JacobSchantz/HelpingHands/Two Finger Gripper/README.md

# Generalist Gripper iterations

## Key reference image for the finger design

**`cad/reference/generalist_gripper_gen6_closed.png`** is THE key reference image for the Generalist gripper finger
design (Jake, 2026-10-19). It is the "Actual (Generalist)" → "Closed" photo in the design viewer (gallery copy:
`cad/mobile_gallery/reference/closed.png`). What it shows:

- Closed, **only the tips touch**; the gap opens up rapidly right behind the tip.
- Approaching the tip on the outside, the profile **rounds inward** into the final tip.
- The tip itself stays **relatively thick** — not a needle point.

Check every finger revision against this photo first.

The current review version is [Generation 8: Pollen's Grabette, exactly as published](versions/v008_pollen_grabette/README.md).
Generation 7 (the Generalist yellow fingers only) is preserved in versions/v007_generalist_fingers.
Generation 6 (dorsal drive, Generalist honeycomb fingers) is preserved in versions/v006_dorsal_drive.
Generation 5 (mirrored geared jaws) is preserved in versions/v005_mirrored_gears.
One shared parametric jaw source updates both sides, with an explicit tooth-phase
exception for the direct gear mesh. Motor fit, retention, backdrive and force
sensing remain unfinished; this is inspection CAD.

Preserved earlier versions include [Generation 4](versions/v004_symmetric_pincher/README.md)
and [Generation 3](versions/v003_single_pincher/README.md). No earlier CAD was overwritten.
