JacobSchantz/HelpingHands/ORCA CC-BY Prototype/README.txt

ORCA CC-BY Prototype — main design base

ORCA Hand by ORCA Dexterity, Inc. — CC BY 4.0.
Original finger STL and STEP files are preserved under upstream/.
Source: https://github.com/orcahand/orcahand_hardware
Pinned commit: 37b71dc03d3f11e48b920cbf54562b33c025bc8c

This folder is CC BY 4.0, not MIT. See upstream/LICENSE.
Commercial derivatives are permitted under the license; retain attribution, license notices, and identify modifications when sharing. Patent and trademark rights are not granted.

Initial import: all base finger STLs and available matching STEP files, original README, assembly addendum and license. No geometry changes. This is a finger-first source subset, not a complete hand manufacturing package.

Use OpenSCAD for local 3D work. inspect_index.scad displays one original index component, not an assembled finger. STEP sources remain available for precise CAD editing.

MIT Hand Prototype contains the separate BiDexHand reference. Aero Derived Prototype remains the separate noncommercial Aero experiment. Do not relabel either source as MIT.

Full assembled visual reference: full_hand/view_stl.scad imports full_hand/orca_v2_assembled_visual.stl. This is the official v2 description model at zero joint pose, not a verified v2.1 manufacturing assembly or a single printable solid. See full_hand/README.txt.
