JacobSchantz/HelpingHands/Three Finger Gripper/README.txt

THREE FINGER GRIPPER — STOPPED CONCEPT

The user replaced this task with a thumb/index two-finger gripper on 2026-10-17.
This folder preserves the first geometry study; do not treat it as an active design.

versions/v001_dorsal_linkage/gripper.scad is an original, self-contained OpenSCAD
study with three independently posed dorsal parallelograms and insertion sleeves.
The three parallel lanes are a neutral mechanism fixture, not an anatomical fit.
Sleeve internal width 24 mm, height 22 mm, and 36 mm outside depth are placeholders.
Each four-bar has its own input rocker, output sleeve and link. The only shared
part is a fixed rear bridge. Cross-pins are above, rather than through, the cavity.
The model shows pin shanks only; pin retention, straps and motion stops are unfinished.

The first render revealed that the proximal finger envelope hit a rear rocker.
Increasing ground length from 32 to 52 mm removed intersections in the displayed
[-6,-26,-42] degree pose. OpenSCAD's part="collision" returned an empty result
for that pose only. No continuous motion sweep, fit, load, or print validation was
completed before the user changed the task. No hardware was operated.

The assembly STL is a geometry preview containing multiple parts, not a print plate.
No fit, strength, comfort, functioning mechanism, or print readiness is claimed.
