JacobSchantz/HelpingHands/references/generalist/README.txt

Visual references downloaded 2026-10-17 from https://generalistai.com/
Original website video poster frames, Generalist AI. Reference imagery only; no CAD or open-source license claimed.
https://generalistai.com/assets/videos/index-hero/generalist_website_screwhand_1.jpg
https://generalistai.com/assets/videos/index-hero/generalist_website_ziptie_1.jpg
https://generalistai.com/assets/videos/index-hero/generalist_website_whiskhand_1.jpg

KEY REFERENCE for the gripper finger design: cad/reference/generalist_gripper_gen6_closed.png
(design viewer: Actual (Generalist) -> Closed). Closed, only the tips touch and the gap opens
rapidly behind the tip; the outside profile rounds inward into the tip; the tip stays relatively thick.
