JacobSchantz/HelpingHands/ORCA CC-BY Prototype/versions/v002_clean_index/README.txt

v002 — Clean intact index finger
Original scale, neutral assembly, uniform color, no subtraction or detached carve fragments. Original mesh geometry unchanged. Includes3 printed parts; excludes pins, bearings, tendons and skin. This is a reference view, not a validated wearable design.
Source: https://github.com/orcahand/orcahand_hardware/tree/37b71dc03d3f11e48b920cbf54562b33c025bc8c
ORCA Hand by ORCA Dexterity, Inc. — CC BY4.0. See LICENSE.
