JacobSchantz/HelpingHands/Two Finger Gripper/versions/v001_motor_force_layout/README.txt

SUPERSEDED BEFORE CAD IMPLEMENTATION

The earlier rotating thumb/index concept was superseded by the user's request
for TWO independent parallel-jaw grippers: two servos, four moving jaw elements.
See v002_two_parallel_modules. No hardware was operated.
