JacobSchantz/HelpingHands/Two Finger Gripper/versions/v004_symmetric_pincher/README.md

# Generalist Gripper · Generation 4

A simpler, centered thumb/index pincher: one opposing pair of mirrored jaws,
one centered servo envelope, one sliding yoke and one crank. Generation 3 is
preserved in `../v003_single_pincher`; no earlier version is replaced.

This is original inspection CAD, not a print-ready or hardware-tested wearable.
No motor or other hardware was operated. The motor, horn, bearings, fasteners,
materials and human fit remain unselected.

## Changes requested for this generation

- Six main displayed bodies instead of Generation 3's twelve: fixed hub, two
  jaws, yoke, crank and ONE servo envelope. Required small hardware is still
  unfinished; six is not a complete assembly bill of materials.
- Identical mirrored jaws and centered fixed hub, yoke and motor volume.
- Continuous curved inner object-contact faces, without a separate black pad,
  sensor block or lightening holes in the contact surface.
- Longitudinal concave channels on the OUTER, human-facing sides, running from
  near the tips toward the pivots. These differ from the inner object-gripping
  faces. They are open channels, not hard finger rings.
- Two radiused zip-tie anchor slots per jaw, through the Y sidewalls near the
  outer spine. The slots do not break the inner gripping face. No purple straps,
  ties, finger cuffs or force sensor are rendered.

The compact opposing-finger silhouette is informed by official Generalist
reference frames already saved in `references/generalist/` in the project root:
`human_jar_01.png`, `human_brush_01.png`, `screwhand_1.jpg` and `ziptie_1.jpg`.
The [official human jar demonstration](https://generalistai.com/assets/pages/blog/gen-1.5/assets/videos/top_down_human_jar.mp4)
shows human operation. The box-folding footage is robot-mounted and is not
human-attachment evidence. The transmission and dimensions here are our own
proposal; the footage does not establish Generalist's hidden mechanism or fit.

## Centered drive and real symmetric motion

The servo output axis is on X=0, Z=-30, pointing along Y. An eccentric crank pin
moves in the yoke's horizontal slot. The hub's open-front L guides constrain the
yoke to vertical translation. Two mirrored angled slots in the yoke engage rear
followers integral with the jaws. The jaws pivot on X=+/-16 and counter-rotate
by equal angles. There are no jaw gears, extra links or second motor.

For jaw opening angle `a` (degrees), 0–22:

```
right follower X = 16 - 10*cos(a) - 10*sin(a)
right follower Z = 10*sin(a) - 10*cos(a)
yoke translation t = 2 + 20*sin(a)
right slot: Z - t = X - 18
left slot:  Z - t = -X - 18
crank angle phi = asin((t - 5.746065934)/6)
```

The crank runs about -38.63 to +38.63 degrees, away from its +/-90 degree
vertical-motion dead centers. Both follower slot and crank slot ends retain
clearance throughout the sampled interval. One crank input sets the yoke and
both jaw angles; they are not independently actuated.
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
