JacobSchantz/HelpingHands/cad/blender/out/so101_gripper.png

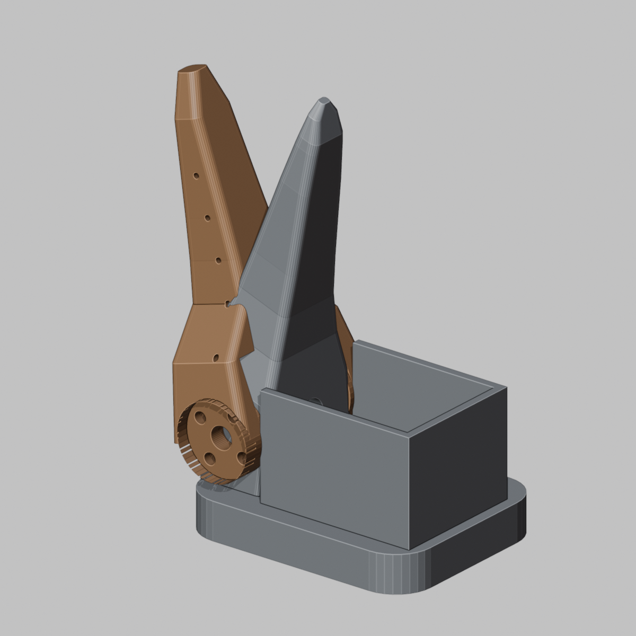
cad/blender/out/so101_gripper.png
