JacobSchantz/HelpingHands/cad/blender/out/so101_gripper_side.png

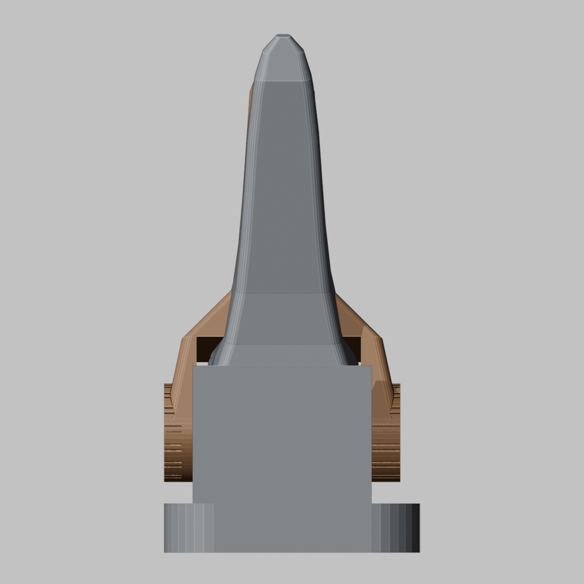
cad/blender/out/so101_gripper_side.png
