JacobSchantz/HelpingHands/cad/glove_hand/refs/jake_left_hand_spread_top.jpg

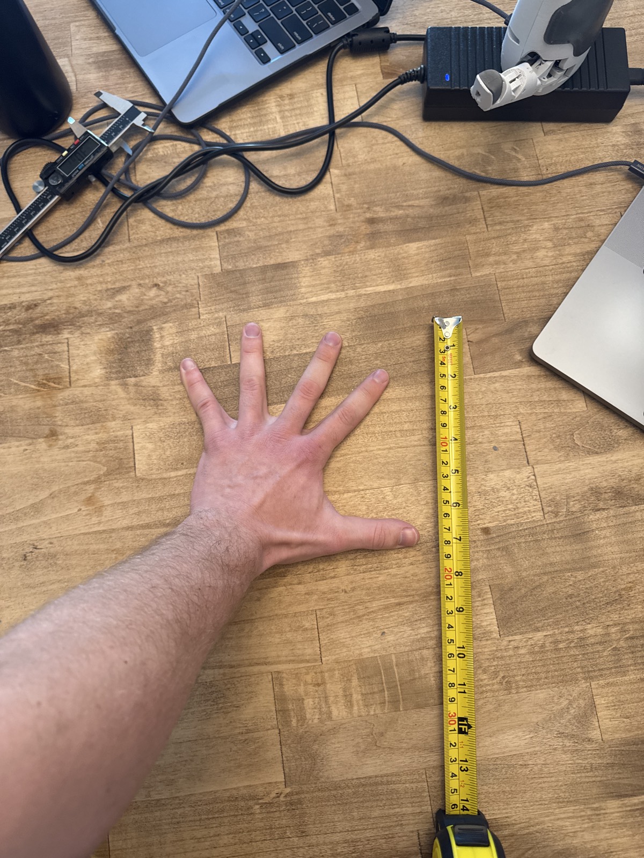
cad/glove_hand/refs/jake_left_hand_spread_top.jpg
