JacobSchantz/HelpingHands/cad/mobile_gallery/micro_grippers/hardware.png

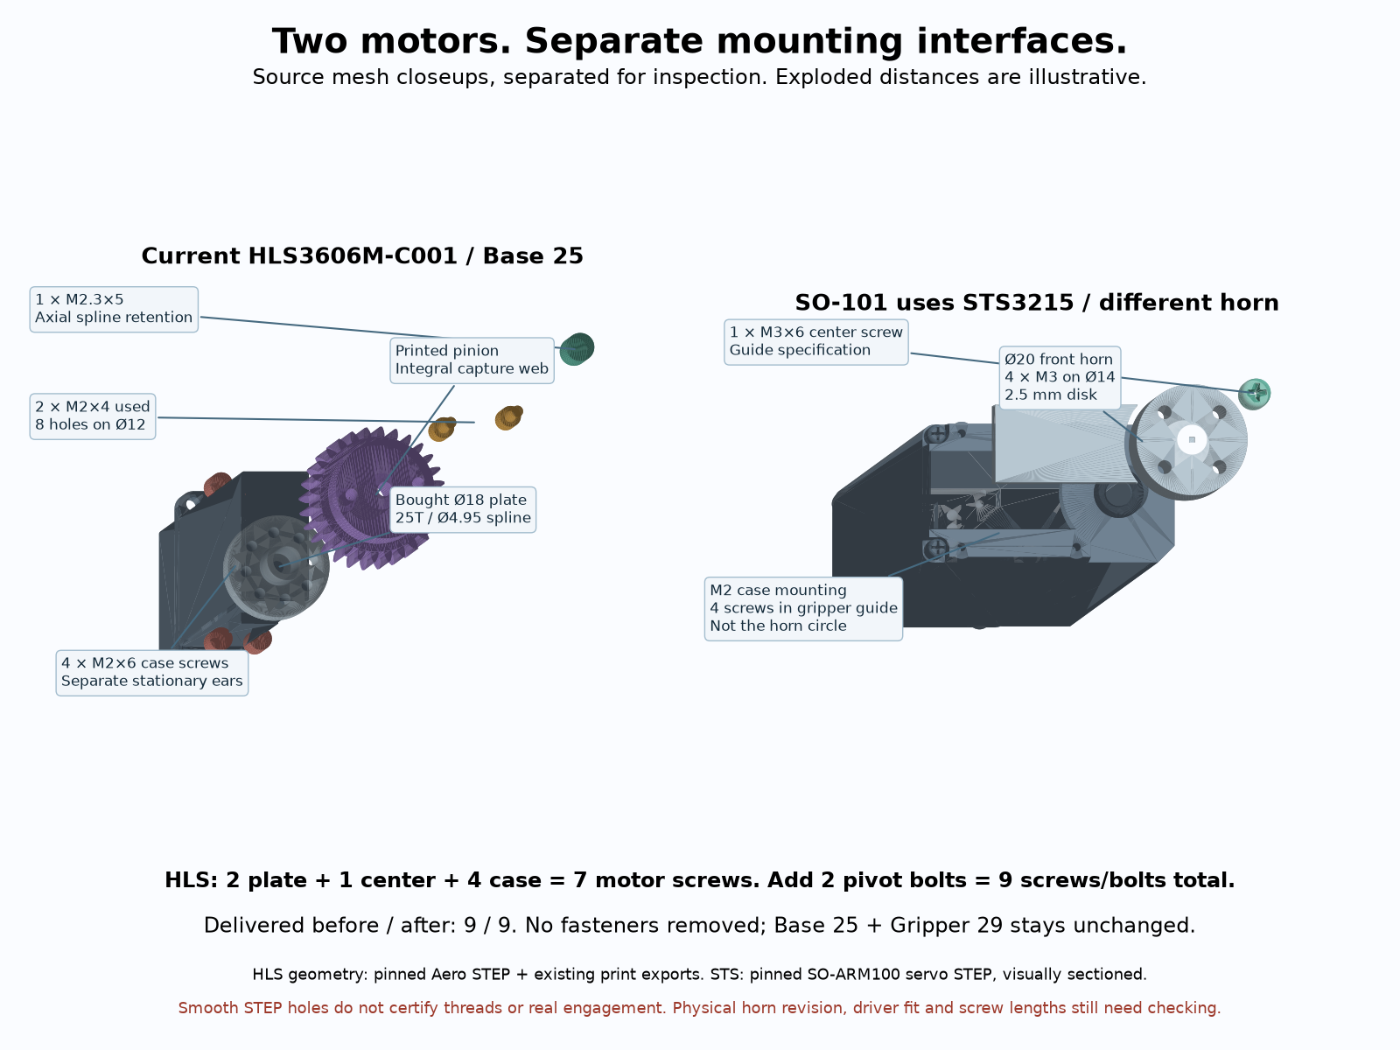
cad/mobile_gallery/micro_grippers/hardware.png
