JacobSchantz/HelpingHands/cad/mobile_gallery/reference/actual_top.png

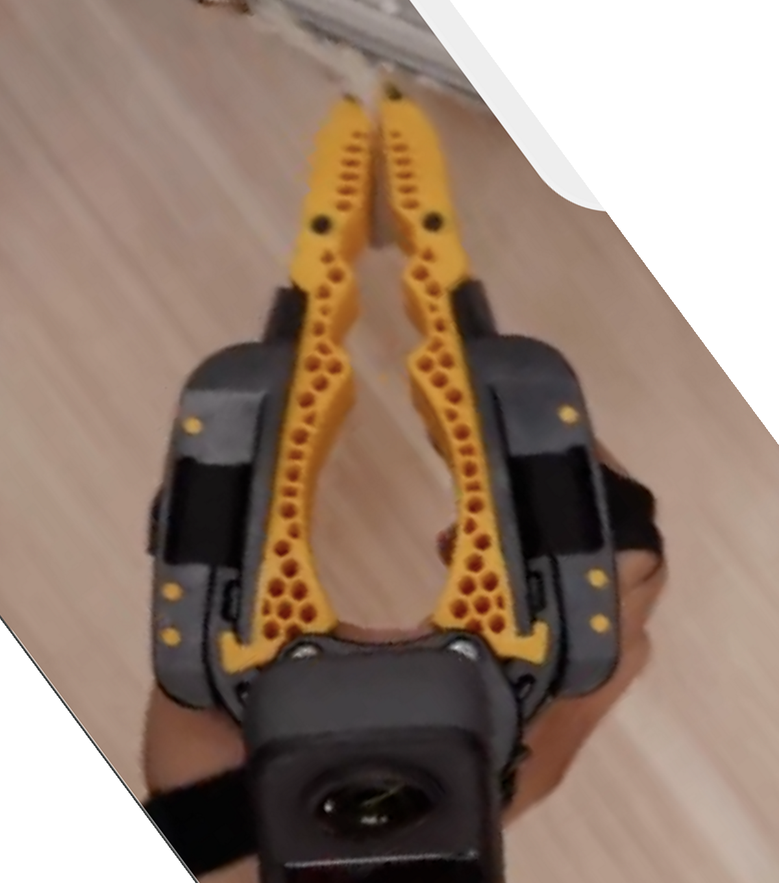
cad/mobile_gallery/reference/actual_top.png
