JacobSchantz/HelpingHands/cad/mobile_gallery/reference/cup.png

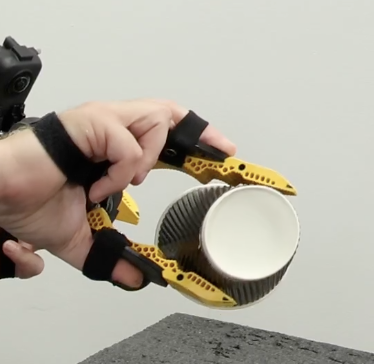
cad/mobile_gallery/reference/cup.png
