JacobSchantz/HelpingHands/cad/mobile_gallery/reference/robot.png

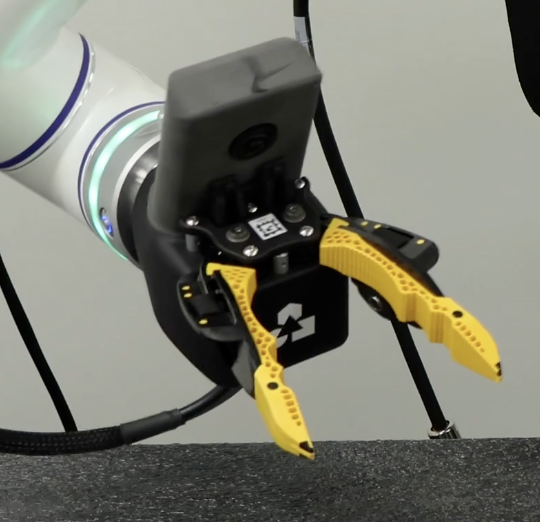
cad/mobile_gallery/reference/robot.png
