JacobSchantz/HelpingHands/cad/mobile_gallery/reference/top.png

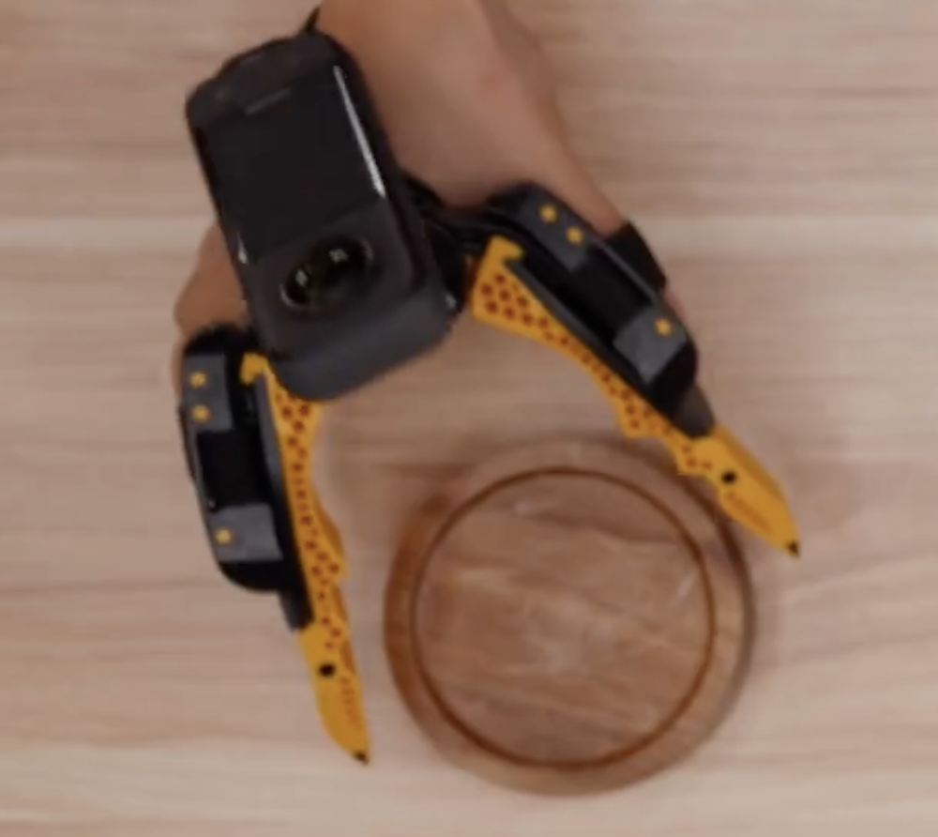
cad/mobile_gallery/reference/top.png
