JacobSchantz/HelpingHands/cad/openscad/crow/render/armed_iso.png

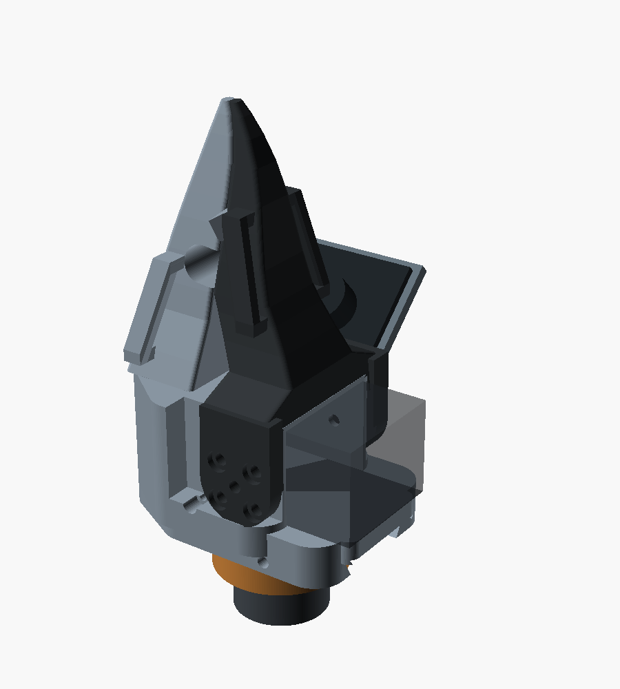
cad/openscad/crow/render/armed_iso.png
