JacobSchantz/HelpingHands/cad/openscad/crow/render/beak_closed_side.png

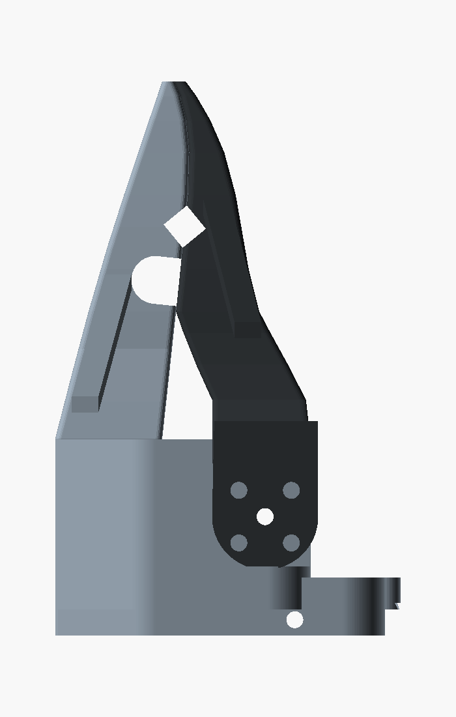
cad/openscad/crow/render/beak_closed_side.png
