JacobSchantz/HelpingHands/cad/openscad/crow/render/beak_iso.png

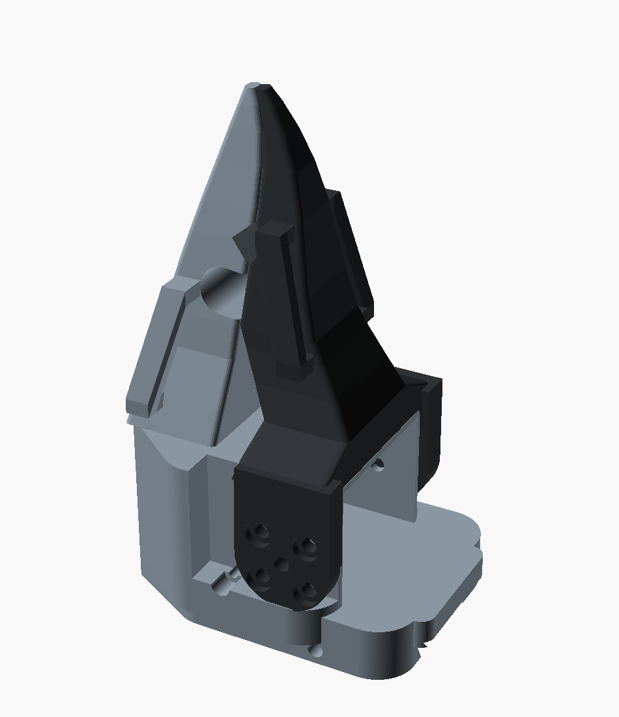
cad/openscad/crow/render/beak_iso.png
