JacobSchantz/HelpingHands/cad/openscad/crow/render/beak_open_side.png

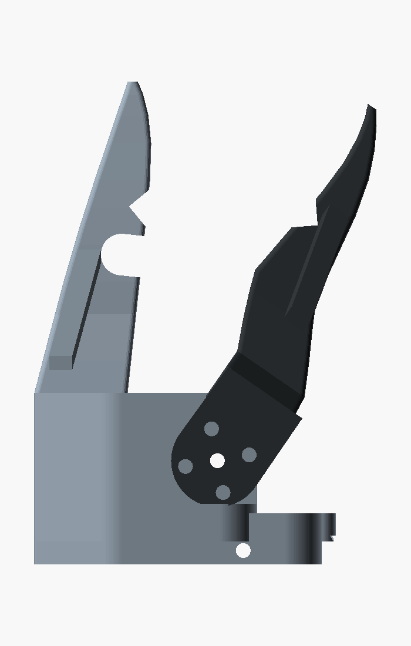
cad/openscad/crow/render/beak_open_side.png
