JacobSchantz/HelpingHands/cad/openscad/crow/render/handheld_iso.png

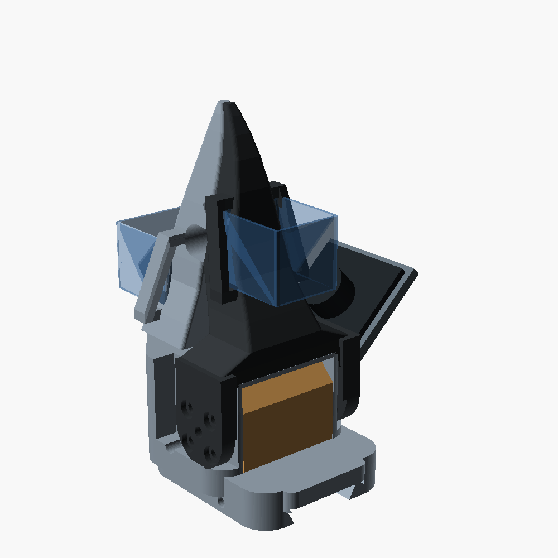
cad/openscad/crow/render/handheld_iso.png
