JacobSchantz/HelpingHands/cad/openscad/crow/render/handheld_side.png

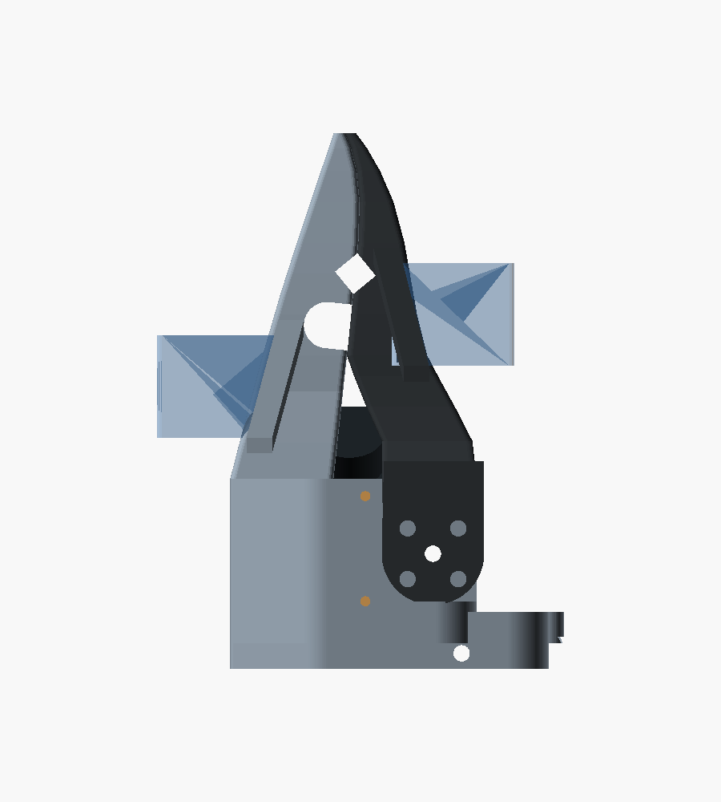
cad/openscad/crow/render/handheld_side.png
