JacobSchantz/HelpingHands/cad/openscad/crow/render/lower.png

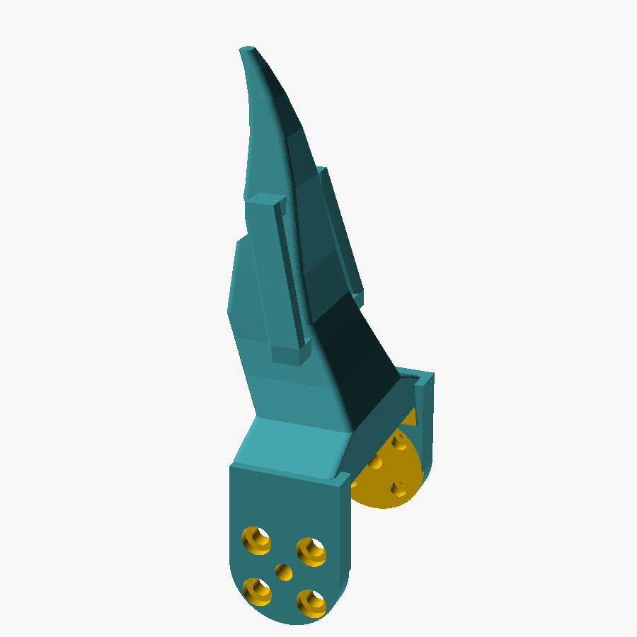
cad/openscad/crow/render/lower.png
