JacobSchantz/HelpingHands/cad/openscad/crow/render/throat_open.png

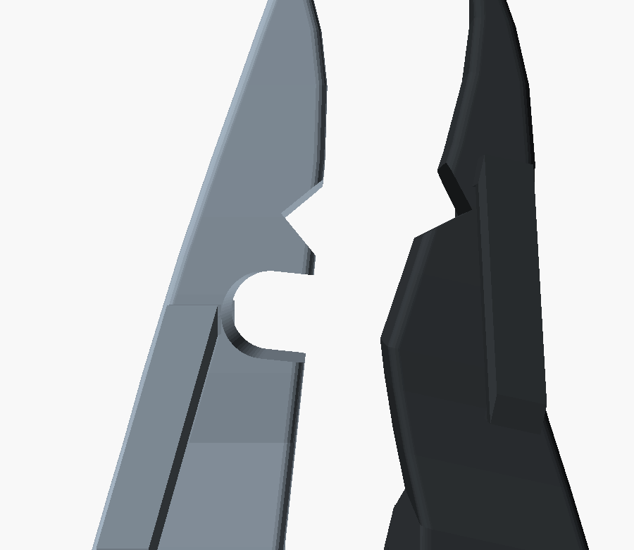
cad/openscad/crow/render/throat_open.png
