JacobSchantz/HelpingHands/cad/openscad/crow/render/thumb_side.png

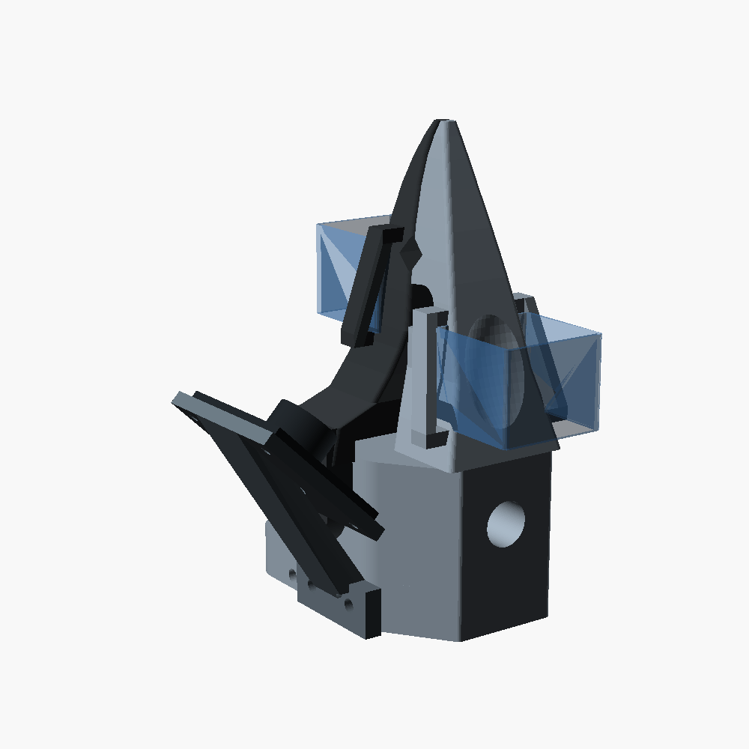
cad/openscad/crow/render/thumb_side.png
