JacobSchantz/HelpingHands/cad/openscad/crow/render/tip_and_notch.png

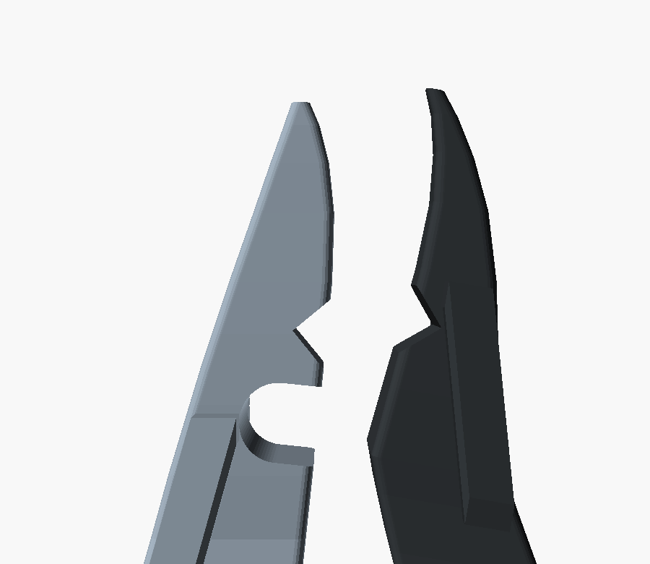
cad/openscad/crow/render/tip_and_notch.png
