JacobSchantz/HelpingHands/cad/openscad/crow/render/tool_in_notch.png

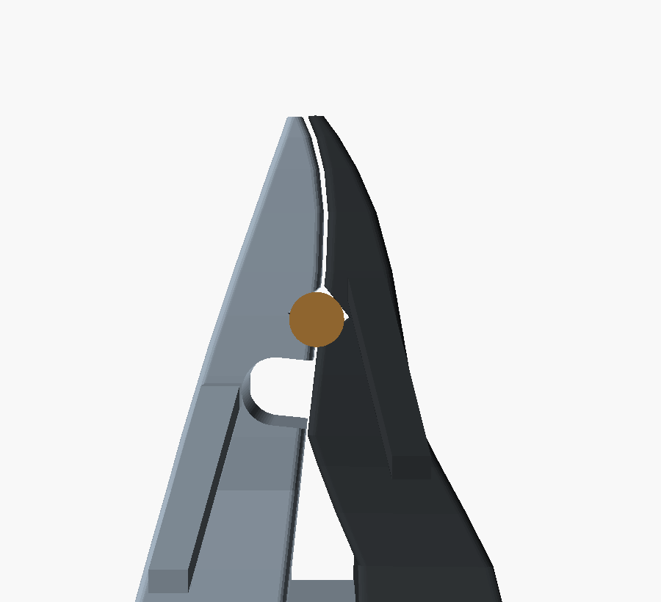
cad/openscad/crow/render/tool_in_notch.png
