JacobSchantz/HelpingHands/cad/openscad/crow/render/upper.png

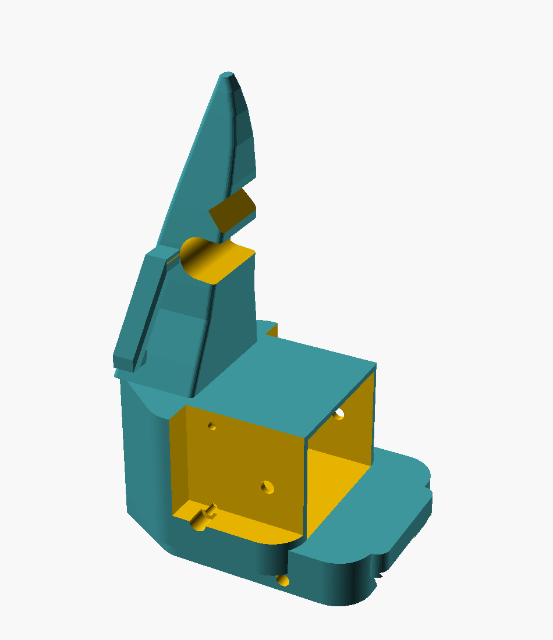
cad/openscad/crow/render/upper.png
