JacobSchantz/HelpingHands/cad/openscad/demo_gripper/render/compare_gen_00.png

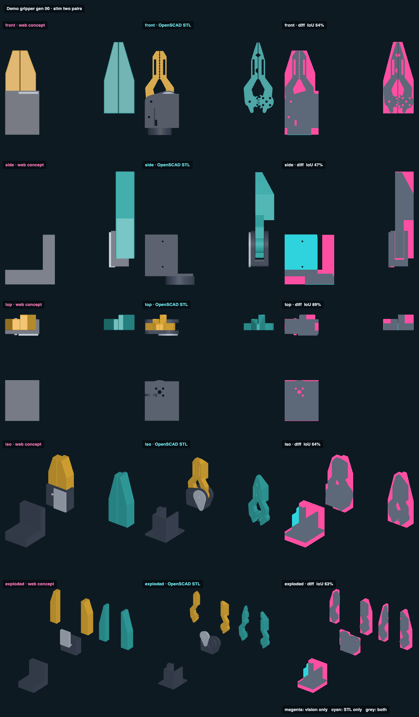
cad/openscad/demo_gripper/render/compare_gen_00.png
