JacobSchantz/HelpingHands/cad/openscad/demo_gripper/render/compare_gen_01.png

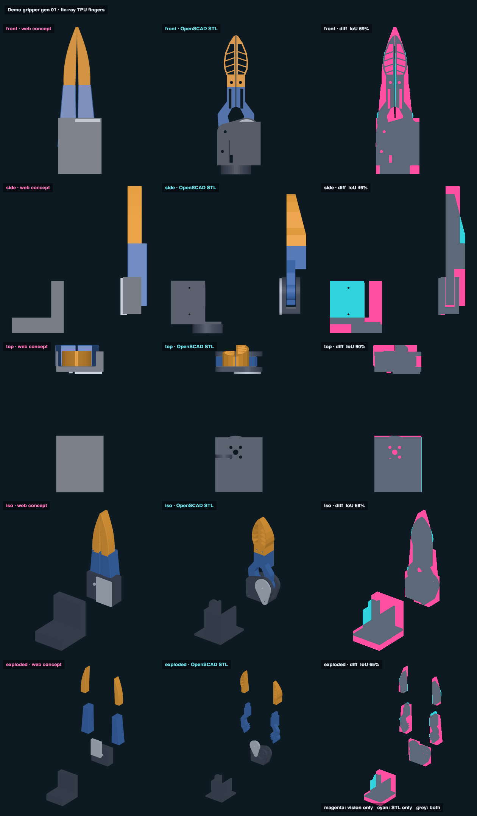
cad/openscad/demo_gripper/render/compare_gen_01.png
