JacobSchantz/HelpingHands/cad/openscad/demo_gripper/render/crow_in_hand.png

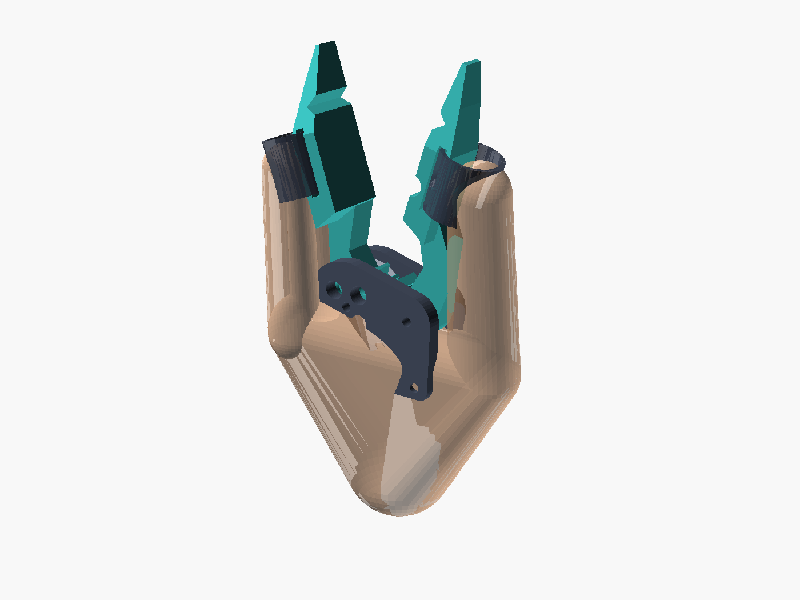
cad/openscad/demo_gripper/render/crow_in_hand.png
