JacobSchantz/HelpingHands/cad/openscad/demo_gripper/render/crow_on_arm.png

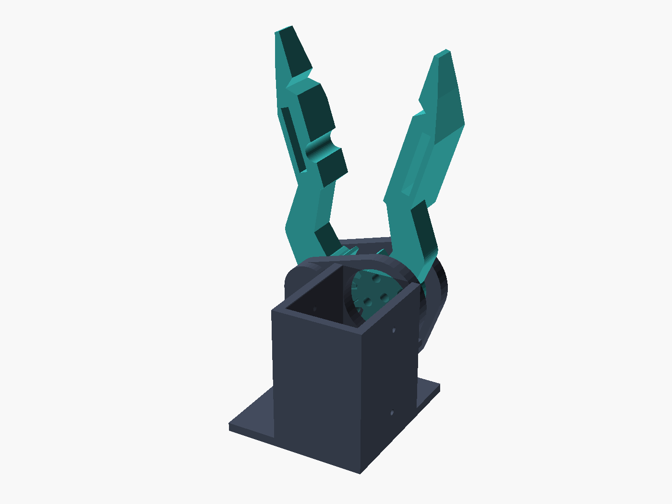
cad/openscad/demo_gripper/render/crow_on_arm.png
