JacobSchantz/HelpingHands/cad/openscad/demo_gripper/render/exploded.png

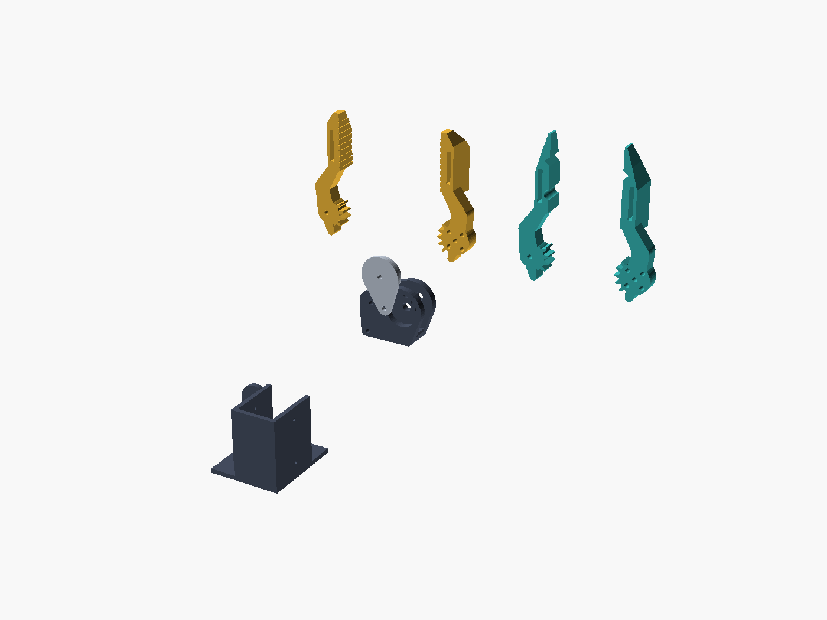
cad/openscad/demo_gripper/render/exploded.png
