JacobSchantz/HelpingHands/cad/openscad/demo_gripper/render/gen_01_exploded.png

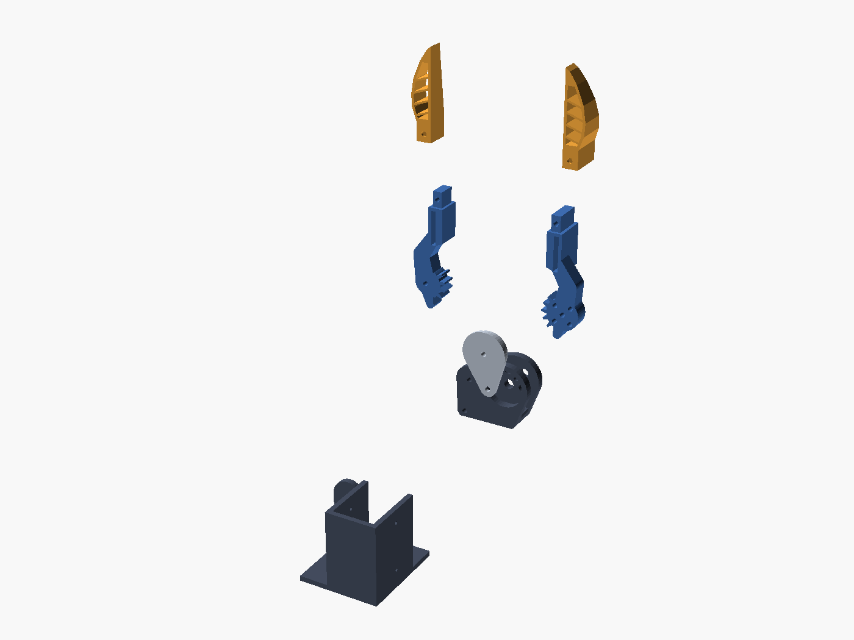
cad/openscad/demo_gripper/render/gen_01_exploded.png
