JacobSchantz/HelpingHands/cad/openscad/demo_gripper/render/gen_01_on_arm.png

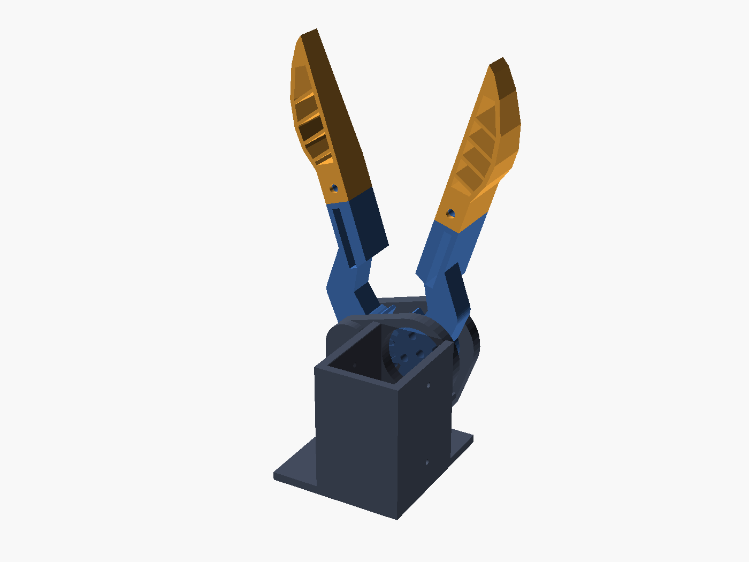
cad/openscad/demo_gripper/render/gen_01_on_arm.png
