JacobSchantz/HelpingHands/cad/openscad/demo_gripper/render/generations.png

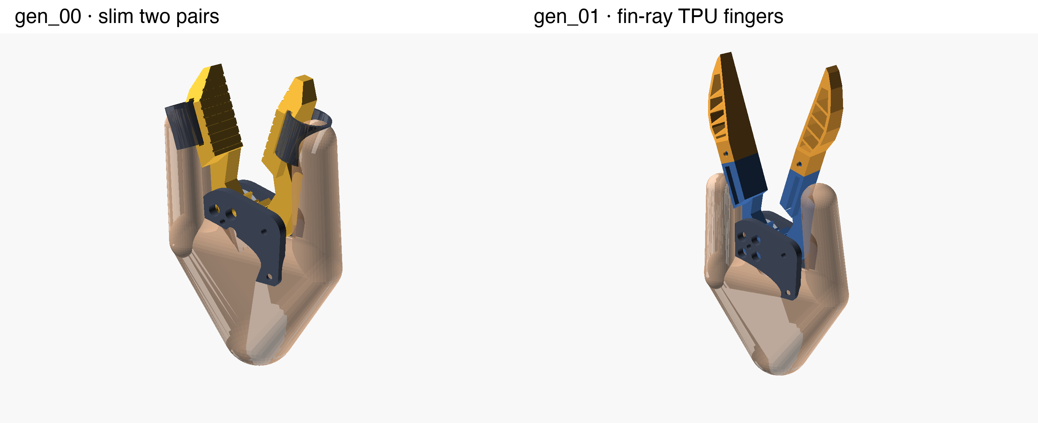
cad/openscad/demo_gripper/render/generations.png
