JacobSchantz/HelpingHands/cad/openscad/glove_hand/fit_check.png

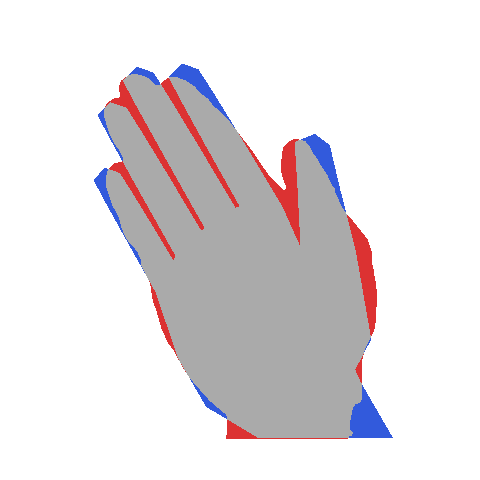
cad/openscad/glove_hand/fit_check.png
