JacobSchantz/HelpingHands/cad/openscad/glove_hand/render/compare_gen_00.png

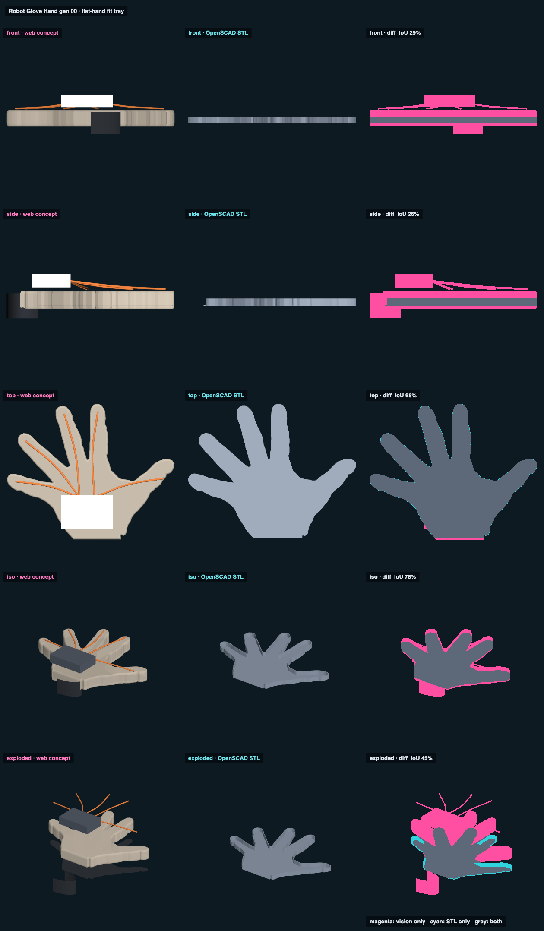
cad/openscad/glove_hand/render/compare_gen_00.png
