JacobSchantz/HelpingHands/cad/openscad/glove_hand/render/compare_gen_01.png

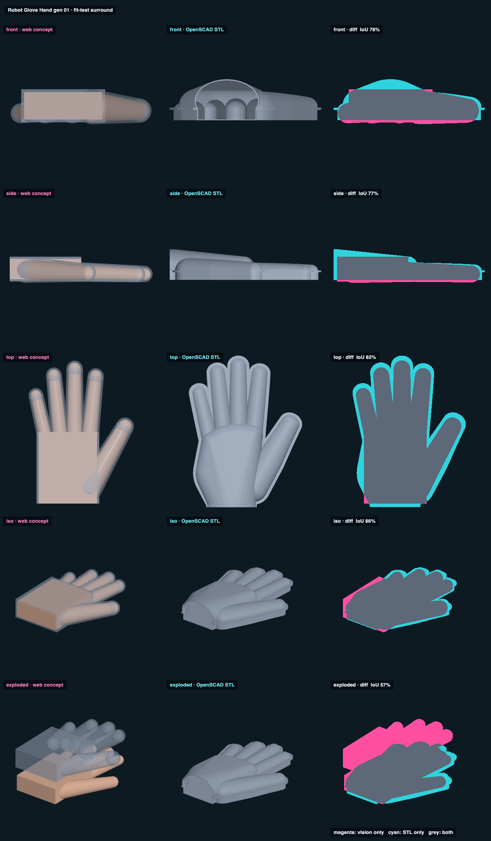
cad/openscad/glove_hand/render/compare_gen_01.png
