JacobSchantz/HelpingHands/cad/openscad/glove_hand/render/compare_gen_02.png

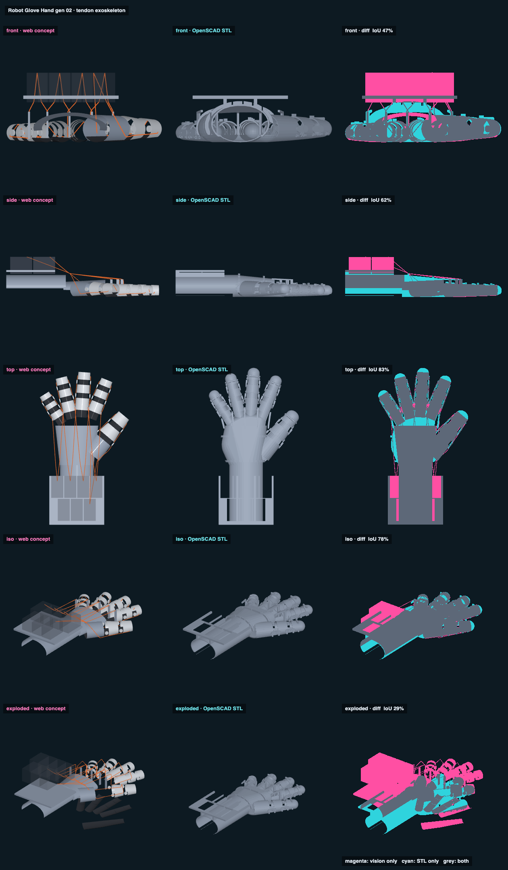
cad/openscad/glove_hand/render/compare_gen_02.png
