JacobSchantz/HelpingHands/cad/openscad/glove_hand/render/compare_gen_03.png

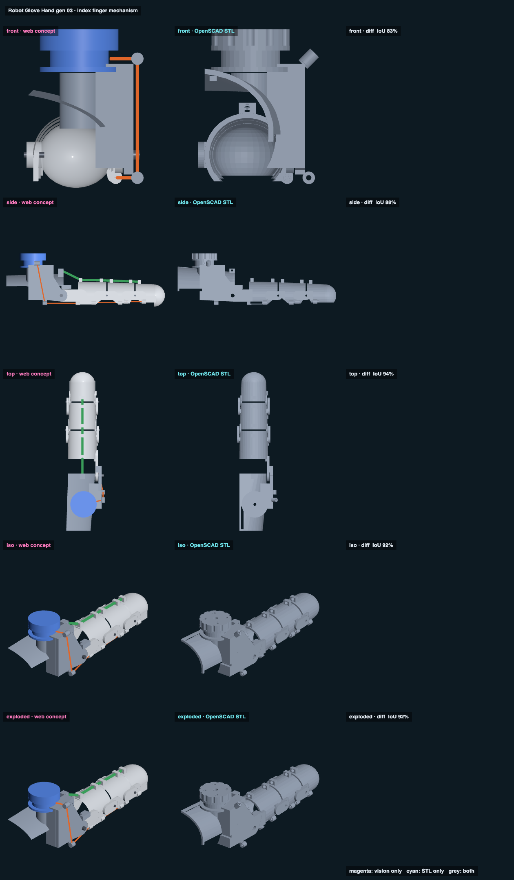
cad/openscad/glove_hand/render/compare_gen_03.png
