JacobSchantz/HelpingHands/cad/openscad/glove_hand/render/compare_gen_04.png

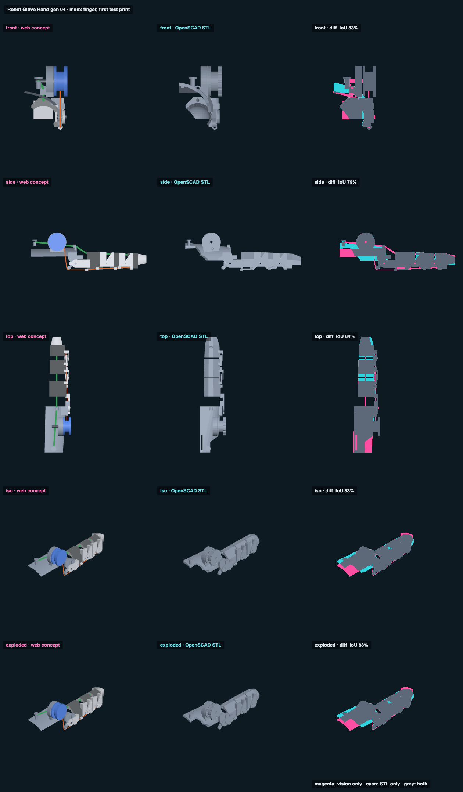
cad/openscad/glove_hand/render/compare_gen_04.png
