JacobSchantz/HelpingHands/cad/openscad/glove_hand/render/gen_00_fit_tray.png

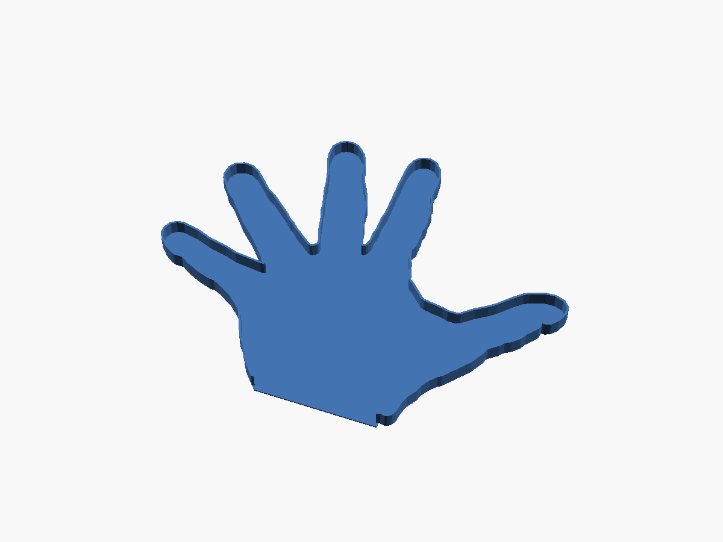
cad/openscad/glove_hand/render/gen_00_fit_tray.png
