JacobSchantz/HelpingHands/cad/openscad/glove_hand/render/gen_01_fit_surround.png

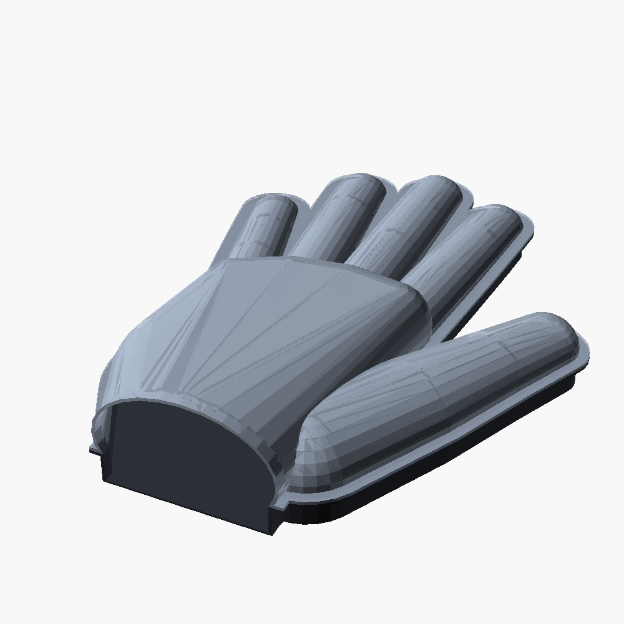
cad/openscad/glove_hand/render/gen_01_fit_surround.png
