JacobSchantz/HelpingHands/cad/openscad/glove_hand/render/gen_02_curl.png

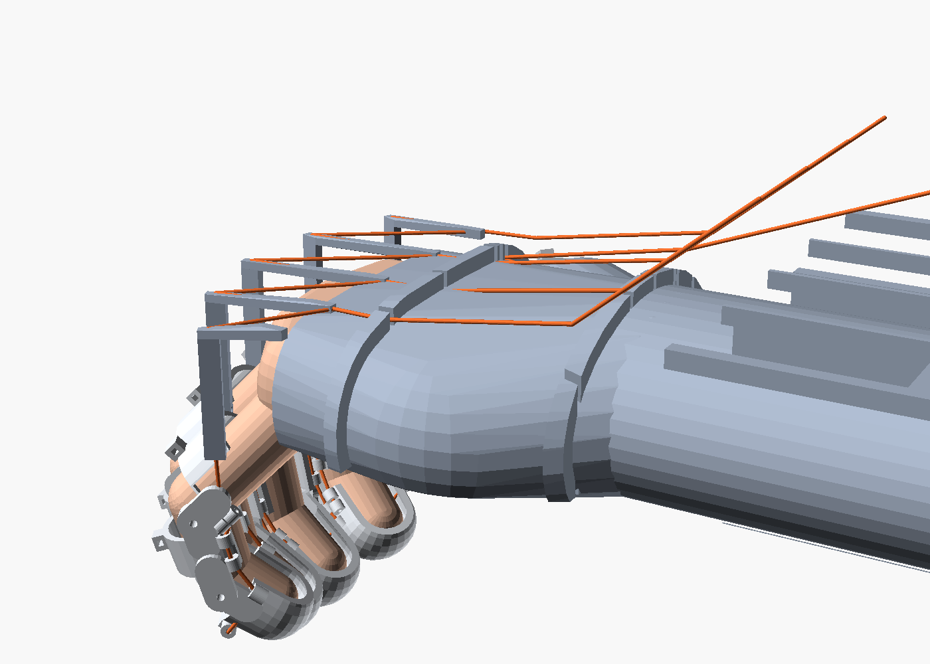
cad/openscad/glove_hand/render/gen_02_curl.png
