JacobSchantz/HelpingHands/cad/openscad/glove_hand/render/gen_02_tendon_exo.png

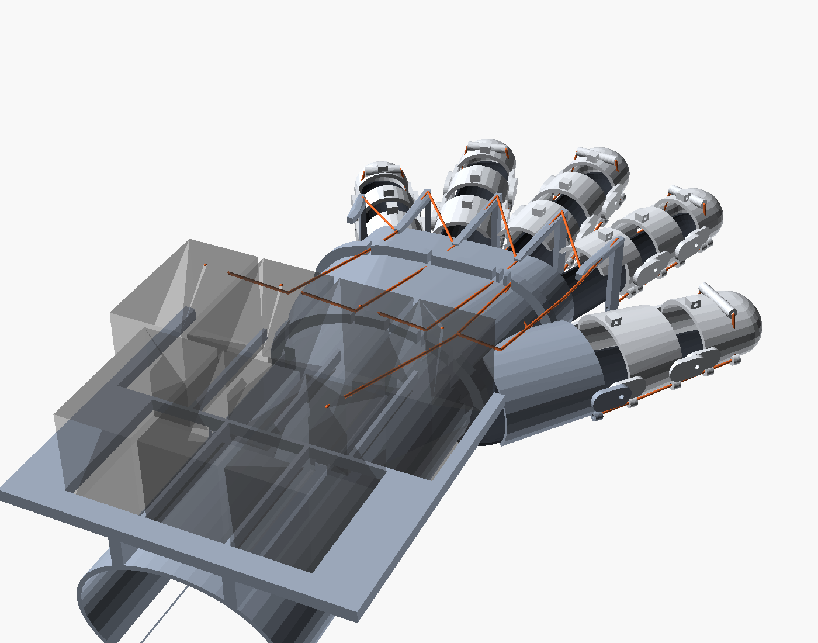
cad/openscad/glove_hand/render/gen_02_tendon_exo.png
