JacobSchantz/HelpingHands/cad/openscad/glove_hand/render/gen_03_index_finger.png

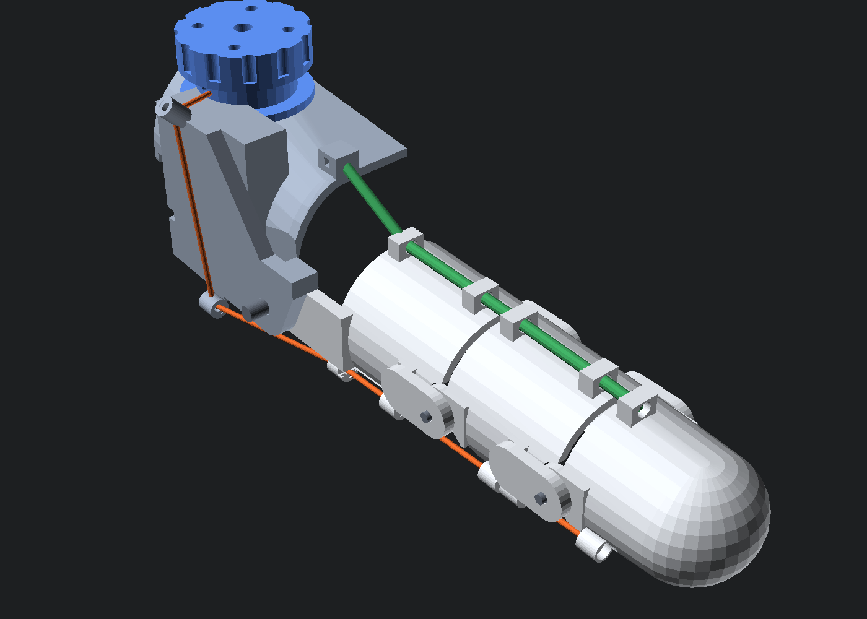
cad/openscad/glove_hand/render/gen_03_index_finger.png
