JacobSchantz/HelpingHands/cad/openscad/glove_hand/render/gen_03_live_robot.png

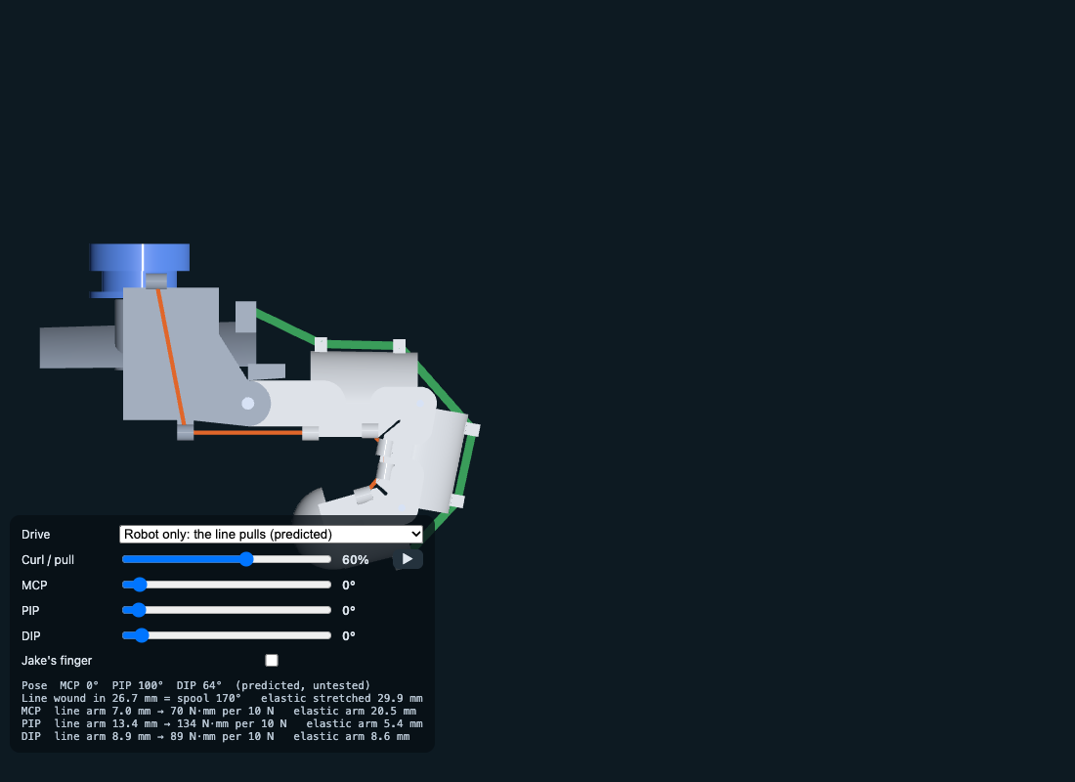
cad/openscad/glove_hand/render/gen_03_live_robot.png
