JacobSchantz/HelpingHands/cad/openscad/glove_hand/render/gen_03_poses.png

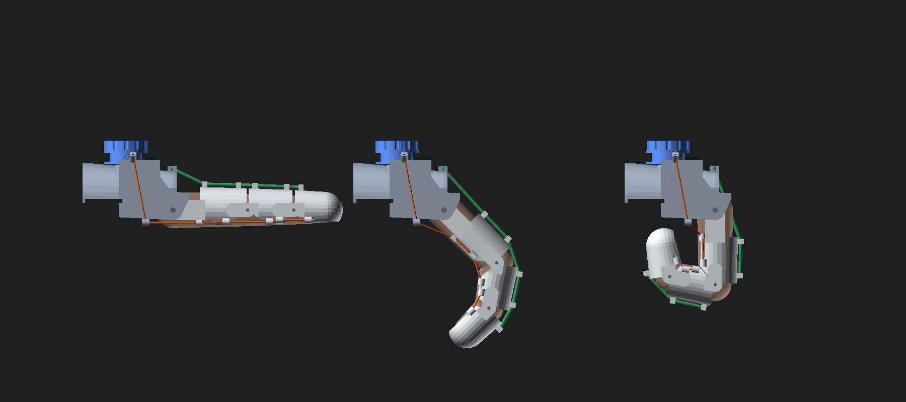
cad/openscad/glove_hand/render/gen_03_poses.png
