JacobSchantz/HelpingHands/cad/openscad/glove_hand/render/gen_04_poses.png

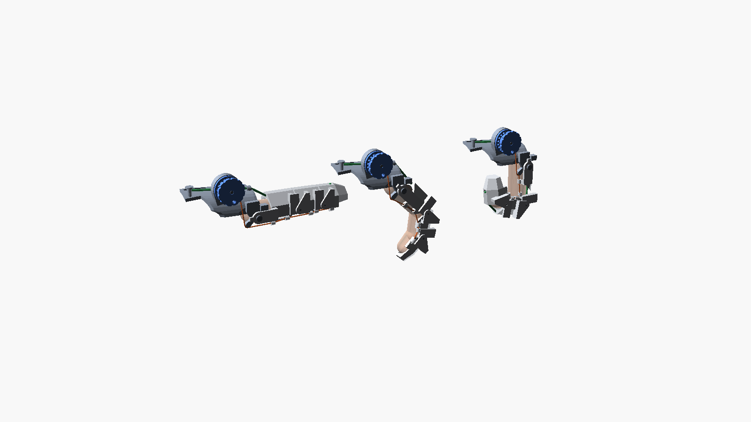
cad/openscad/glove_hand/render/gen_04_poses.png
