JacobSchantz/HelpingHands/cad/openscad/hand_gripper/render/camera_side_closed.png

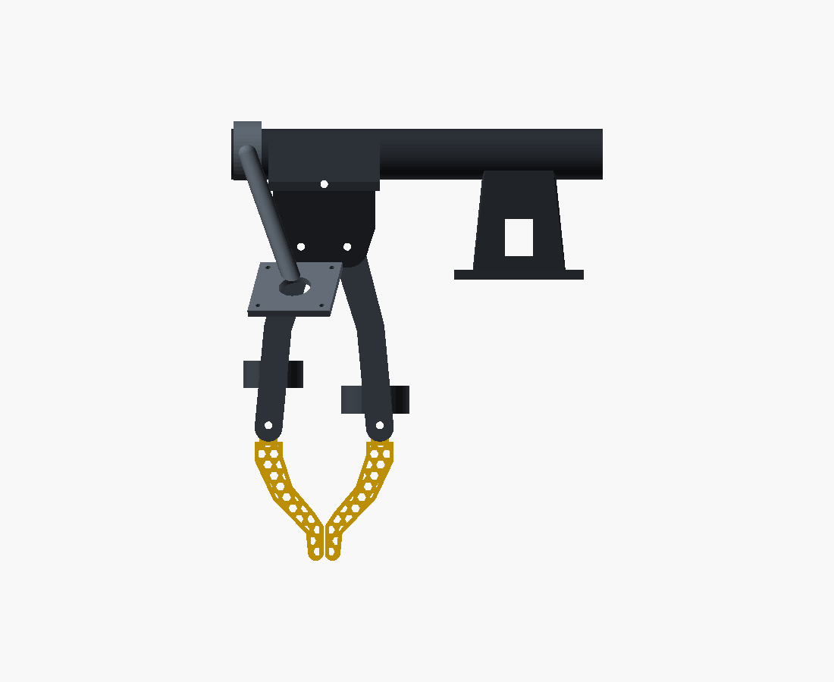
cad/openscad/hand_gripper/render/camera_side_closed.png
