JacobSchantz/HelpingHands/cad/openscad/hand_gripper/render/closed_side.png

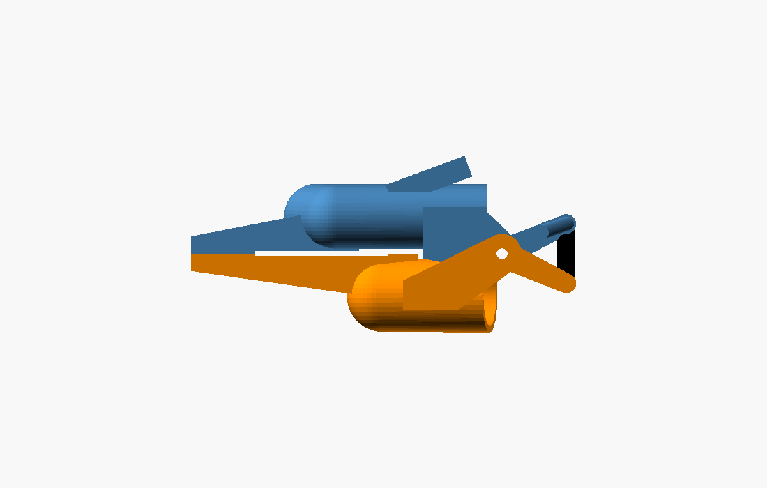
cad/openscad/hand_gripper/render/closed_side.png
