JacobSchantz/HelpingHands/cad/openscad/hand_gripper/render/exploded.png

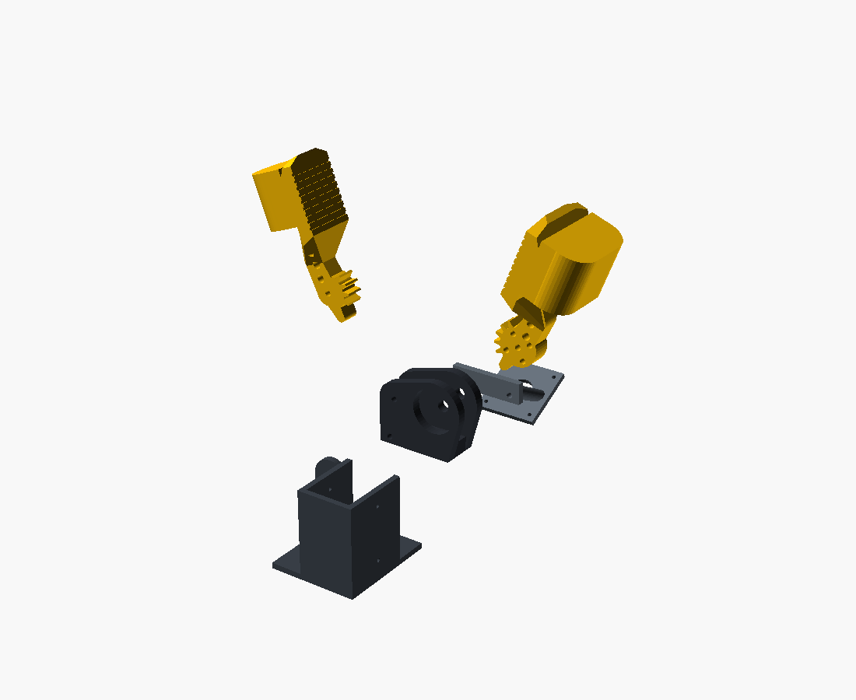
cad/openscad/hand_gripper/render/exploded.png
