JacobSchantz/HelpingHands/cad/openscad/hand_gripper/render/finger_slot_rear.png

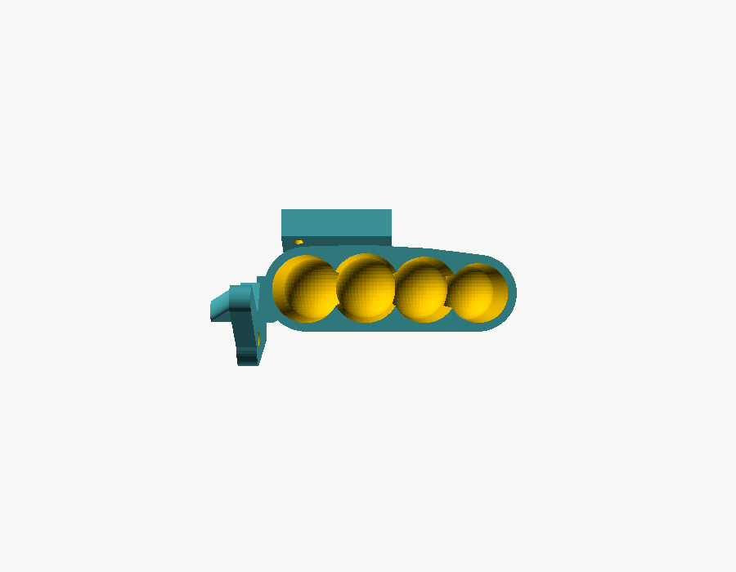
cad/openscad/hand_gripper/render/finger_slot_rear.png
