JacobSchantz/HelpingHands/cad/openscad/hand_gripper/render/from_below.png

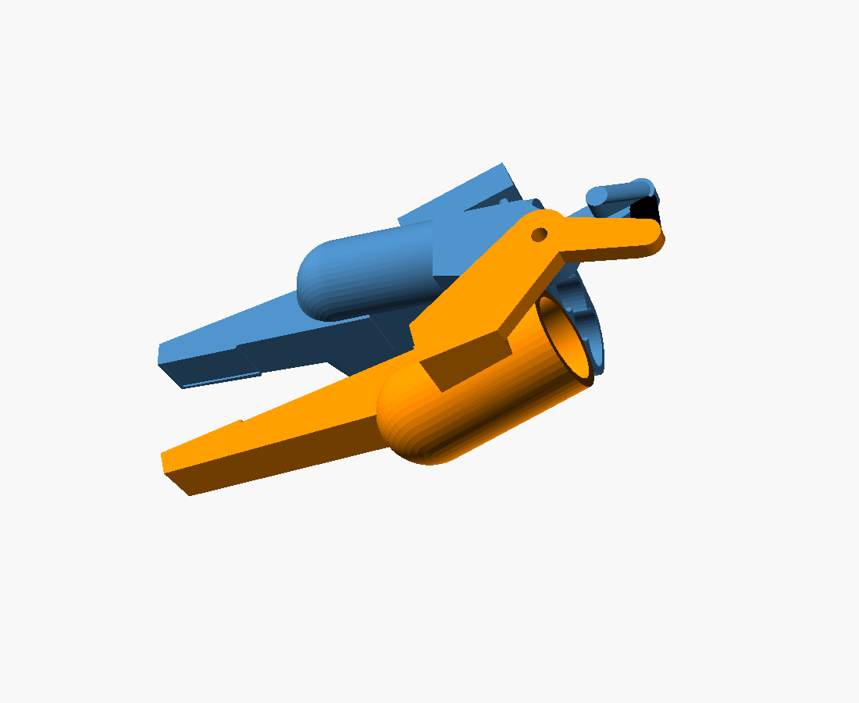
cad/openscad/hand_gripper/render/from_below.png
