JacobSchantz/HelpingHands/cad/openscad/hand_gripper/render/in_hand.png

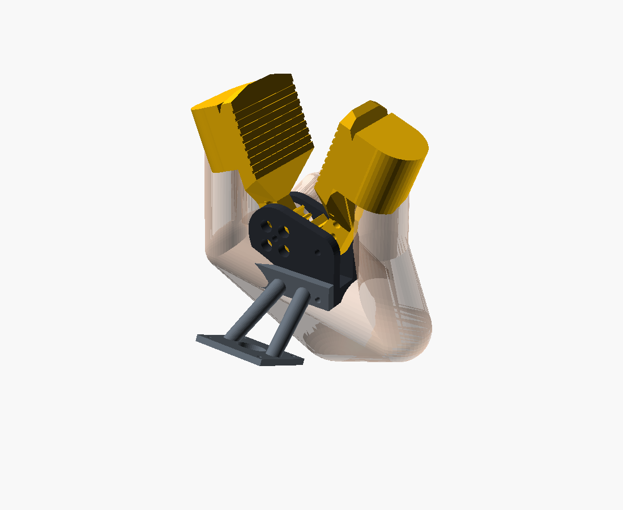
cad/openscad/hand_gripper/render/in_hand.png
