JacobSchantz/HelpingHands/cad/openscad/hand_gripper/render/in_hand_pinky_side.png

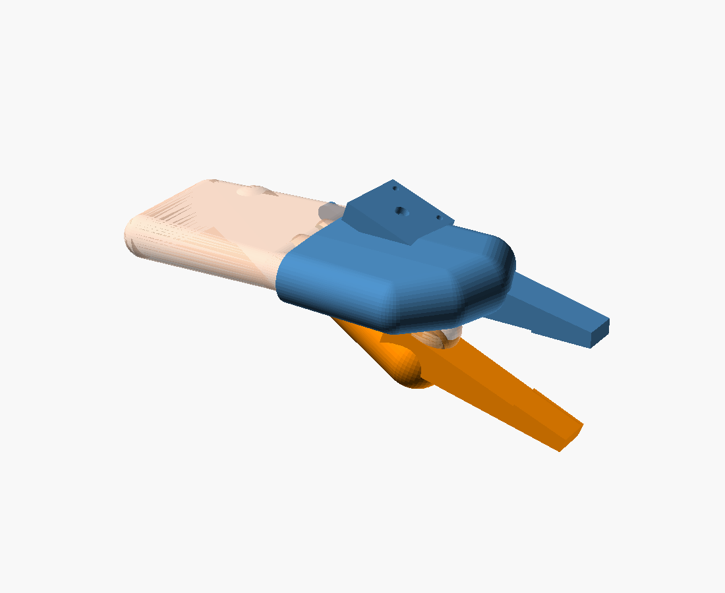
cad/openscad/hand_gripper/render/in_hand_pinky_side.png
