JacobSchantz/HelpingHands/cad/openscad/hand_gripper/render/in_hand_thumb_side.png

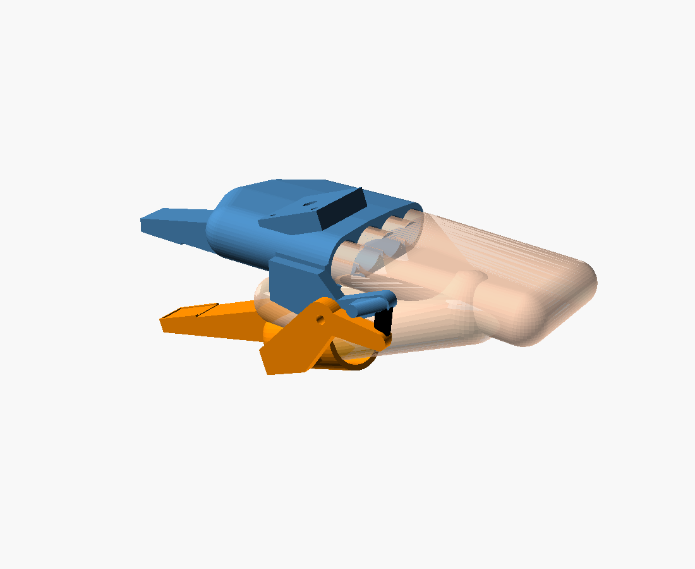
cad/openscad/hand_gripper/render/in_hand_thumb_side.png
