JacobSchantz/HelpingHands/cad/openscad/hand_gripper/render/on_arm.png

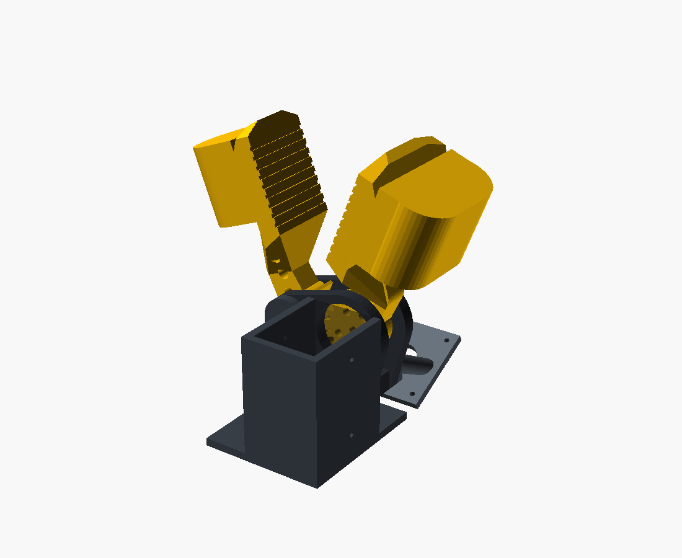
cad/openscad/hand_gripper/render/on_arm.png
