JacobSchantz/HelpingHands/cad/openscad/hand_gripper/render/pinch_closed.png

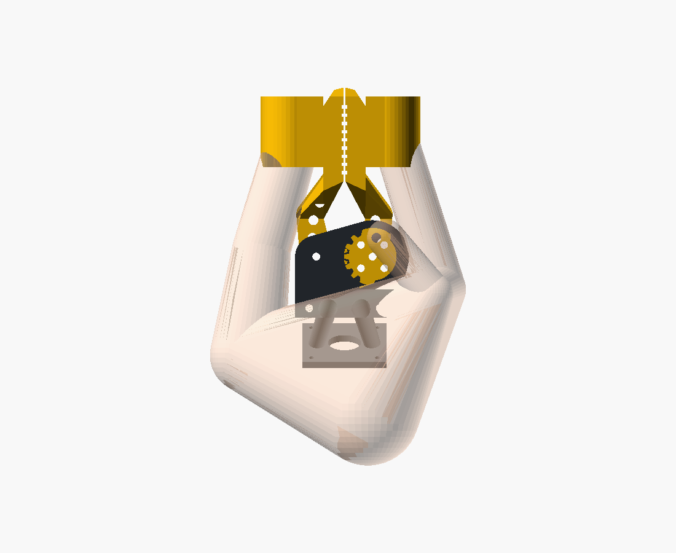
cad/openscad/hand_gripper/render/pinch_closed.png
