JacobSchantz/HelpingHands/cad/openscad/render/fidelity_check.png

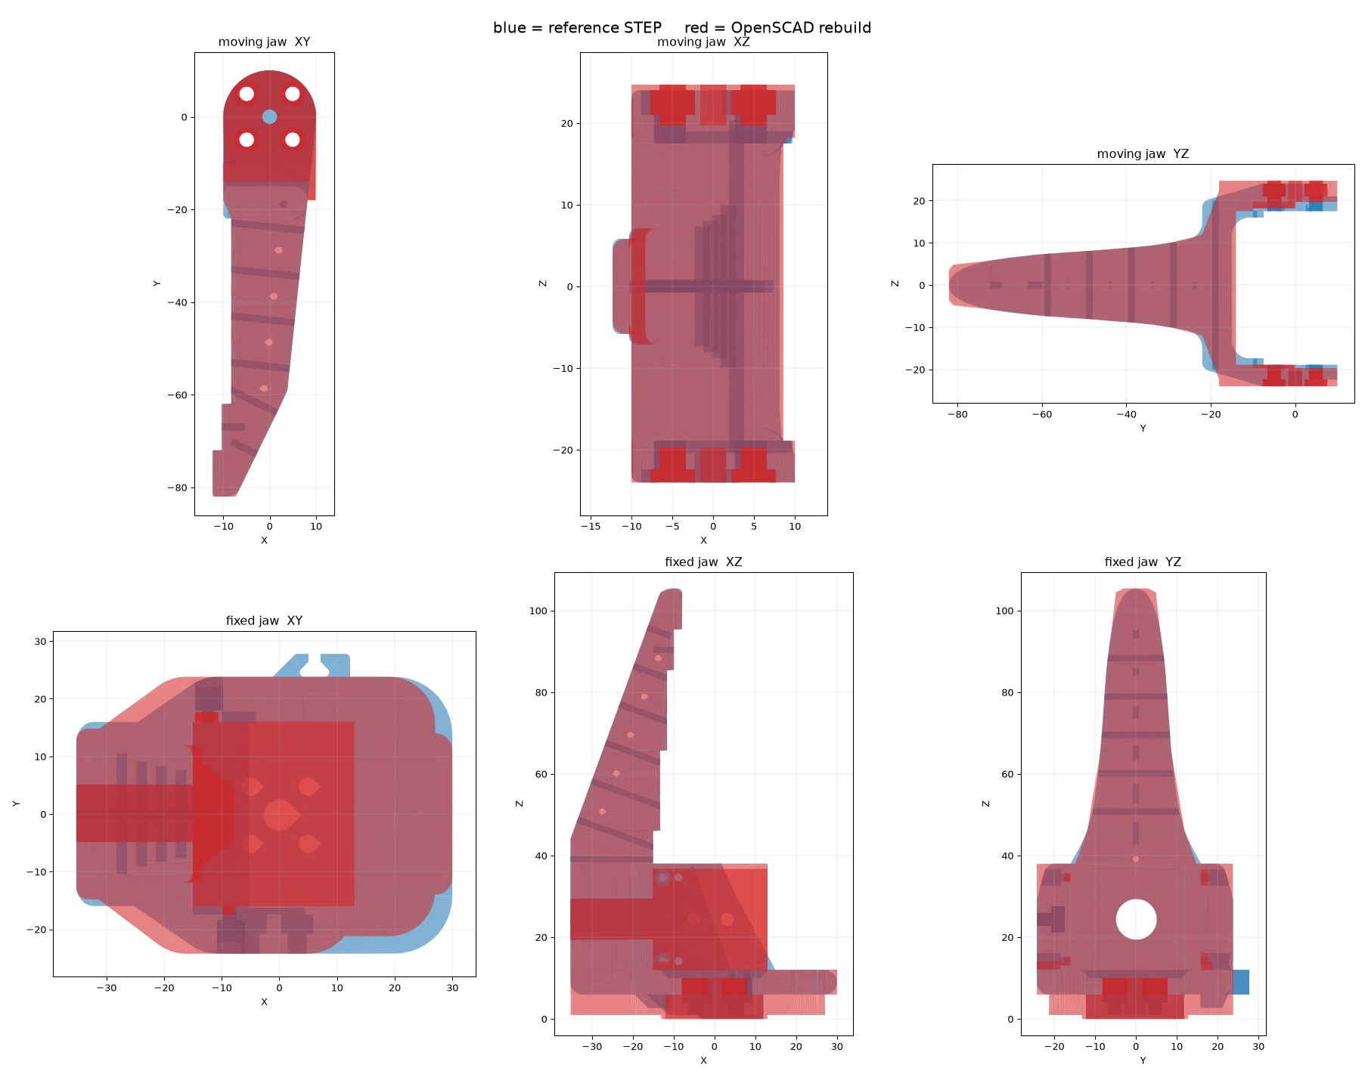
cad/openscad/render/fidelity_check.png
