JacobSchantz/HelpingHands/cad/openscad/render/fixed_jaw.png

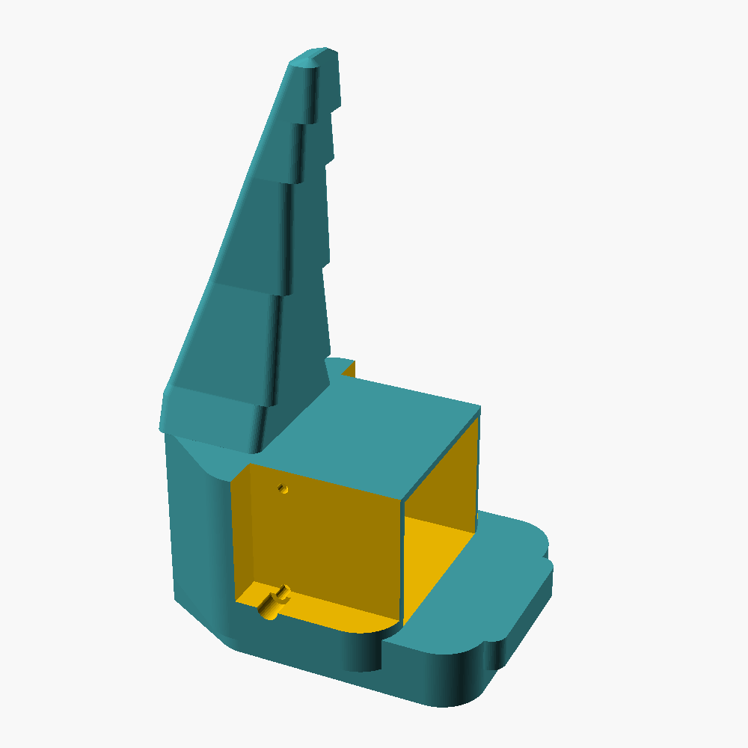
cad/openscad/render/fixed_jaw.png
