JacobSchantz/HelpingHands/cad/openscad/render/gripper_closed.png

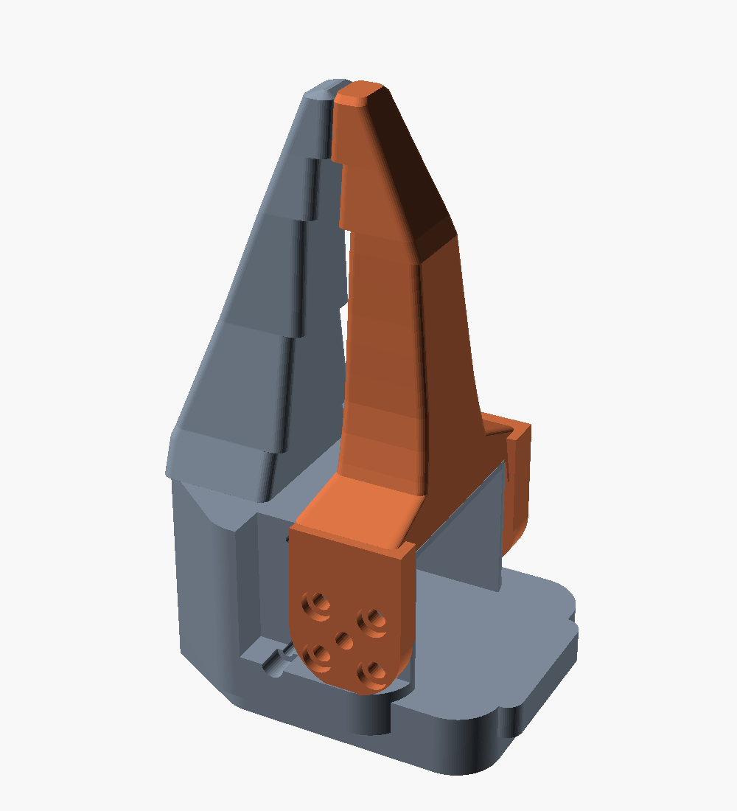
cad/openscad/render/gripper_closed.png
