JacobSchantz/HelpingHands/cad/openscad/render/gripper_open.png

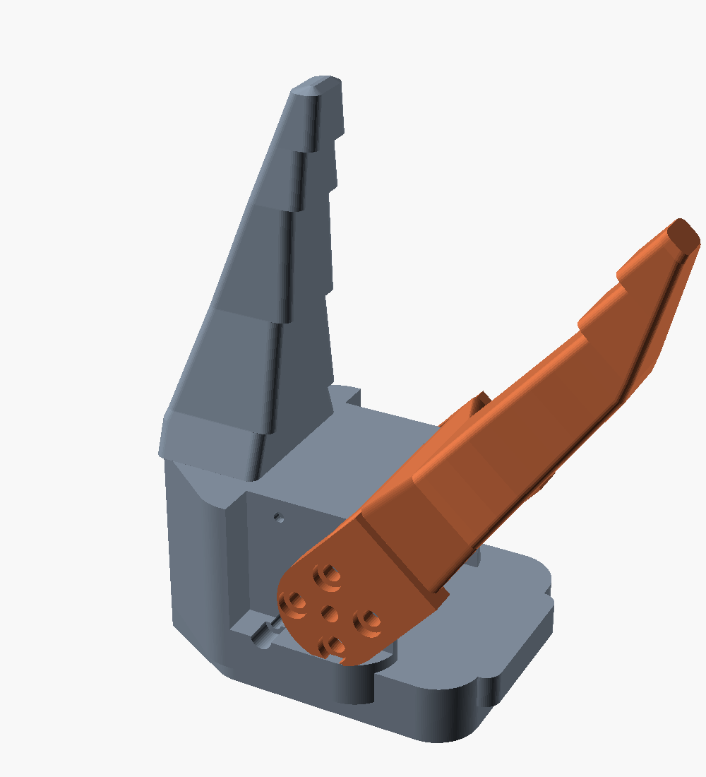
cad/openscad/render/gripper_open.png
