JacobSchantz/HelpingHands/cad/openscad/render/gripper_side.png

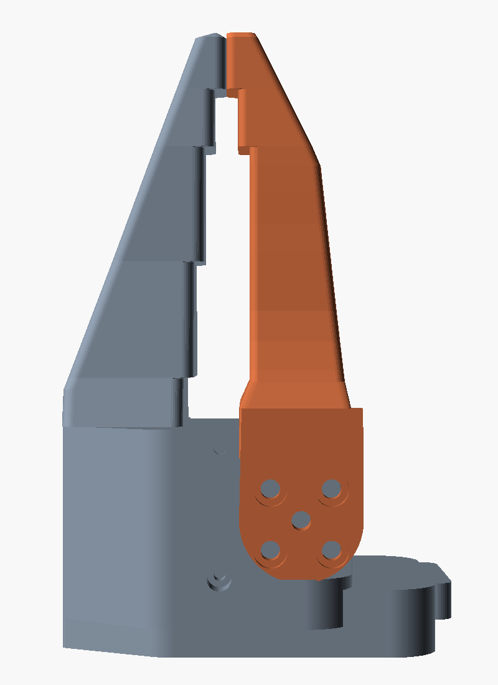
cad/openscad/render/gripper_side.png
