JacobSchantz/HelpingHands/cad/openscad/render/moving_jaw.png

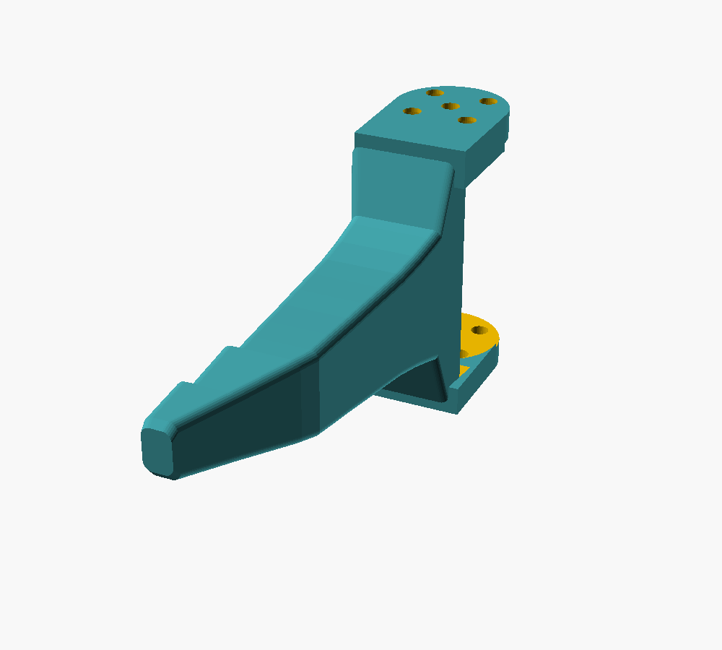
cad/openscad/render/moving_jaw.png
