JacobSchantz/HelpingHands/cad/reference/generalist_gripper_gen6_side.png

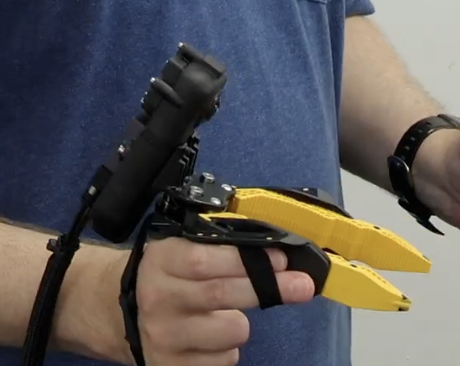
cad/reference/generalist_gripper_gen6_side.png
