JacobSchantz/HelpingHands/ORCA CC-BY Prototype/versions/v003_piece_shell_study/render/original_sections.png

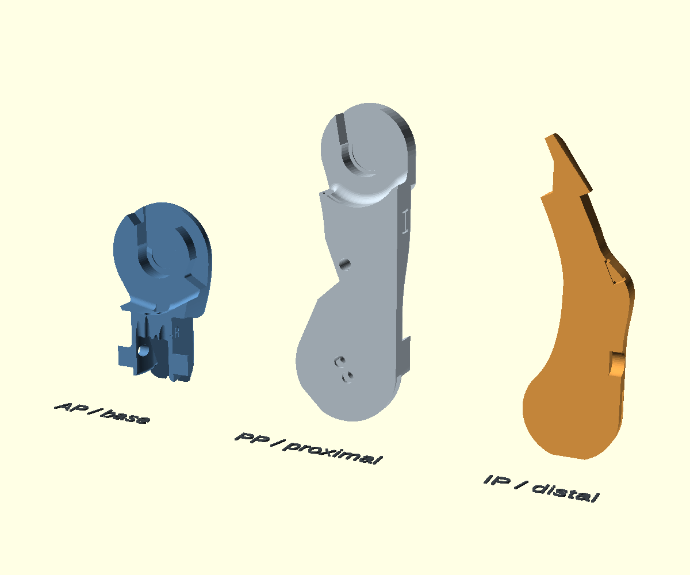
ORCA CC-BY Prototype/versions/v003_piece_shell_study/render/original_sections.png
