JacobSchantz/HelpingHands/pebbles/agent/voice-1a2680b8/landing.png

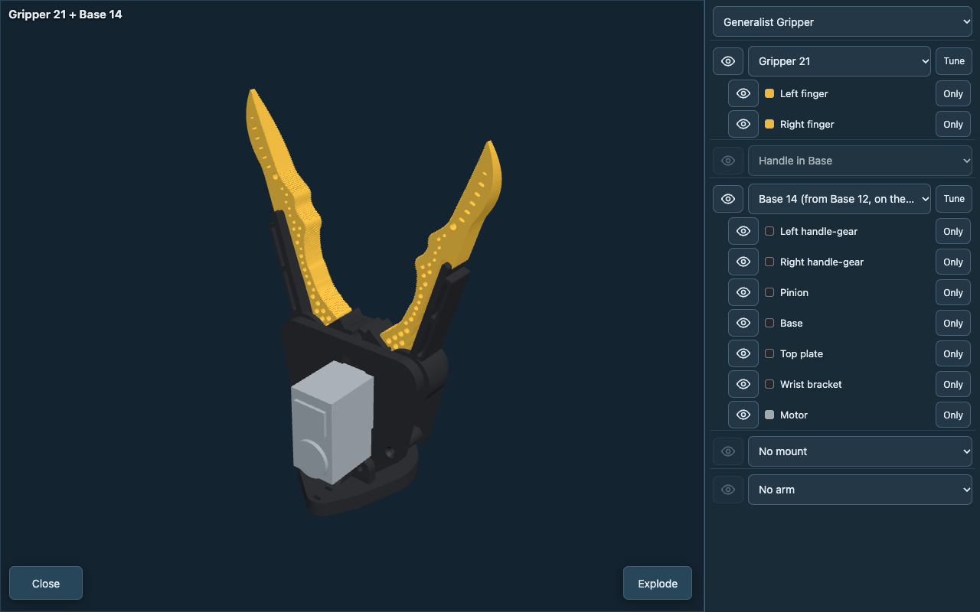
pebbles/agent/voice-1a2680b8/landing.png
