JacobSchantz/HelpingHands/pebbles/agent/voice-3b311f32/v303_drive_iso.png

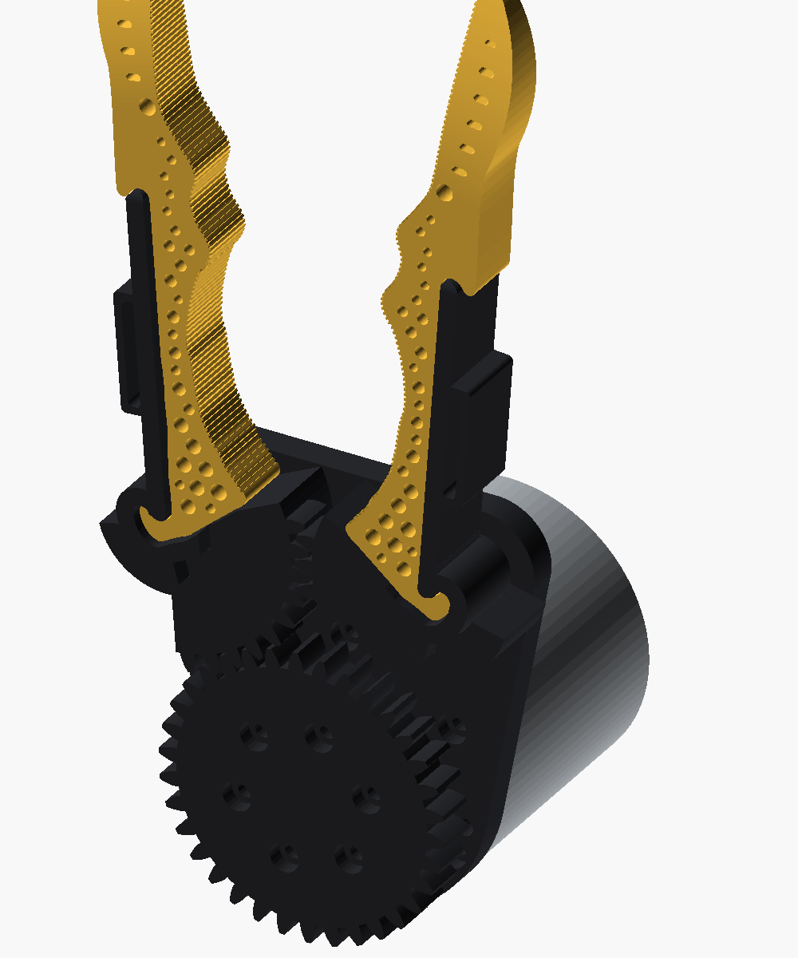
pebbles/agent/voice-3b311f32/v303_drive_iso.png
