JacobSchantz/HelpingHands/pebbles/agent/voice-3f6ae8e1/visual.png

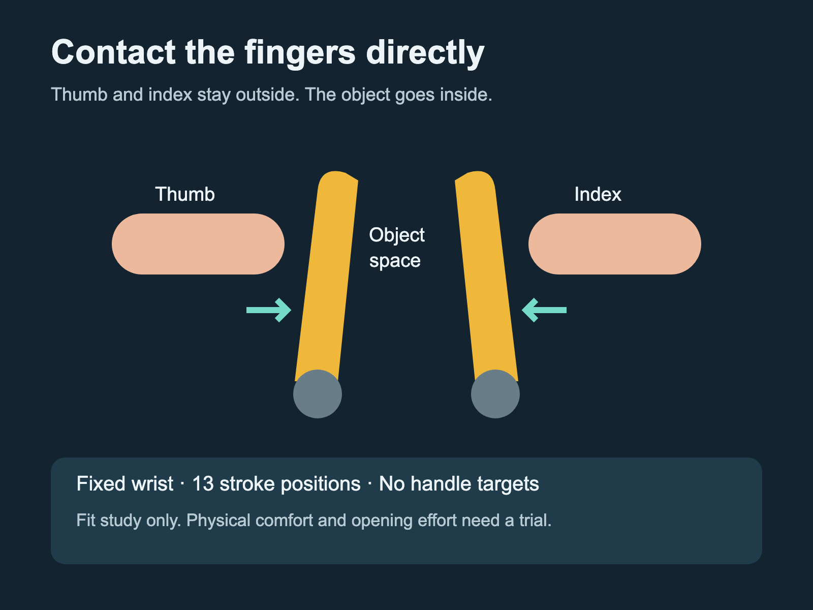
pebbles/agent/voice-3f6ae8e1/visual.png
