JacobSchantz/HelpingHands/pebbles/agent/voice-6d8b9fd8/in_hand.png

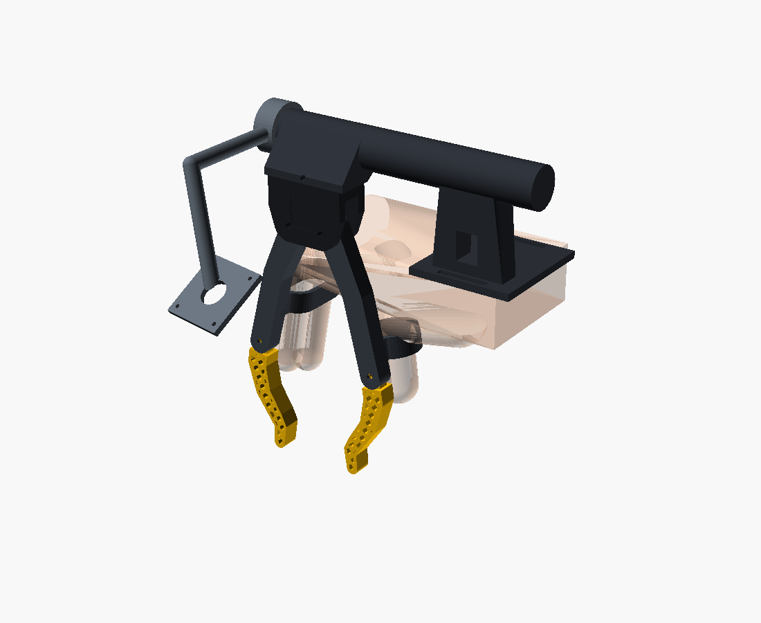
pebbles/agent/voice-6d8b9fd8/in_hand.png
