JacobSchantz/HelpingHands/pebbles/agent/voice-7b719c5b/visual.png

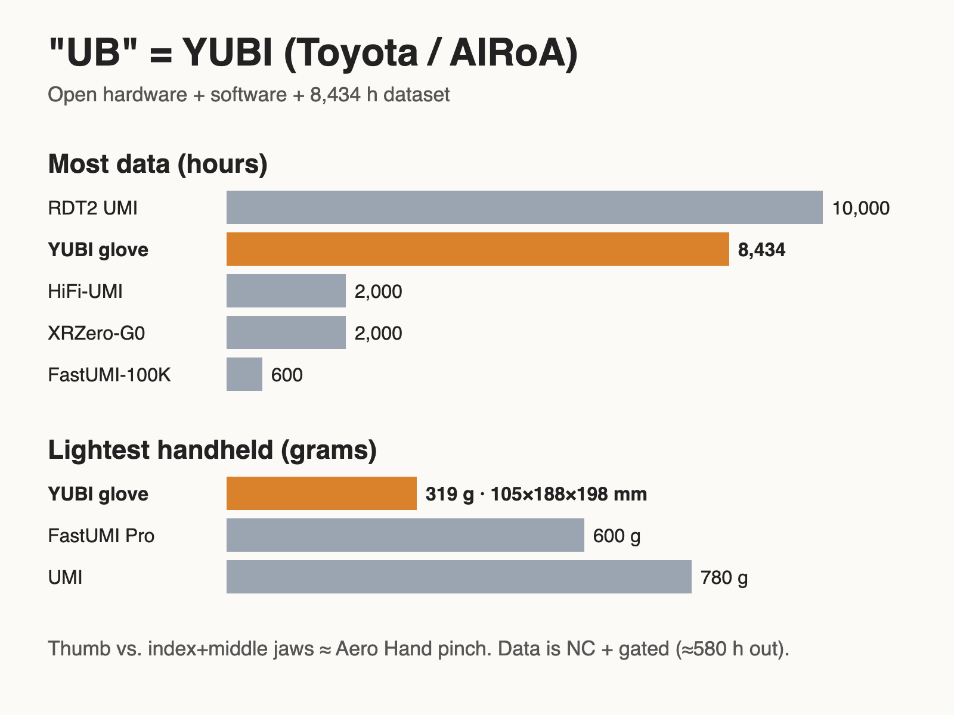
pebbles/agent/voice-7b719c5b/visual.png
