JacobSchantz/HelpingHands/pebbles/agent/voice-7fc650e9/aero_panel.png

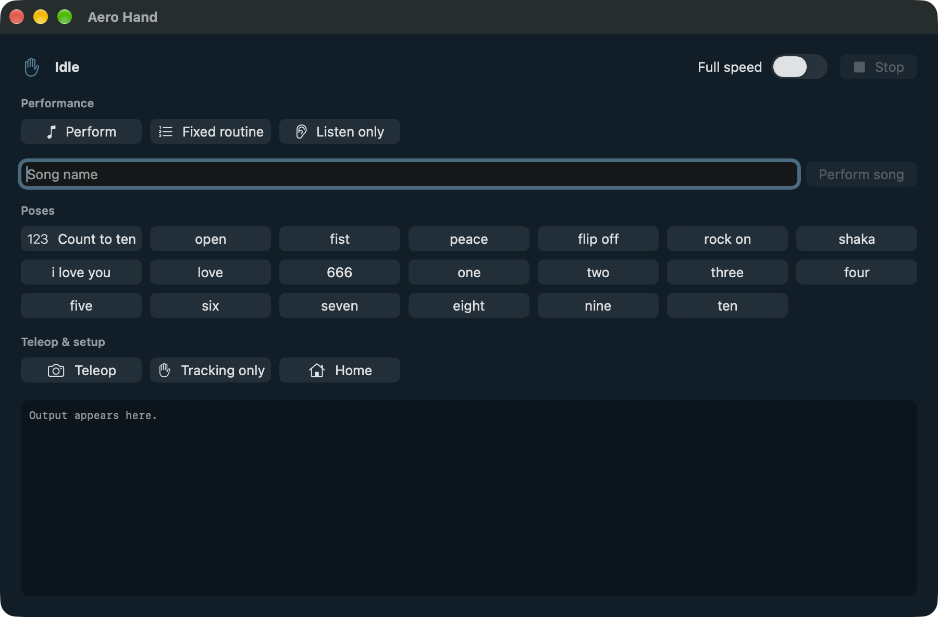
pebbles/agent/voice-7fc650e9/aero_panel.png
