JacobSchantz/HelpingHands/pebbles/agent/voice-7fc650e9/aero_panel_perf.png

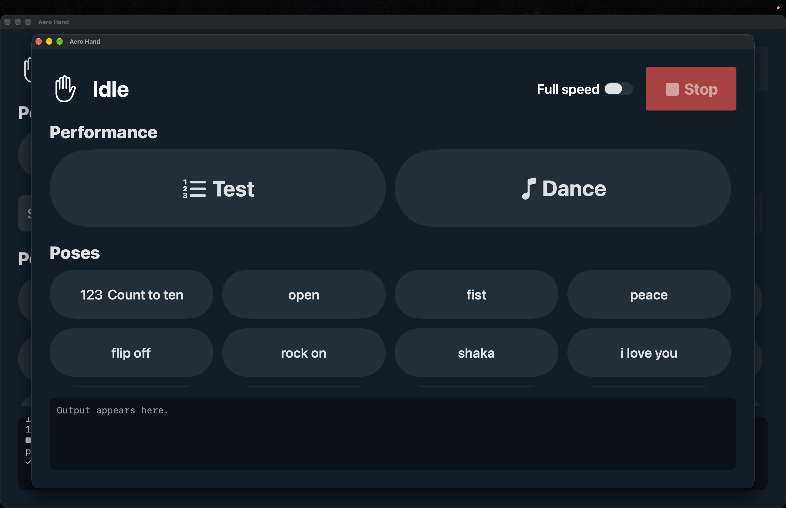
pebbles/agent/voice-7fc650e9/aero_panel_perf.png
