JacobSchantz/HelpingHands/pebbles/agent/voice-7fc650e9/aero_panel_rescue.png

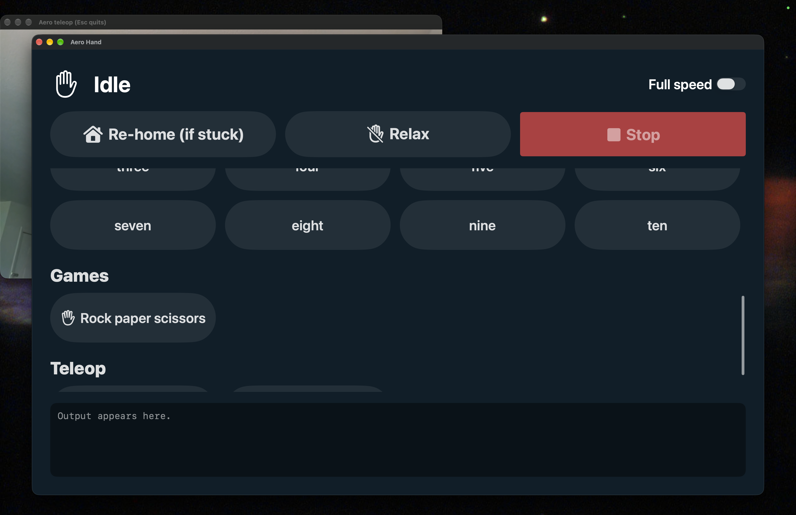
pebbles/agent/voice-7fc650e9/aero_panel_rescue.png
