JacobSchantz/HelpingHands/pebbles/agent/voice-44e6c4d2/visual.png

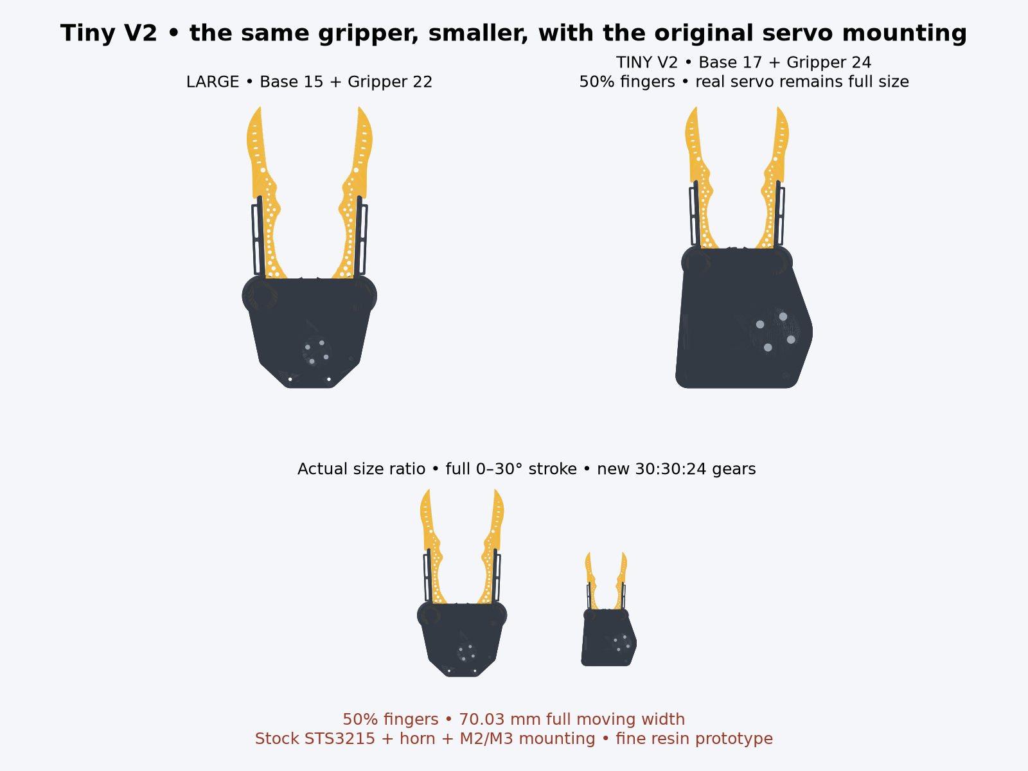
pebbles/agent/voice-44e6c4d2/visual.png
