JacobSchantz/HelpingHands/pebbles/agent/voice-790aa455/preview_arm2_mount2.png

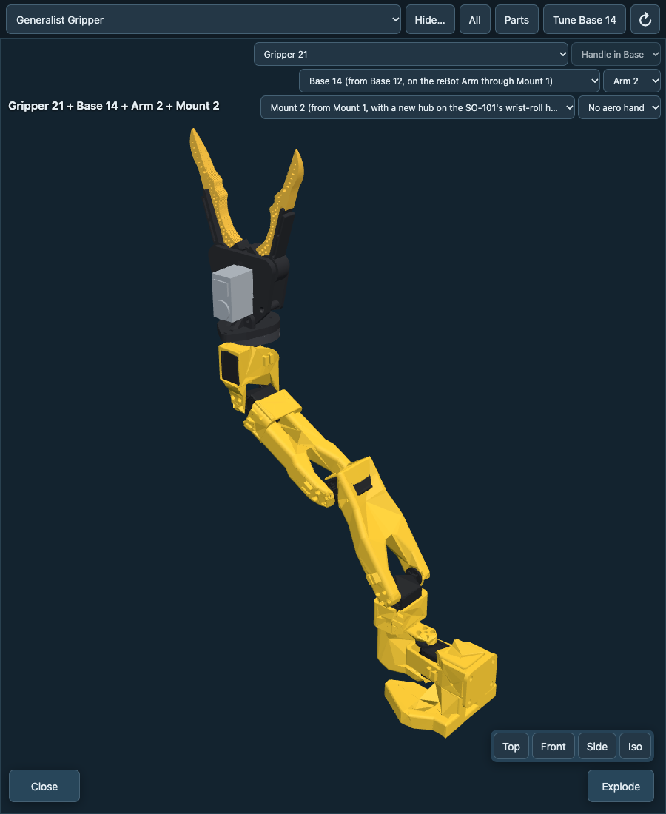
pebbles/agent/voice-790aa455/preview_arm2_mount2.png
