JacobSchantz/HelpingHands/pebbles/agent/voice-805d4970/crow_hand_exploded.png

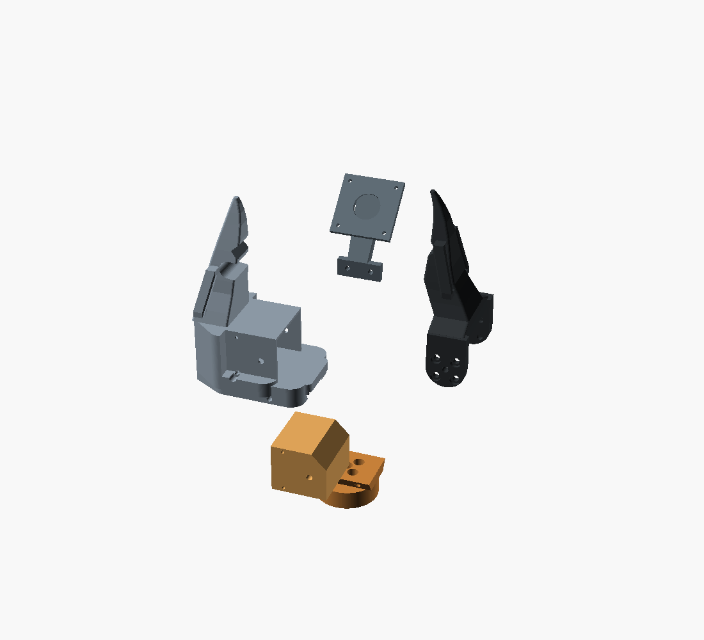
pebbles/agent/voice-805d4970/crow_hand_exploded.png
