JacobSchantz/HelpingHands/pebbles/agent/voice-550038ca/centered-hand-15.png

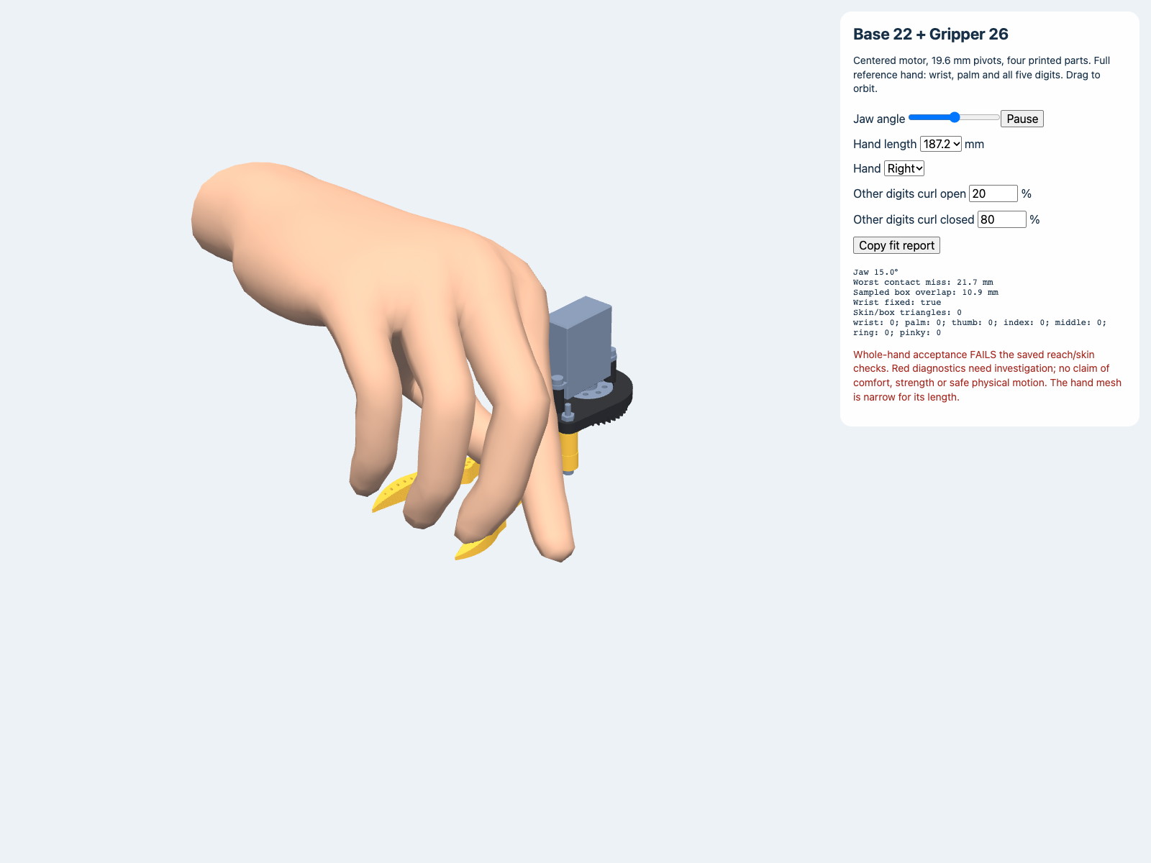
pebbles/agent/voice-550038ca/centered-hand-15.png
