JacobSchantz/HelpingHands/pebbles/agent/voice-550038ca/small-drive-comparison.png

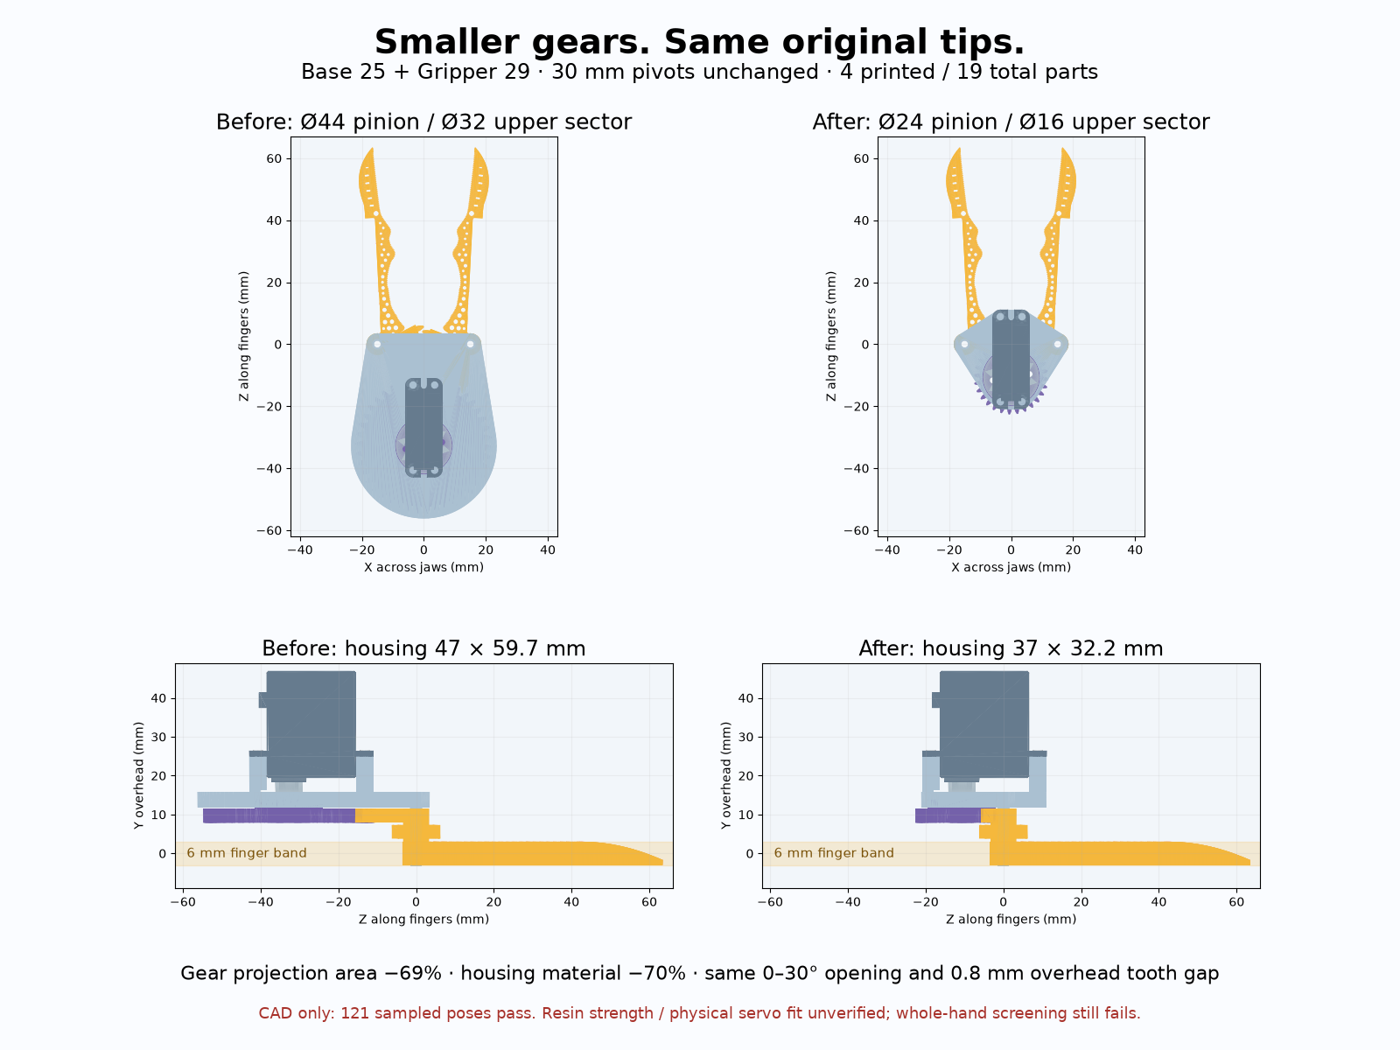
pebbles/agent/voice-550038ca/small-drive-comparison.png
