JacobSchantz/HelpingHands/pebbles/agent/voice-550038ca/small-drive-hand.png

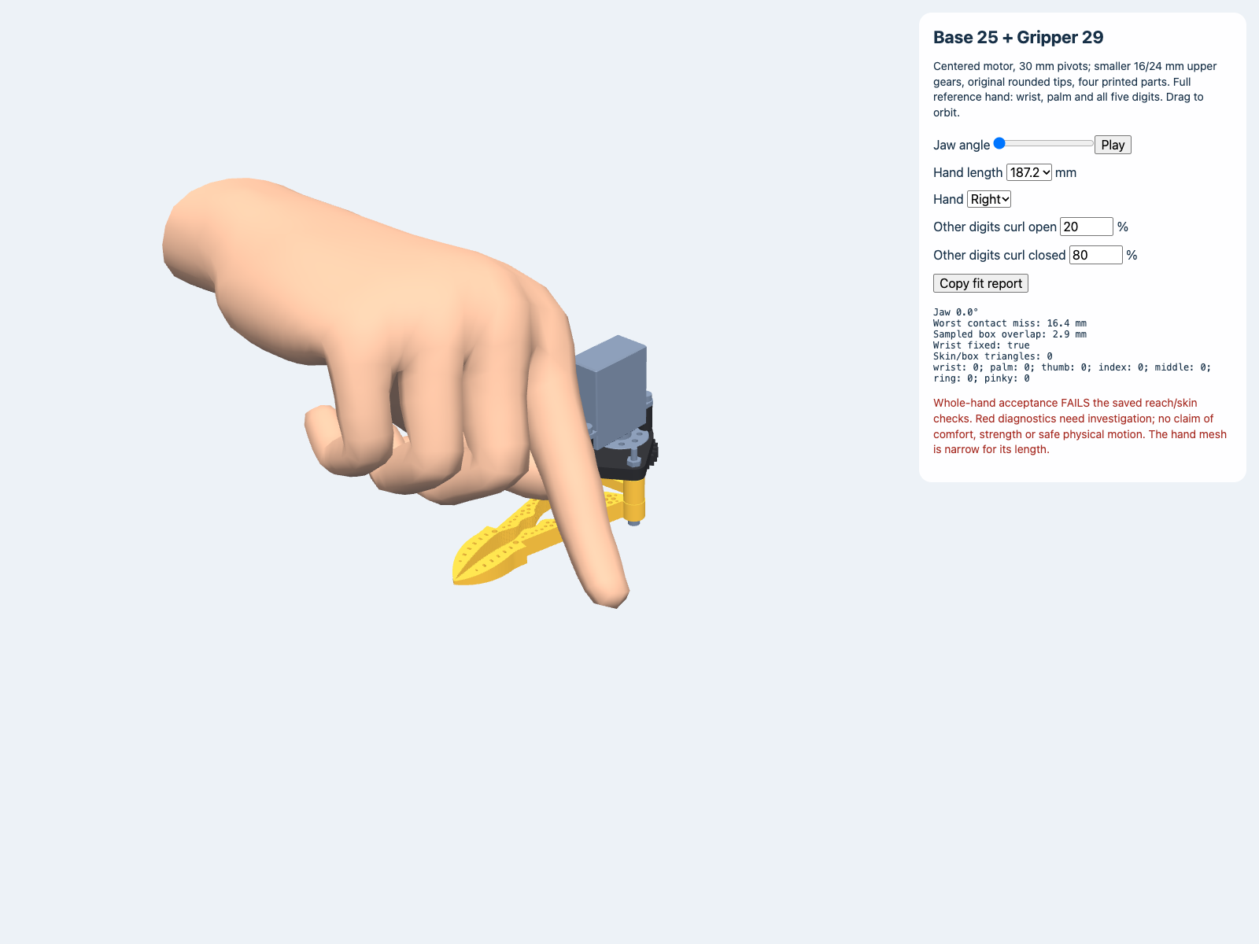
pebbles/agent/voice-550038ca/small-drive-hand.png
