JacobSchantz/HelpingHands/pebbles/agent/voice-550038ca/support-free-first-layers.png

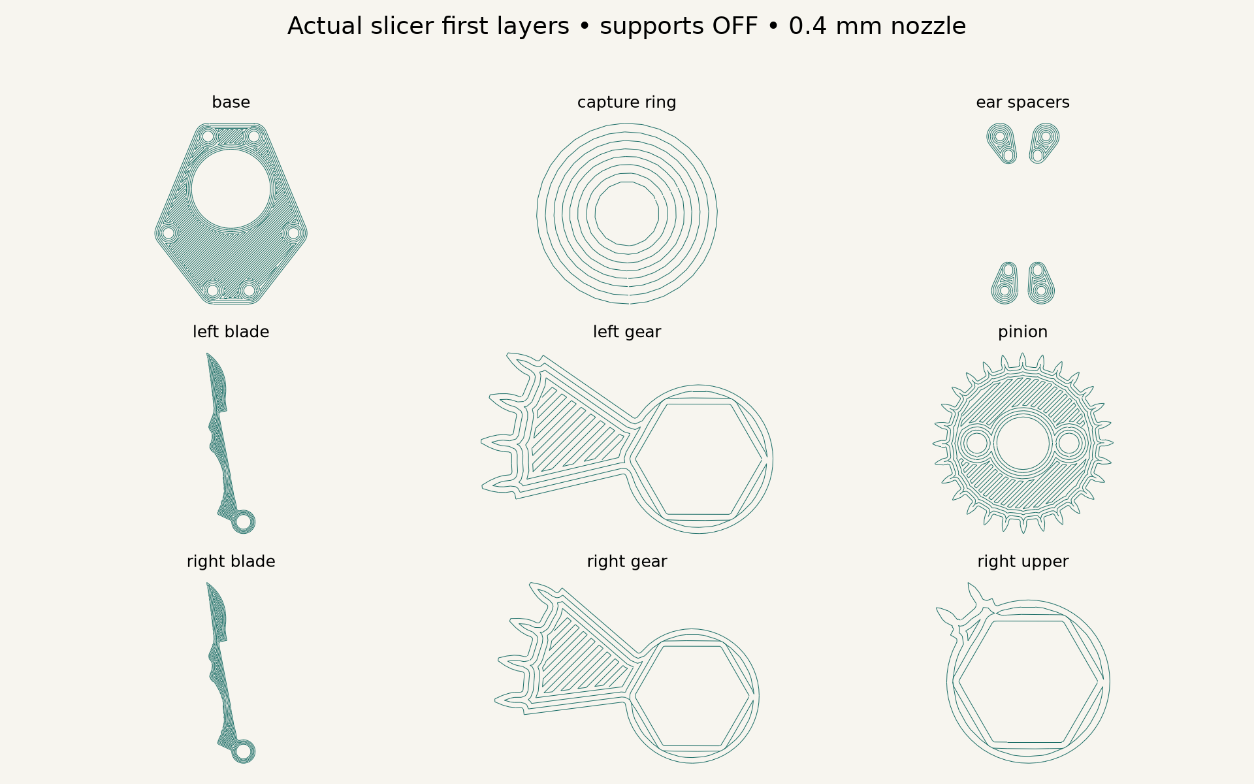
pebbles/agent/voice-550038ca/support-free-first-layers.png
