JacobSchantz/HelpingHands/pebbles/agent/voice-550038ca/visual.png

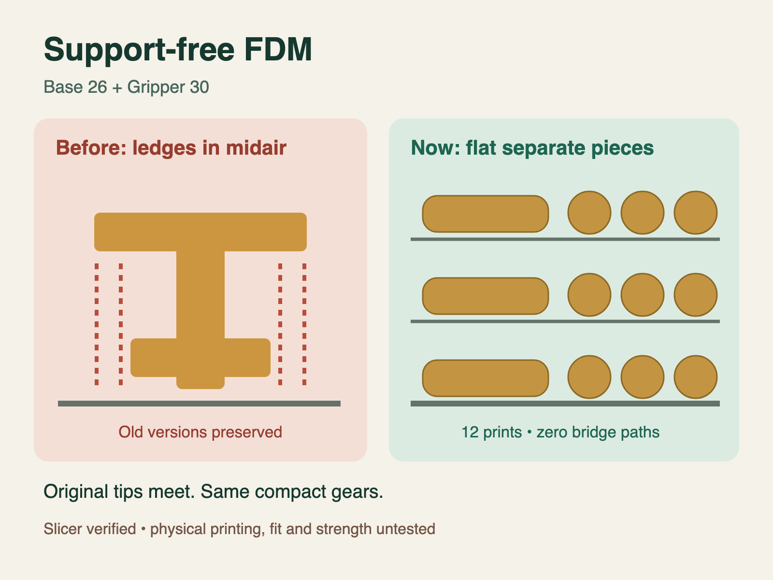
pebbles/agent/voice-550038ca/visual.png
