JacobSchantz/HelpingHands/pebbles/agent/voice-b1dacbad/visual.png

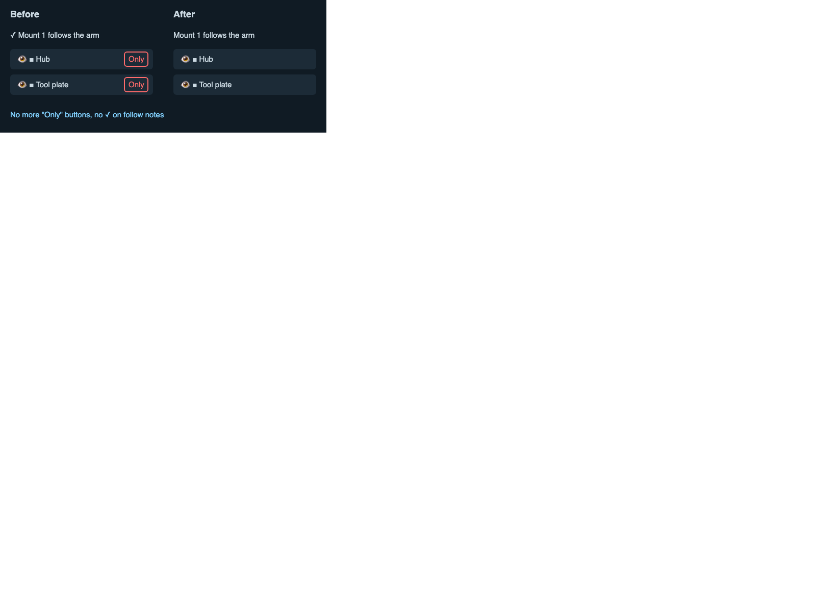
pebbles/agent/voice-b1dacbad/visual.png
