JacobSchantz/HelpingHands/pebbles/agent/voice-b7ae5fc0/gallery_closed.png

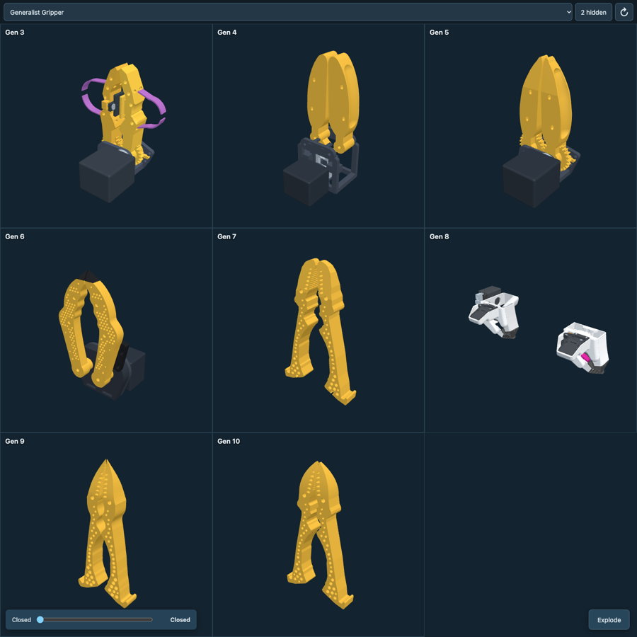
pebbles/agent/voice-b7ae5fc0/gallery_closed.png
