JacobSchantz/HelpingHands/pebbles/agent/voice-bf770cd7/visual.png

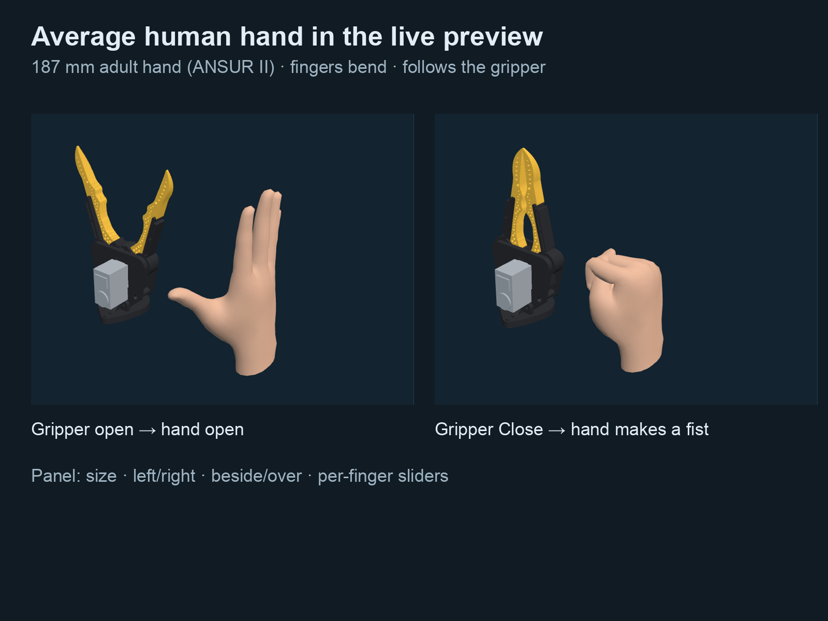
pebbles/agent/voice-bf770cd7/visual.png
