JacobSchantz/HelpingHands/pebbles/agent/voice-c68a1812/visual.png

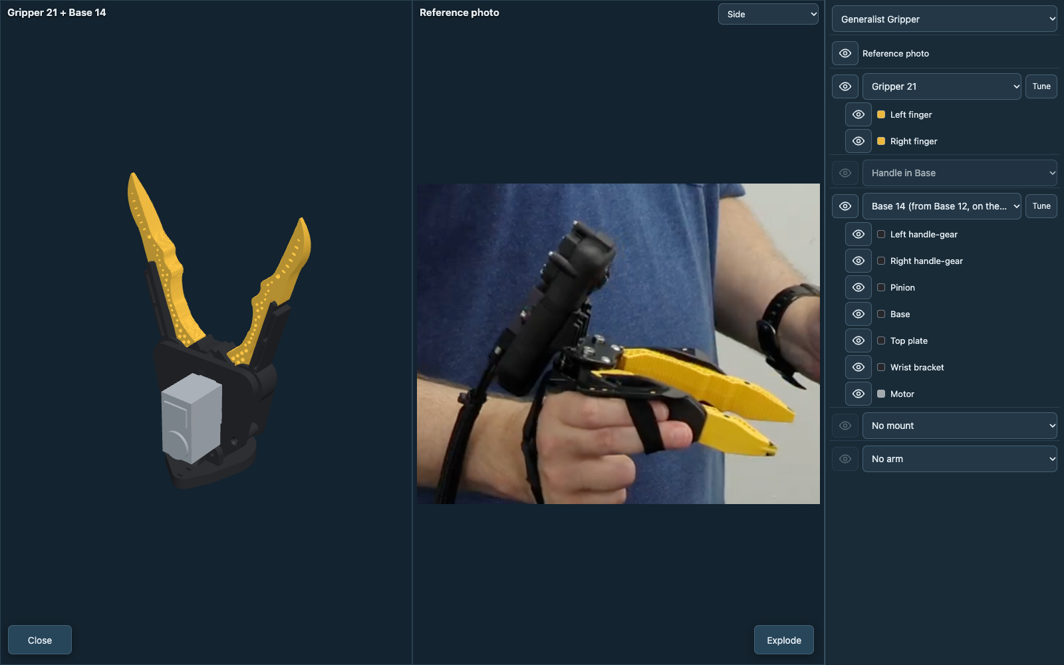
pebbles/agent/voice-c68a1812/visual.png
