JacobSchantz/HelpingHands/pebbles/agent/voice-ef49247b/gallery-mobile.png

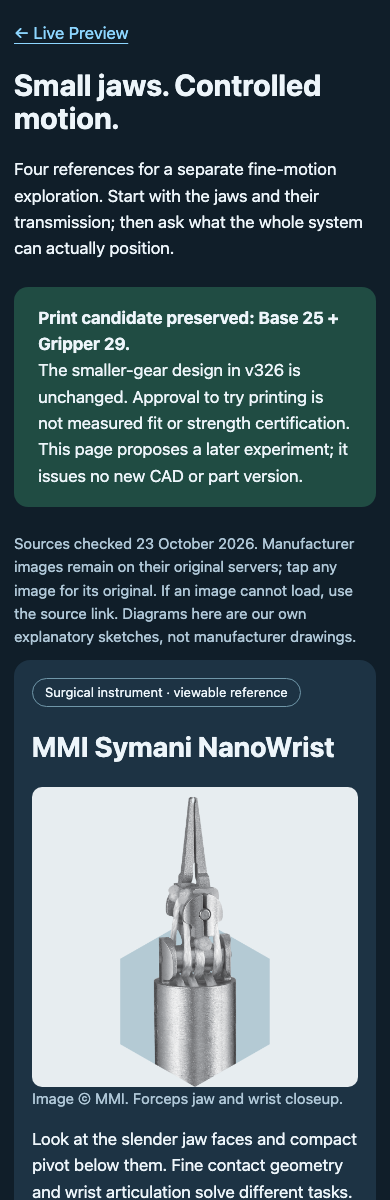
pebbles/agent/voice-ef49247b/gallery-mobile.png
