JacobSchantz/HelpingHands/pebbles/human/voice-3f6ae8e1/fit-preview.png

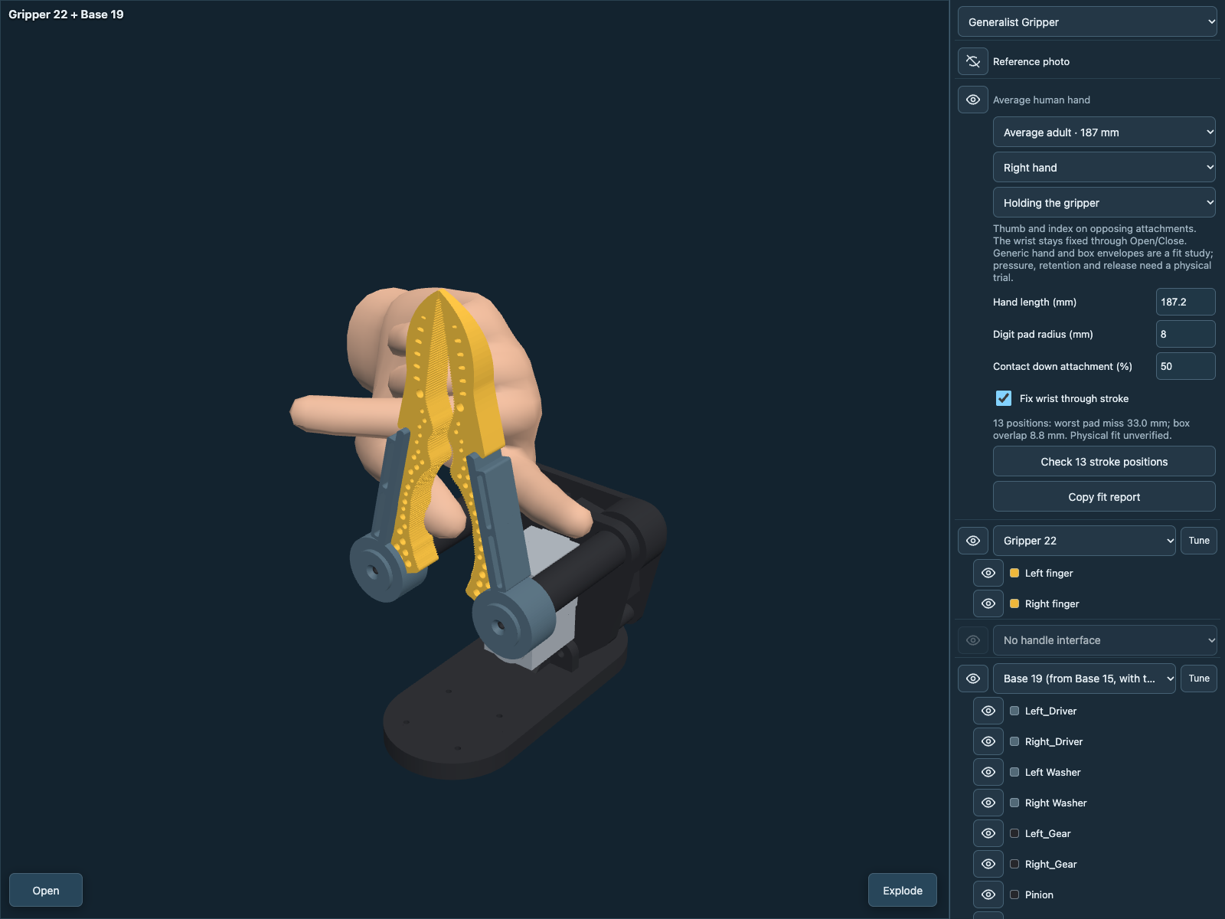
pebbles/human/voice-3f6ae8e1/fit-preview.png
