JacobSchantz/HelpingHands/pebbles/human/voice-6d8b9fd8/app_exploded.png

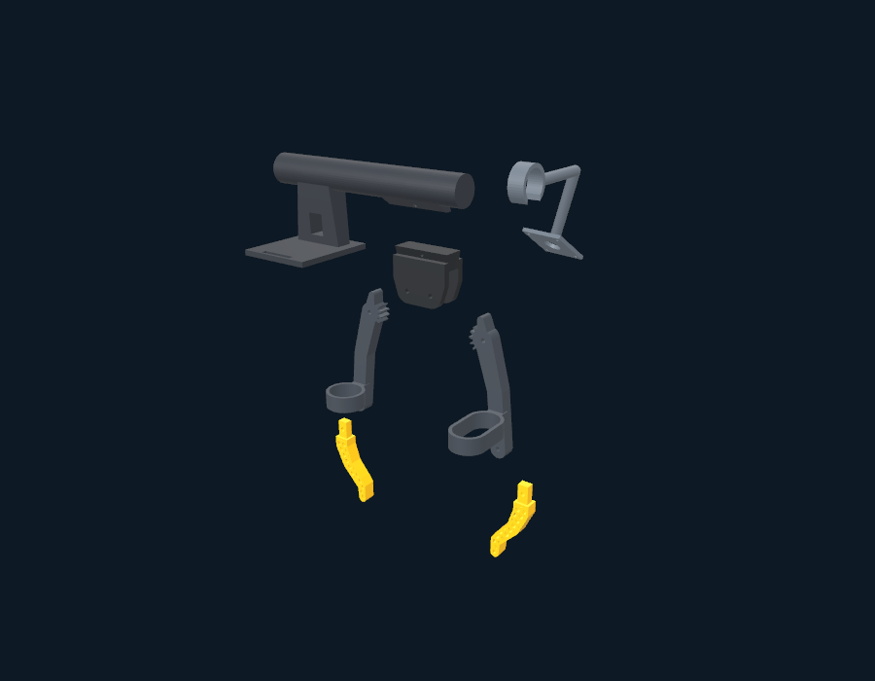
pebbles/human/voice-6d8b9fd8/app_exploded.png
