JacobSchantz/HelpingHands/pebbles/human/voice-7b719c5b/visual.png

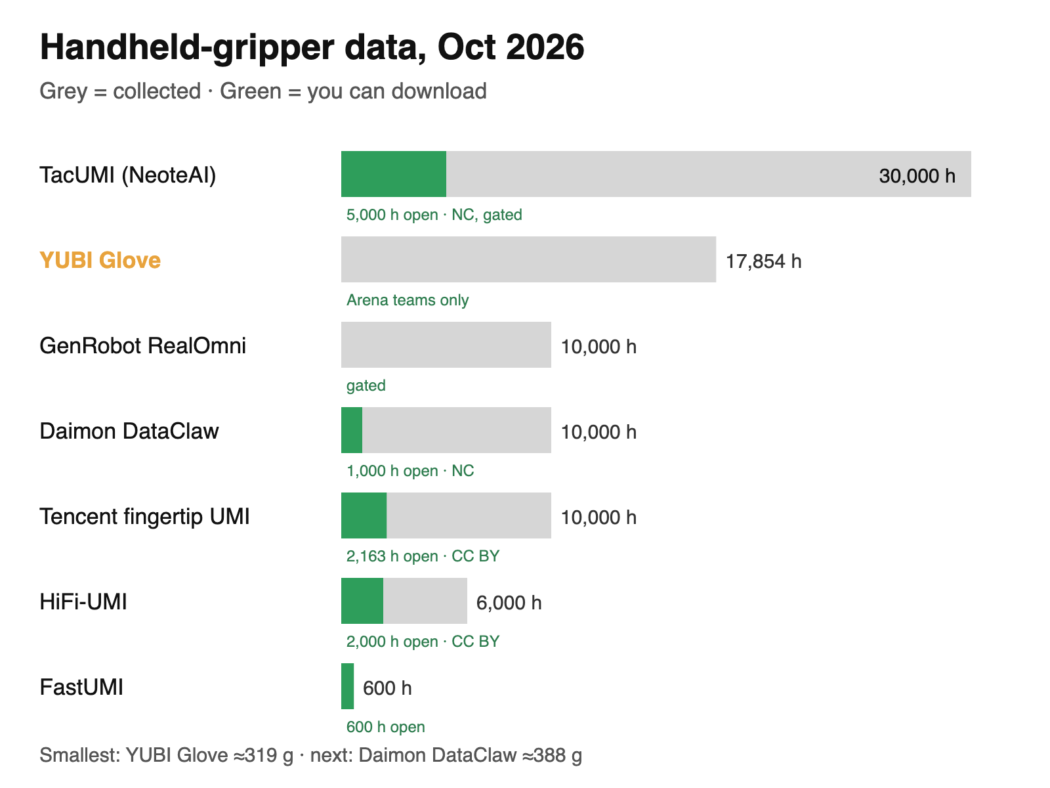
pebbles/human/voice-7b719c5b/visual.png
