JacobSchantz/HelpingHands/pebbles/human/voice-80e52a21/gallery_top.png

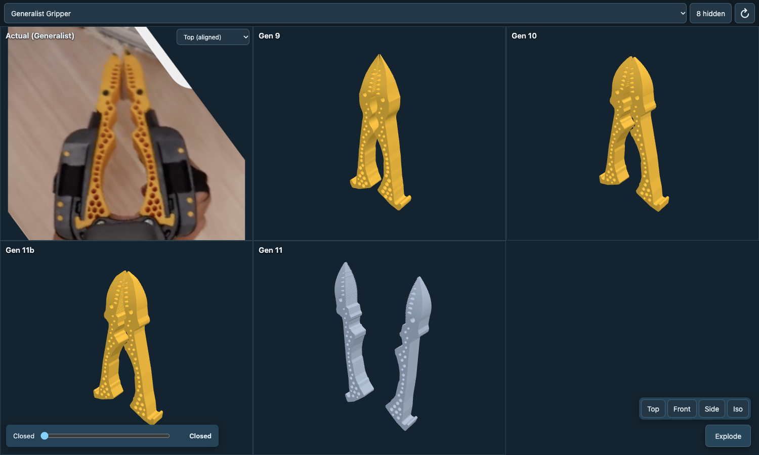
pebbles/human/voice-80e52a21/gallery_top.png
