JacobSchantz/HelpingHands/pebbles/human/voice-550038ca/contact-hardware-pattern.png

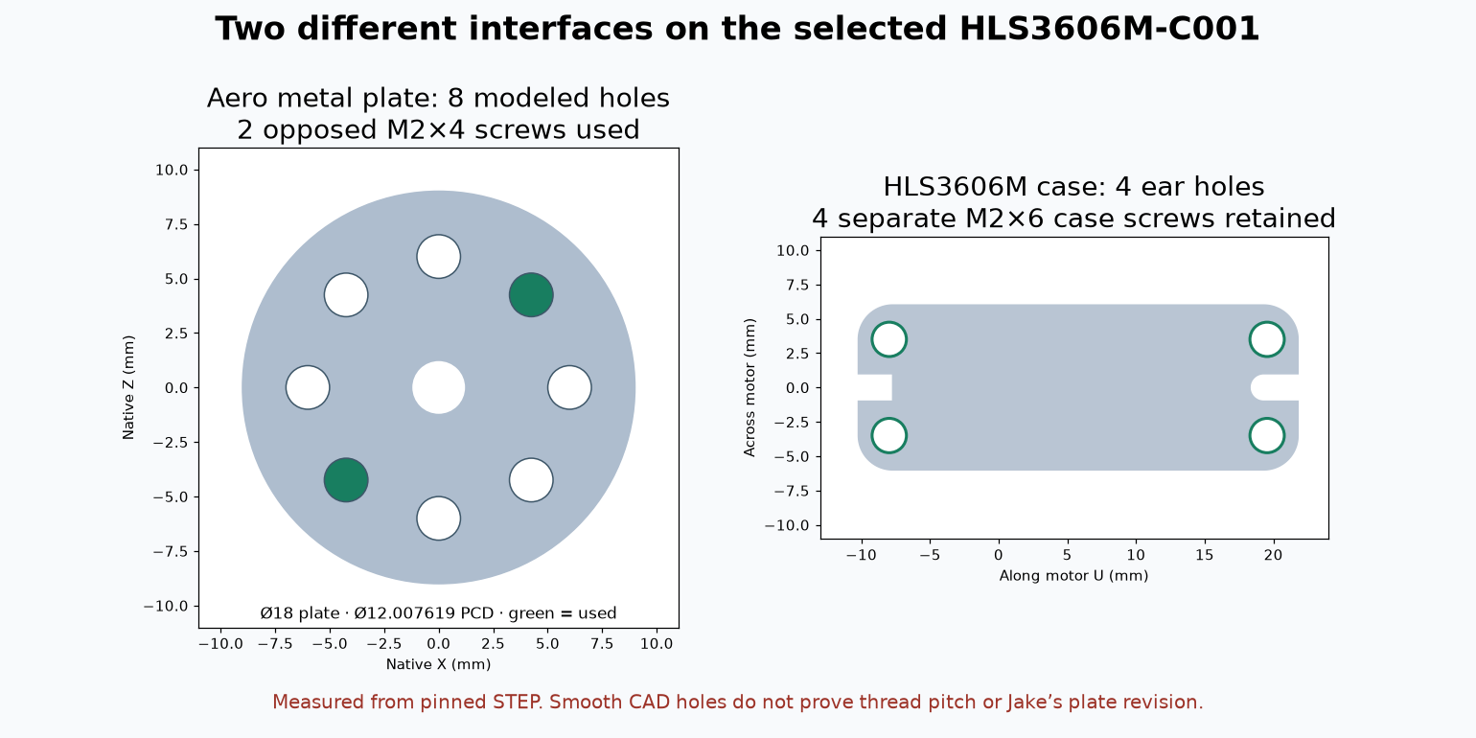
pebbles/human/voice-550038ca/contact-hardware-pattern.png
