JacobSchantz/HelpingHands/pebbles/human/voice-550038ca/visual.png

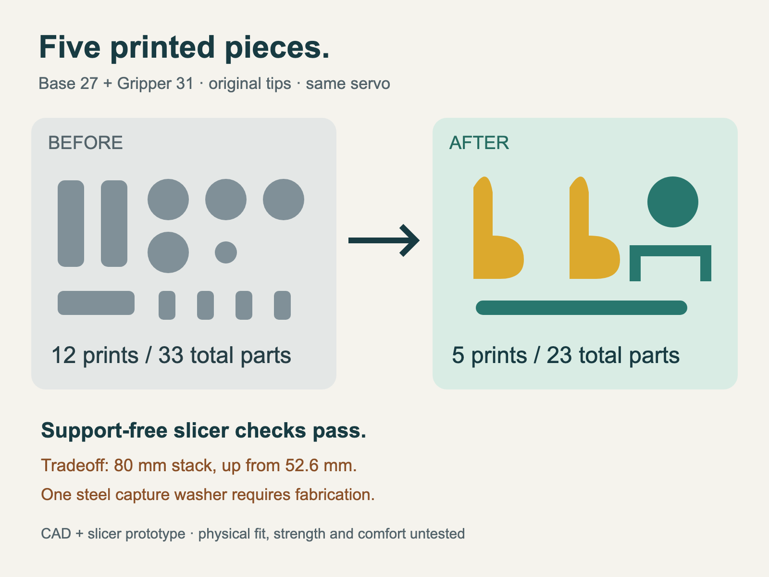
pebbles/human/voice-550038ca/visual.png
