JacobSchantz/HelpingHands/pebbles/human/voice-550038ca/whole-hand-15.png

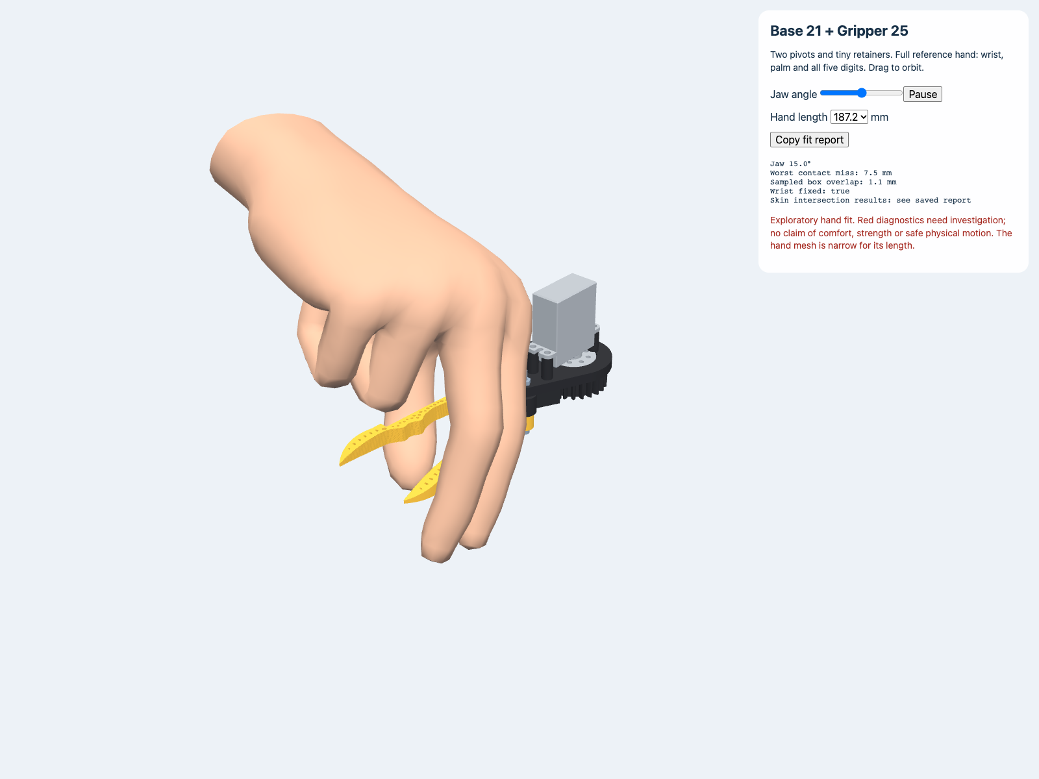
pebbles/human/voice-550038ca/whole-hand-15.png
