JacobSchantz/HelpingHands/pebbles/human/voice-b7ae5fc0/gallery_open.png

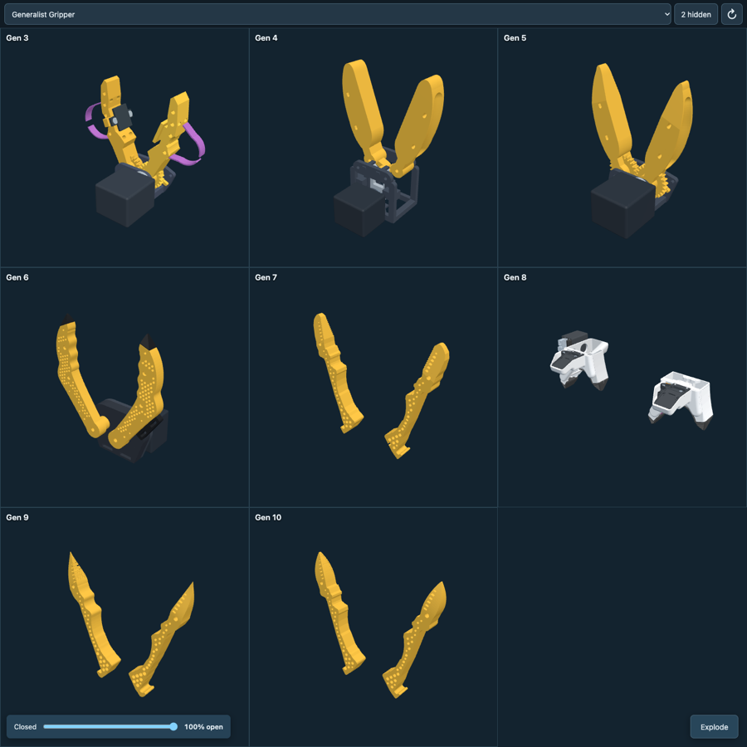
pebbles/human/voice-b7ae5fc0/gallery_open.png
