JacobSchantz/HelpingHands/pebbles/human/voice-bbe0e945/mix_1_17_2_1_no_base.png

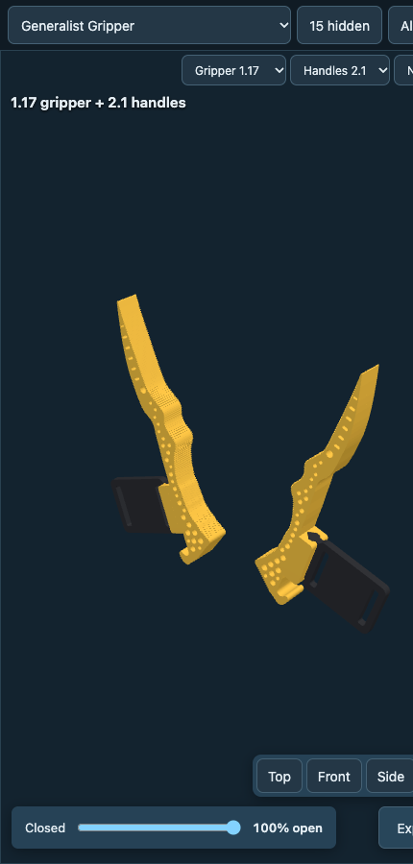
pebbles/human/voice-bbe0e945/mix_1_17_2_1_no_base.png
