JacobSchantz/HelpingHands/pebbles/human/voice-bbe0e945/mix_default_3_1.png

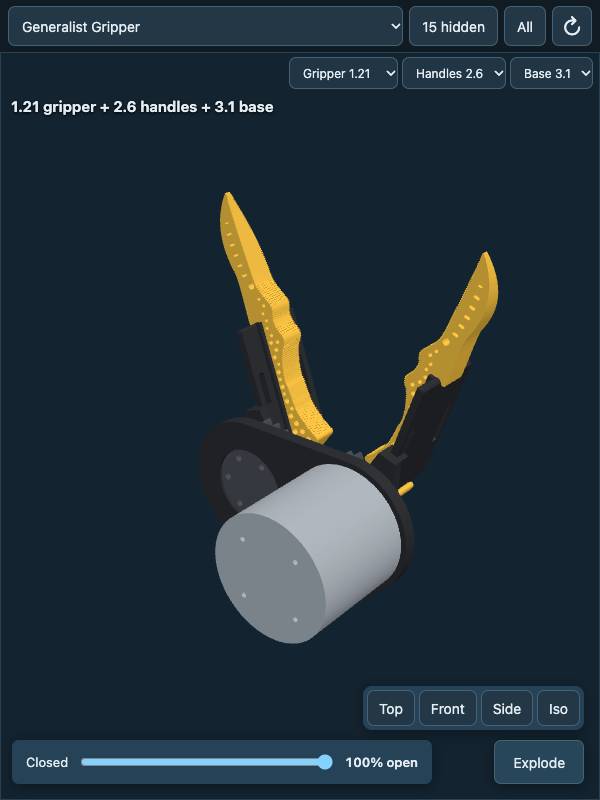
pebbles/human/voice-bbe0e945/mix_default_3_1.png
