JacobSchantz/HelpingHands/pebbles/human/voice-bed52066/mix_gripper21_handle6_base3.png

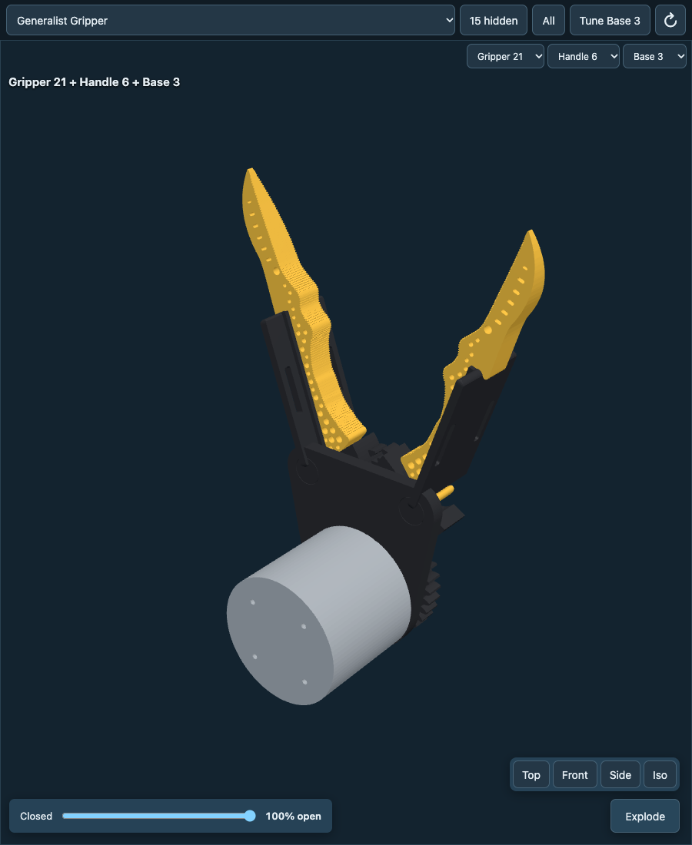
pebbles/human/voice-bed52066/mix_gripper21_handle6_base3.png
