JacobSchantz/HelpingHands/pebbles/human/voice-bf770cd7/visual.png

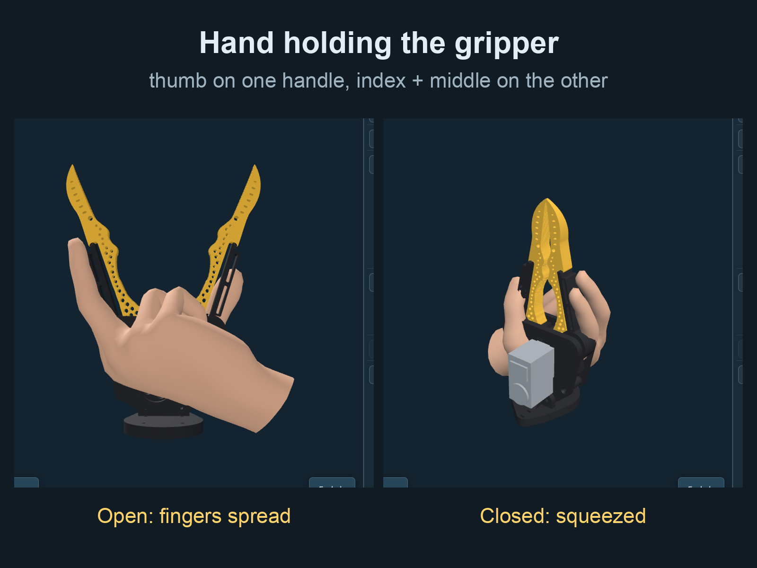
pebbles/human/voice-bf770cd7/visual.png
