JacobSchantz/HelpingHands/pebbles/human/voice-d01680be/visual.png

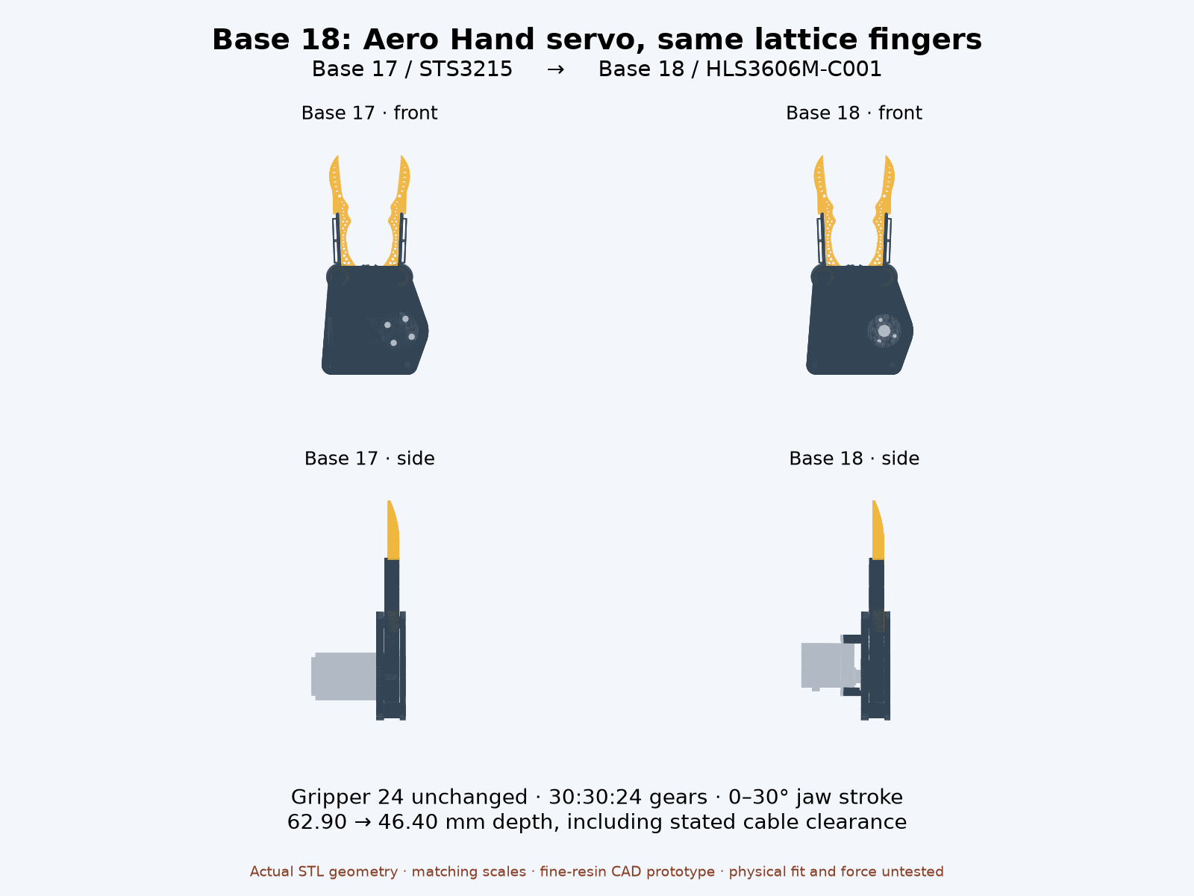
pebbles/human/voice-d01680be/visual.png
