JacobSchantz/HelpingHands/pebbles/human/voice-dd73161d/visual.png

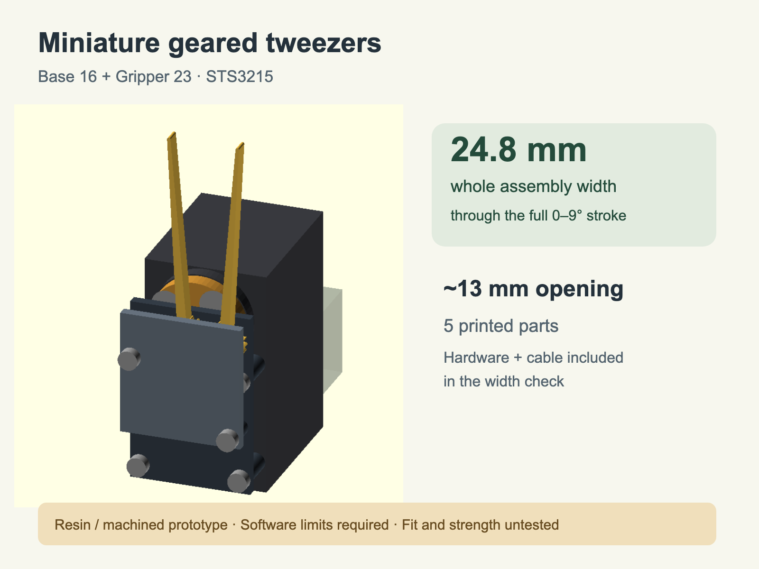
pebbles/human/voice-dd73161d/visual.png
