JacobSchantz/HelpingHands/pebbles/human/voice-ef49247b/visual.png

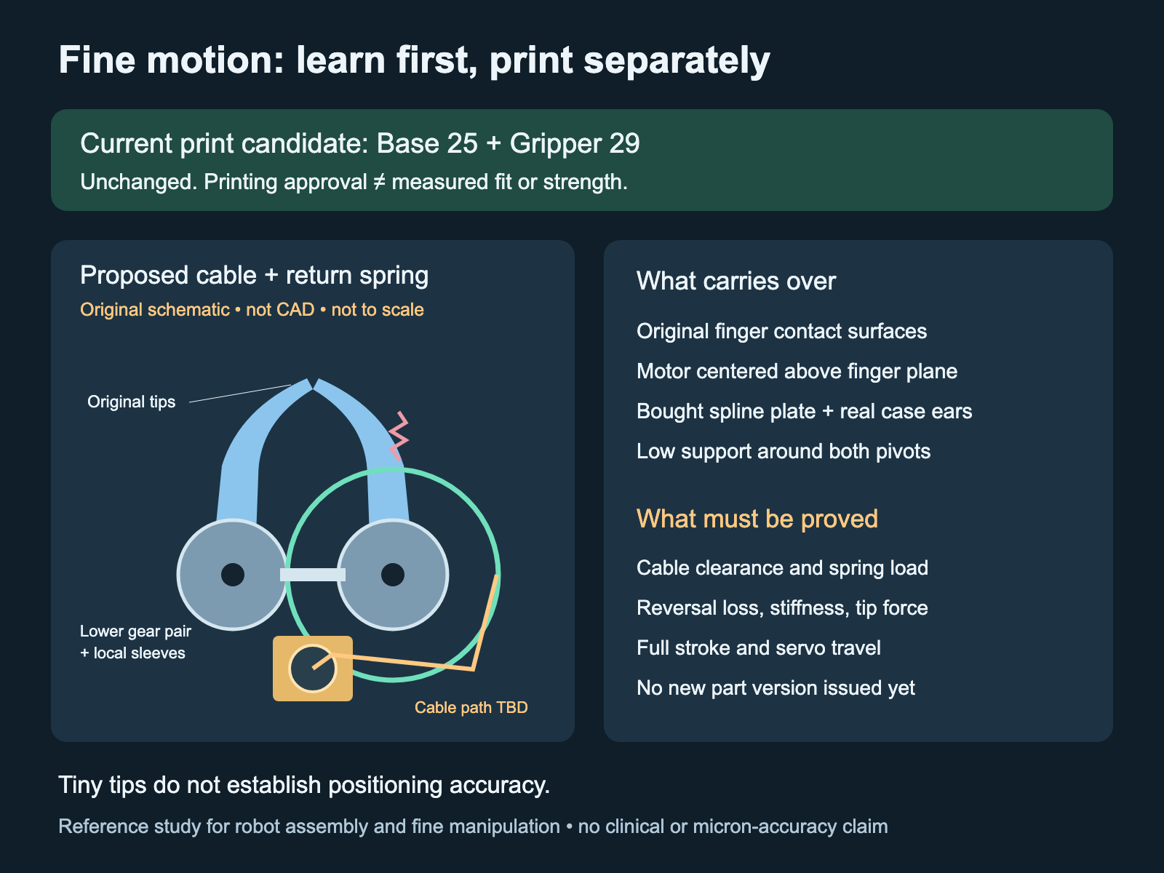
pebbles/human/voice-ef49247b/visual.png
