JacobSchantz/HelpingHands/references/generalist/handheld_box_08.png

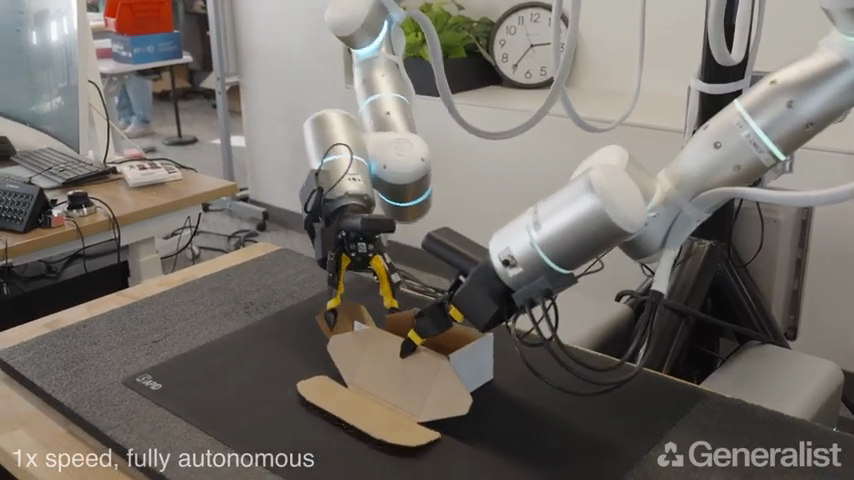
references/generalist/handheld_box_08.png
