JacobSchantz/HelpingHands/references/generalist/human_jar_01.png

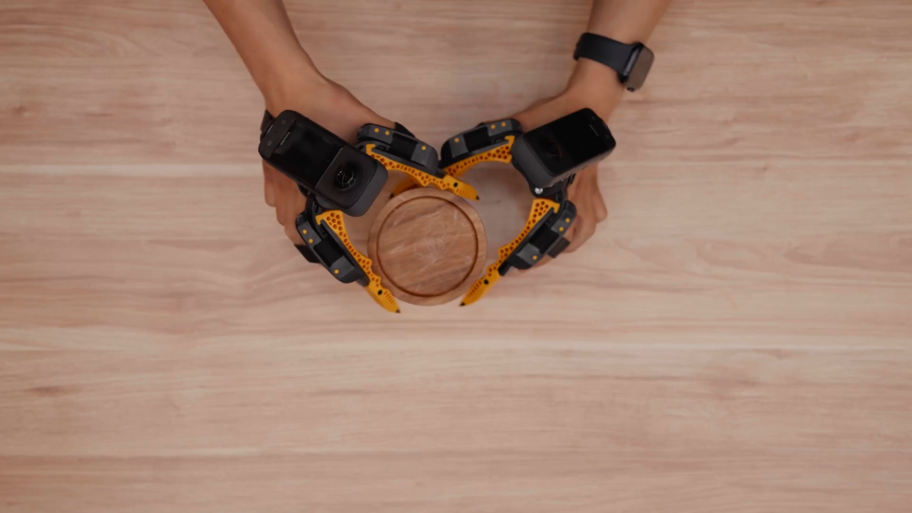
references/generalist/human_jar_01.png
