JacobSchantz/HelpingHands/references/generalist/screwhand_1.jpg

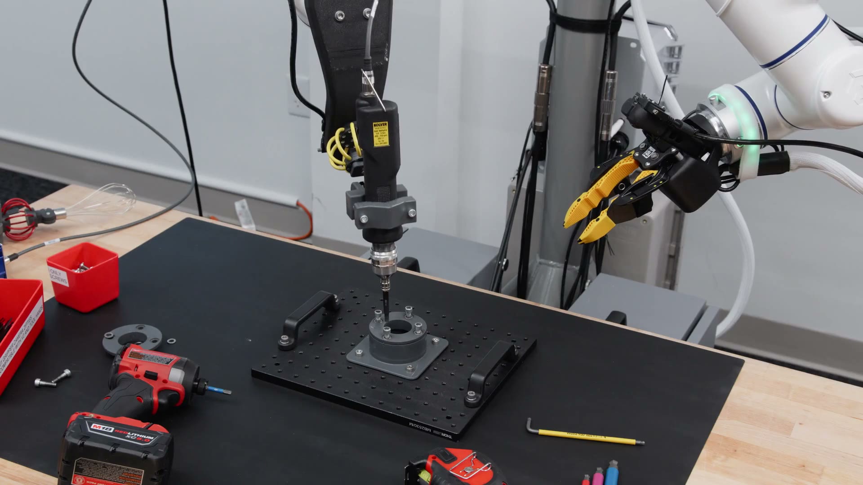
references/generalist/screwhand_1.jpg
