JacobSchantz/HelpingHands/references/generalist/whiskhand_1.jpg

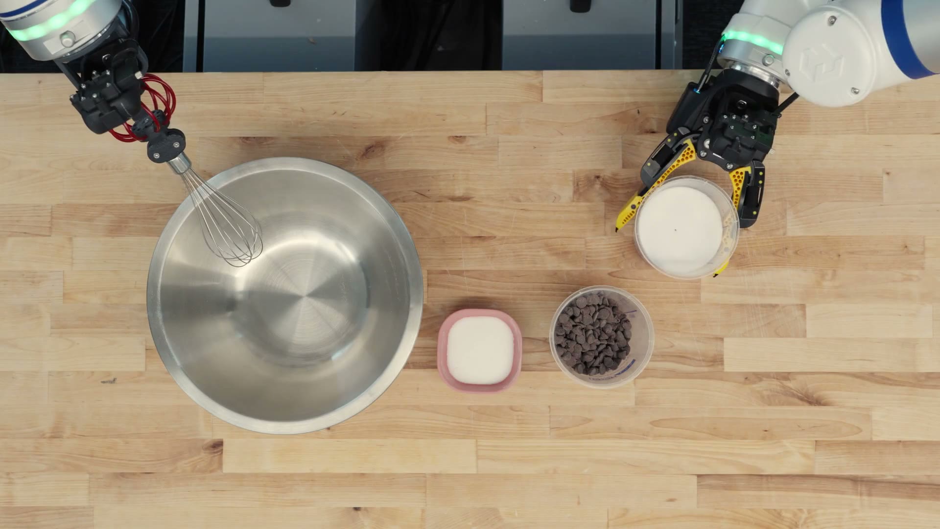
references/generalist/whiskhand_1.jpg
