JacobSchantz/HelpingHands/Two Finger Gripper/versions/v002_two_parallel_modules/previews/rack_pinion_detail.png

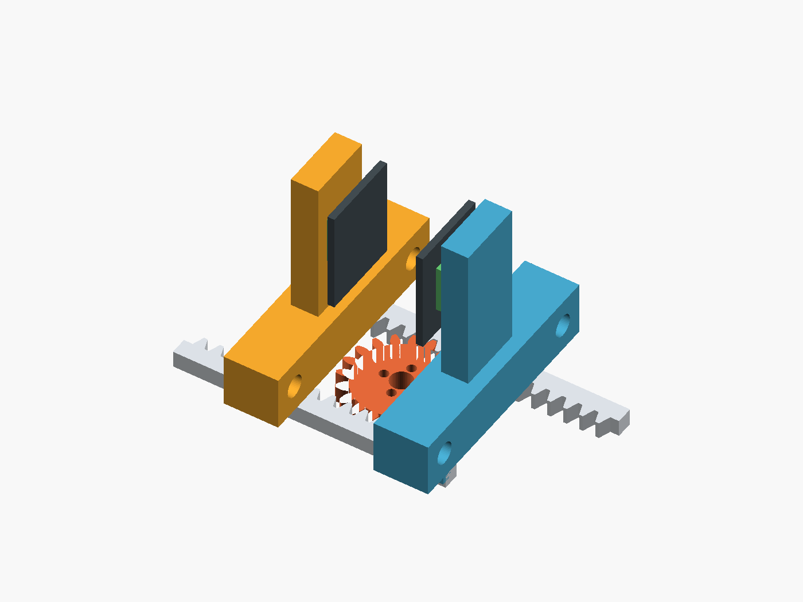
Two Finger Gripper/versions/v002_two_parallel_modules/previews/rack_pinion_detail.png
