JacobSchantz/HelpingHands/Two Finger Gripper/versions/v003_single_pincher/previews/sensor_detail.png

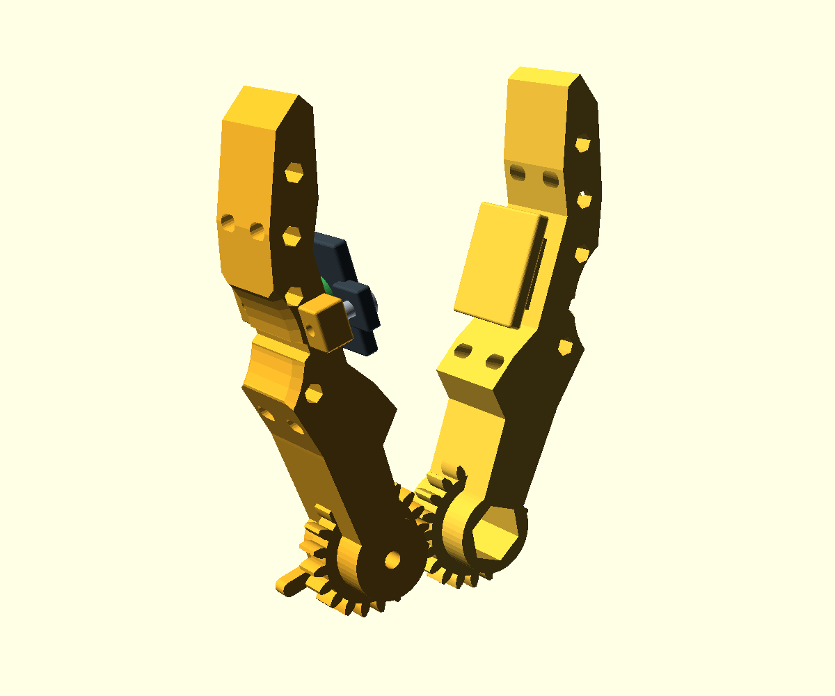
Two Finger Gripper/versions/v003_single_pincher/previews/sensor_detail.png
