JacobSchantz/HelpingHands/Two Finger Gripper/versions/v003_single_pincher/previews/single_pincher.png

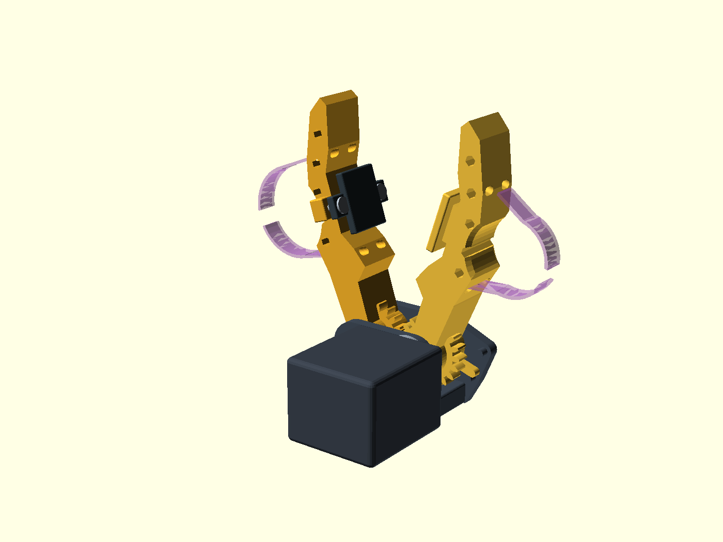
Two Finger Gripper/versions/v003_single_pincher/previews/single_pincher.png
