JacobSchantz/HelpingHands/Two Finger Gripper/versions/v004_symmetric_pincher/previews/finger_channel.png

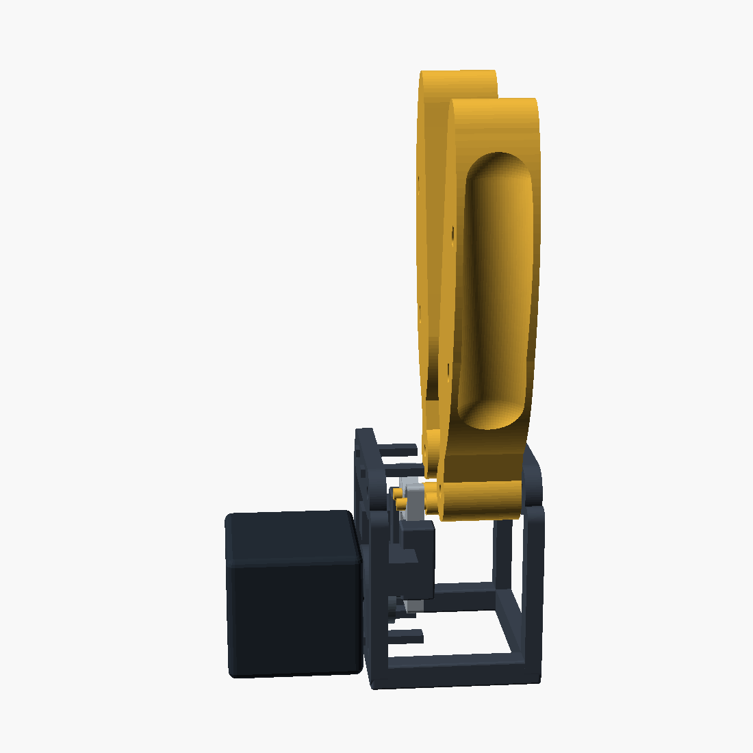
Two Finger Gripper/versions/v004_symmetric_pincher/previews/finger_channel.png
