JacobSchantz/HelpingHands/Two Finger Gripper/versions/v005_mirrored_gears/previews/closed.png

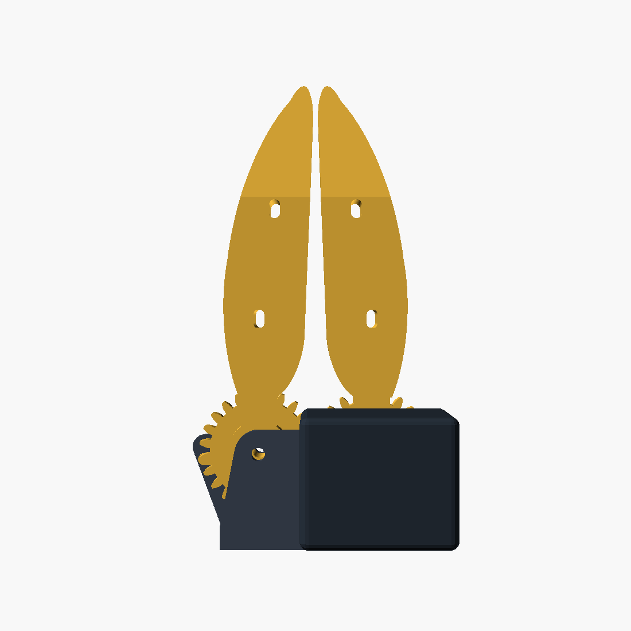
Two Finger Gripper/versions/v005_mirrored_gears/previews/closed.png
