JacobSchantz/HelpingHands/Two Finger Gripper/versions/v005_mirrored_gears/previews/mirrored_gears.png

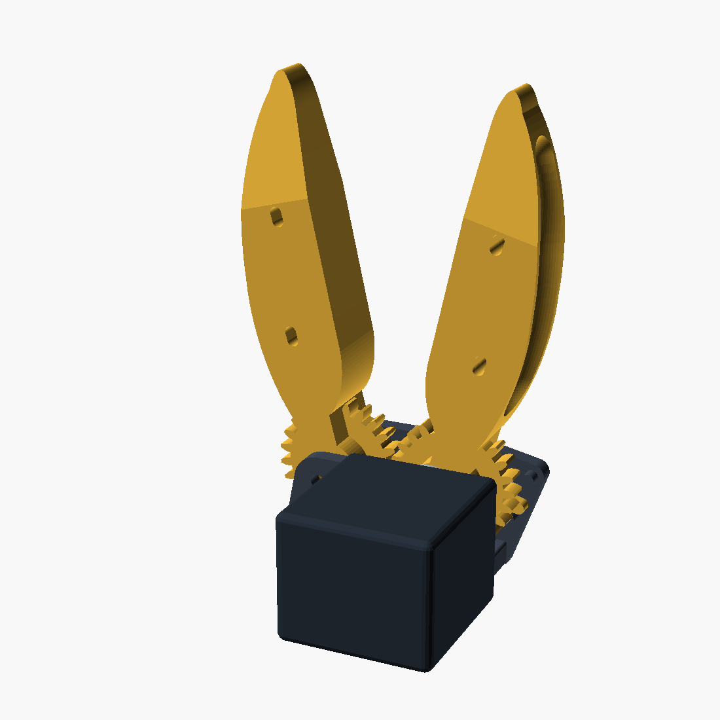
Two Finger Gripper/versions/v005_mirrored_gears/previews/mirrored_gears.png
