JacobSchantz/HelpingHands/Two Finger Gripper/versions/v007_generalist_fingers/previews/iso.png

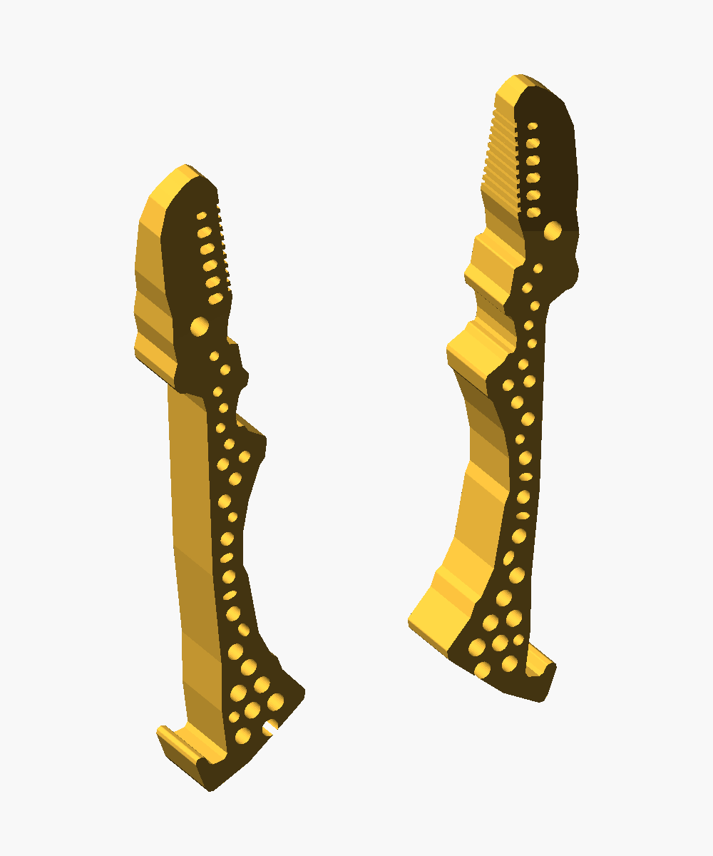
Two Finger Gripper/versions/v007_generalist_fingers/previews/iso.png
