JacobSchantz/HelpingHands/Two Finger Gripper/versions/v007_generalist_fingers/rounds/r1_hand_trace/compare_target.png

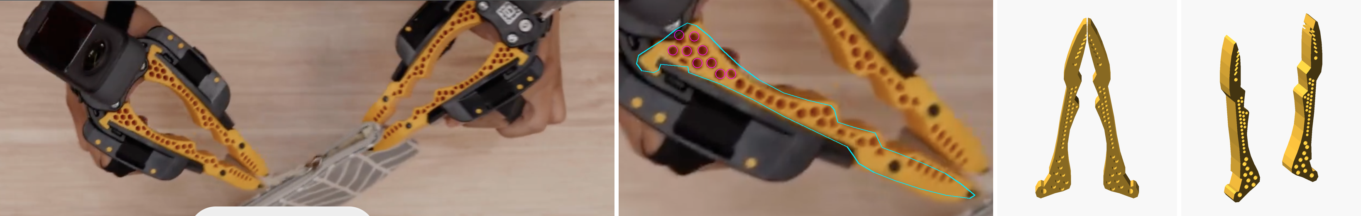
Two Finger Gripper/versions/v007_generalist_fingers/rounds/r1_hand_trace/compare_target.png
