JacobSchantz/HelpingHands/Two Finger Gripper/versions/v007_generalist_fingers/rounds/r4_wedge_tip/zoom_model_blade.png

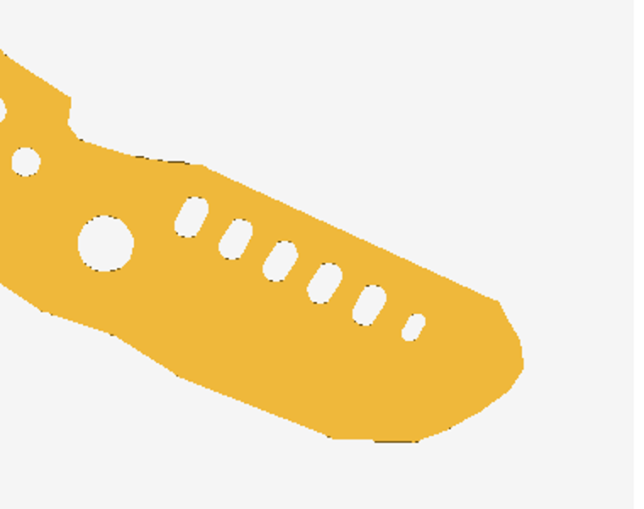
Two Finger Gripper/versions/v007_generalist_fingers/rounds/r4_wedge_tip/zoom_model_blade.png
