JacobSchantz/HelpingHands/Two Finger Gripper/versions/v008_pollen_grabette/previews/drive.png

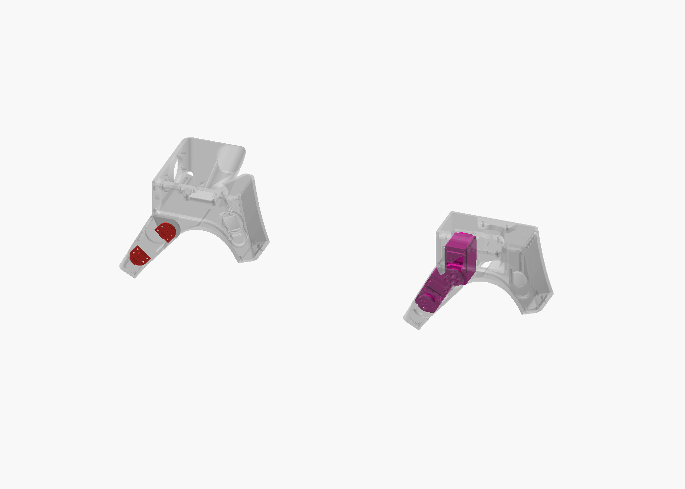
Two Finger Gripper/versions/v008_pollen_grabette/previews/drive.png
