JacobSchantz/HelpingHands/Two Finger Gripper/versions/v008_pollen_grabette/previews/iso.png

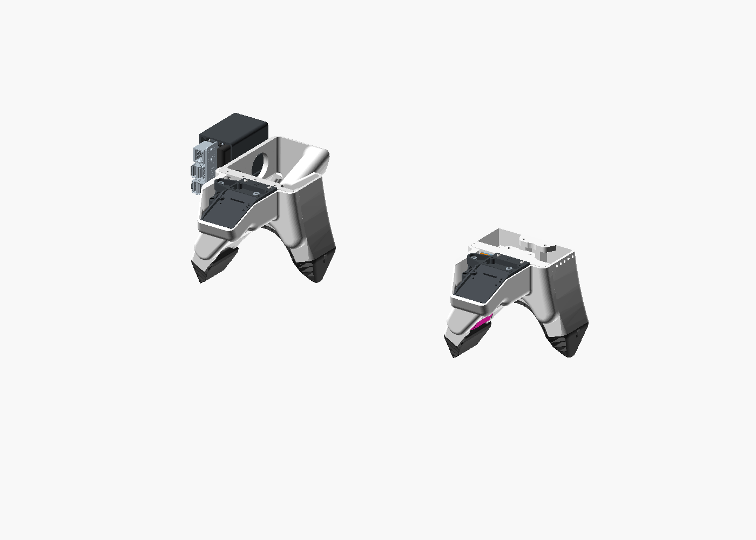
Two Finger Gripper/versions/v008_pollen_grabette/previews/iso.png
