JacobSchantz/HelpingHands/Two Finger Gripper/versions/v009_generalist_fingers_sonnet/rounds/r2_needle_tip/open.png

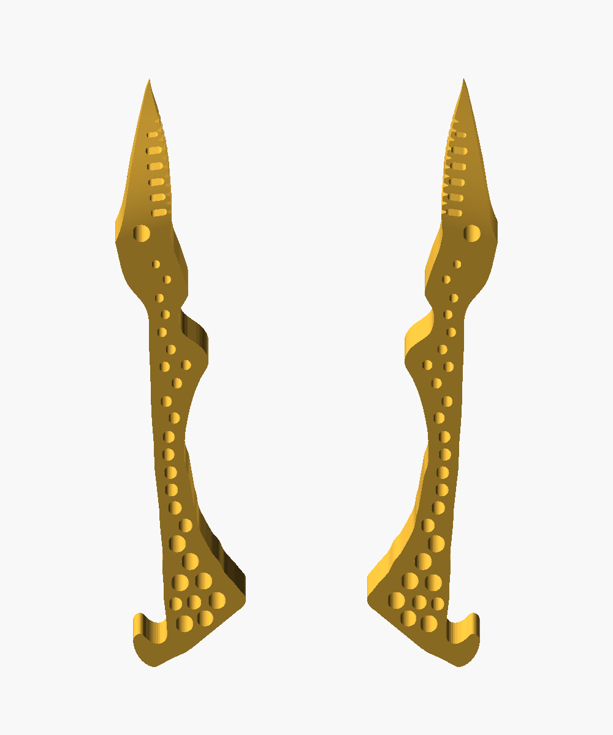
Two Finger Gripper/versions/v009_generalist_fingers_sonnet/rounds/r2_needle_tip/open.png
