JacobSchantz/HelpingHands/Two Finger Gripper/versions/v011b_generalist_fingers_astra/rounds/a1_chisel_beak/finger.png

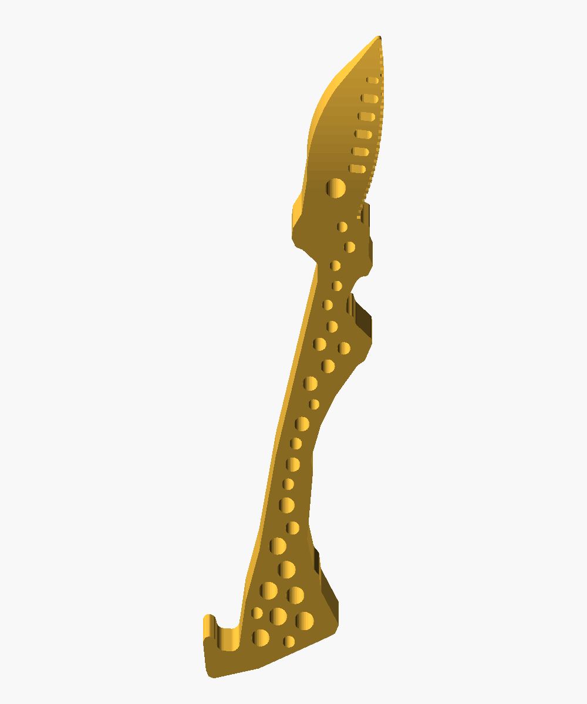
Two Finger Gripper/versions/v011b_generalist_fingers_astra/rounds/a1_chisel_beak/finger.png
