JacobSchantz/HelpingHands/Two Finger Gripper/versions/v013_generalist_closed_beak/closed_sketch.png

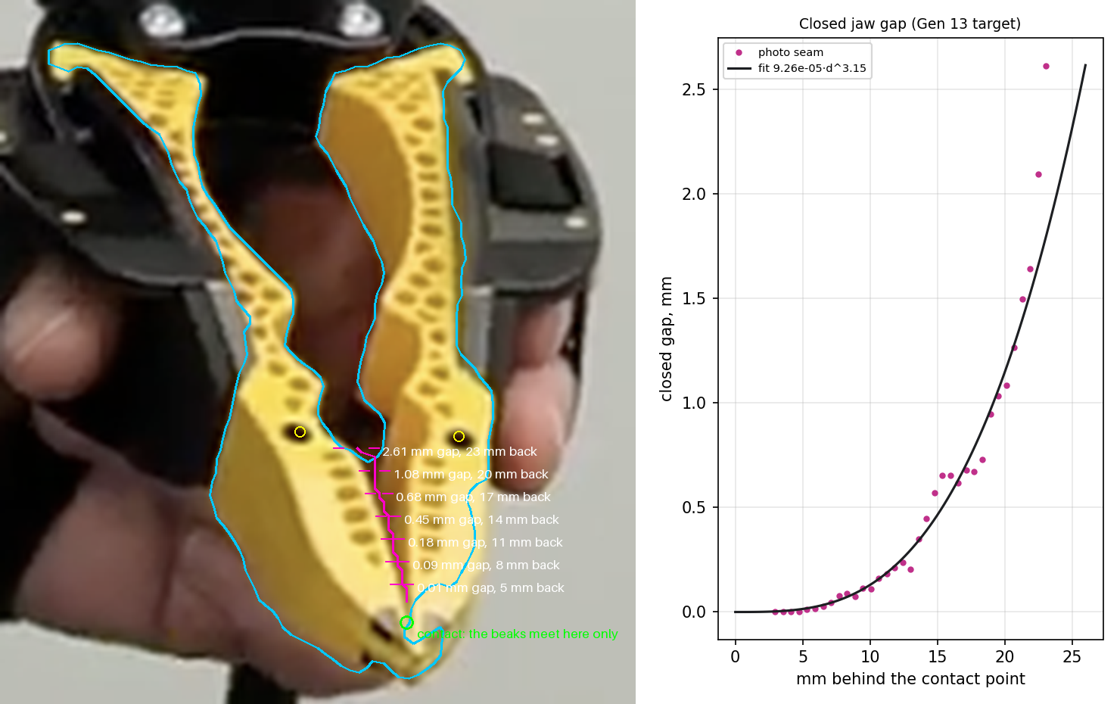
Two Finger Gripper/versions/v013_generalist_closed_beak/closed_sketch.png
