JacobSchantz/HelpingHands/Two Finger Gripper/versions/v015_generalist_long_jaw/previews/compare_gen14.png

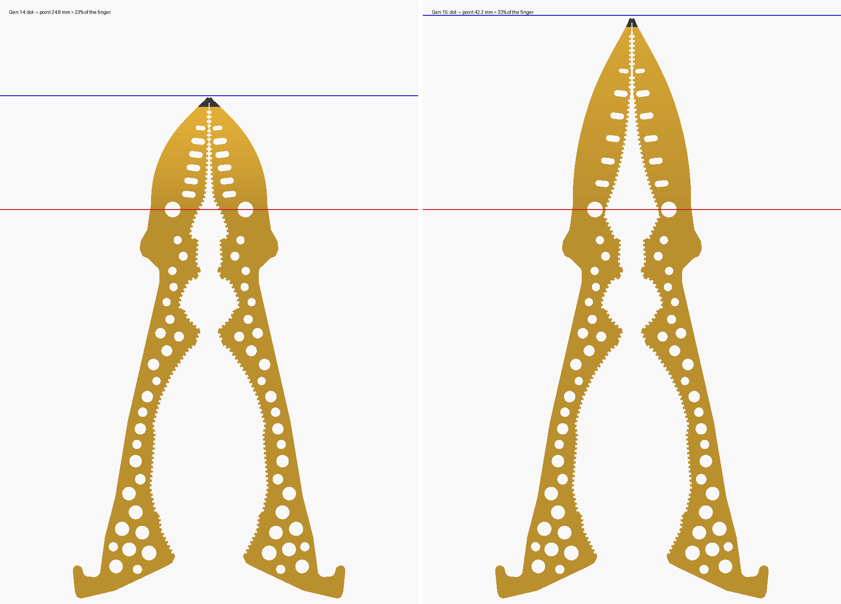
Two Finger Gripper/versions/v015_generalist_long_jaw/previews/compare_gen14.png
