JacobSchantz/HelpingHands/Two Finger Gripper/versions/v015_generalist_long_jaw/previews/open.png

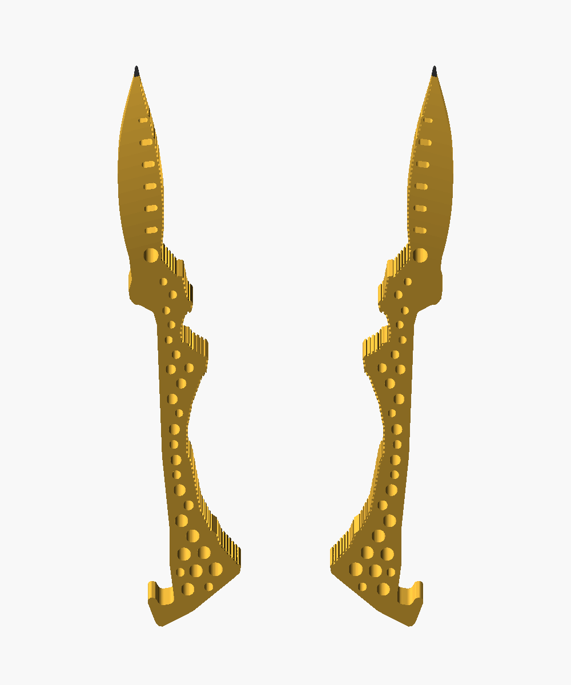
Two Finger Gripper/versions/v015_generalist_long_jaw/previews/open.png
