JacobSchantz/HelpingHands/Two Finger Gripper/versions/v016_generalist_rounded_point/previews/closed.png

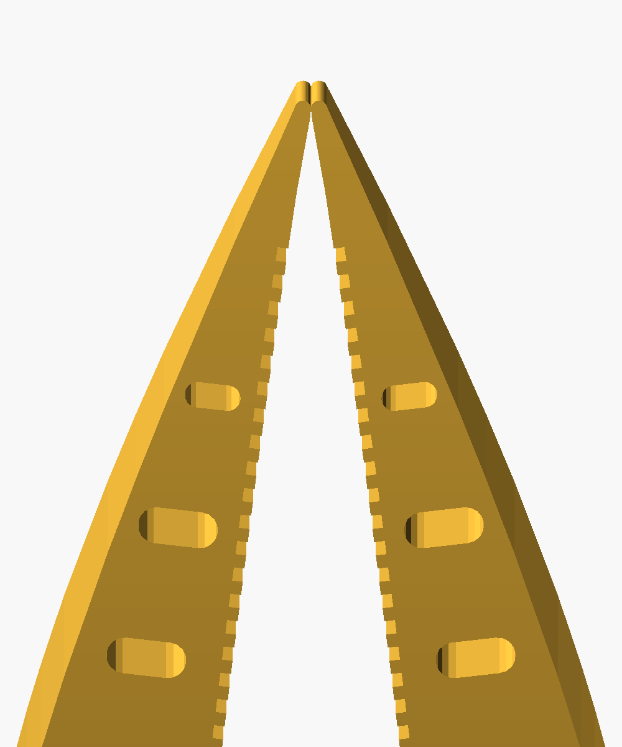
Two Finger Gripper/versions/v016_generalist_rounded_point/previews/closed.png
