JacobSchantz/HelpingHands/Two Finger Gripper/versions/v016_generalist_rounded_point/previews/compare_closed_photo.png

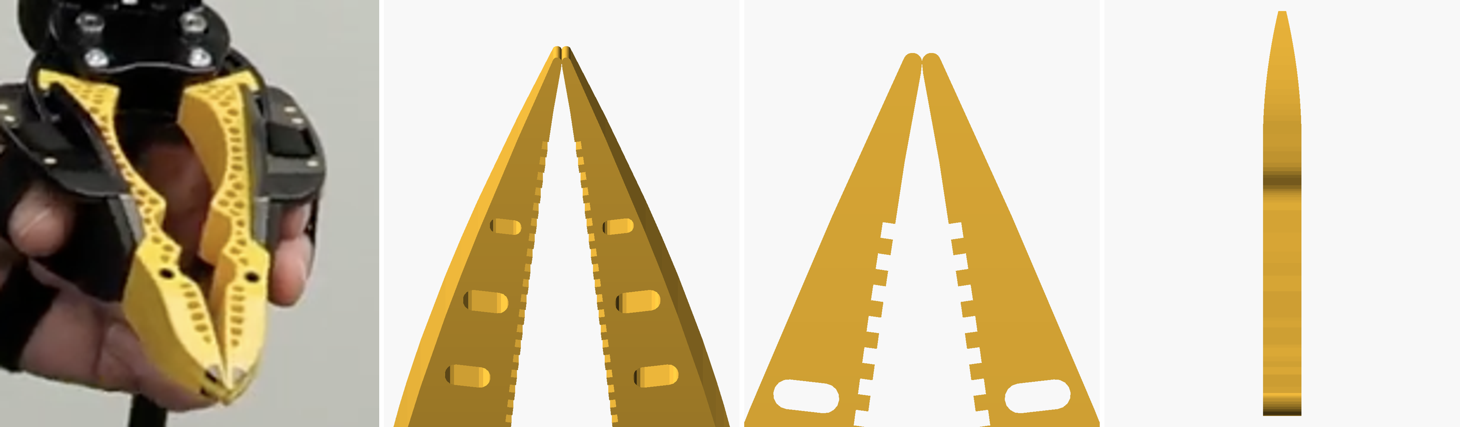
Two Finger Gripper/versions/v016_generalist_rounded_point/previews/compare_closed_photo.png
