JacobSchantz/HelpingHands/Two Finger Gripper/versions/v016_generalist_rounded_point/previews/compare_web_stl.png

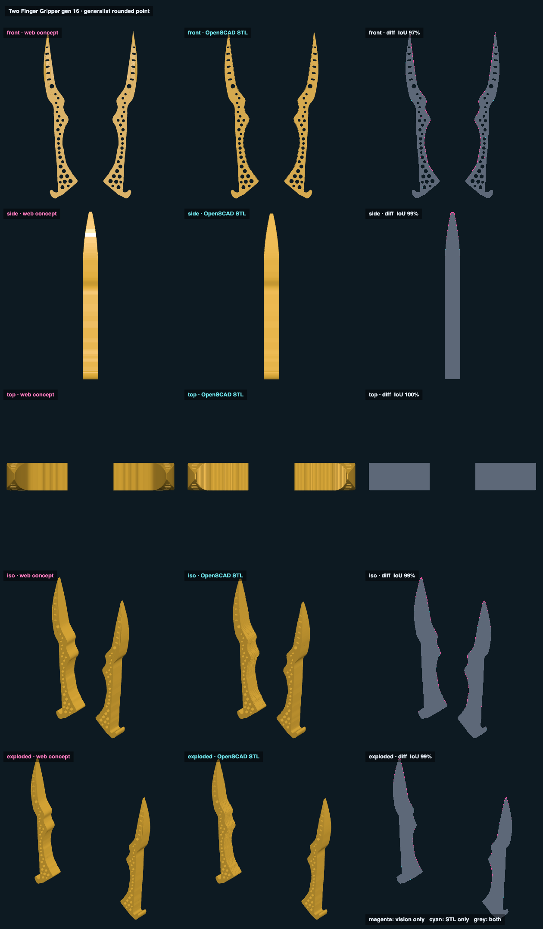
Two Finger Gripper/versions/v016_generalist_rounded_point/previews/compare_web_stl.png
