JacobSchantz/HelpingHands/Two Finger Gripper/versions/v016_generalist_rounded_point/previews/edge.png

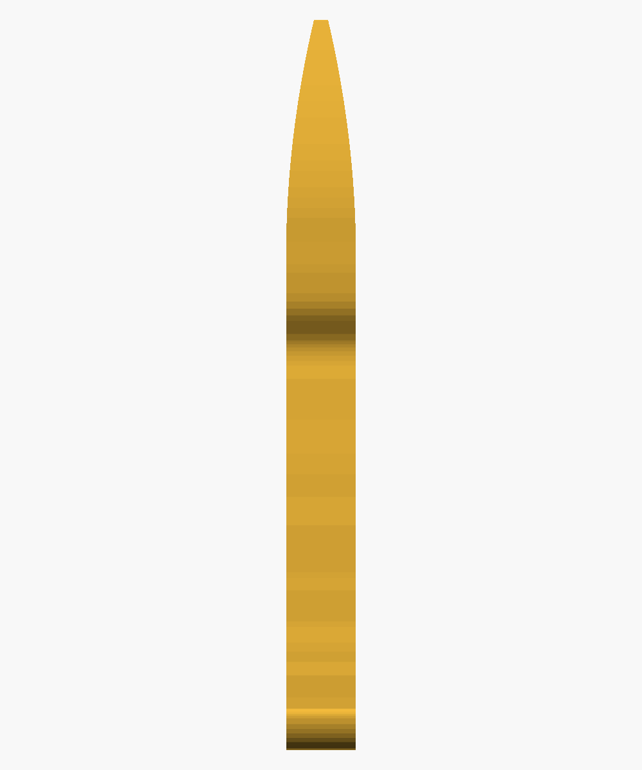
Two Finger Gripper/versions/v016_generalist_rounded_point/previews/edge.png
