JacobSchantz/HelpingHands/Two Finger Gripper/versions/v017_generalist_strap_slide/previews/slide.png

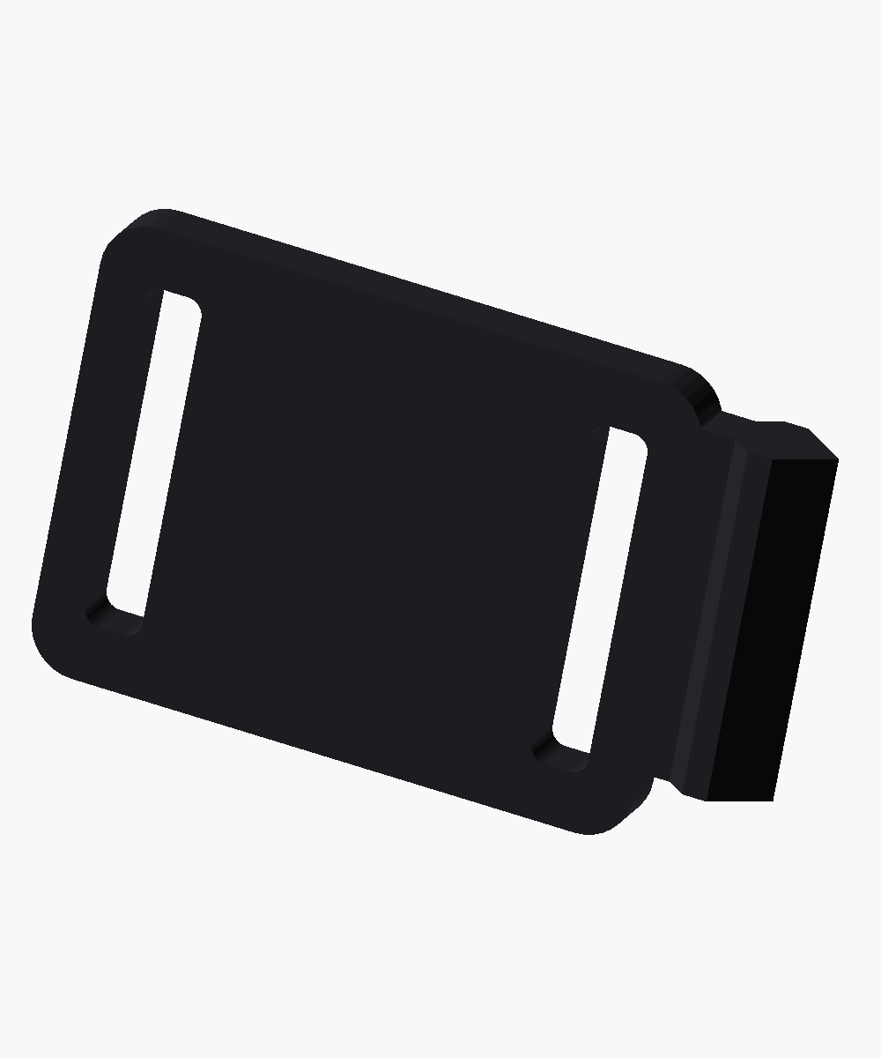
Two Finger Gripper/versions/v017_generalist_strap_slide/previews/slide.png
