JacobSchantz/HelpingHands/Two Finger Gripper/versions/v020_generalist_double_hook/previews/handle_sliding.png

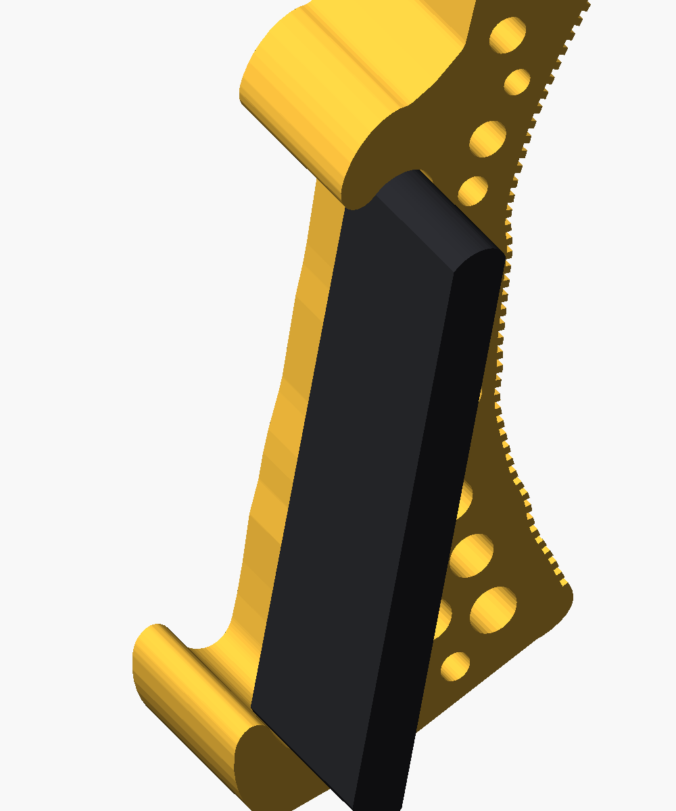
Two Finger Gripper/versions/v020_generalist_double_hook/previews/handle_sliding.png
