JacobSchantz/HelpingHands/Two Finger Gripper/versions/v020_generalist_double_hook/previews/hooks.png

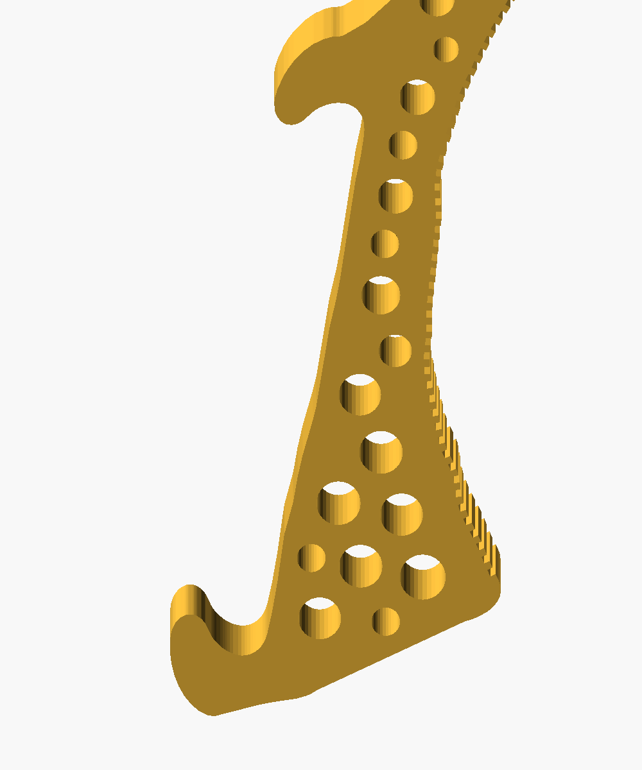
Two Finger Gripper/versions/v020_generalist_double_hook/previews/hooks.png
