JacobSchantz/HelpingHands/Two Finger Gripper/versions/v020_generalist_double_hook/previews/top.png

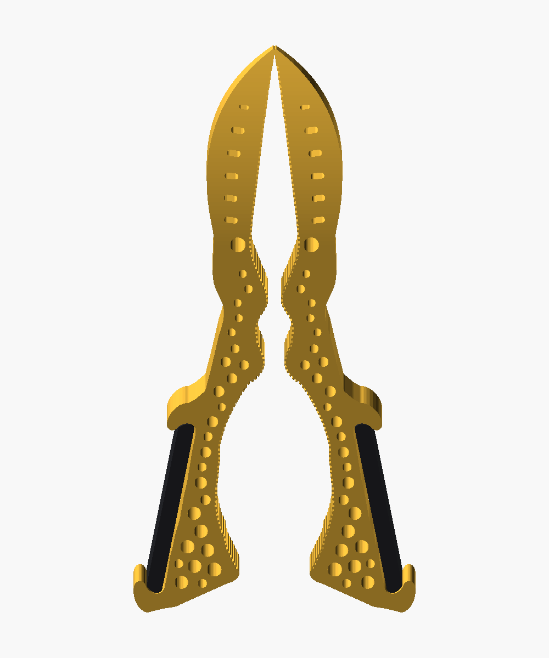
Two Finger Gripper/versions/v020_generalist_double_hook/previews/top.png
