JacobSchantz/HelpingHands/Two Finger Gripper/versions/v202_generalist_flush_loops/previews/slide.png

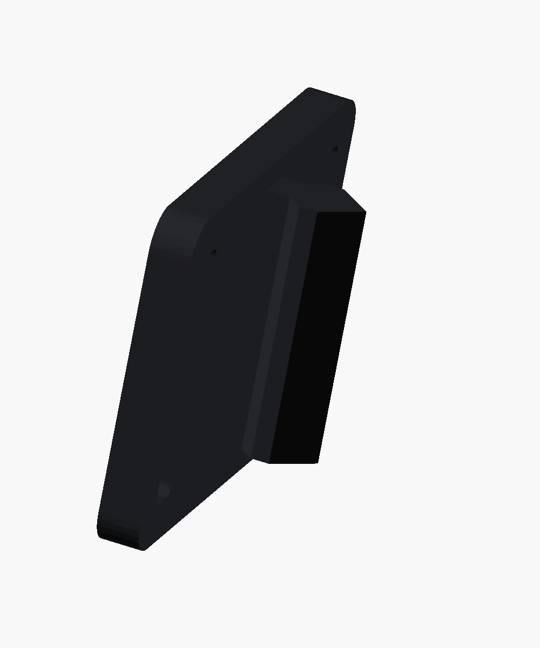
Two Finger Gripper/versions/v202_generalist_flush_loops/previews/slide.png
