JacobSchantz/HelpingHands/Two Finger Gripper/versions/v202_generalist_flush_loops/previews/slides.png

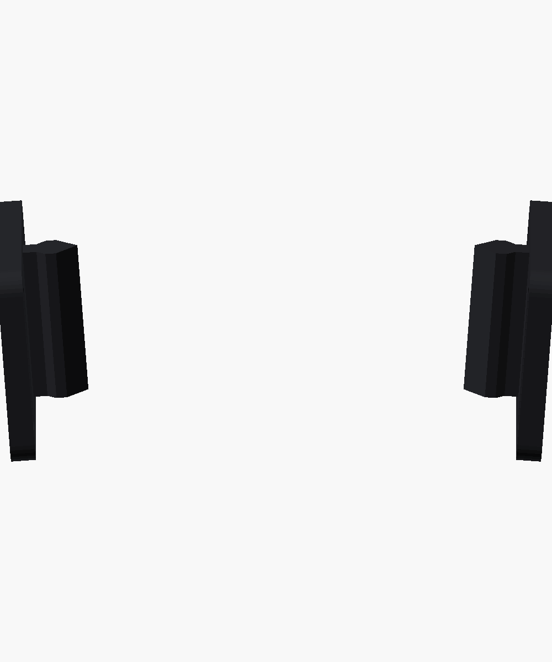
Two Finger Gripper/versions/v202_generalist_flush_loops/previews/slides.png
