JacobSchantz/HelpingHands/Two Finger Gripper/versions/v203_generalist_tongue_pocket/previews/slide_fit.png

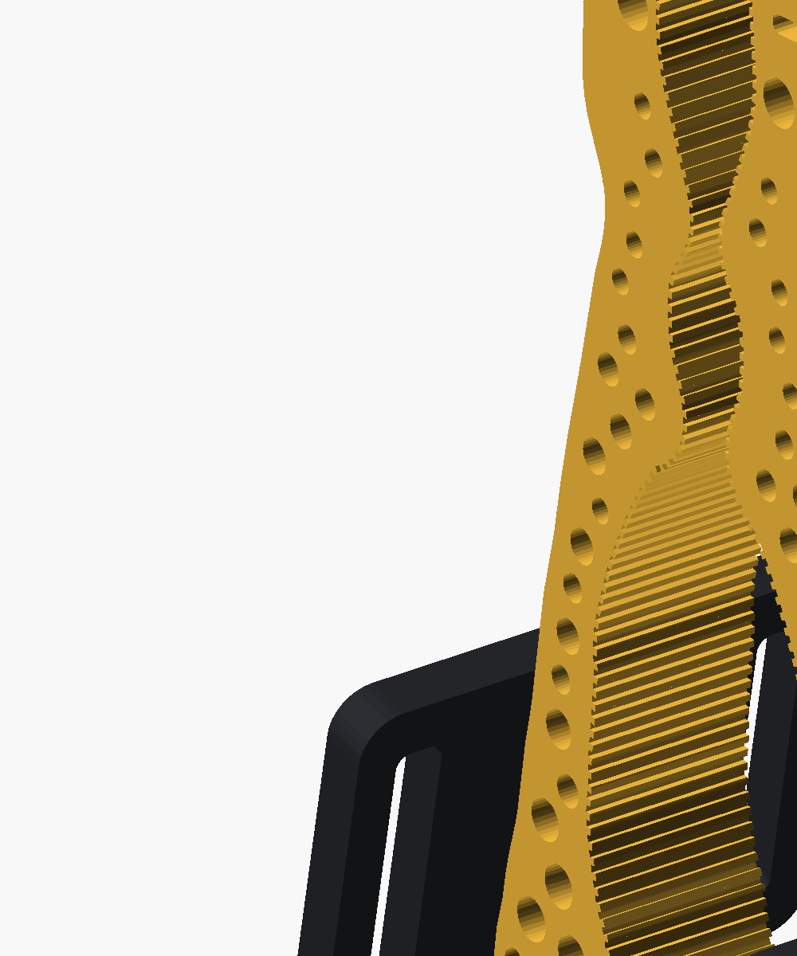
Two Finger Gripper/versions/v203_generalist_tongue_pocket/previews/slide_fit.png
