JacobSchantz/HelpingHands/Two Finger Gripper/versions/v204_generalist_parametric/previews/pocket.png

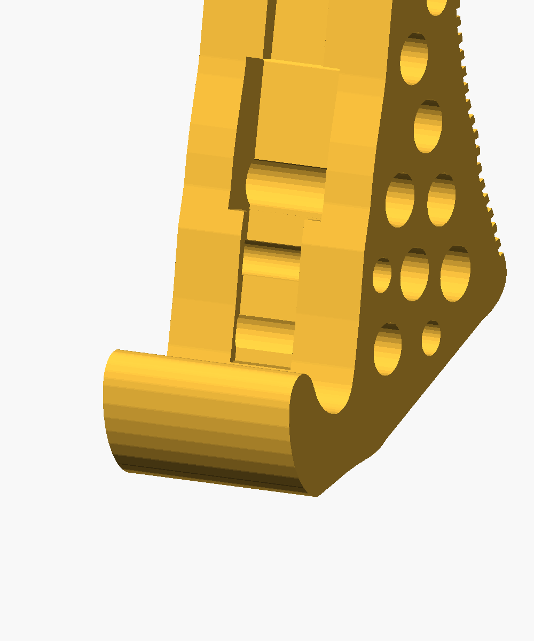
Two Finger Gripper/versions/v204_generalist_parametric/previews/pocket.png
