JacobSchantz/HelpingHands/Two Finger Gripper/versions/v205_generalist_spanning_handle/previews/compare_web_stl.png

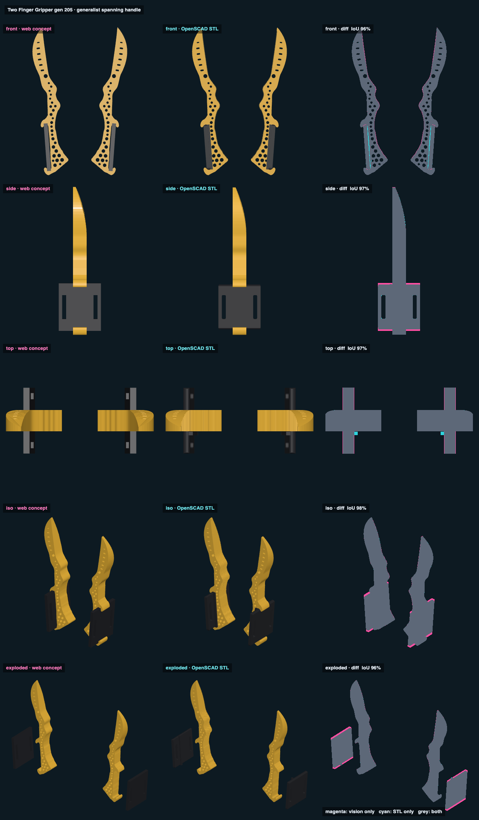
Two Finger Gripper/versions/v205_generalist_spanning_handle/previews/compare_web_stl.png
