JacobSchantz/HelpingHands/Two Finger Gripper/versions/v205_generalist_spanning_handle/previews/handle_sliding.png

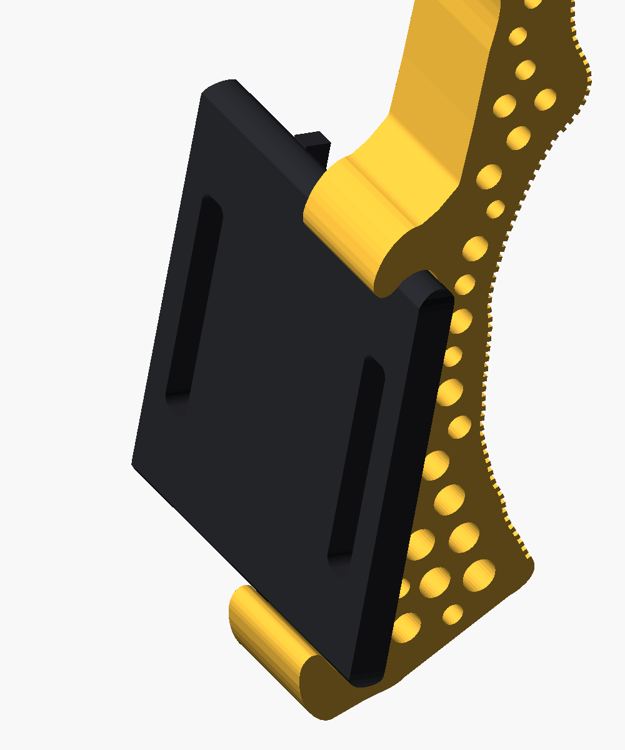
Two Finger Gripper/versions/v205_generalist_spanning_handle/previews/handle_sliding.png
