JacobSchantz/HelpingHands/Two Finger Gripper/versions/v205_generalist_spanning_handle/previews/slides.png

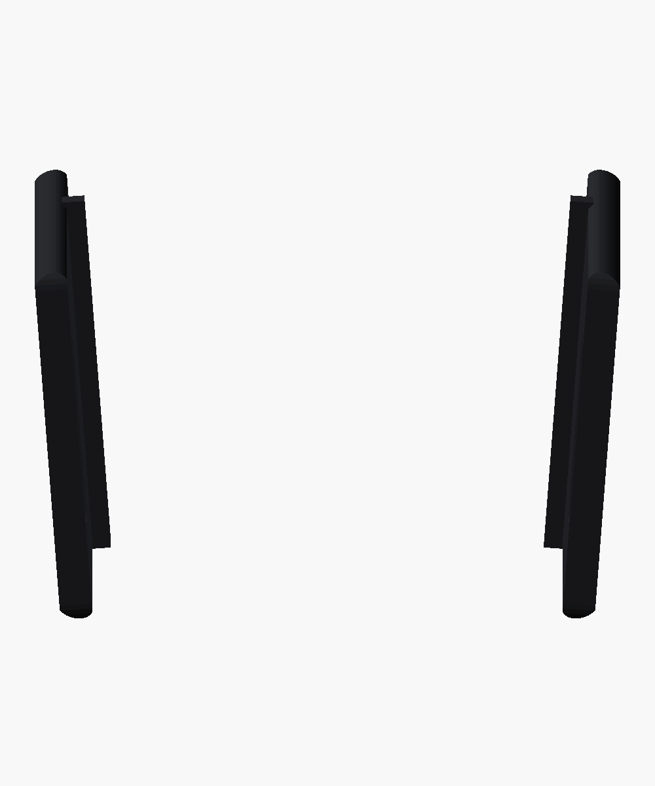
Two Finger Gripper/versions/v205_generalist_spanning_handle/previews/slides.png
