JacobSchantz/HelpingHands/Two Finger Gripper/versions/v207_generalist_flush_handle/previews/handle_sliding.png

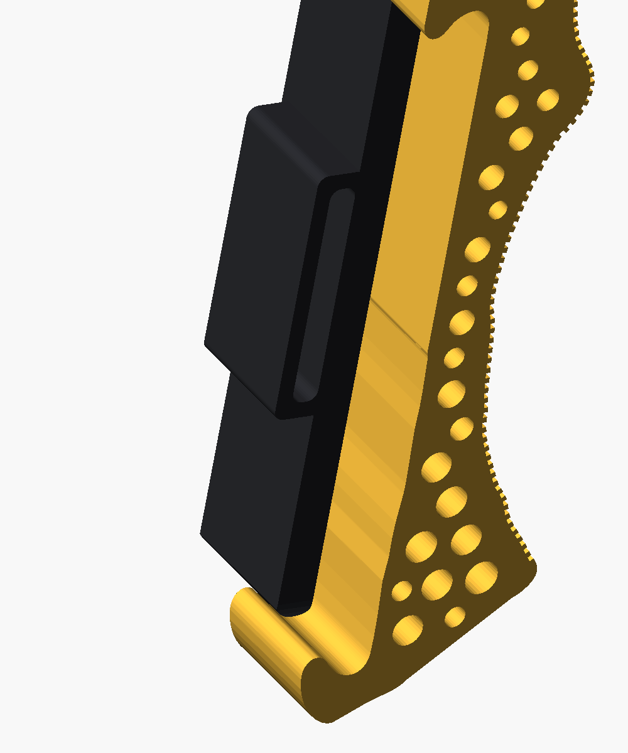
Two Finger Gripper/versions/v207_generalist_flush_handle/previews/handle_sliding.png
