JacobSchantz/HelpingHands/Two Finger Gripper/versions/v207_generalist_flush_handle/previews/slide.png

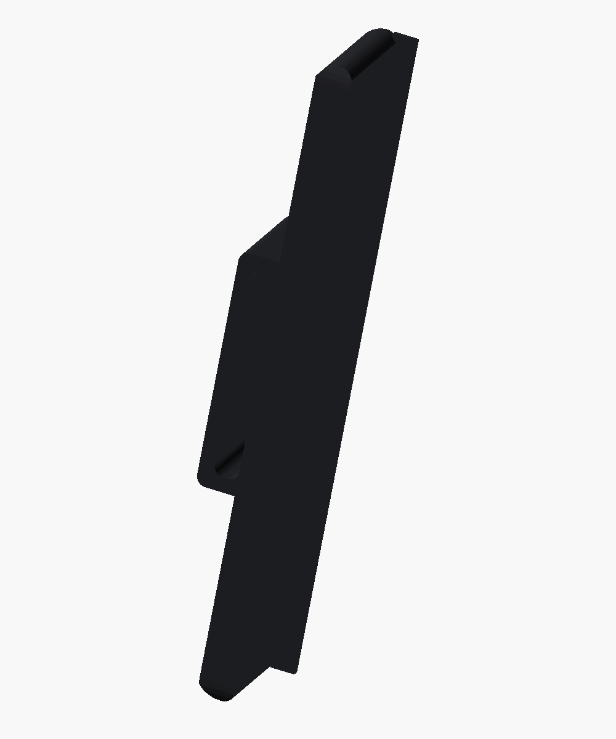
Two Finger Gripper/versions/v207_generalist_flush_handle/previews/slide.png
