JacobSchantz/HelpingHands/Two Finger Gripper/versions/v301_generalist_base/previews/arm.png

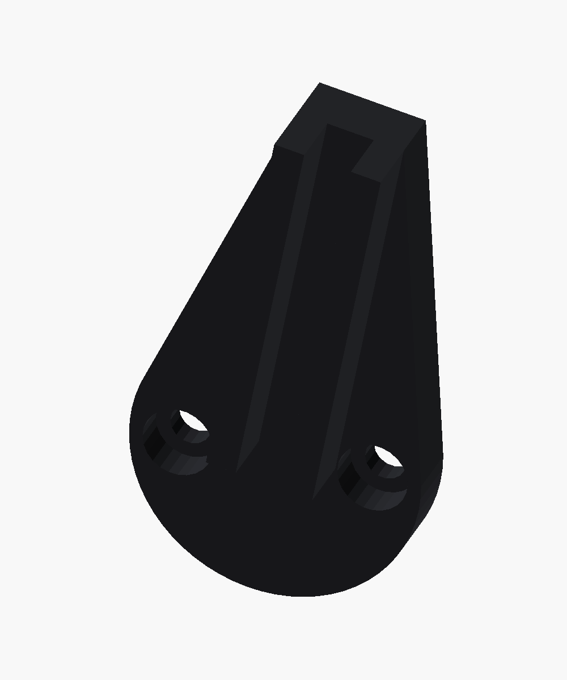
Two Finger Gripper/versions/v301_generalist_base/previews/arm.png
