JacobSchantz/HelpingHands/Two Finger Gripper/versions/v301_generalist_base/previews/open.png

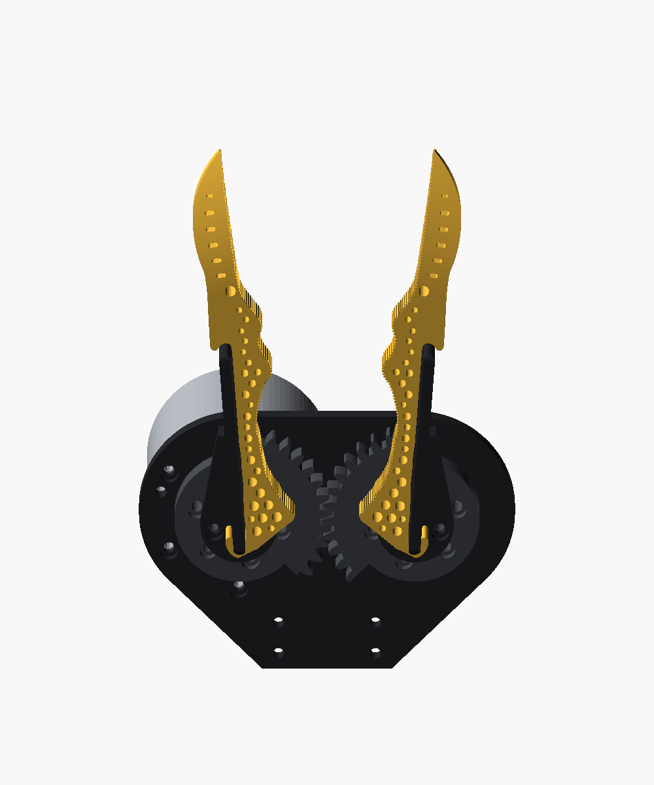
Two Finger Gripper/versions/v301_generalist_base/previews/open.png
