JacobSchantz/HelpingHands/Two Finger Gripper/versions/v302_generalist_simple/previews/base_plate.png

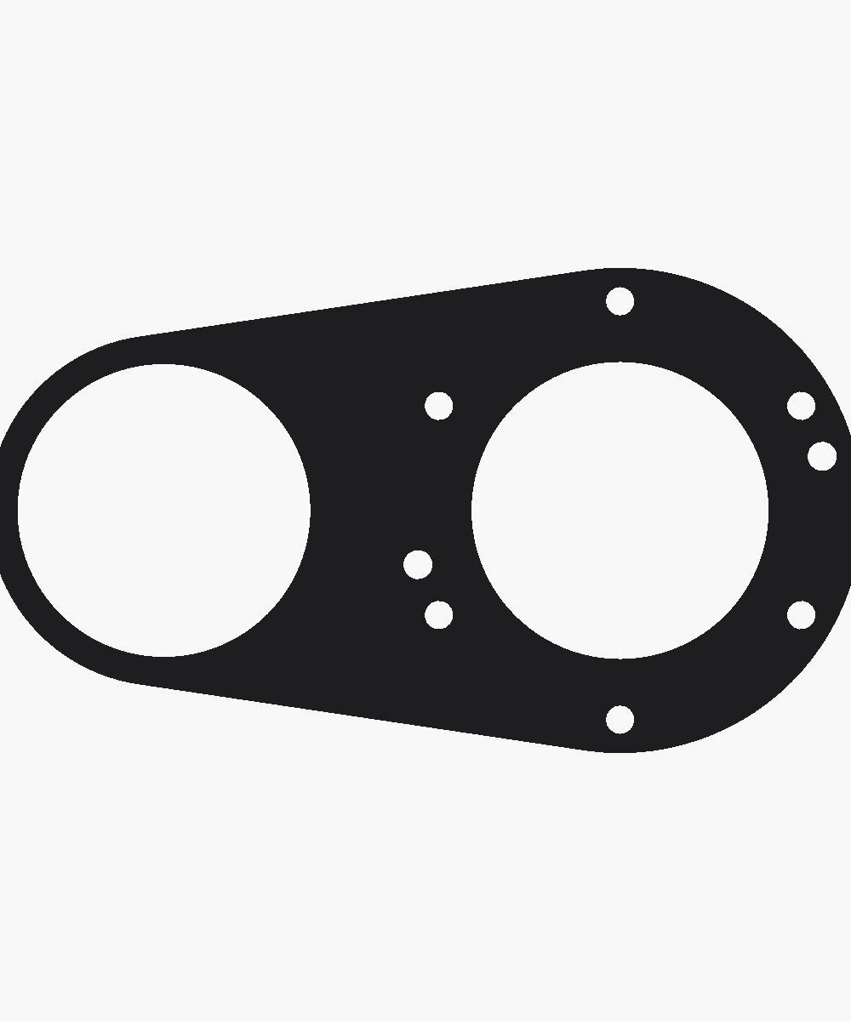
Two Finger Gripper/versions/v302_generalist_simple/previews/base_plate.png
