JacobSchantz/HelpingHands/Two Finger Gripper/versions/v302_generalist_simple/previews/handle_in.png

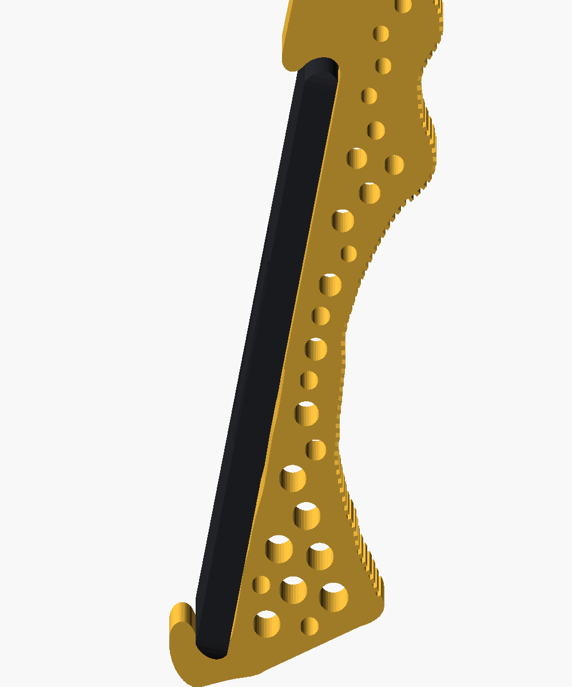
Two Finger Gripper/versions/v302_generalist_simple/previews/handle_in.png
