JacobSchantz/HelpingHands/Two Finger Gripper/versions/v302_generalist_simple/previews/open.png

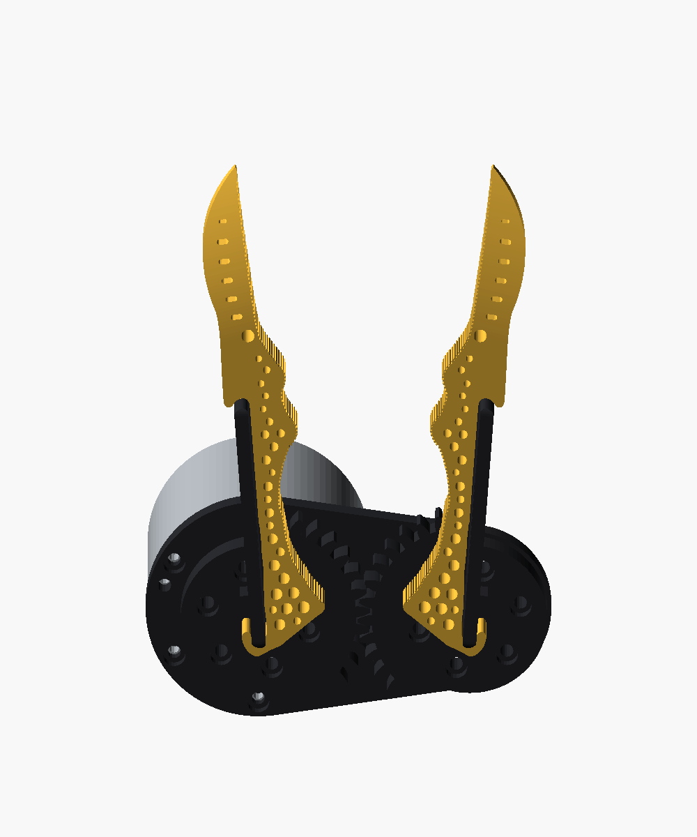
Two Finger Gripper/versions/v302_generalist_simple/previews/open.png
