JacobSchantz/HelpingHands/Two Finger Gripper/versions/v302_generalist_simple/previews/top.png

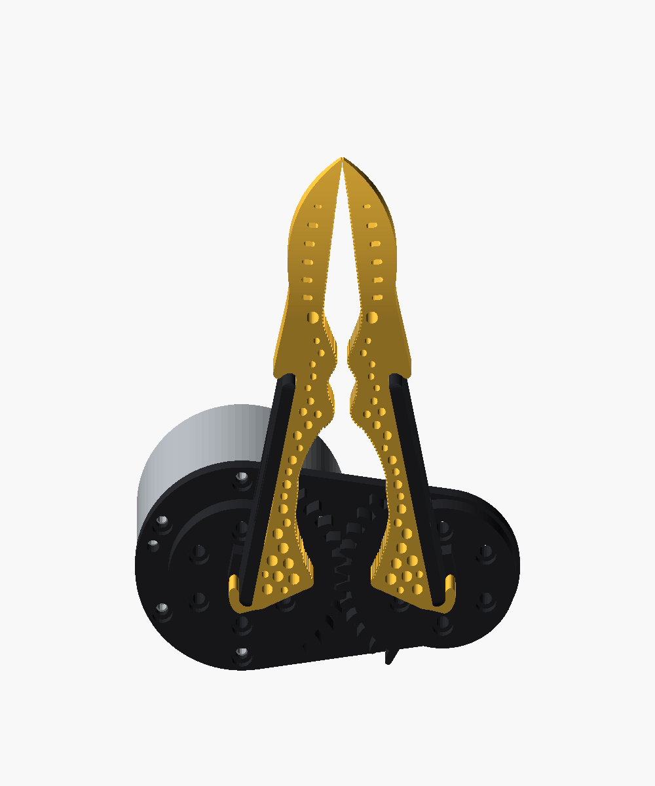
Two Finger Gripper/versions/v302_generalist_simple/previews/top.png
