JacobSchantz/HelpingHands/Two Finger Gripper/versions/v303_generalist_inplane/previews/compare_target.png

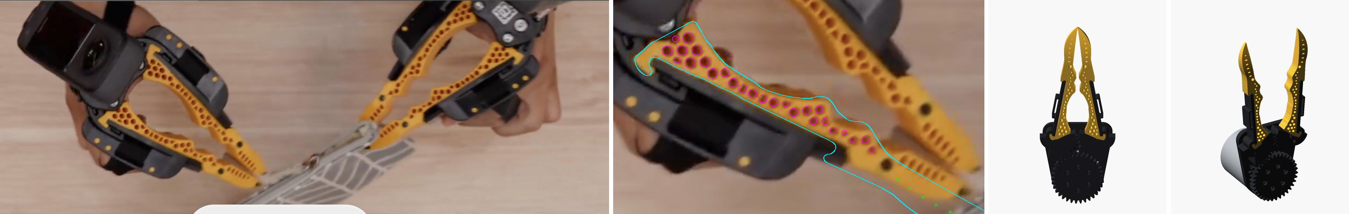
Two Finger Gripper/versions/v303_generalist_inplane/previews/compare_target.png
