JacobSchantz/HelpingHands/Two Finger Gripper/versions/v303_generalist_inplane/previews/gears.png

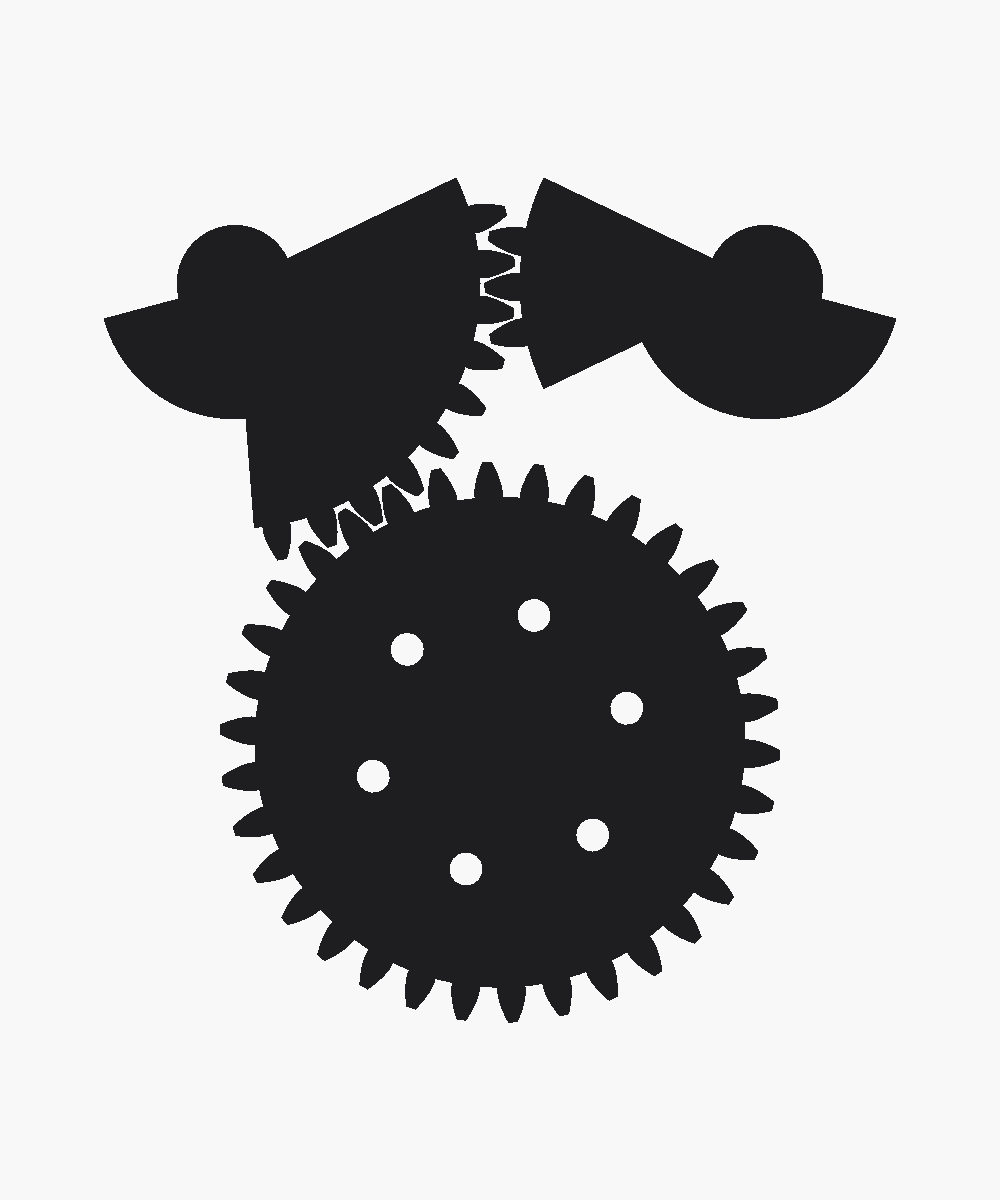
Two Finger Gripper/versions/v303_generalist_inplane/previews/gears.png
