JacobSchantz/HelpingHands/Two Finger Gripper/versions/v303_generalist_inplane/previews/top.png

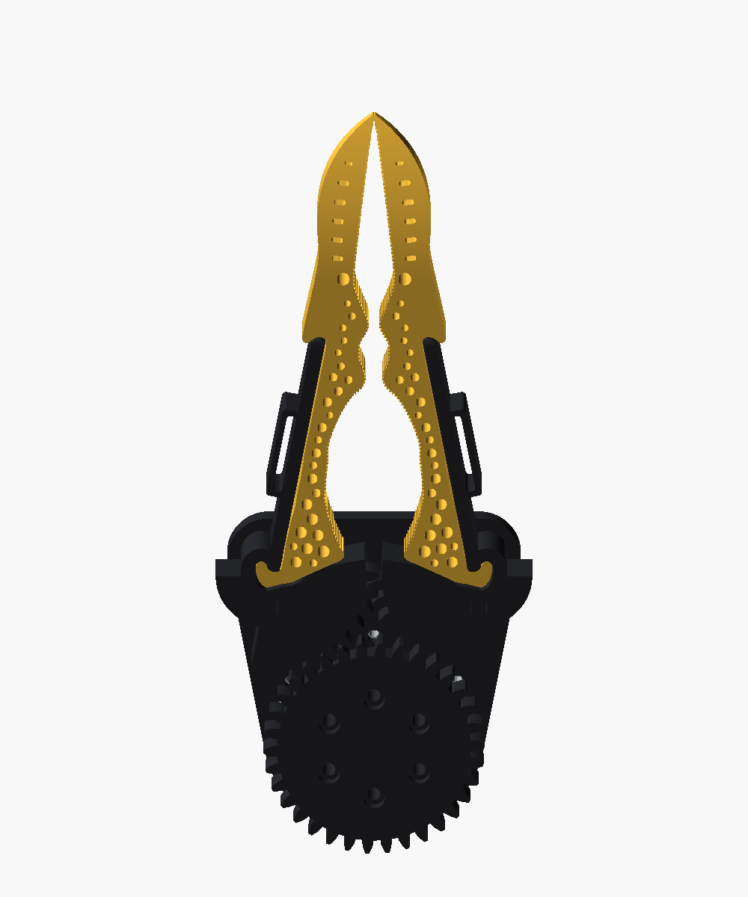
Two Finger Gripper/versions/v303_generalist_inplane/previews/top.png
