JacobSchantz/HelpingHands/Two Finger Gripper/versions/v304_generalist_one_piece_drive/previews/iso.png

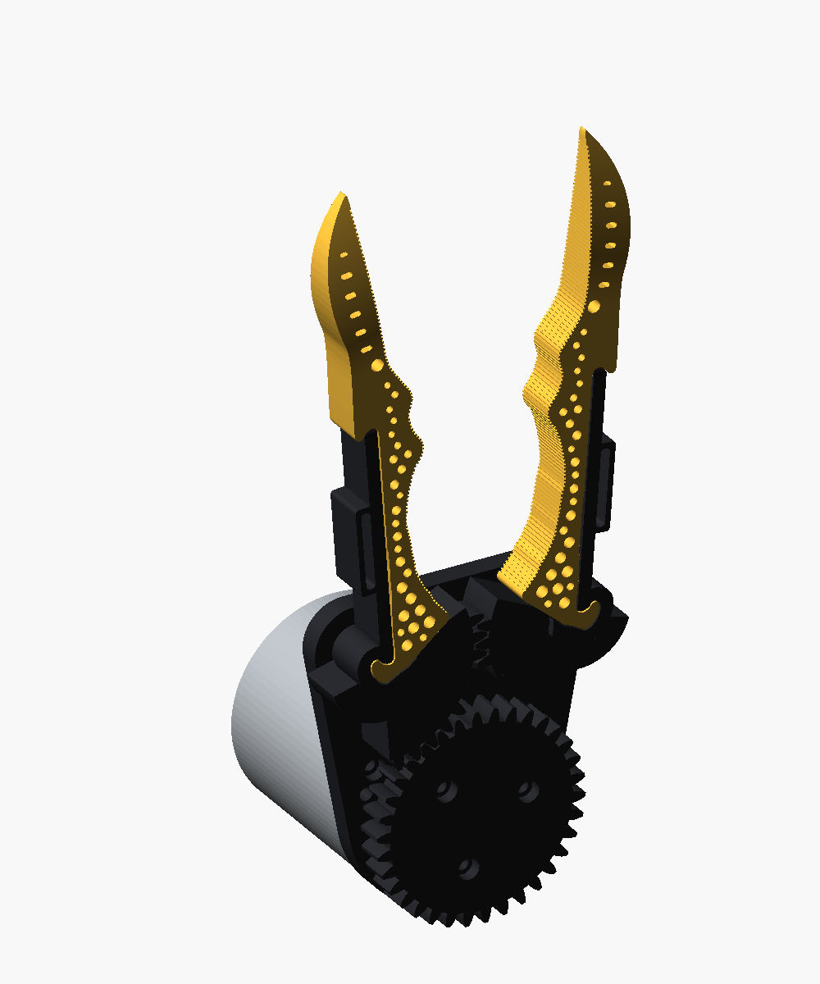
Two Finger Gripper/versions/v304_generalist_one_piece_drive/previews/iso.png
