JacobSchantz/HelpingHands/Two Finger Gripper/versions/v305_generalist_single_gear/previews/base_top.png

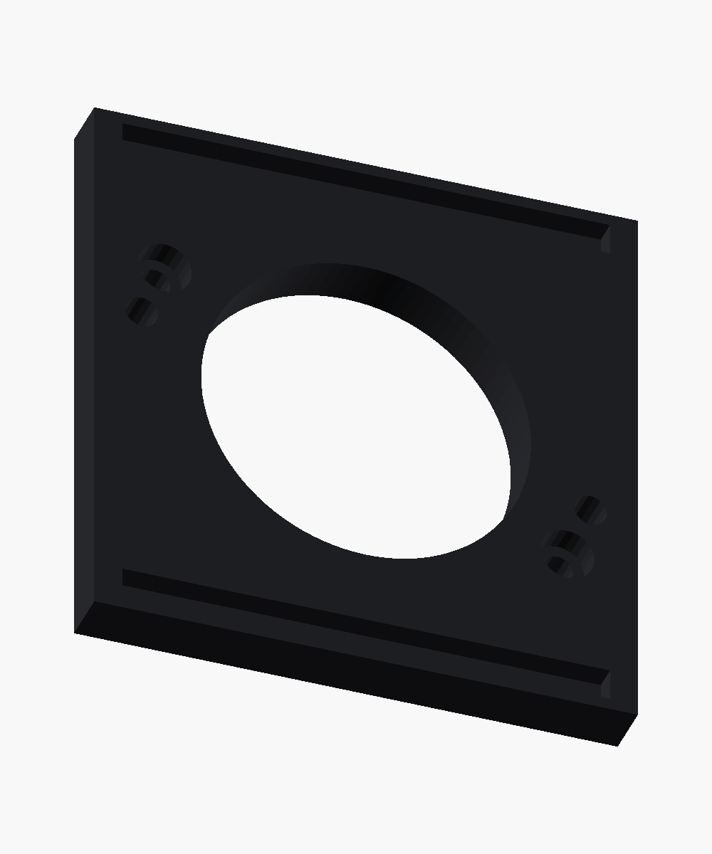
Two Finger Gripper/versions/v305_generalist_single_gear/previews/base_top.png
