JacobSchantz/HelpingHands/Two Finger Gripper/versions/v305_generalist_single_gear/previews/gears.png

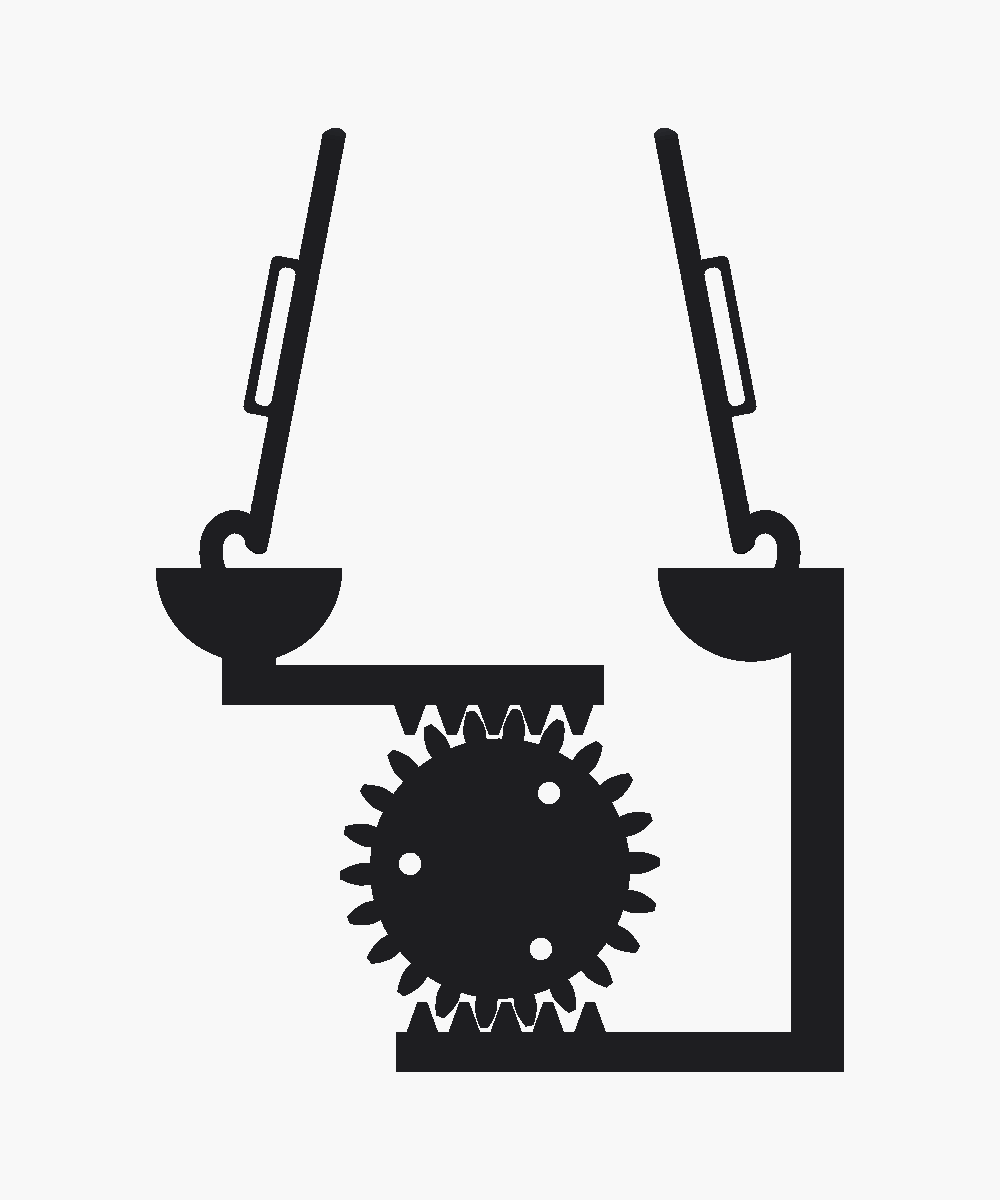
Two Finger Gripper/versions/v305_generalist_single_gear/previews/gears.png
