JacobSchantz/HelpingHands/Two Finger Gripper/versions/v309_generalist_top_plate/previews/open.png

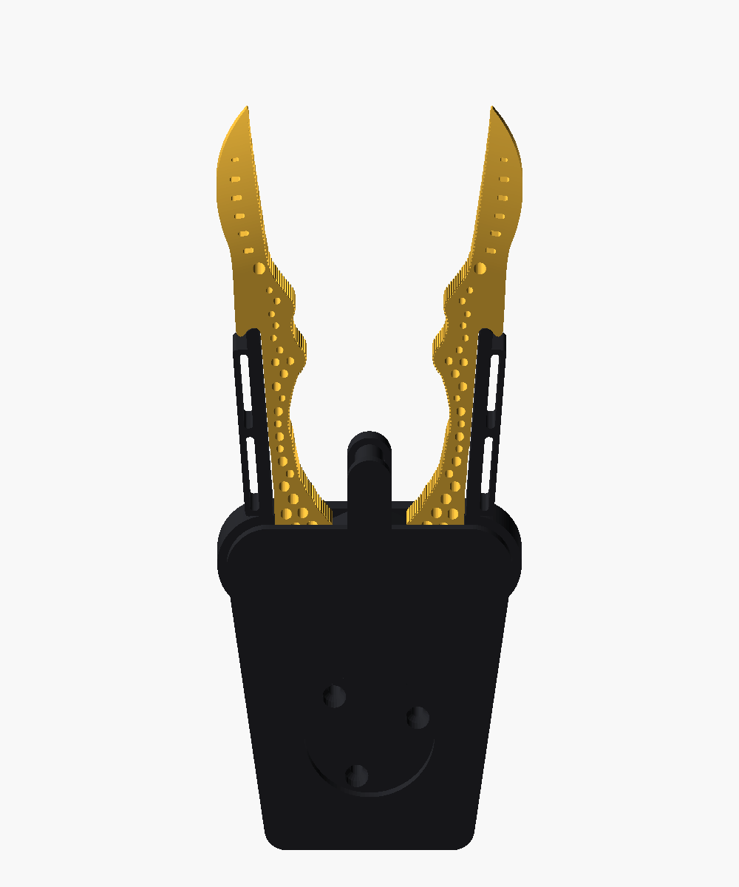
Two Finger Gripper/versions/v309_generalist_top_plate/previews/open.png
