JacobSchantz/HelpingHands/Two Finger Gripper/versions/v310_generalist_arm_mount/previews/open.png

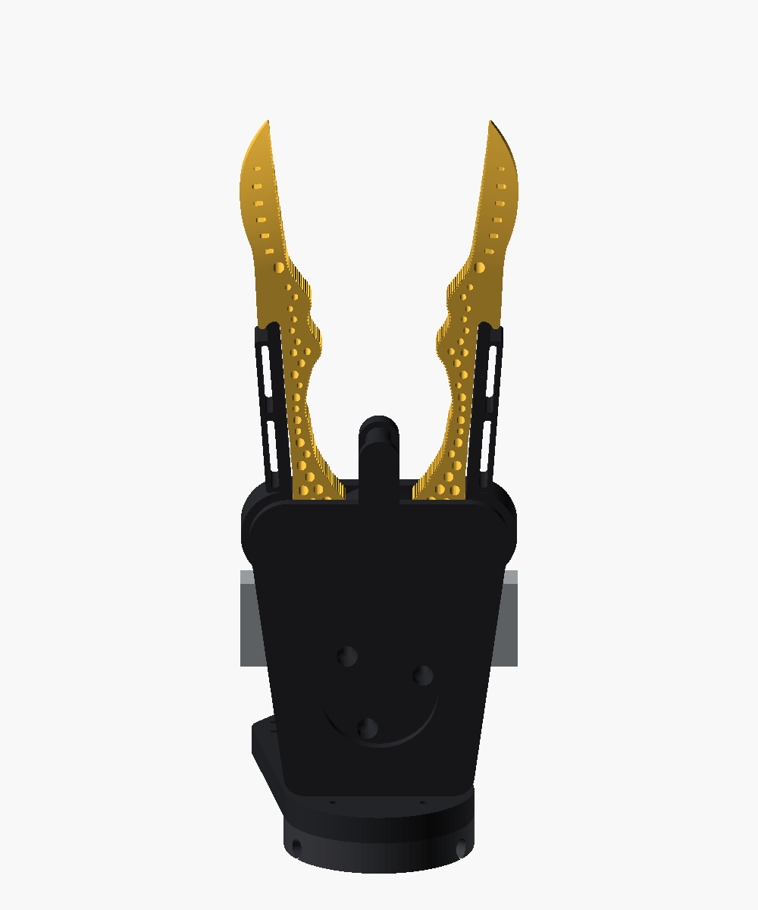
Two Finger Gripper/versions/v310_generalist_arm_mount/previews/open.png
