JacobSchantz/HelpingHands/Two Finger Gripper/versions/v311_generalist_motor_choice/previews/iso.png

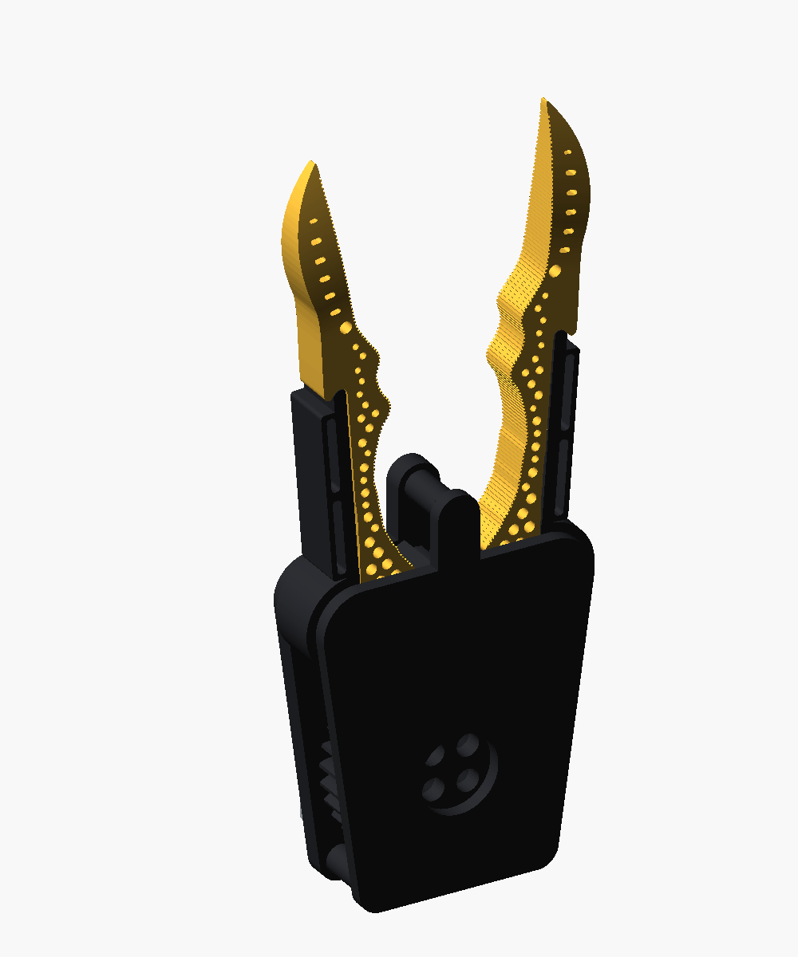
Two Finger Gripper/versions/v311_generalist_motor_choice/previews/iso.png
