JacobSchantz/HelpingHands/Two Finger Gripper/versions/v311_generalist_motor_choice/previews/strap_zones.png

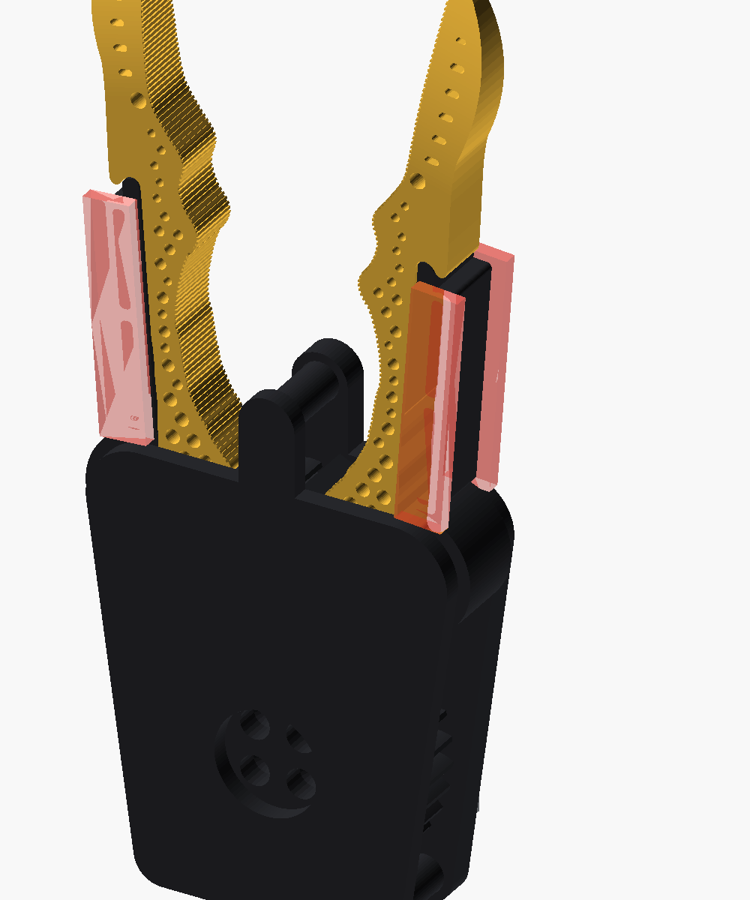
Two Finger Gripper/versions/v311_generalist_motor_choice/previews/strap_zones.png
