JacobSchantz/HelpingHands/Two Finger Gripper/versions/v312_generalist_compact_drive/previews/gears.png

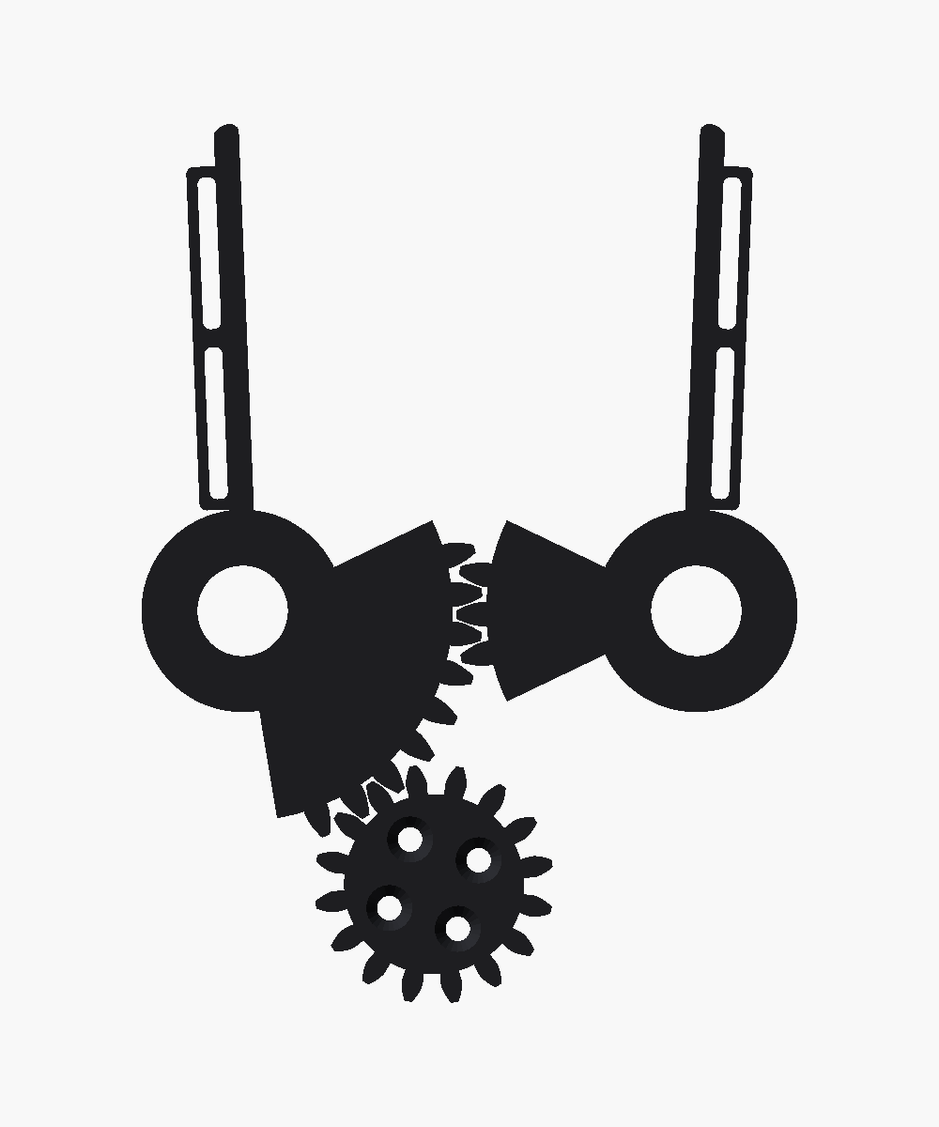
Two Finger Gripper/versions/v312_generalist_compact_drive/previews/gears.png
