JacobSchantz/HelpingHands/Two Finger Gripper/versions/v313_generalist_aero_full_hand/previews/tip.png

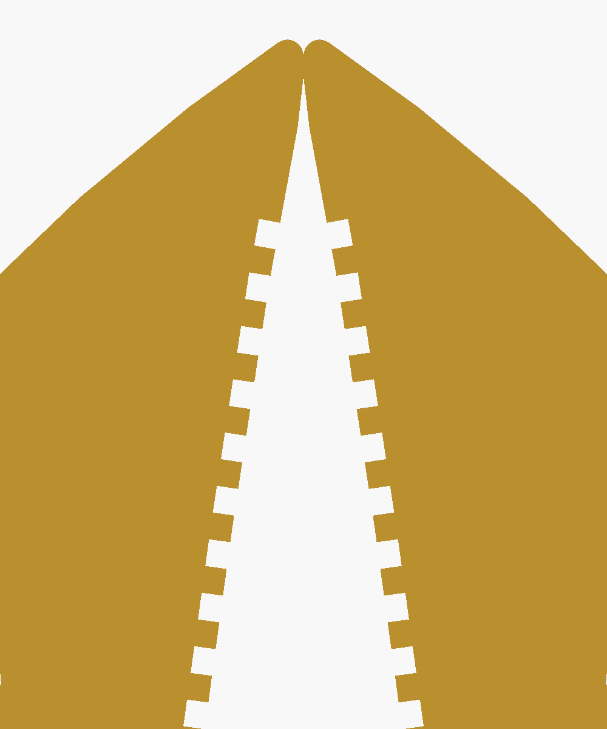
Two Finger Gripper/versions/v313_generalist_aero_full_hand/previews/tip.png
