JacobSchantz/HelpingHands/Two Finger Gripper/versions/v314_generalist_sts_arm_mount/previews/iso.png

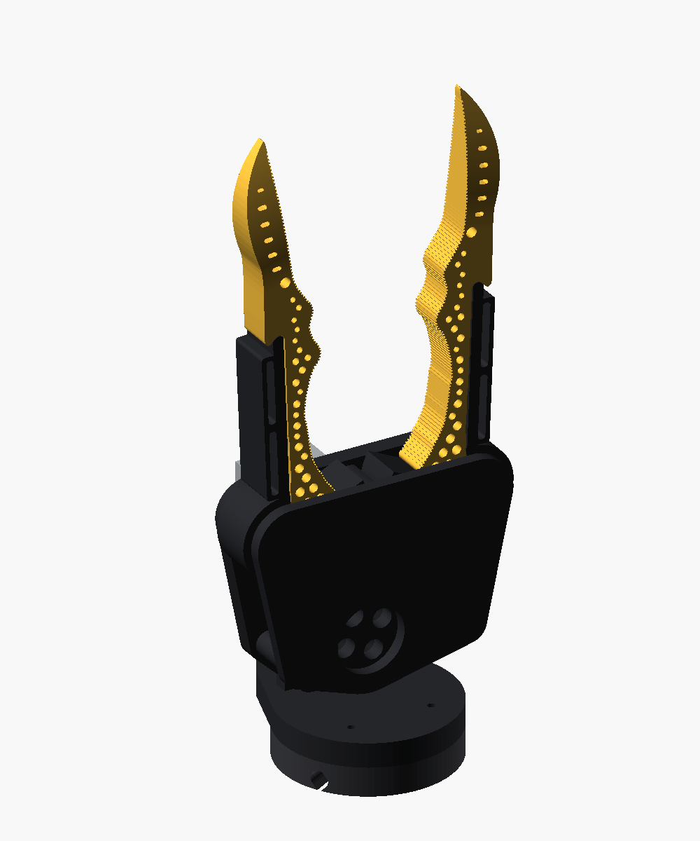
Two Finger Gripper/versions/v314_generalist_sts_arm_mount/previews/iso.png
