JacobSchantz/HelpingHands/Two Finger Gripper/versions/v315_generalist_so101_mount/previews/base_plate.png

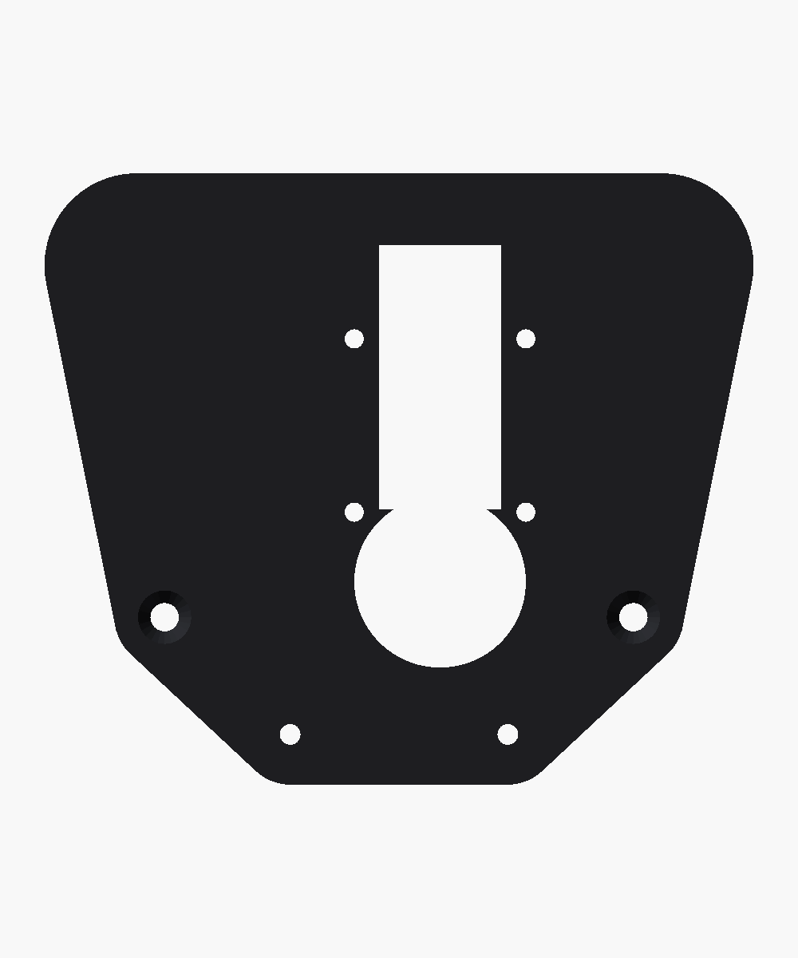
Two Finger Gripper/versions/v315_generalist_so101_mount/previews/base_plate.png
