JacobSchantz/HelpingHands/Two Finger Gripper/versions/v316_generalist_post_cap/previews/open.png

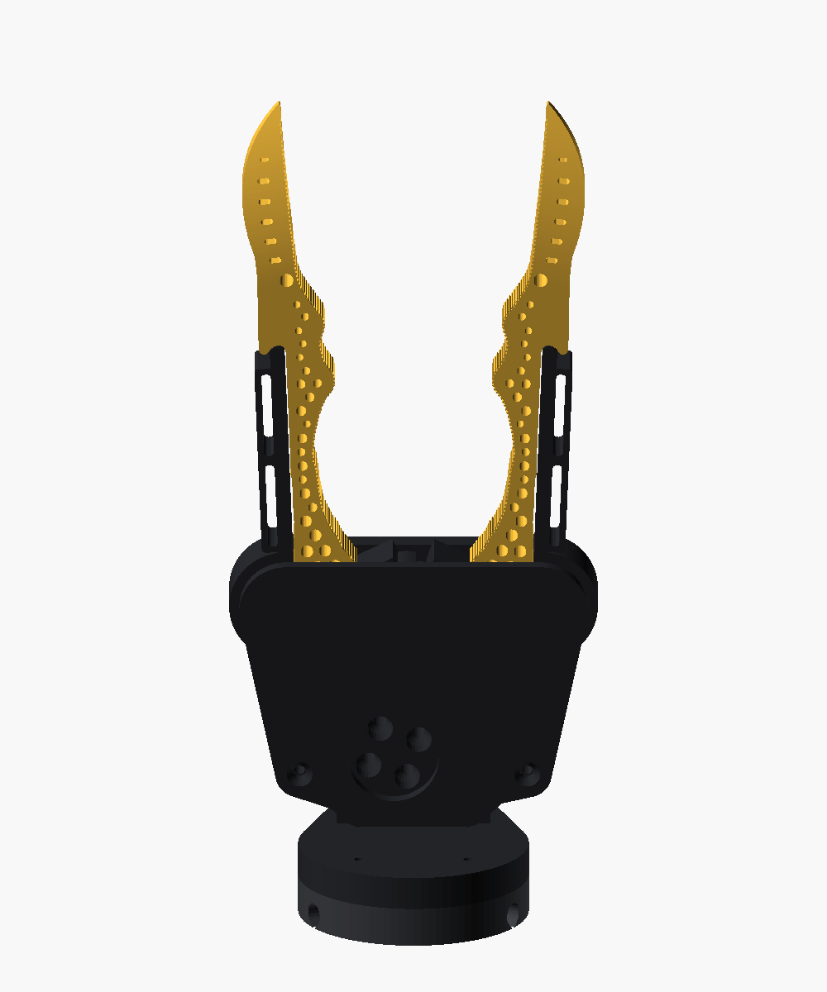
Two Finger Gripper/versions/v316_generalist_post_cap/previews/open.png
