JacobSchantz/HelpingHands/Two Finger Gripper/versions/v317_generalist_micro_tweezers/previews/open.png

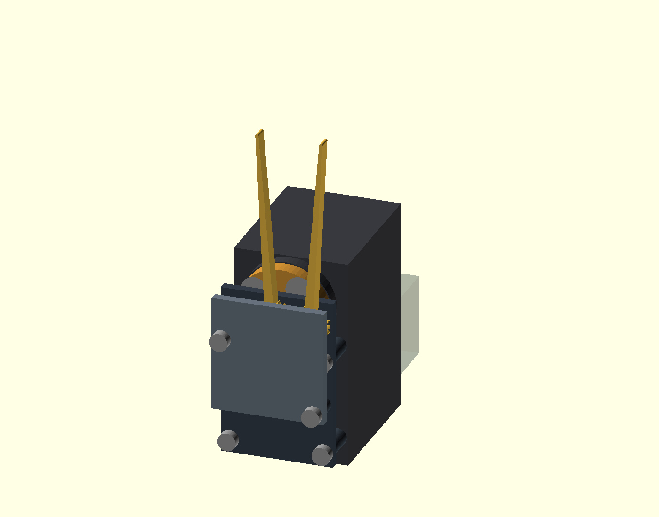
Two Finger Gripper/versions/v317_generalist_micro_tweezers/previews/open.png
