JacobSchantz/HelpingHands/Two Finger Gripper/versions/v328_generalist_five_piece/previews/live-exploded.png

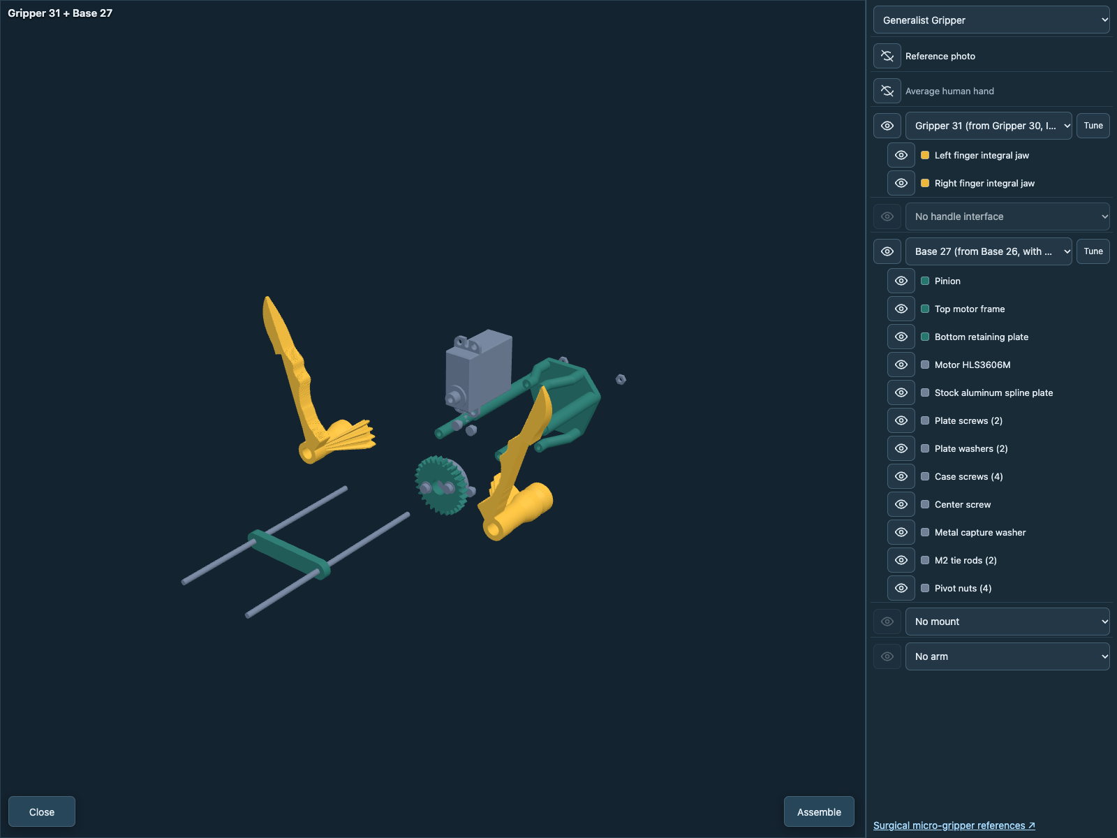
Two Finger Gripper/versions/v328_generalist_five_piece/previews/live-exploded.png
