JacobSchantz/HelpingHands/pebbles/agent/voice-2308ade1/parts_panel.png

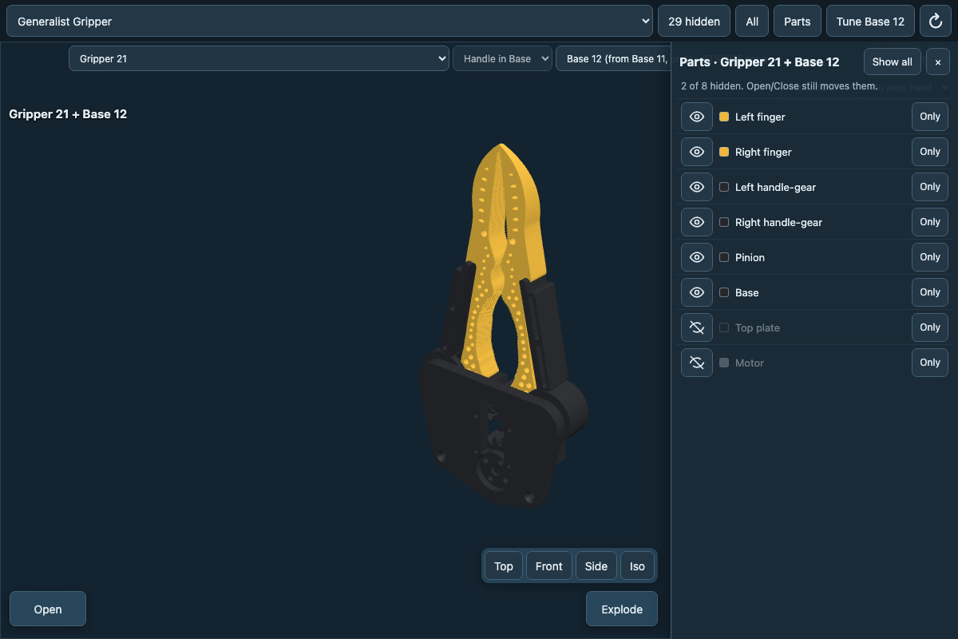
pebbles/agent/voice-2308ade1/parts_panel.png
