JacobSchantz/HelpingHands/pebbles/human/voice-550038ca/hardware_inventory.png

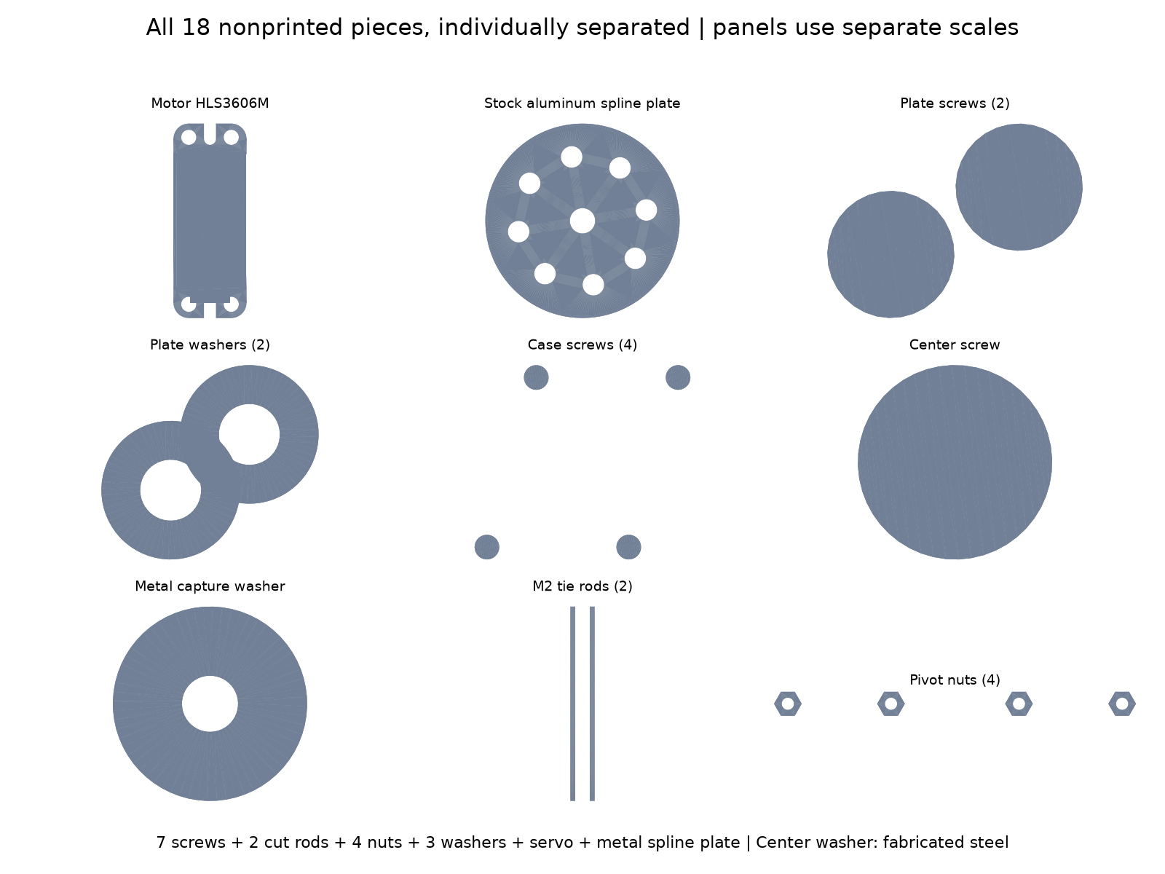
pebbles/human/voice-550038ca/hardware_inventory.png
