JacobSchantz/HelpingHands/cad/blender/out/so101_gripper_assembly.stl

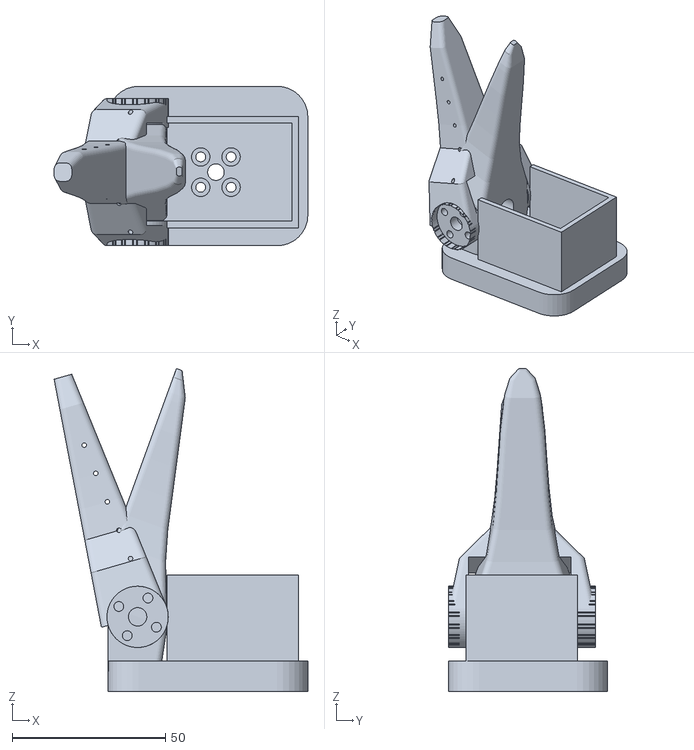
[picture p217: CAD file, 2026-09-14]
cad/blender/out/so101_gripper_assembly.stl
82.8 x 52.0 x 105.3
