JacobSchantz/HelpingHands/Two Finger Gripper/studies/voice-550038ca-four-post-cap/exports/assembly.stl

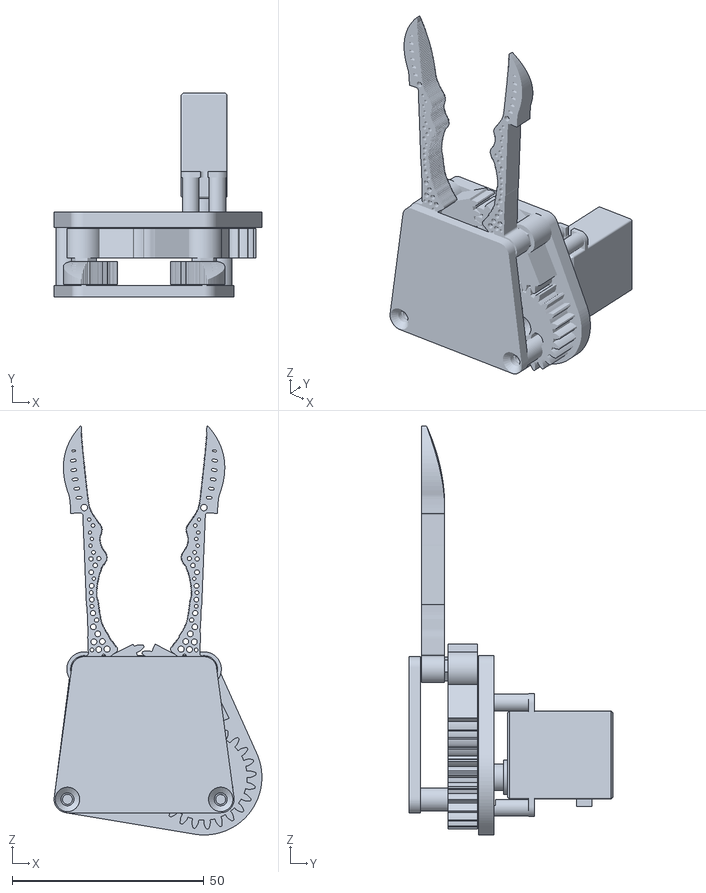
[picture p218: CAD file, 2026-10-23]
Two Finger Gripper/studies/voice-550038ca-four-post-cap/exports/assembly.stl
54.3 x 53.2 x 106.8
