JacobSchantz/HelpingHands/Two Finger Gripper/versions/v317_generalist_micro_tweezers/exports/assembly.stl

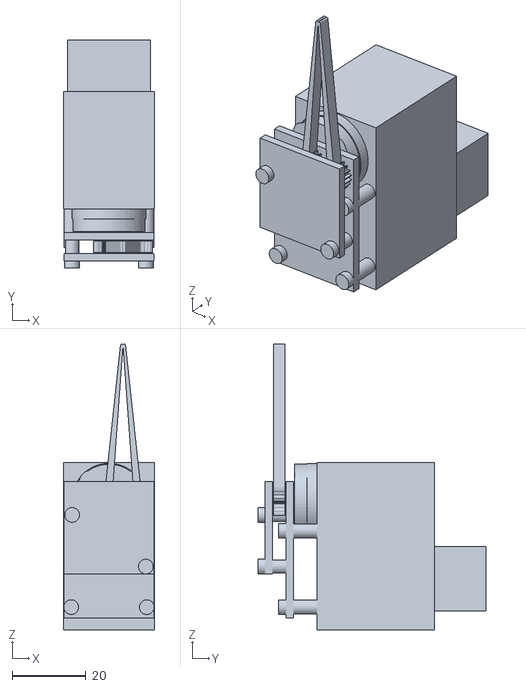
[picture p219: CAD file, 2026-10-23]
Two Finger Gripper/versions/v317_generalist_micro_tweezers/exports/assembly.stl
24.8 x 61.9 x 77.5
