JacobSchantz/HelpingHands/Two Finger Gripper/versions/v318_generalist_tiny_v2/exports/assembly.stl

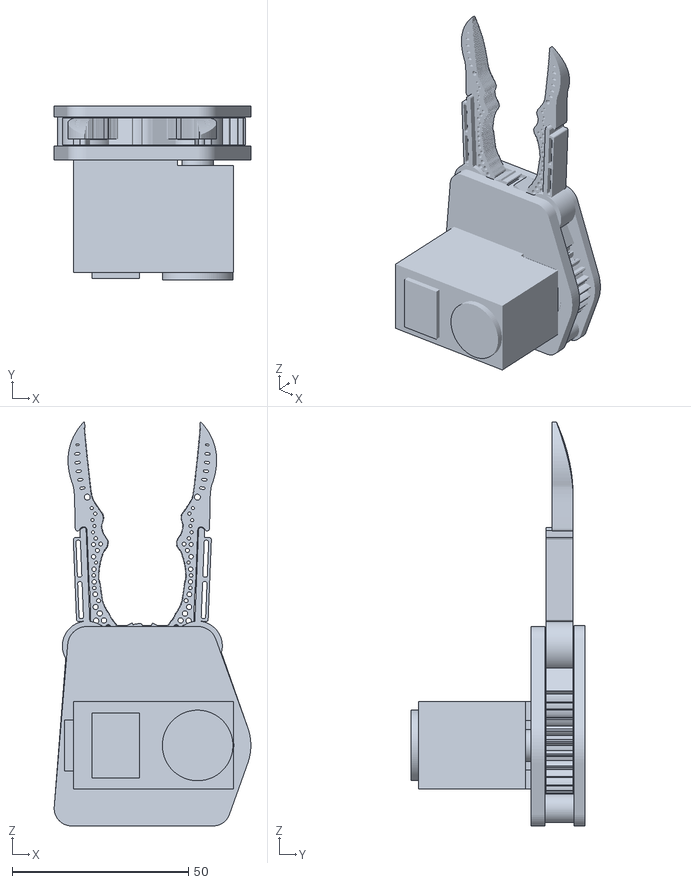
[picture p220: CAD file, 2026-10-23]
Two Finger Gripper/versions/v318_generalist_tiny_v2/exports/assembly.stl
55.8 x 49.2 x 114.5
