JacobSchantz/HelpingHands/Two Finger Gripper/versions/v319_generalist_hls3606m/exports/assembly.stl

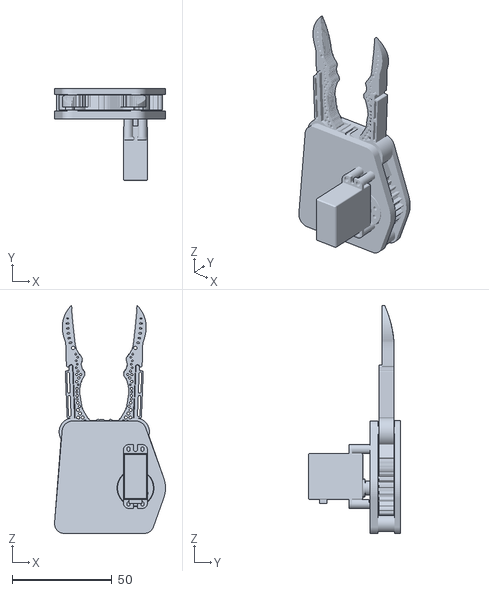
[picture p221: CAD file, 2026-10-23]
Two Finger Gripper/versions/v319_generalist_hls3606m/exports/assembly.stl
55.8 x 46.4 x 114.5
