JacobSchantz/HelpingHands/Two Finger Gripper/versions/v320_generalist_overhead_drive/exports/assembly.stl

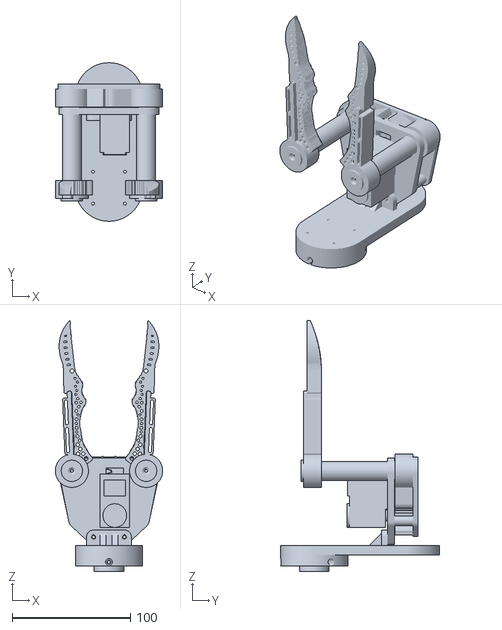
[picture p222: CAD file, 2026-10-23]
Two Finger Gripper/versions/v320_generalist_overhead_drive/exports/assembly.stl
90.7 x 133.9 x 211.9
