JacobSchantz/HelpingHands/Two Finger Gripper/versions/v321_generalist_compact_overhead/exports/assembly.stl

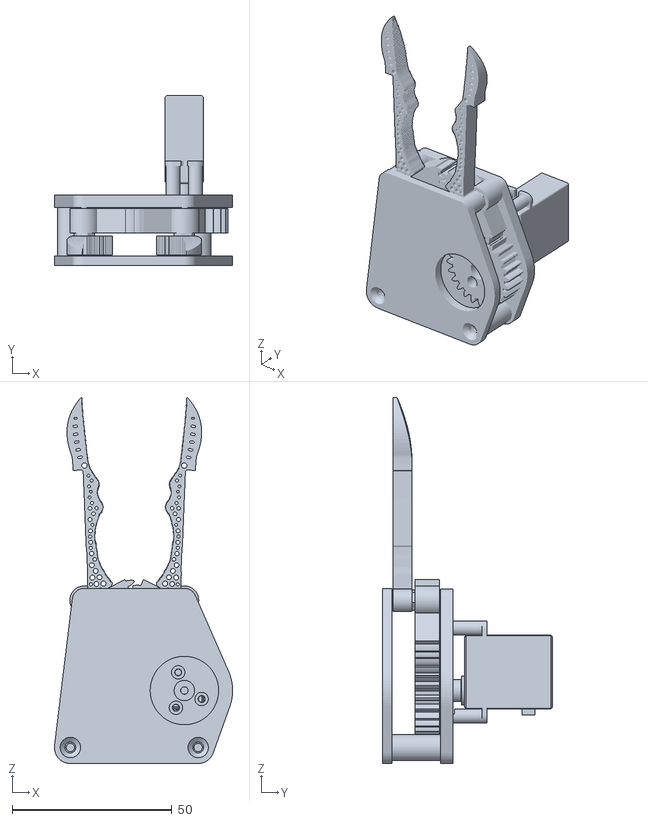
[picture p223: CAD file, 2026-10-23]
Two Finger Gripper/versions/v321_generalist_compact_overhead/exports/assembly.stl
55.8 x 53.2 x 114.5
