JacobSchantz/HelpingHands/Two Finger Gripper/versions/v322_generalist_two_pivot_support/exports/assembly.stl

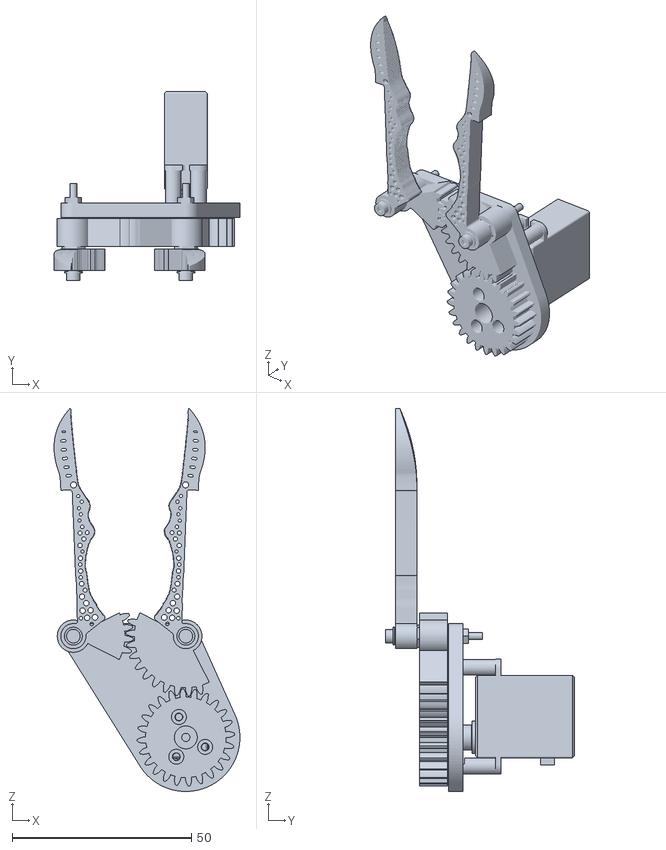
[picture p224: CAD file, 2026-10-23]
Two Finger Gripper/versions/v322_generalist_two_pivot_support/exports/assembly.stl
51.8 x 52.6 x 106.8
