JacobSchantz/HelpingHands/Two Finger Gripper/versions/v323_generalist_centered_drive/exports/assembly.stl

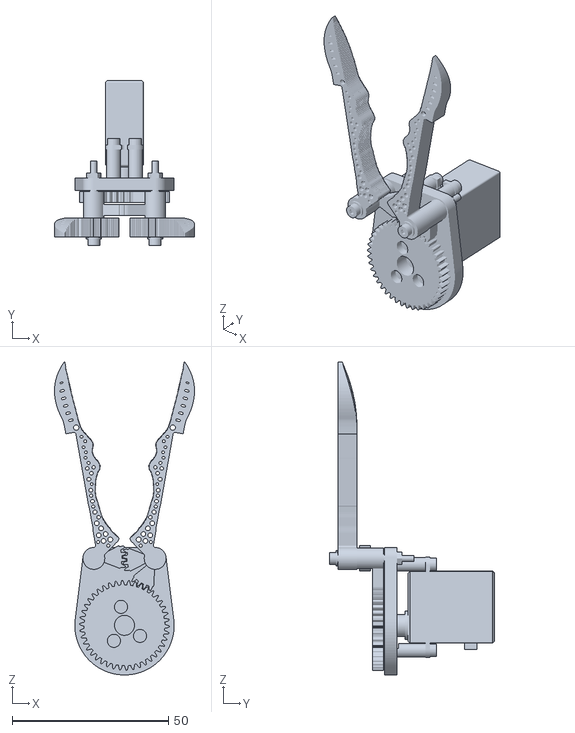
[picture p225: CAD file, 2026-10-23]
Two Finger Gripper/versions/v323_generalist_centered_drive/exports/assembly.stl
44.8 x 52.6 x 100.0
