JacobSchantz/HelpingHands/Two Finger Gripper/versions/v325_generalist_original_tip_closure/exports/assembly.stl

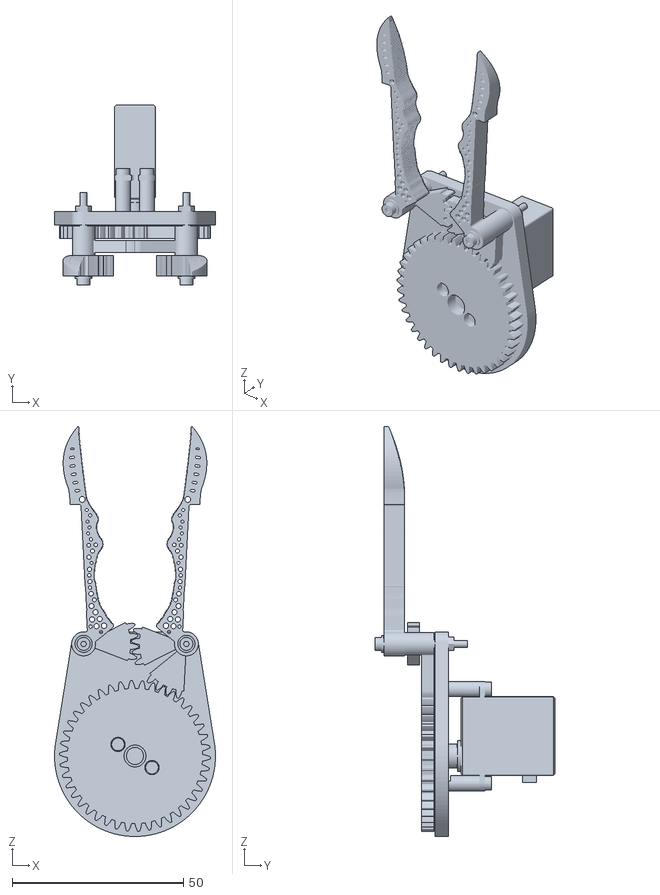
[picture p226: CAD file, 2026-10-23]
Two Finger Gripper/versions/v325_generalist_original_tip_closure/exports/assembly.stl
47.0 x 52.6 x 119.7
