JacobSchantz/HelpingHands/Two Finger Gripper/versions/v326_generalist_small_drive/exports/assembly.stl

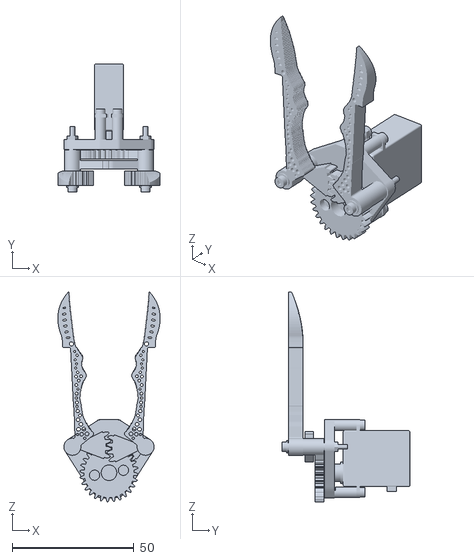
[picture p227: CAD file, 2026-10-23]
Two Finger Gripper/versions/v326_generalist_small_drive/exports/assembly.stl
41.9 x 52.6 x 86.1
