JacobSchantz/HelpingHands/Two Finger Gripper/versions/v327_generalist_support_free/exports/assembly.stl

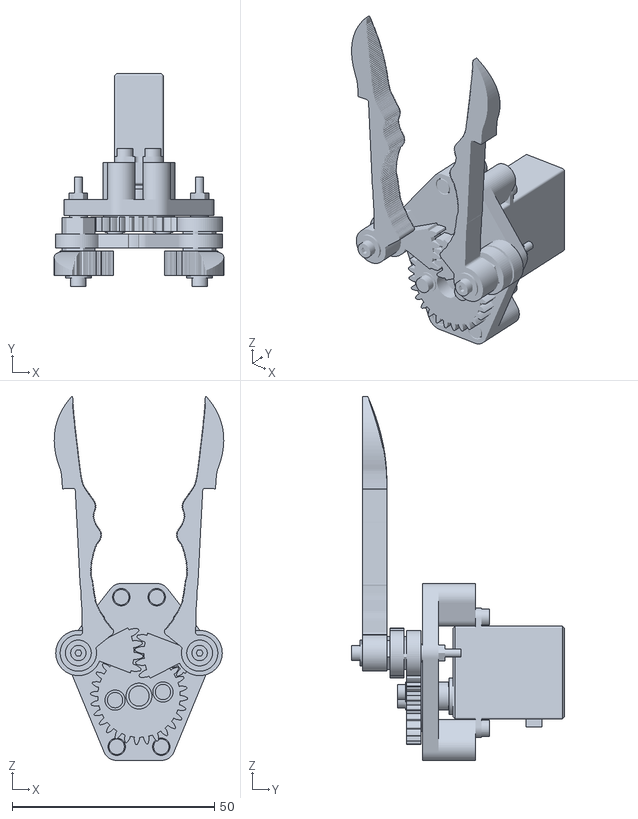
[picture p228: CAD file, 2026-10-24]
Two Finger Gripper/versions/v327_generalist_support_free/exports/assembly.stl
41.9 x 52.6 x 90.0
