JacobSchantz/HelpingHands/cad/openscad/export/assembly.stl

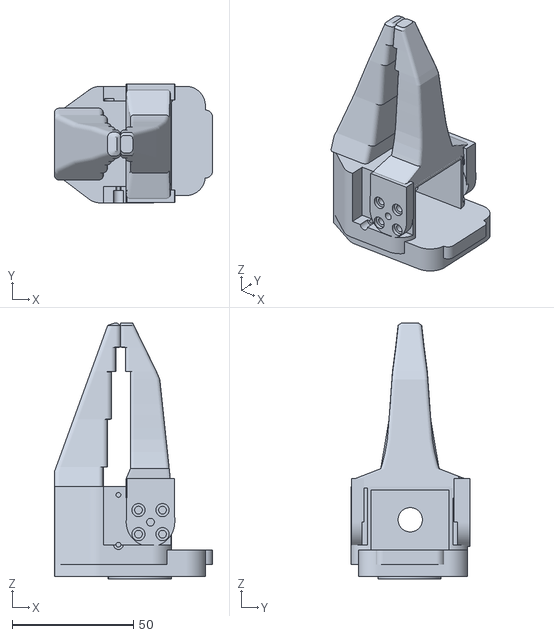
[picture p229: CAD file, 2026-09-14]
cad/openscad/export/assembly.stl
65.2 x 48.9 x 105.4
