JacobSchantz/HelpingHands/Two Finger Gripper/versions/v328_generalist_five_piece/exports/assembly.stl

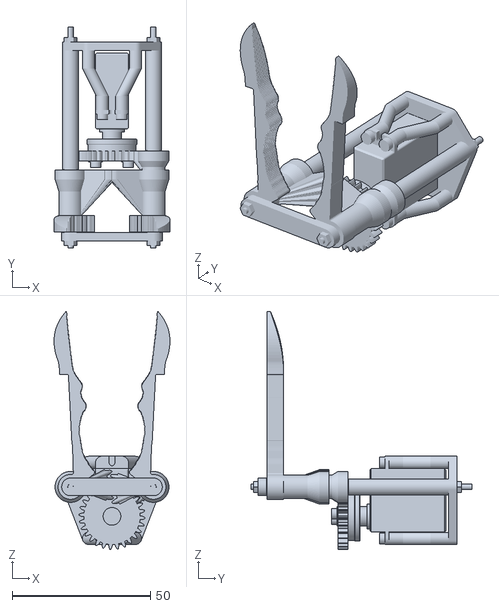
[picture p230: CAD file, 2026-10-24]
Two Finger Gripper/versions/v328_generalist_five_piece/exports/assembly.stl
41.9 x 80.0 x 86.1
