JacobSchantz/HelpingHands/cad/openscad/crow/export/assembly_open.stl

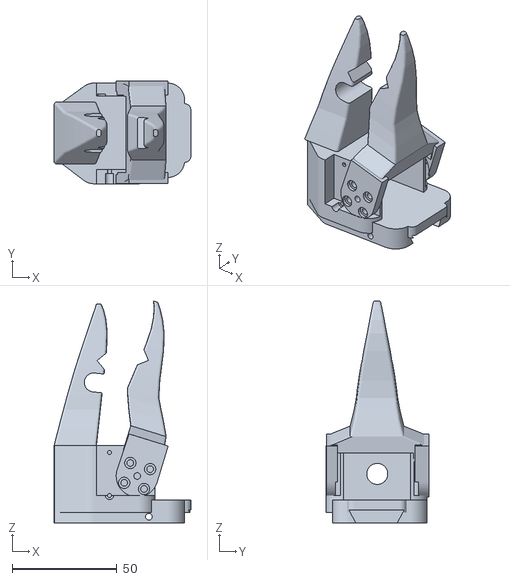
[picture p231: CAD file, 2026-09-30]
cad/openscad/crow/export/assembly_open.stl
65.2 x 48.9 x 105.9
