JacobSchantz/HelpingHands/cad/openscad/crow/export/assembly.stl

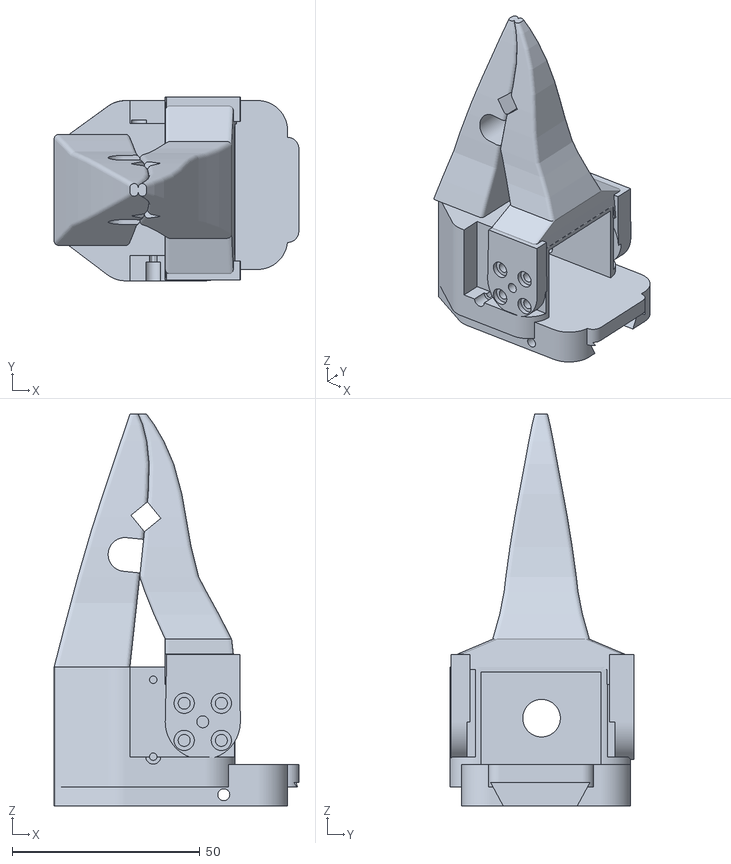
[picture p232: CAD file, 2026-09-30]
cad/openscad/crow/export/assembly.stl
65.2 x 48.9 x 104.4
