JacobSchantz/HelpingHands/cad/openscad/hand_gripper/export/assembly.stl

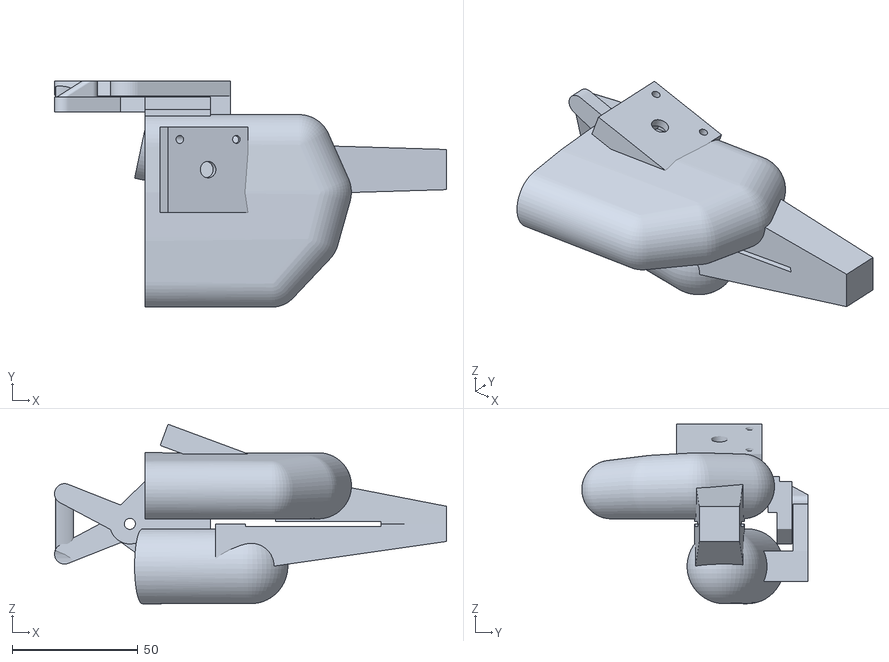
[picture p233: CAD file, 2026-10-14]
cad/openscad/hand_gripper/export/assembly.stl
156.0 x 90.1 x 71.4
