JacobSchantz/HelpingHands/cad/arm/rebot_b601_rs/meshes/shared/base_link.STL

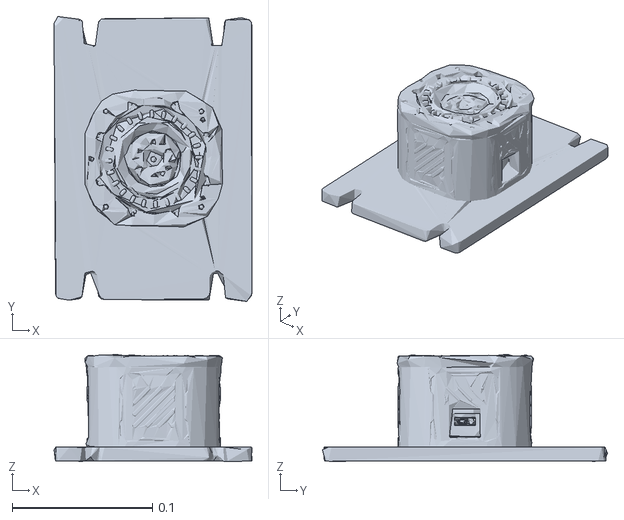
[picture p234: CAD file, 2026-10-20]
cad/arm/rebot_b601_rs/meshes/shared/base_link.STL
0.141 x 0.203 x 0.0764
