JacobSchantz/HelpingHands/cad/arm/rebot_b601_rs/meshes/visual/cnc5.STL

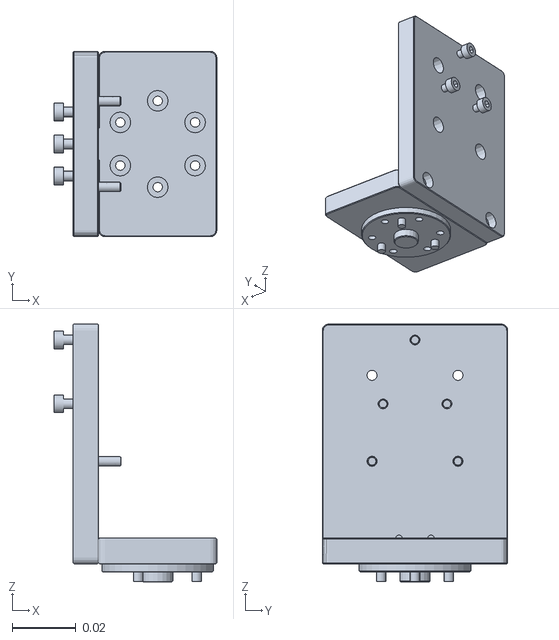
[picture p235: CAD file, 2026-10-20]
cad/arm/rebot_b601_rs/meshes/visual/cnc5.STL
0.0509 x 0.058 x 0.0807
