JacobSchantz/HelpingHands/cad/arm/rebot_b601_rs/meshes_preview/shared/base_link.STL

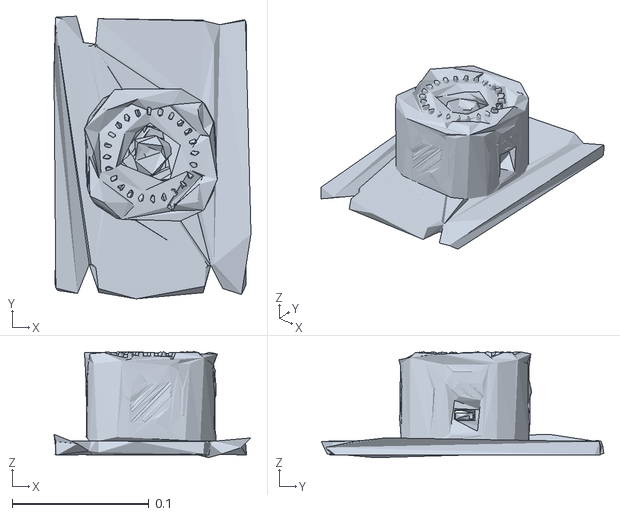
[picture p236: CAD file, 2026-10-20]
cad/arm/rebot_b601_rs/meshes_preview/shared/base_link.STL
0.144 x 0.207 x 0.0778
