JacobSchantz/HelpingHands/cad/arm/rebot_b601_rs/meshes_preview/visual/cnc4.STL

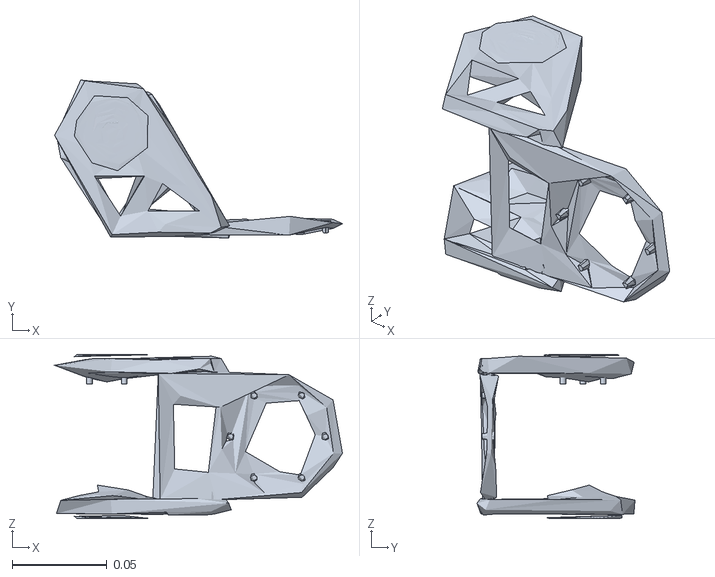
[picture p237: CAD file, 2026-10-20]
cad/arm/rebot_b601_rs/meshes_preview/visual/cnc4.STL
0.152 x 0.0832 x 0.0865
