JacobSchantz/HelpingHands/cad/arm/so101/assets/motor_holder_so101_wrist_v1.stl

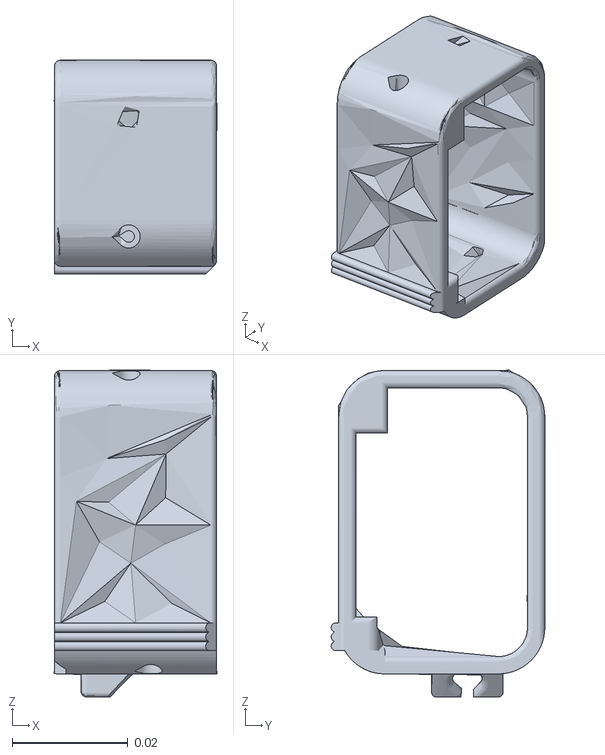
[picture p238: CAD file, 2026-10-20]
cad/arm/so101/assets/motor_holder_so101_wrist_v1.stl
0.0281 x 0.0369 x 0.0565
