JacobSchantz/HelpingHands/cad/arm/so101/assets_preview/upper_arm_so101_v1.stl

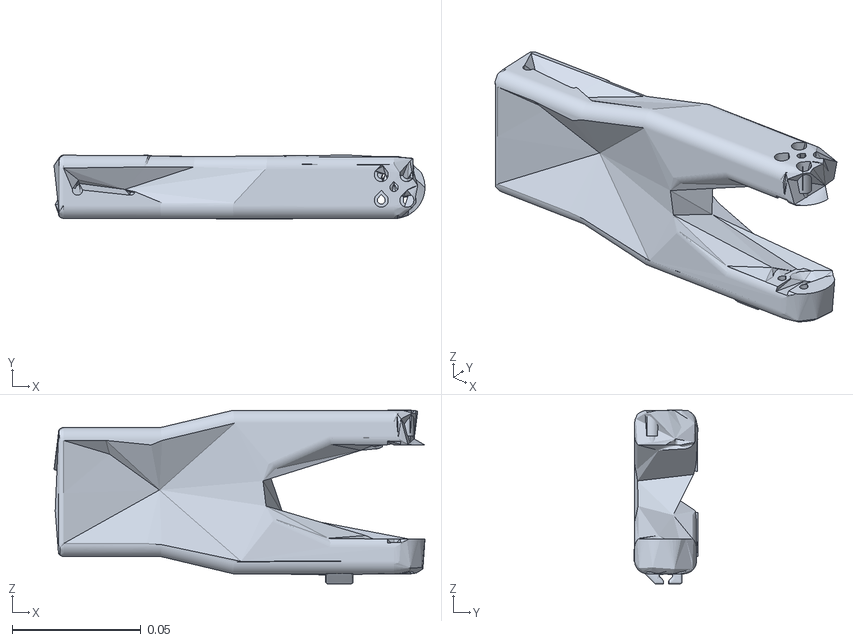
[picture p239: CAD file, 2026-10-20]
cad/arm/so101/assets_preview/upper_arm_so101_v1.stl
0.144 x 0.0248 x 0.0674
