JacobSchantz/HelpingHands/cad/build123d/export/moving_jaw.step

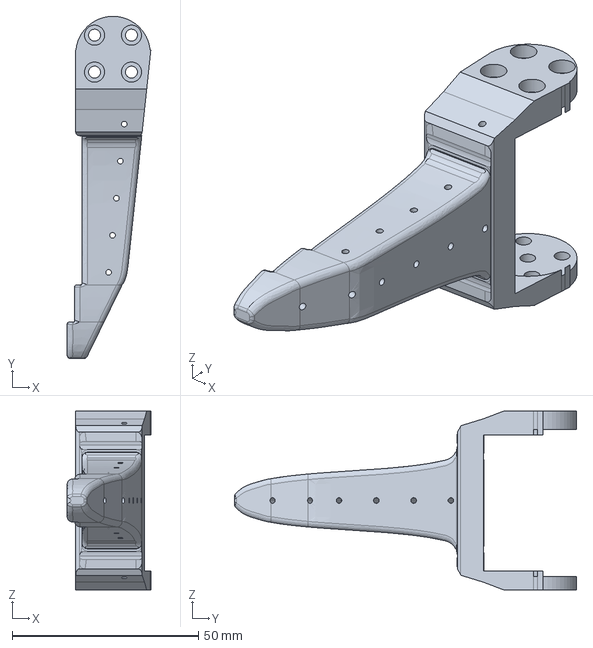
[picture p240: CAD file, 2026-09-14]
cad/build123d/export/moving_jaw.step
22.4 x 91.8 x 48.0 mm
