JacobSchantz/HelpingHands/cad/build123d/reference/Wrist_Roll_Follower_SO101.step

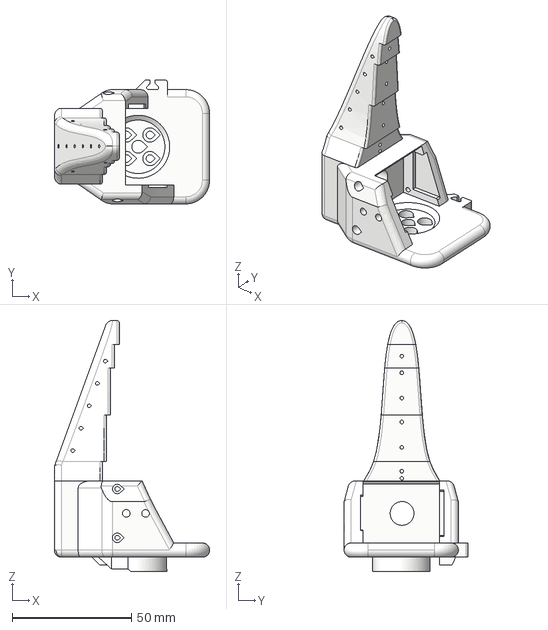
[picture p241: CAD file, 2026-09-13]
cad/build123d/reference/Wrist_Roll_Follower_SO101.step
65.2 x 52.0 x 105.4 mm
Wiring_holder v1
Wiring_holder v1 (1)
