JacobSchantz/HelpingHands/cad/openscad/crow/export/upper.stl

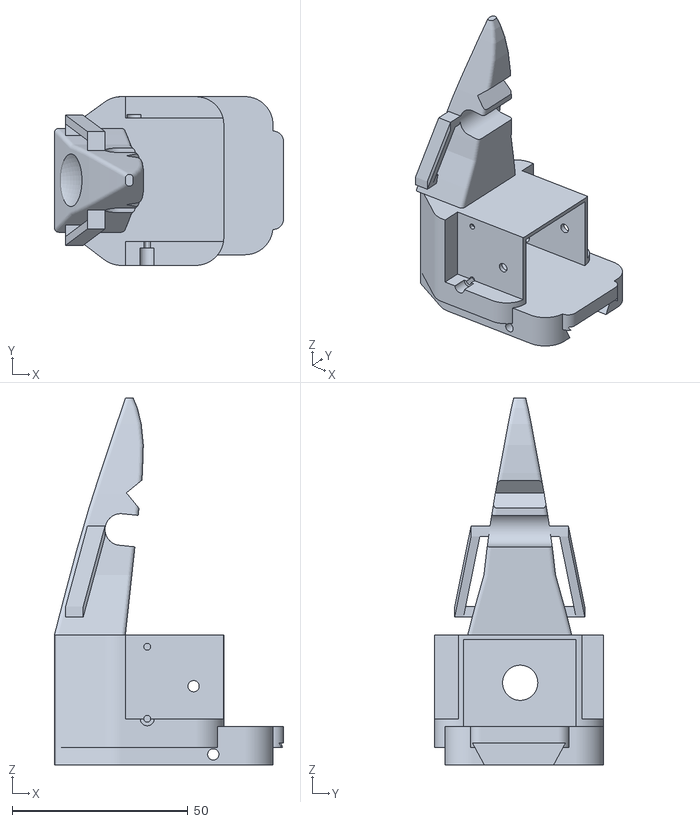
[picture p242: CAD file, 2026-10-14]
cad/openscad/crow/export/upper.stl
65.2 x 48.0 x 104.4
