JacobSchantz/HelpingHands/cad/openscad/demo_gripper/export/gen_01_left_finger.stl

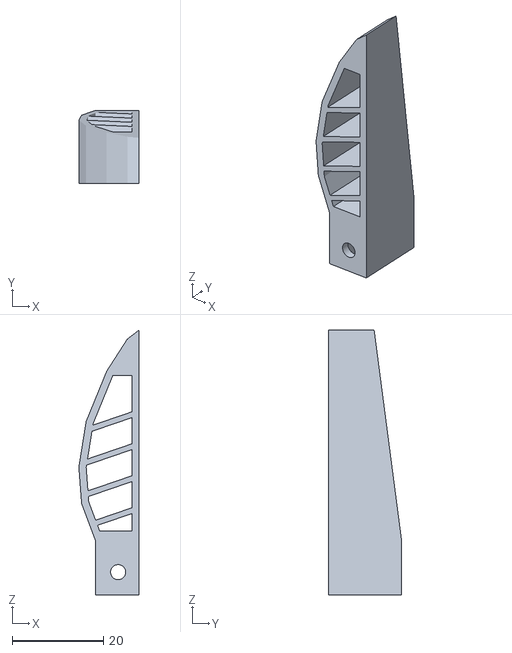
[picture p243: CAD file, 2026-10-16]
cad/openscad/demo_gripper/export/gen_01_left_finger.stl
13.2 x 16.0 x 58.0
