JacobSchantz/HelpingHands/cad/openscad/hand_gripper/export/so101_mount.stl

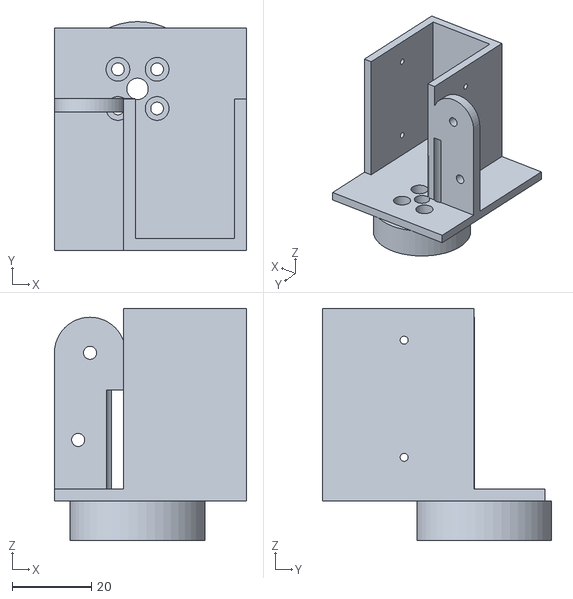
[picture p244: CAD file, 2026-10-14]
cad/openscad/hand_gripper/export/so101_mount.stl
48.5 x 57.8 x 58.6
