JacobSchantz/HelpingHands/Two Finger Gripper/studies/voice-550038ca-four-post-cap/exports/parts/left_gear.stl

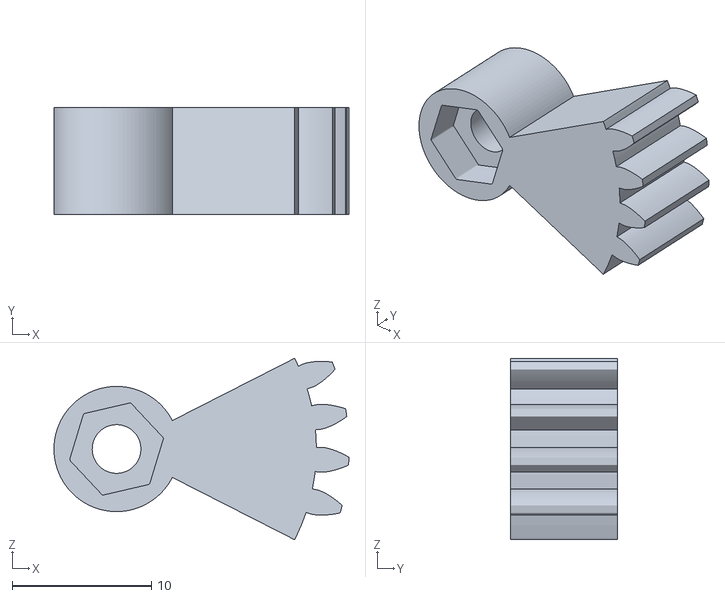
[picture p245: CAD file, 2026-10-23]
Two Finger Gripper/studies/voice-550038ca-four-post-cap/exports/parts/left_gear.stl
21.2 x 7.70 x 13.0
