JacobSchantz/HelpingHands/Two Finger Gripper/studies/voice-550038ca-four-post-cap/exports/reference/cap_tools.stl

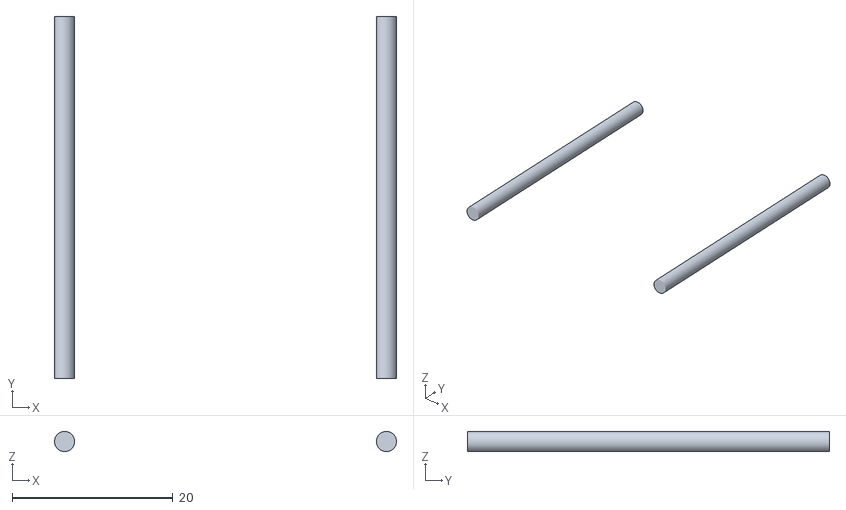
[picture p246: CAD file, 2026-10-23]
Two Finger Gripper/studies/voice-550038ca-four-post-cap/exports/reference/cap_tools.stl
42.5 x 45.0 x 2.50
