JacobSchantz/HelpingHands/Two Finger Gripper/versions/v317_generalist_micro_tweezers/exports/parts/horn_heads.stl

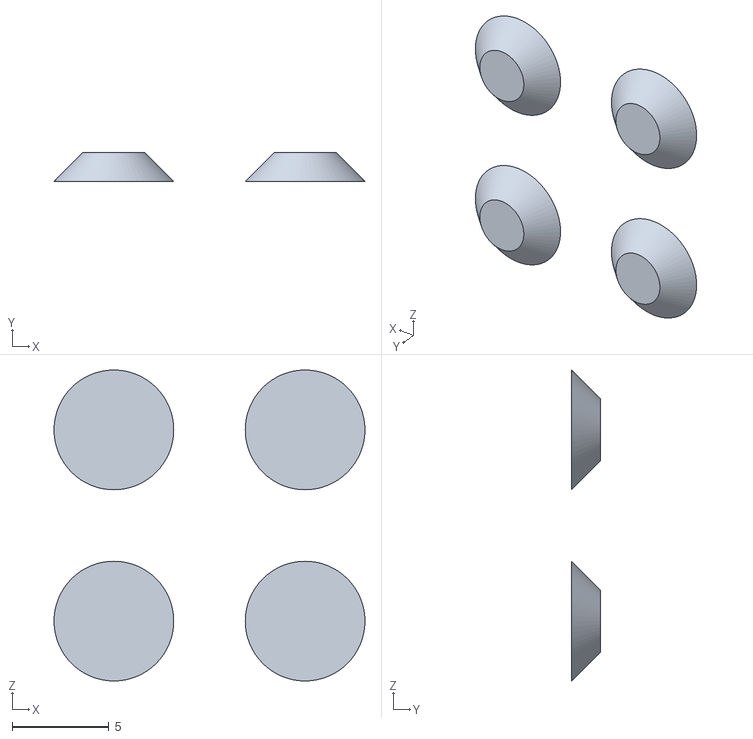
[picture p247: CAD file, 2026-10-23]
Two Finger Gripper/versions/v317_generalist_micro_tweezers/exports/parts/horn_heads.stl
16.1 x 1.50 x 16.1
