JacobSchantz/HelpingHands/Two Finger Gripper/versions/v319_generalist_hls3606m/reference/aero_spool.step

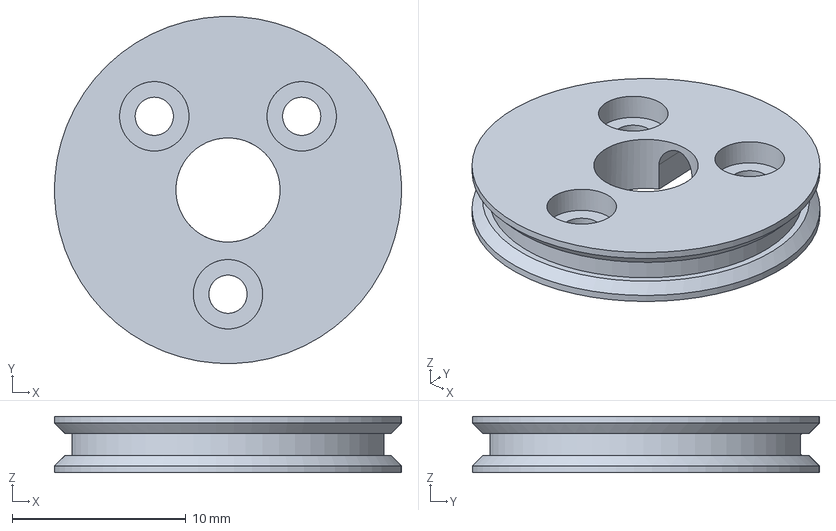
[picture p248: CAD file, 2026-10-23]
Two Finger Gripper/versions/v319_generalist_hls3606m/reference/aero_spool.step
20.0 x 20.0 x 3.25 mm
