JacobSchantz/HelpingHands/Two Finger Gripper/versions/v320_generalist_overhead_drive/exports/parts/hub.stl

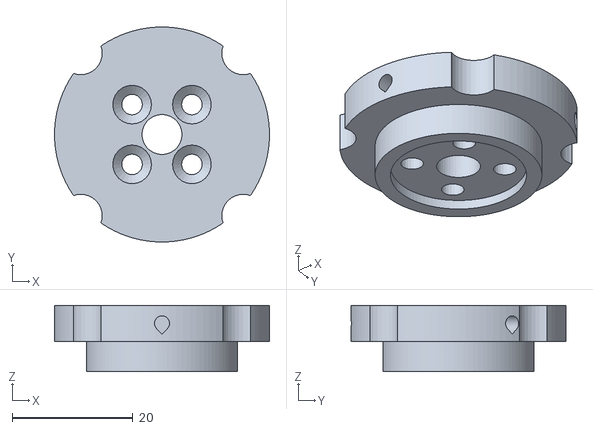
[picture p249: CAD file, 2026-10-23]
Two Finger Gripper/versions/v320_generalist_overhead_drive/exports/parts/hub.stl
35.6 x 35.6 x 11.0
