JacobSchantz/HelpingHands/Two Finger Gripper/versions/v320_generalist_overhead_drive/exports/reference/horn_tools.stl

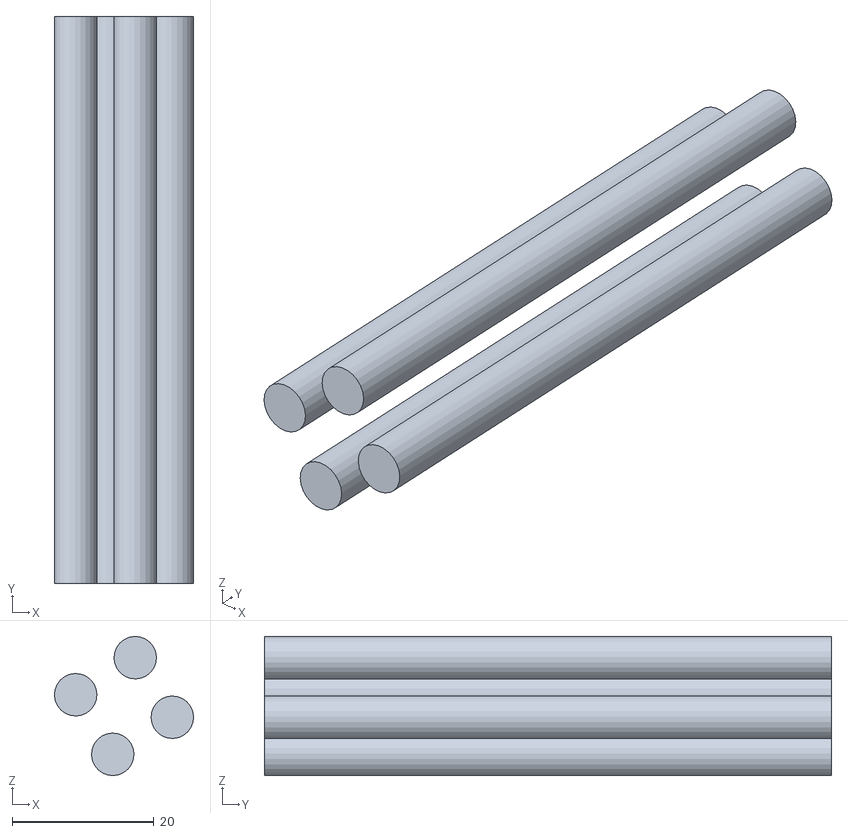
[picture p250: CAD file, 2026-10-23]
Two Finger Gripper/versions/v320_generalist_overhead_drive/exports/reference/horn_tools.stl
19.6 x 80.0 x 19.6
