JacobSchantz/HelpingHands/Two Finger Gripper/versions/v321_generalist_compact_overhead/exports/reference/case_tools.stl

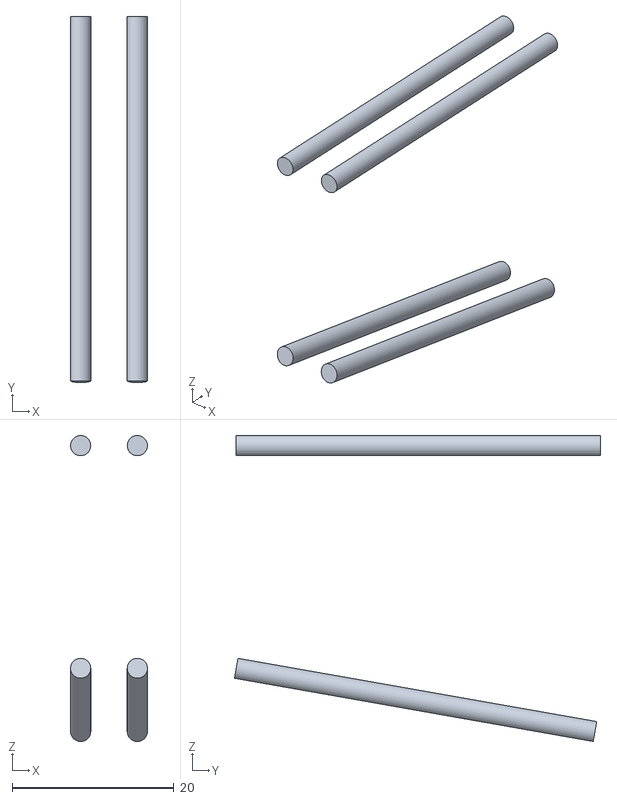
[picture p251: CAD file, 2026-10-23]
Two Finger Gripper/versions/v321_generalist_compact_overhead/exports/reference/case_tools.stl
9.50 x 45.2 x 37.8
