JacobSchantz/HelpingHands/Two Finger Gripper/versions/v322_generalist_two_pivot_support/exports/print/right_gear.stl

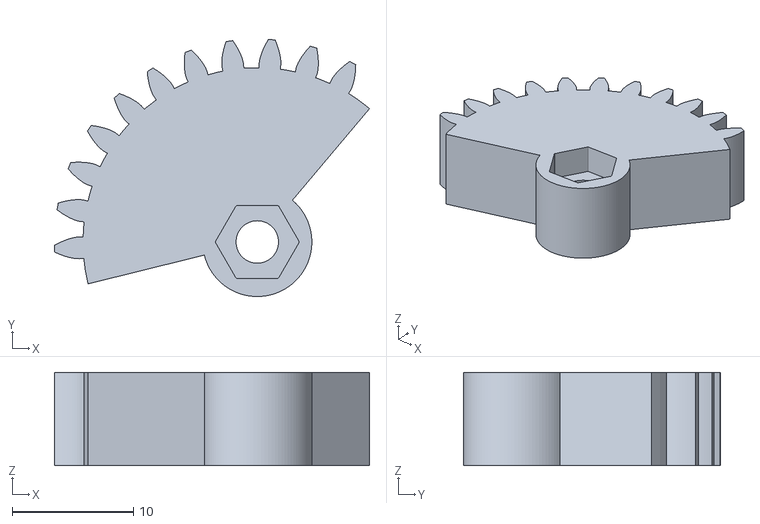
[picture p252: CAD file, 2026-10-23]
Two Finger Gripper/versions/v322_generalist_two_pivot_support/exports/print/right_gear.stl
26.0 x 21.2 x 7.70
