JacobSchantz/HelpingHands/Two Finger Gripper/versions/v324_generalist_contact_close/reference/servo.step

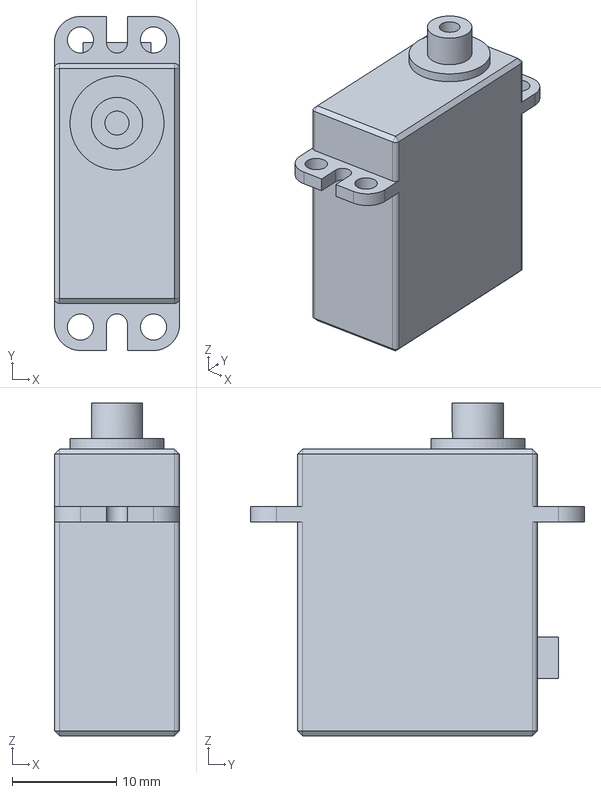
[picture p253: CAD file, 2026-10-23]
Two Finger Gripper/versions/v324_generalist_contact_close/reference/servo.step
12.0 x 32.0 x 31.9 mm
