JacobSchantz/HelpingHands/Two Finger Gripper/versions/v326_generalist_small_drive/reference/stock_plate.step

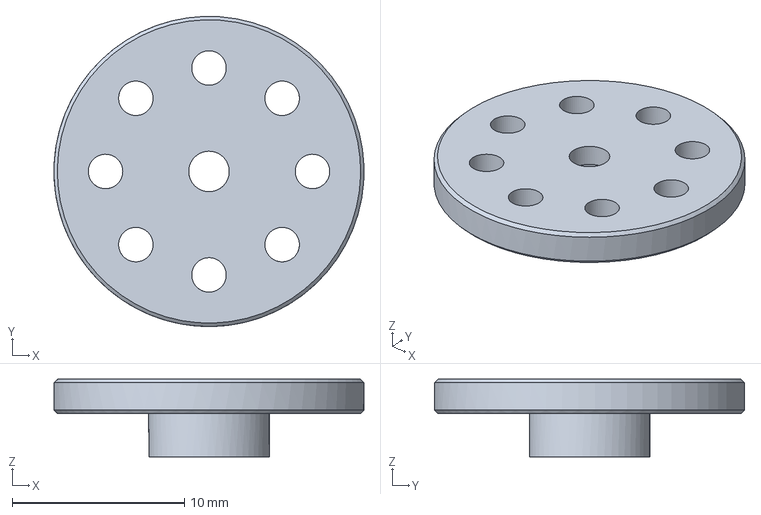
[picture p254: CAD file, 2026-10-23]
Two Finger Gripper/versions/v326_generalist_small_drive/reference/stock_plate.step
18.0 x 18.0 x 4.50 mm
