JacobSchantz/HelpingHands/Two Finger Gripper/versions/v327_generalist_support_free/exports/parts/stock_plate.stl

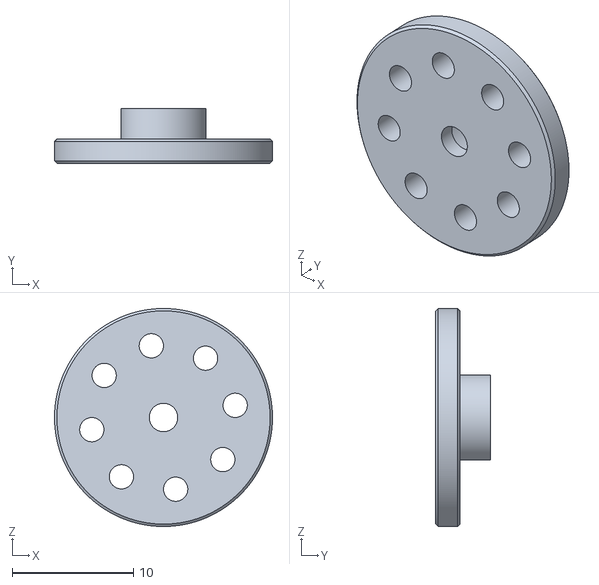
[picture p255: CAD file, 2026-10-24]
Two Finger Gripper/versions/v327_generalist_support_free/exports/parts/stock_plate.stl
18.0 x 4.50 x 18.0
