JacobSchantz/HelpingHands/Two Finger Gripper/versions/v327_generalist_support_free/exports/reference/spacer_tools.stl

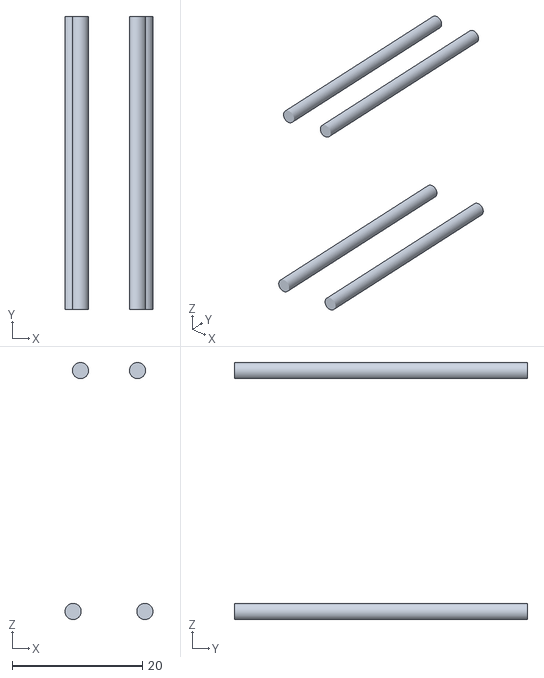
[picture p256: CAD file, 2026-10-24]
Two Finger Gripper/versions/v327_generalist_support_free/exports/reference/spacer_tools.stl
13.5 x 45.0 x 39.5
