JacobSchantz/HelpingHands/Two Finger Gripper/versions/v328_generalist_five_piece/exports/print_plate.3mf

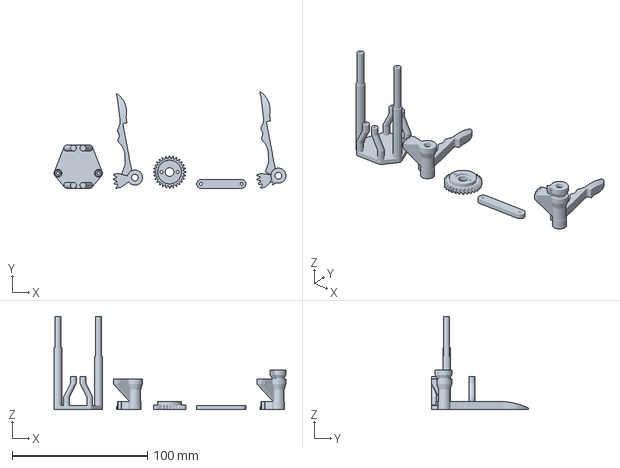
[picture p257: CAD file, 2026-10-24]
Two Finger Gripper/versions/v328_generalist_five_piece/exports/print_plate.3mf
171.4 x 71.3 x 68.9 mm
