JacobSchantz/HelpingHands/cad/arm/rebot_b601_rs/meshes/shared/link6.STL

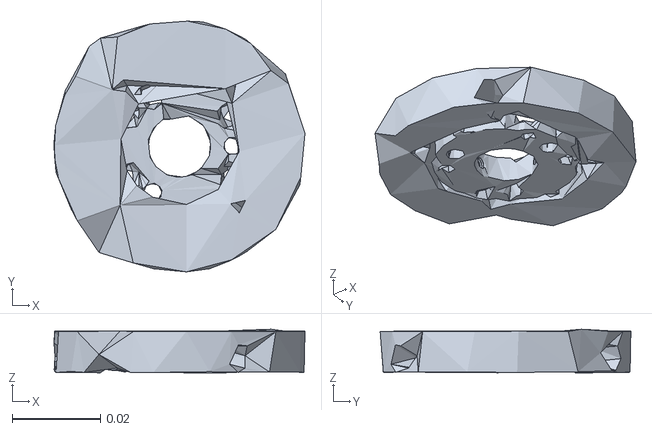
[picture p258: CAD file, 2026-10-20]
cad/arm/rebot_b601_rs/meshes/shared/link6.STL
0.0569 x 0.0568 x 0.00988
