JacobSchantz/HelpingHands/cad/arm/rebot_b601_rs/meshes/visual/motor_7.STL

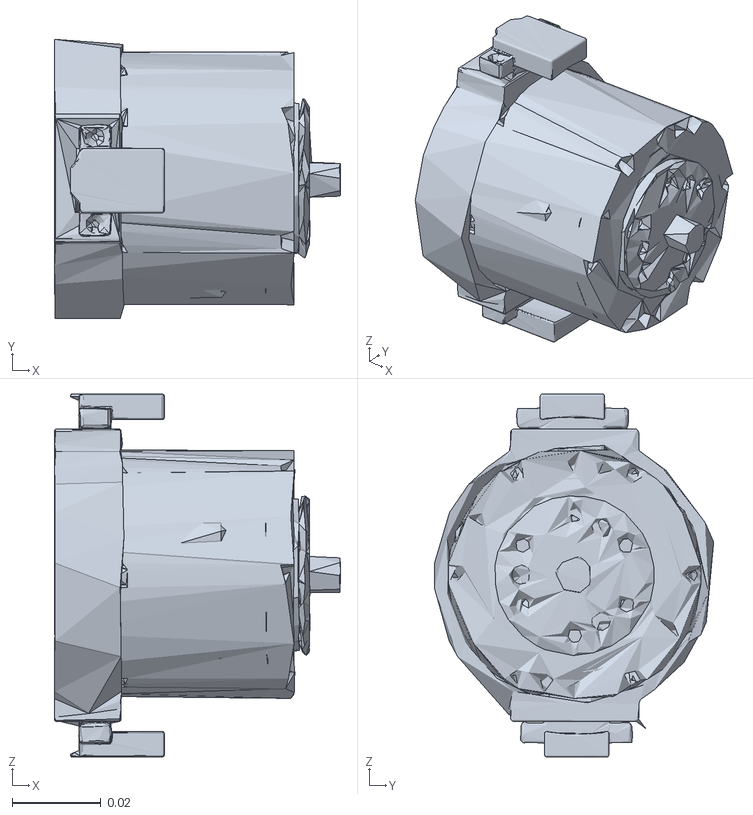
[picture p259: CAD file, 2026-10-20]
cad/arm/rebot_b601_rs/meshes/visual/motor_7.STL
0.0645 x 0.063 x 0.0818
