JacobSchantz/HelpingHands/cad/arm/rebot_b601_rs/meshes_preview/shared/link4.STL

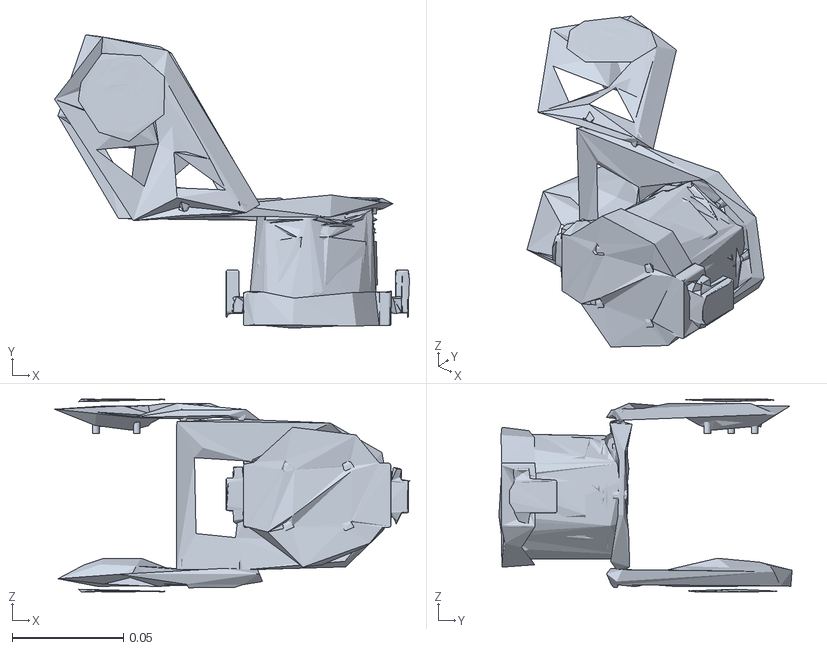
[picture p260: CAD file, 2026-10-20]
cad/arm/rebot_b601_rs/meshes_preview/shared/link4.STL
0.159 x 0.132 x 0.0865
