JacobSchantz/HelpingHands/cad/arm/rebot_b601_rs/meshes_preview/visual/pla3_seeed_wordmark_backing.STL

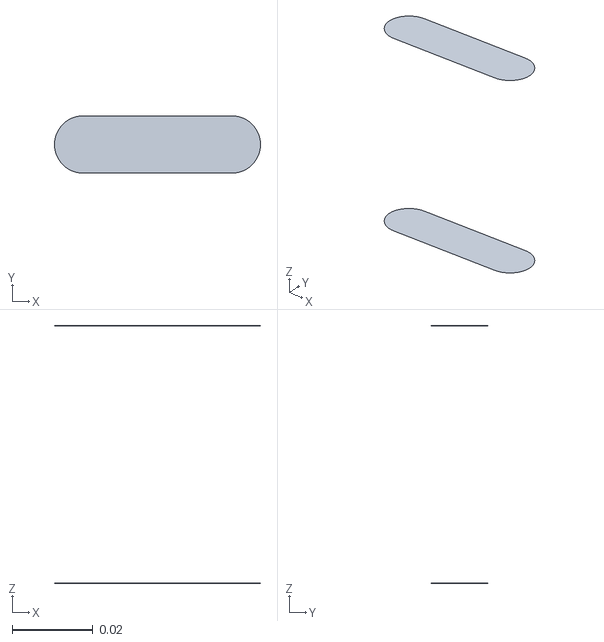
[picture p261: CAD file, 2026-10-20]
cad/arm/rebot_b601_rs/meshes_preview/visual/pla3_seeed_wordmark_backing.STL
0.0509 x 0.0142 x 0.0638
