JacobSchantz/HelpingHands/cad/arm/so101/assets/motor_holder_so101_base_v1.stl

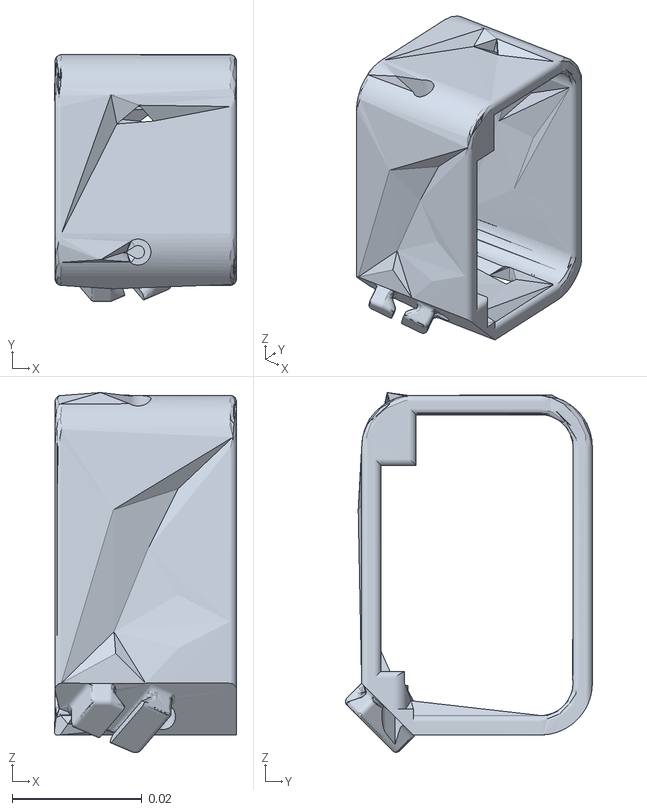
[picture p262: CAD file, 2026-10-20]
cad/arm/so101/assets/motor_holder_so101_base_v1.stl
0.0282 x 0.0381 x 0.0555
