JacobSchantz/HelpingHands/cad/arm/so101/assets_preview/rotation_pitch_so101_v1.stl

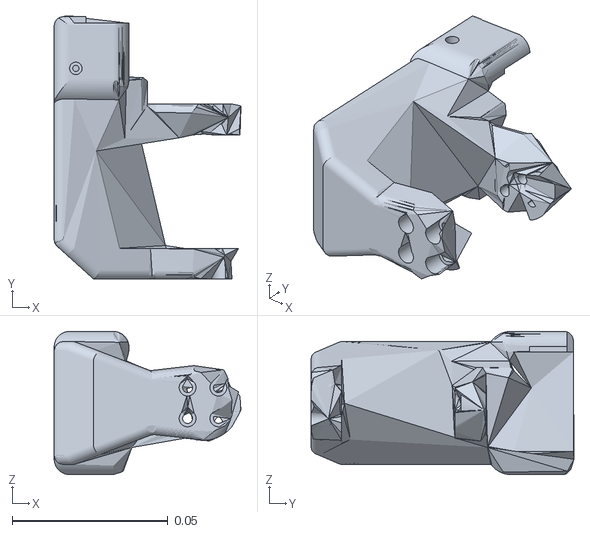
[picture p263: CAD file, 2026-10-20]
cad/arm/so101/assets_preview/rotation_pitch_so101_v1.stl
0.06 x 0.0845 x 0.046
