JacobSchantz/HelpingHands/cad/blender/out/moving_jaw.stl

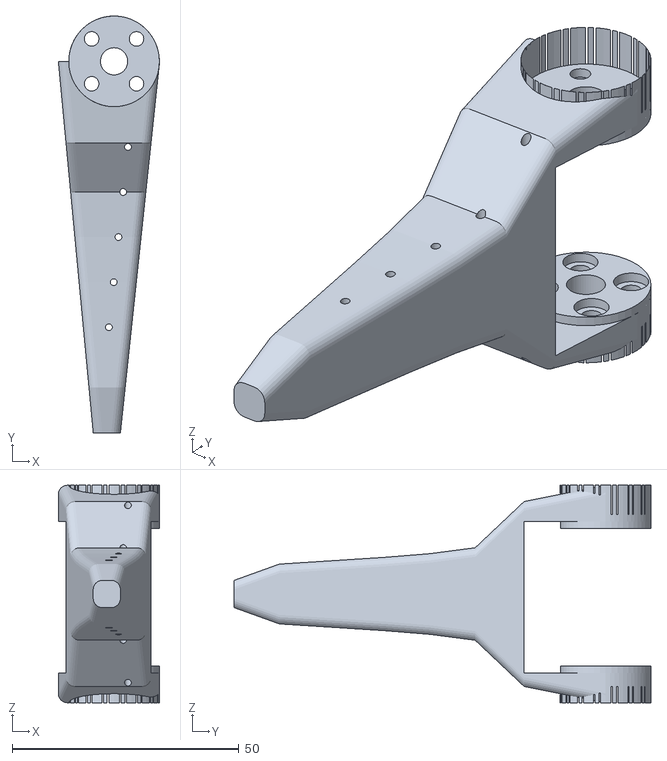
[picture p264: CAD file, 2026-09-14]
cad/blender/out/moving_jaw.stl
22.4 x 92.0 x 48.0
