JacobSchantz/HelpingHands/cad/build123d/export/fixed_jaw.step

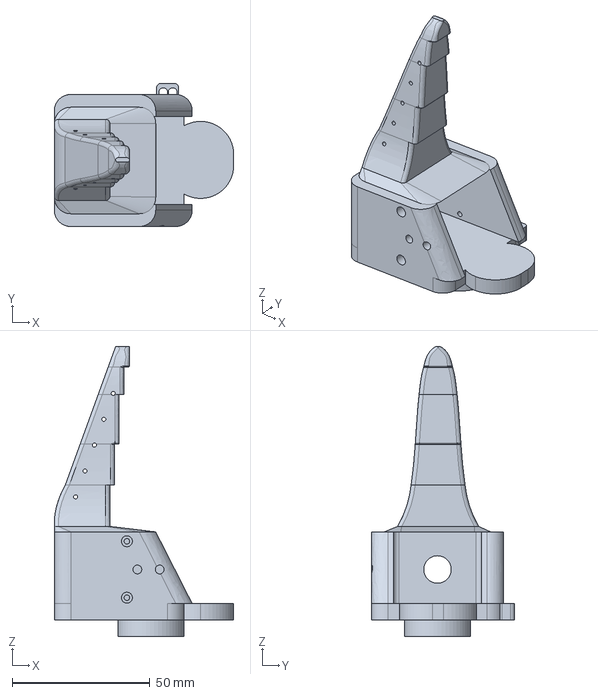
[picture p265: CAD file, 2026-09-14]
cad/build123d/export/fixed_jaw.step
65.2 x 52.0 x 105.4 mm
