JacobSchantz/HelpingHands/cad/build123d/reference/Moving_Jaw_SO101.step

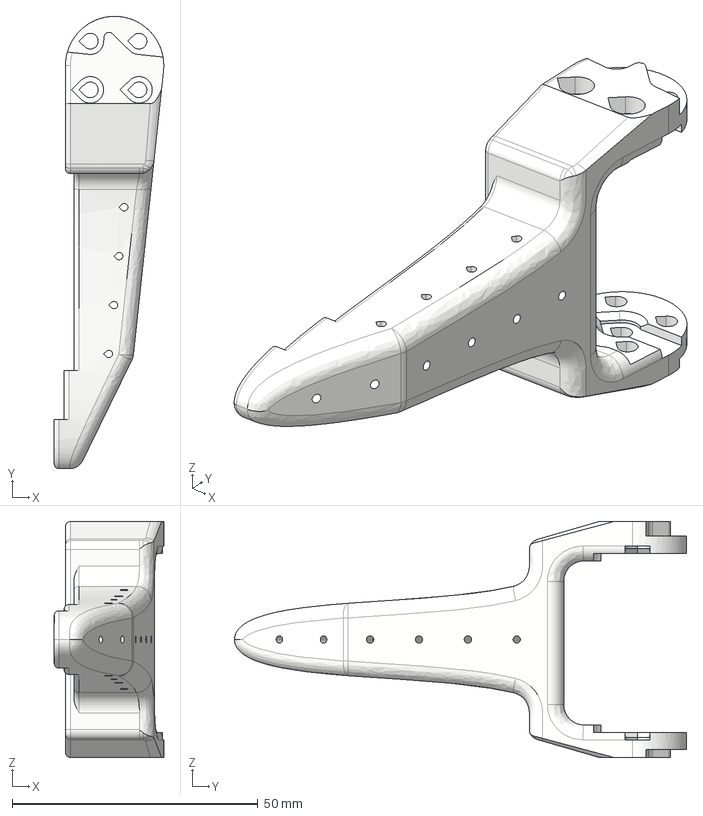
[picture p266: CAD file, 2026-09-13]
cad/build123d/reference/Moving_Jaw_SO101.step
22.3 x 92.0 x 48.0 mm
