JacobSchantz/HelpingHands/cad/openscad/crow/export/lower.stl

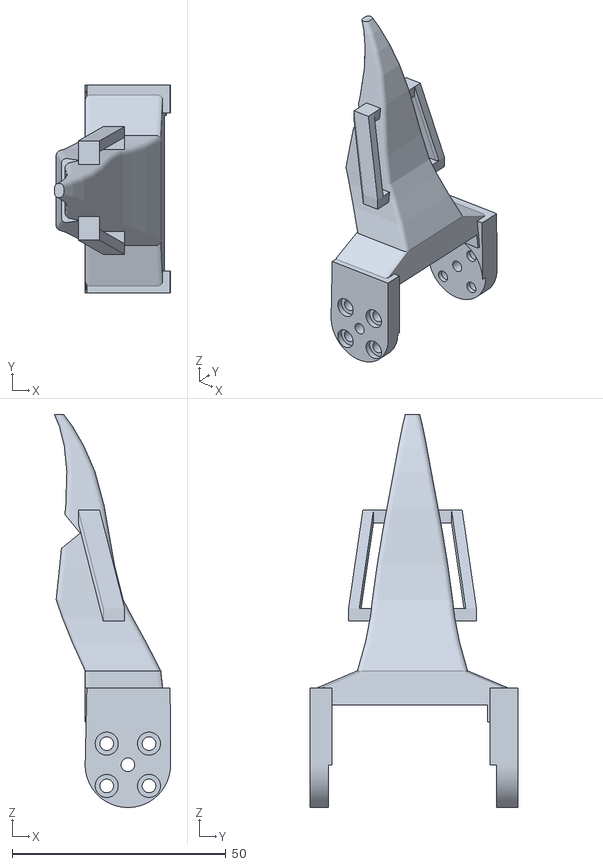
[picture p267: CAD file, 2026-10-14]
cad/openscad/crow/export/lower.stl
27.2 x 48.7 x 92.0
