JacobSchantz/HelpingHands/cad/openscad/demo_gripper/export/gen_01_left_root.stl

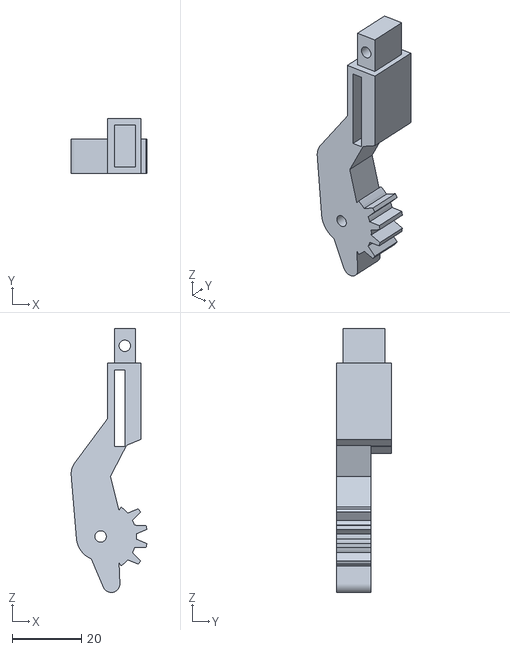
[picture p268: CAD file, 2026-10-16]
cad/openscad/demo_gripper/export/gen_01_left_root.stl
21.9 x 16.0 x 76.1
