JacobSchantz/HelpingHands/cad/openscad/hand_gripper/export/jaw_finger.stl

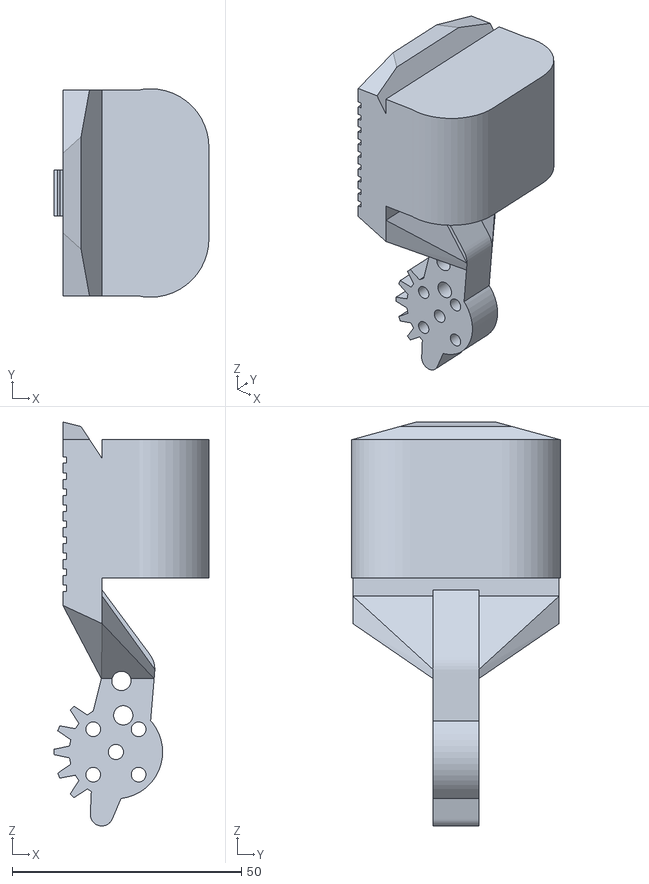
[picture p269: CAD file, 2026-10-14]
cad/openscad/hand_gripper/export/jaw_finger.stl
33.8 x 45.5 x 88.2
