JacobSchantz/HelpingHands/Two Finger Gripper/studies/voice-550038ca-four-post-cap/exports/parts/top_plate.stl

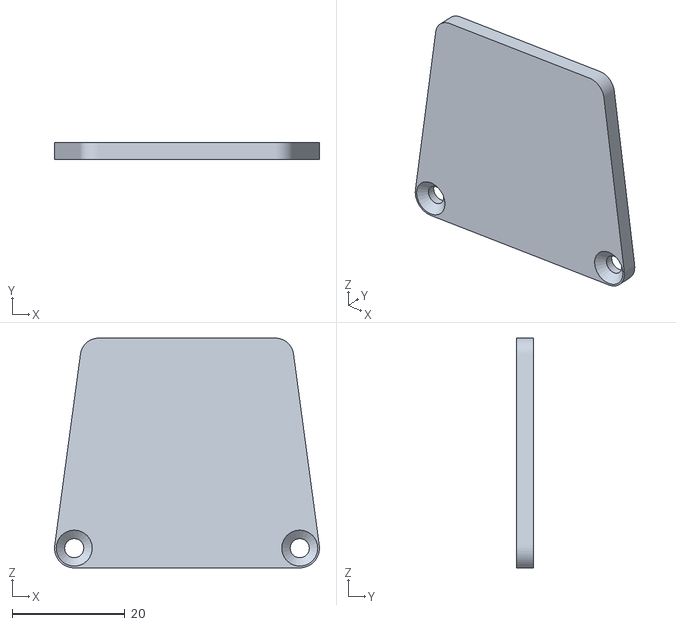
[picture p270: CAD file, 2026-10-23]
Two Finger Gripper/studies/voice-550038ca-four-post-cap/exports/parts/top_plate.stl
47.0 x 3.00 x 40.8
