JacobSchantz/HelpingHands/Two Finger Gripper/versions/v317_generalist_micro_tweezers/exports/parts/case_heads.stl

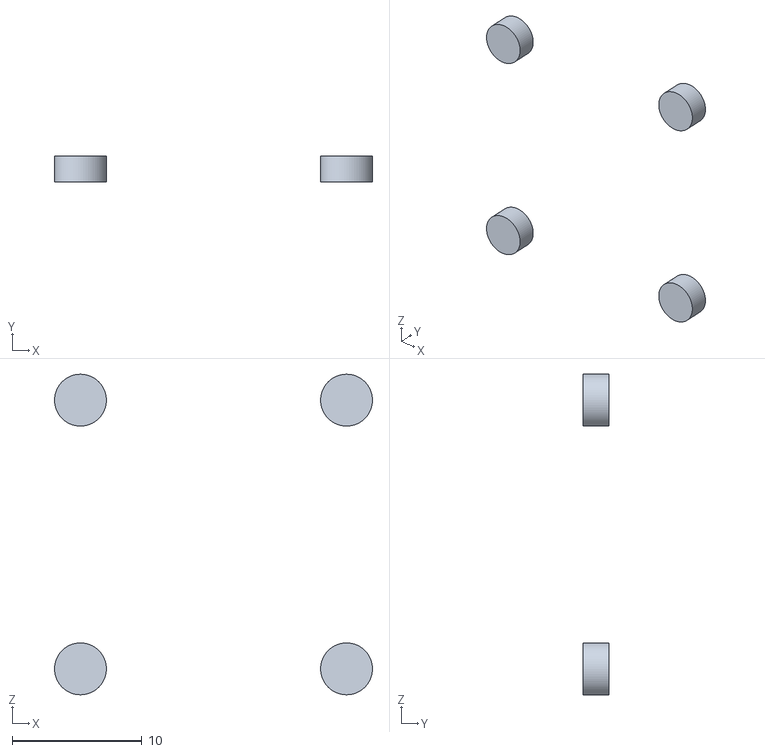
[picture p271: CAD file, 2026-10-23]
Two Finger Gripper/versions/v317_generalist_micro_tweezers/exports/parts/case_heads.stl
24.5 x 2.00 x 24.7
