JacobSchantz/HelpingHands/Two Finger Gripper/versions/v320_generalist_overhead_drive/exports/reference/cable.stl

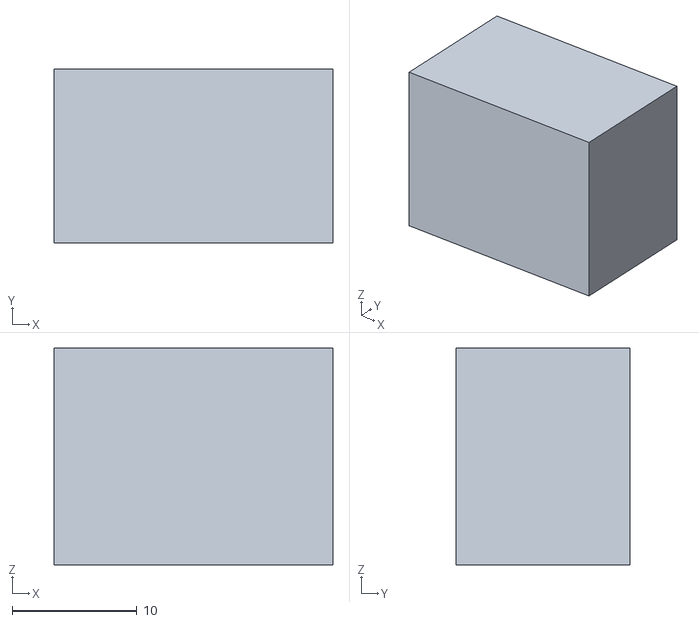
[picture p272: CAD file, 2026-10-23]
Two Finger Gripper/versions/v320_generalist_overhead_drive/exports/reference/cable.stl
22.4 x 14.0 x 17.4
