JacobSchantz/HelpingHands/Two Finger Gripper/versions/v326_generalist_small_drive/exports/parts/base.stl

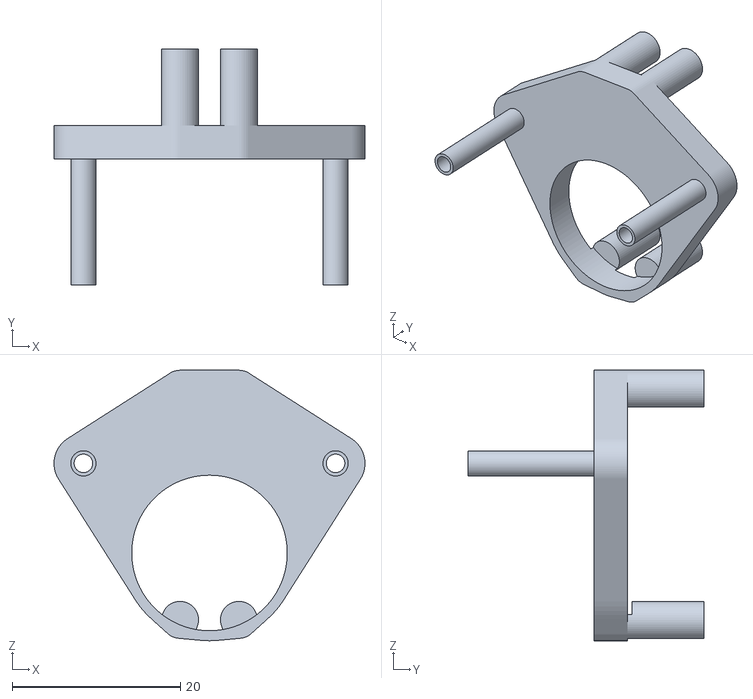
[picture p273: CAD file, 2026-10-23]
Two Finger Gripper/versions/v326_generalist_small_drive/exports/parts/base.stl
37.0 x 28.1 x 32.2
