JacobSchantz/HelpingHands/Two Finger Gripper/versions/v327_generalist_support_free/exports/parts/left.stl

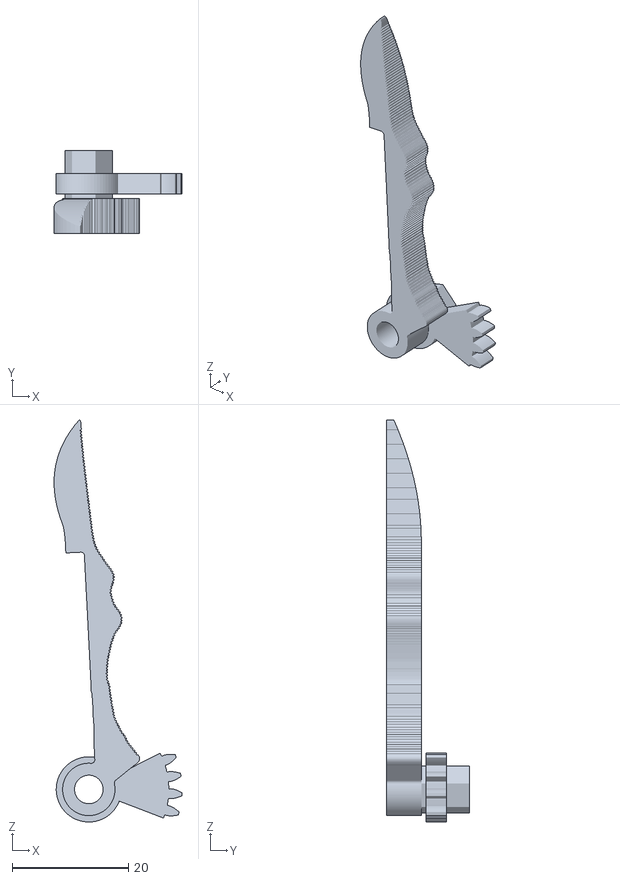
[picture p274: CAD file, 2026-10-24]
Two Finger Gripper/versions/v327_generalist_support_free/exports/parts/left.stl
22.0 x 14.3 x 69.0
