JacobSchantz/HelpingHands/Two Finger Gripper/versions/v328_generalist_five_piece/exports/reference/case_tools.stl

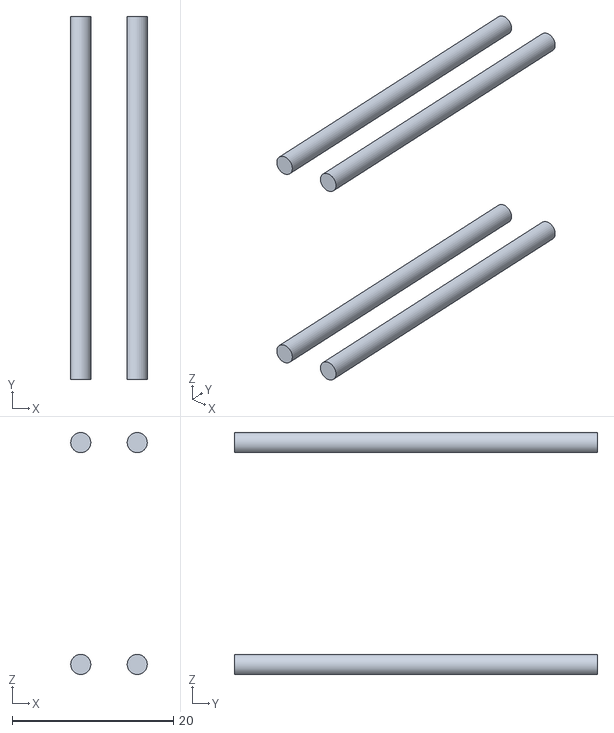
[picture p275: CAD file, 2026-10-24]
Two Finger Gripper/versions/v328_generalist_five_piece/exports/reference/case_tools.stl
9.50 x 45.0 x 30.0
