JacobSchantz/HelpingHands/cad/arm/rebot_b601_rs/meshes/shared/link1.STL

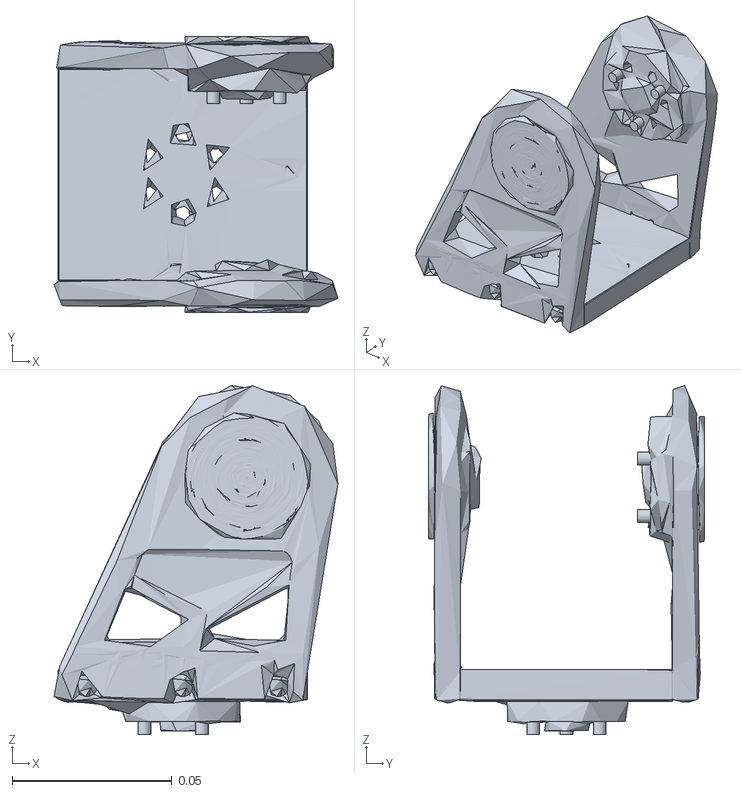
[picture p276: CAD file, 2026-10-20]
cad/arm/rebot_b601_rs/meshes/shared/link1.STL
0.0889 x 0.0866 x 0.109
