JacobSchantz/HelpingHands/cad/arm/rebot_b601_rs/meshes_preview/shared/gripper_right.STL

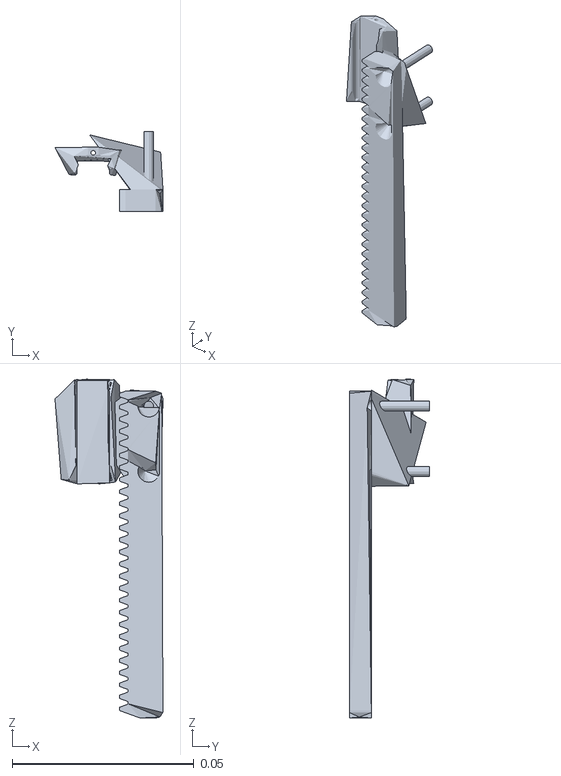
[picture p278: CAD file, 2026-10-20]
cad/arm/rebot_b601_rs/meshes_preview/shared/gripper_right.STL
0.0297 x 0.022 x 0.0933
