JacobSchantz/HelpingHands/cad/arm/rebot_b601_rs/meshes_preview/visual/pla3_seeed_badge_with_counters.STL

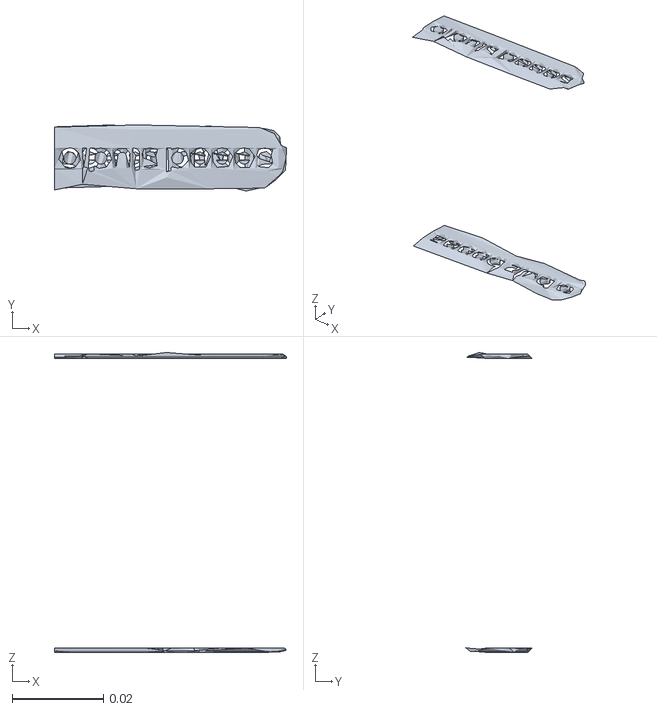
[picture p279: CAD file, 2026-10-20]
cad/arm/rebot_b601_rs/meshes_preview/visual/pla3_seeed_badge_with_counters.STL
0.0509 x 0.0145 x 0.0658
