JacobSchantz/HelpingHands/cad/arm/so101/assets/base_motor_holder_so101_v1.stl

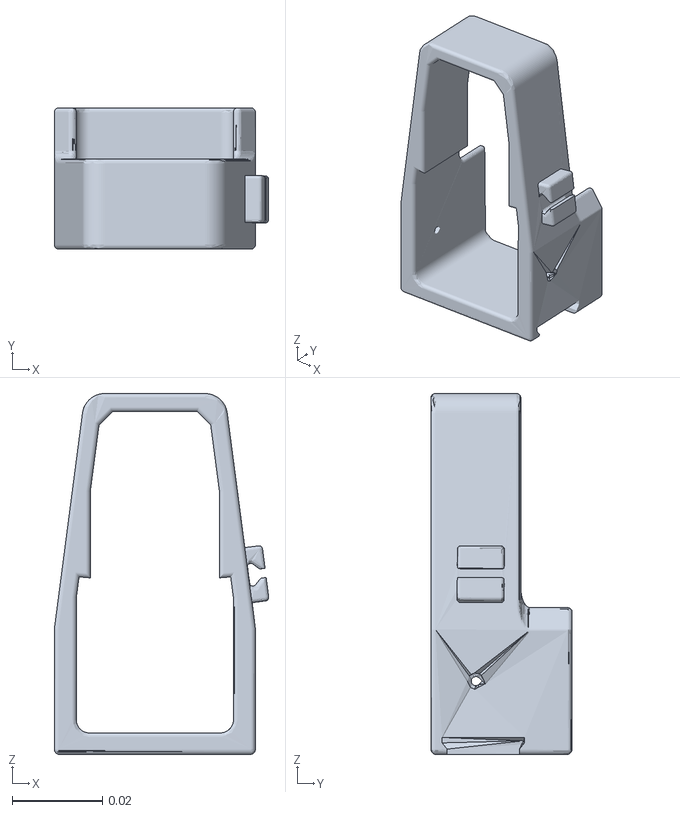
[picture p280: CAD file, 2026-10-20]
cad/arm/so101/assets/base_motor_holder_so101_v1.stl
0.0476 x 0.0314 x 0.0802
