JacobSchantz/HelpingHands/cad/arm/so101/assets_preview/sts3215_03a_v1.stl

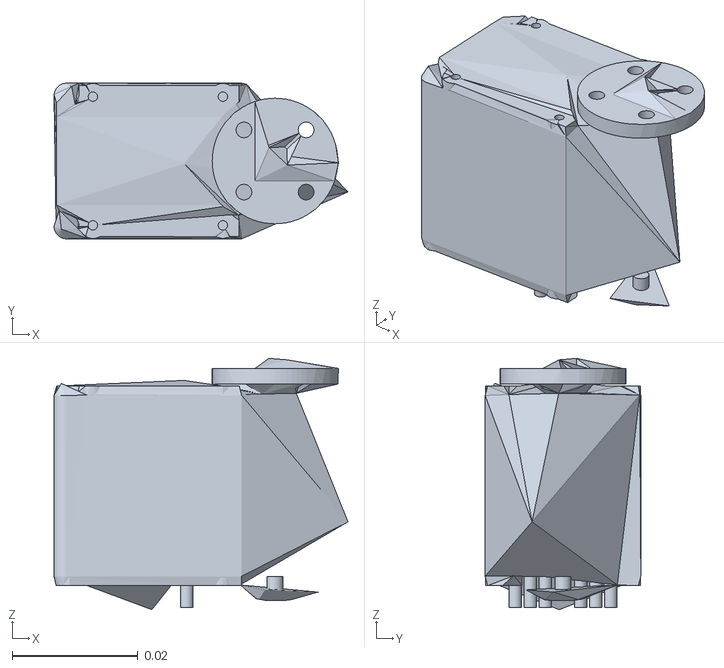
[picture p281: CAD file, 2026-10-20]
cad/arm/so101/assets_preview/sts3215_03a_v1.stl
0.0468 x 0.0248 x 0.04
