JacobSchantz/HelpingHands/cad/blender/out/fixed_jaw.stl

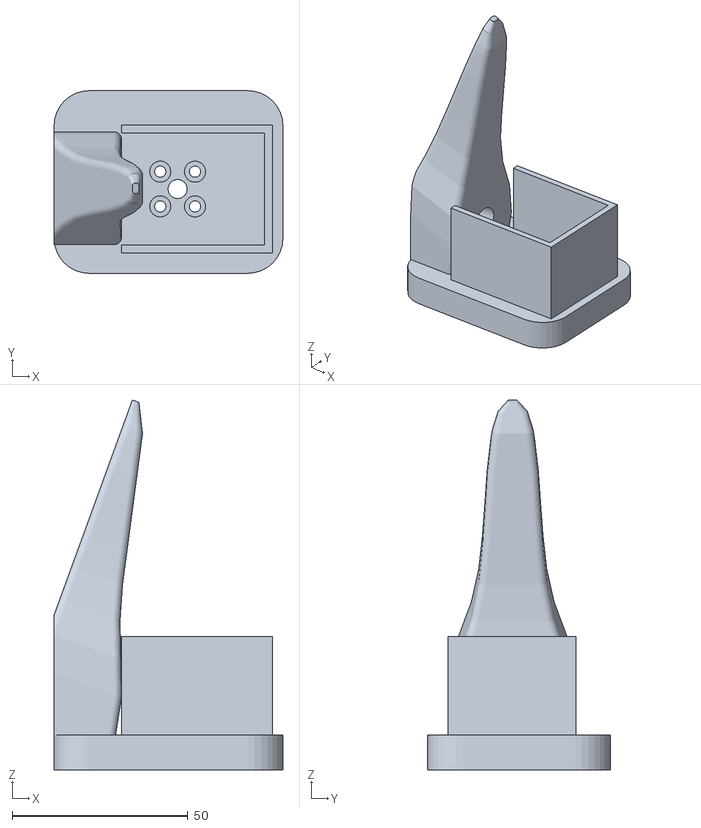
[picture p282: CAD file, 2026-09-14]
cad/blender/out/fixed_jaw.stl
65.2 x 52.0 x 105.3
