JacobSchantz/HelpingHands/cad/build123d/export/so101_gripper_closed.step

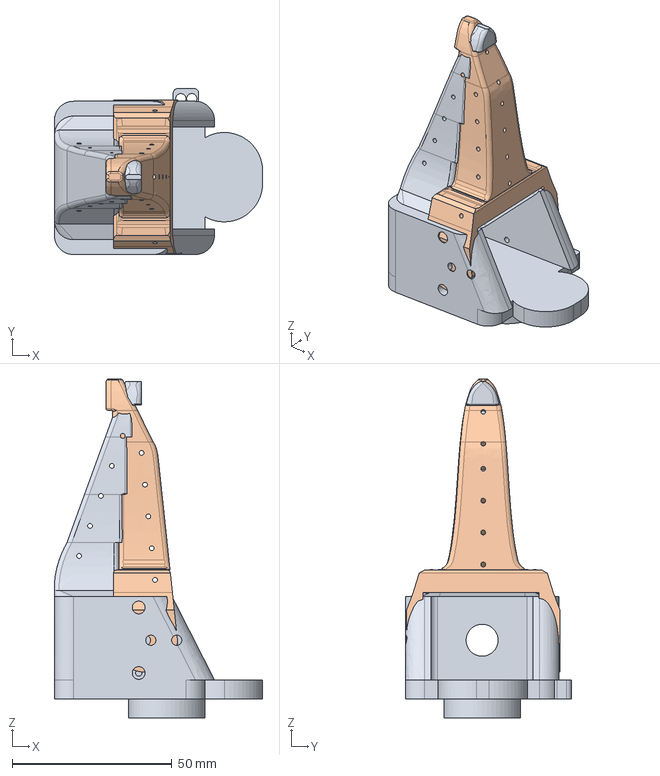
[picture p283: CAD file, 2026-09-14]
cad/build123d/export/so101_gripper_closed.step
65.2 x 52.0 x 106.2 mm
fixed_jaw
moving_jaw
