JacobSchantz/HelpingHands/cad/openscad/crow/export/pivot_plug.stl

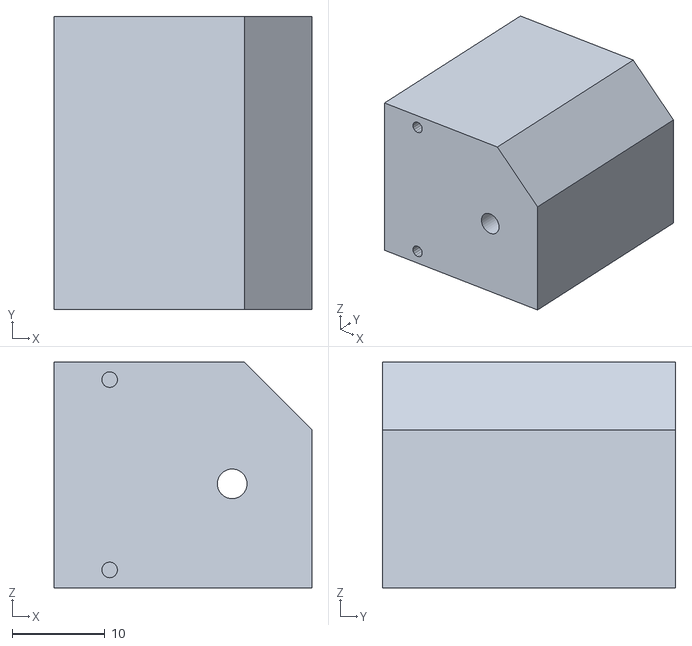
[picture p284: CAD file, 2026-10-14]
cad/openscad/crow/export/pivot_plug.stl
27.8 x 31.6 x 24.4
