JacobSchantz/HelpingHands/cad/openscad/hand_gripper/export/hub.stl

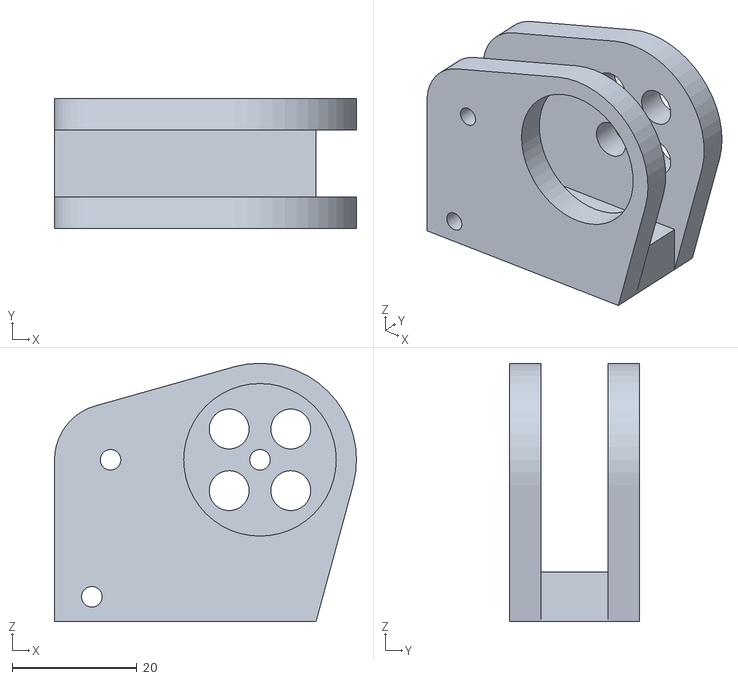
[picture p285: CAD file, 2026-10-14]
cad/openscad/hand_gripper/export/hub.stl
48.5 x 20.8 x 41.5
