JacobSchantz/HelpingHands/Two Finger Gripper/versions/v317_generalist_micro_tweezers/exports/parts/coupler.stl

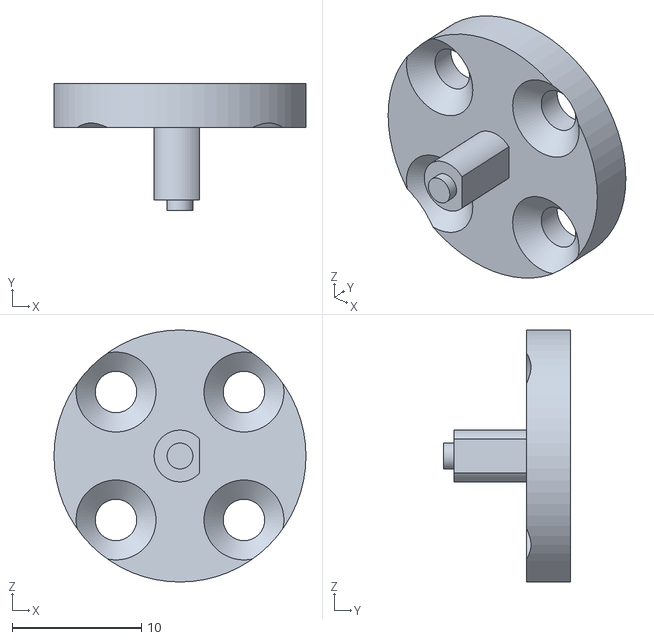
[picture p286: CAD file, 2026-10-23]
Two Finger Gripper/versions/v317_generalist_micro_tweezers/exports/parts/coupler.stl
19.5 x 9.80 x 19.5
