JacobSchantz/HelpingHands/Two Finger Gripper/versions/v318_generalist_tiny_v2/exports/reference/actual_sts3215.stl

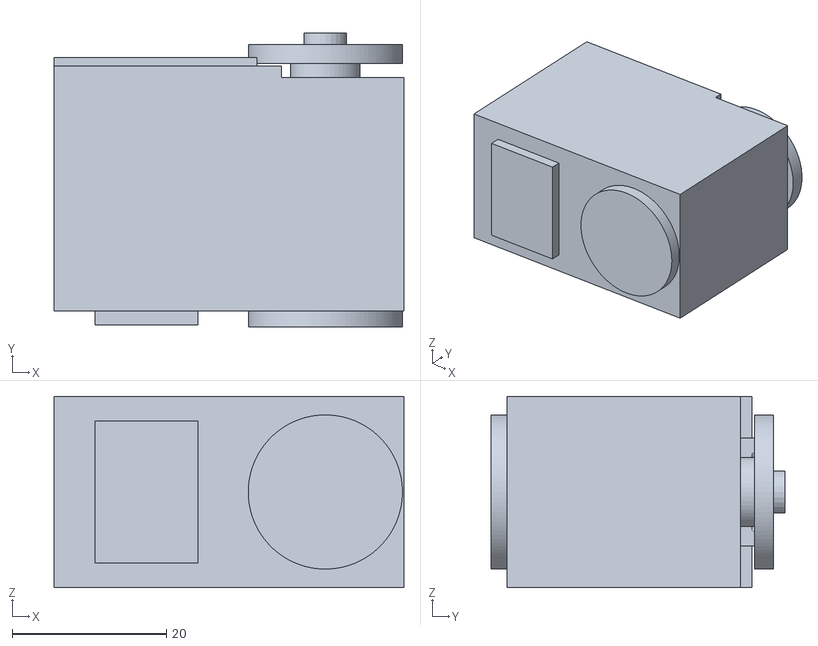
[picture p287: CAD file, 2026-10-23]
Two Finger Gripper/versions/v318_generalist_tiny_v2/exports/reference/actual_sts3215.stl
45.4 x 38.2 x 24.8
