JacobSchantz/HelpingHands/Two Finger Gripper/versions/v320_generalist_overhead_drive/exports/parts/right_gear.stl

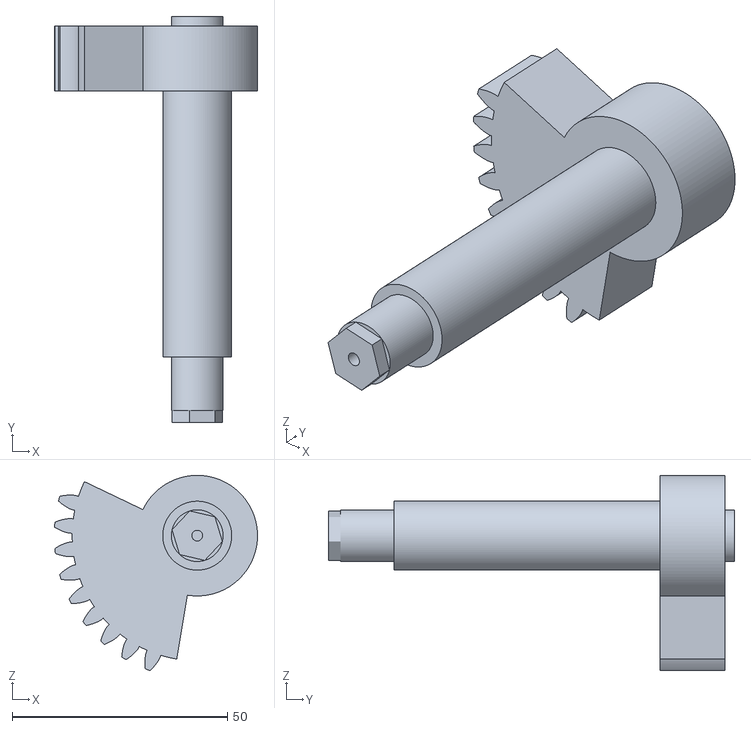
[picture p288: CAD file, 2026-10-23]
Two Finger Gripper/versions/v320_generalist_overhead_drive/exports/parts/right_gear.stl
47.1 x 94.2 x 45.3
