JacobSchantz/HelpingHands/Two Finger Gripper/versions/v321_generalist_compact_overhead/exports/parts/right_gear.stl

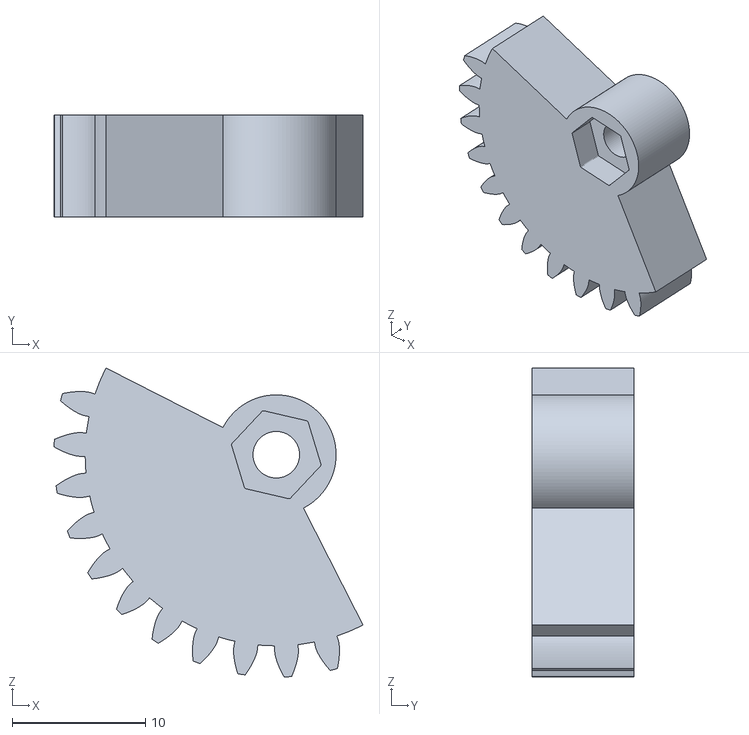
[picture p289: CAD file, 2026-10-23]
Two Finger Gripper/versions/v321_generalist_compact_overhead/exports/parts/right_gear.stl
23.2 x 7.70 x 23.2
