JacobSchantz/HelpingHands/Two Finger Gripper/versions/v325_generalist_original_tip_closure/exports/parts/base.stl

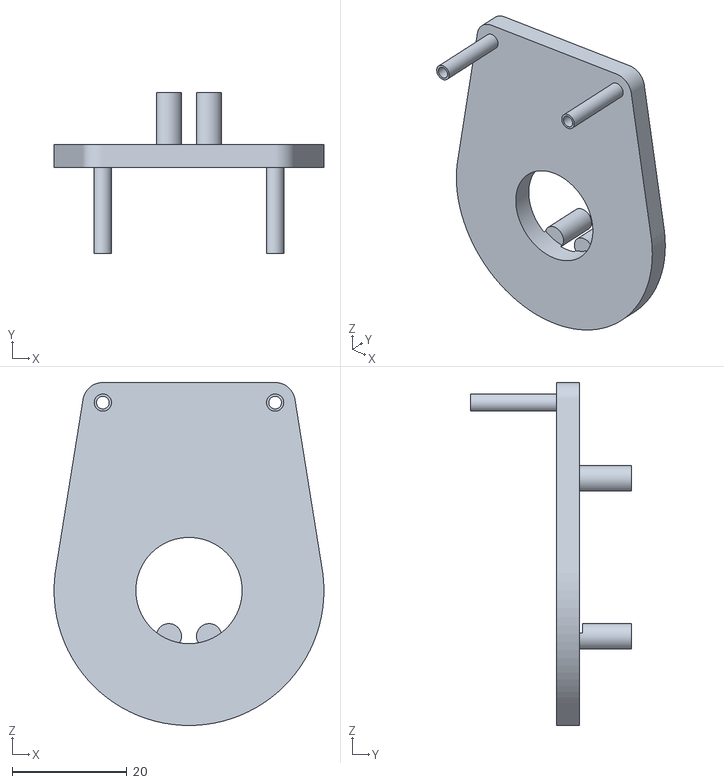
[picture p290: CAD file, 2026-10-23]
Two Finger Gripper/versions/v325_generalist_original_tip_closure/exports/parts/base.stl
47.0 x 28.1 x 59.7
