JacobSchantz/HelpingHands/Two Finger Gripper/versions/v327_generalist_support_free/exports/parts/right_upper.stl

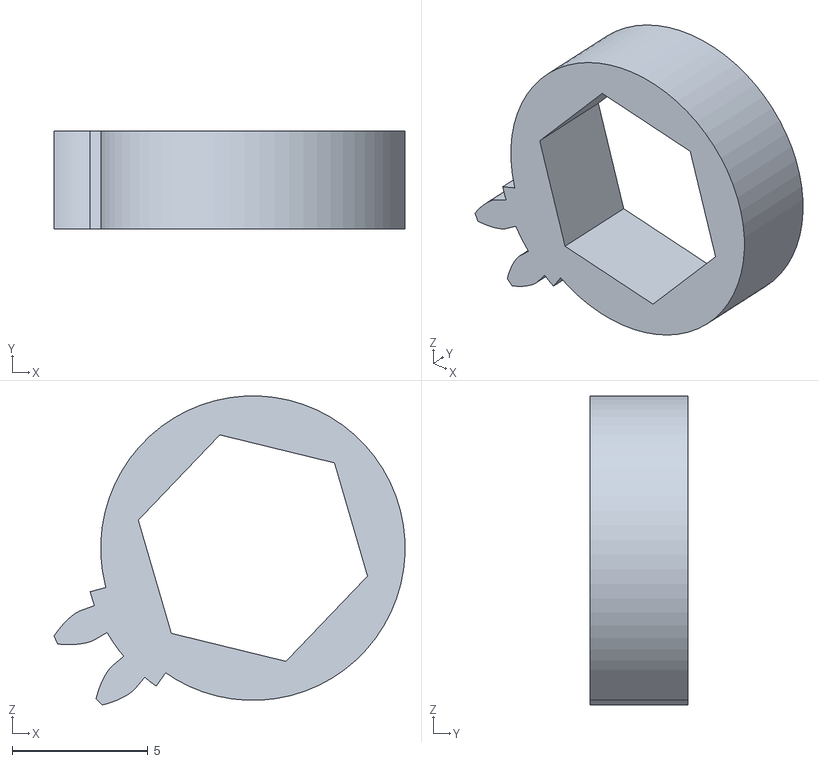
[picture p291: CAD file, 2026-10-24]
Two Finger Gripper/versions/v327_generalist_support_free/exports/parts/right_upper.stl
12.9 x 3.60 x 11.4
