JacobSchantz/HelpingHands/Two Finger Gripper/versions/v328_generalist_five_piece/exports/parts/base.stl

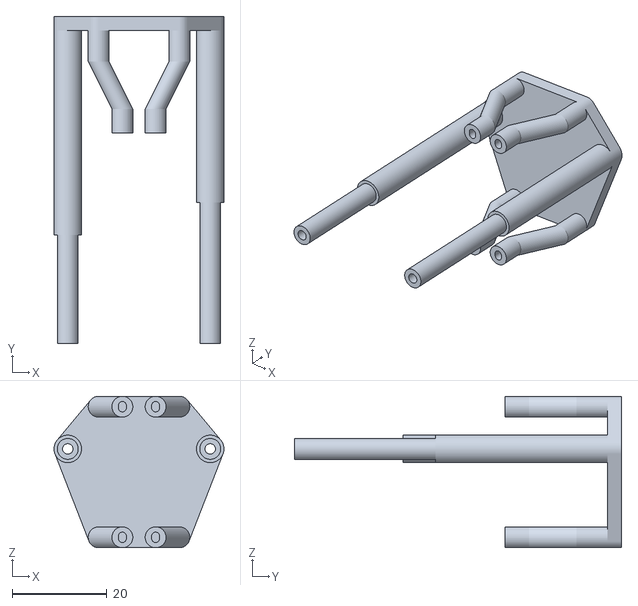
[picture p292: CAD file, 2026-10-24]
Two Finger Gripper/versions/v328_generalist_five_piece/exports/parts/base.stl
35.8 x 68.9 x 31.9
