JacobSchantz/HelpingHands/cad/arm/rebot_b601_rs/meshes/shared/link3.STL

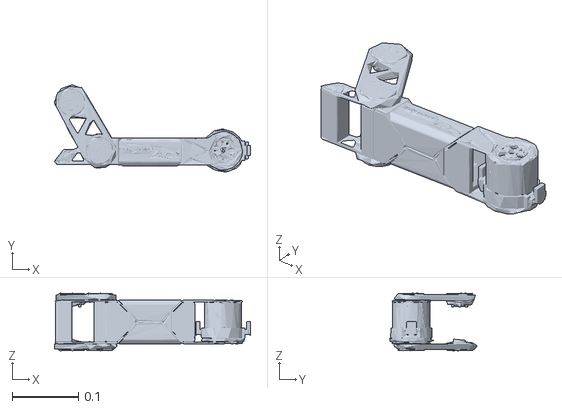
[picture p293: CAD file, 2026-10-20]
cad/arm/rebot_b601_rs/meshes/shared/link3.STL
0.295 x 0.132 x 0.0866
