JacobSchantz/HelpingHands/cad/arm/rebot_b601_rs/meshes/visual/motor_5.STL

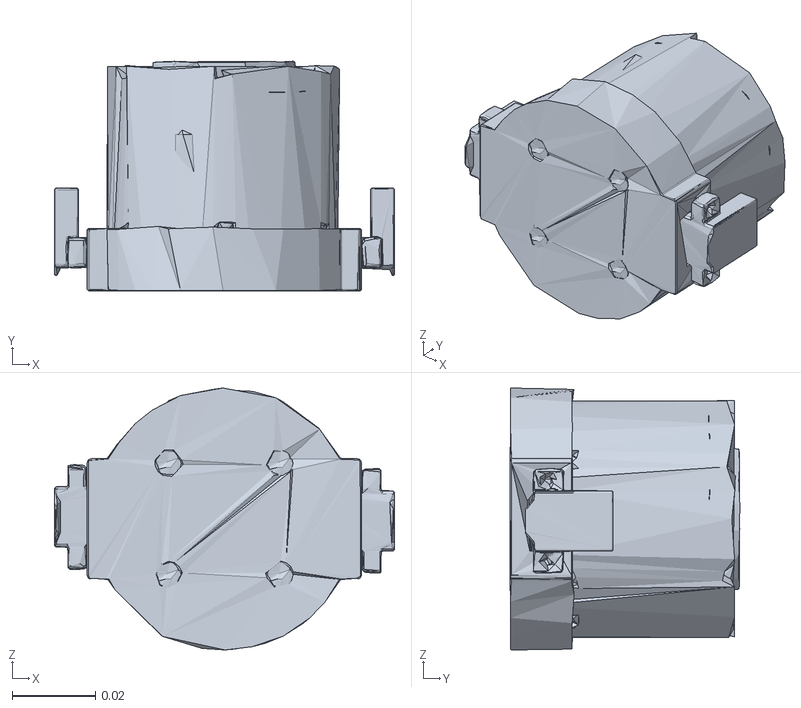
[picture p294: CAD file, 2026-10-20]
cad/arm/rebot_b601_rs/meshes/visual/motor_5.STL
0.0818 x 0.0553 x 0.063
