JacobSchantz/HelpingHands/cad/arm/rebot_b601_rs/meshes_preview/shared/gripper_left.STL

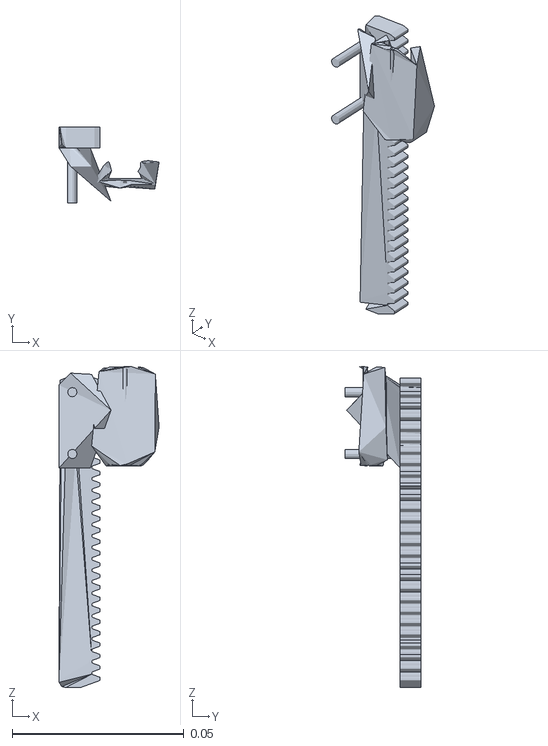
[picture p295: CAD file, 2026-10-20]
cad/arm/rebot_b601_rs/meshes_preview/shared/gripper_left.STL
0.0291 x 0.022 x 0.0934
