JacobSchantz/HelpingHands/cad/arm/rebot_b601_rs/meshes_preview/visual/cnc3.STL

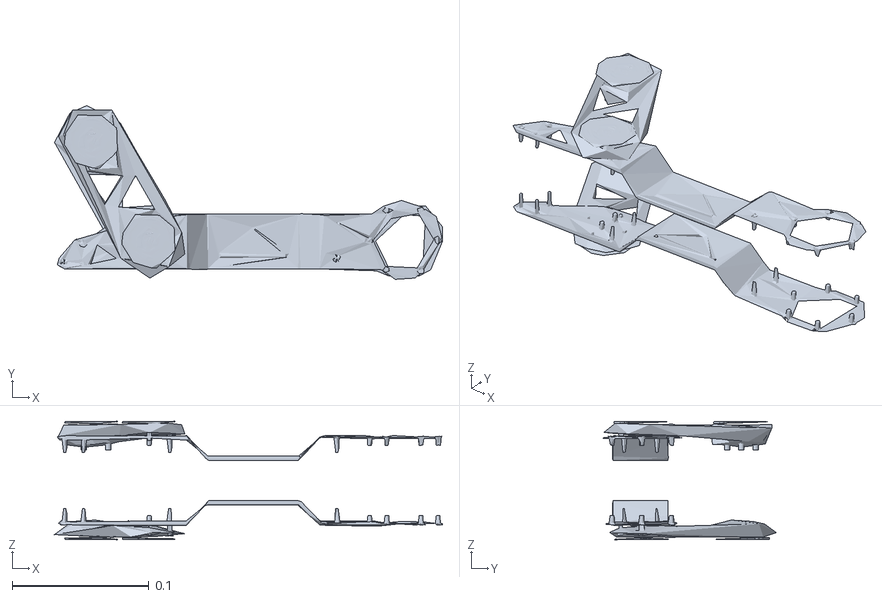
[picture p296: CAD file, 2026-10-20]
cad/arm/rebot_b601_rs/meshes_preview/visual/cnc3.STL
0.283 x 0.127 x 0.0865
