JacobSchantz/HelpingHands/cad/arm/so101/assets_preview/moving_jaw_so101_v1.stl

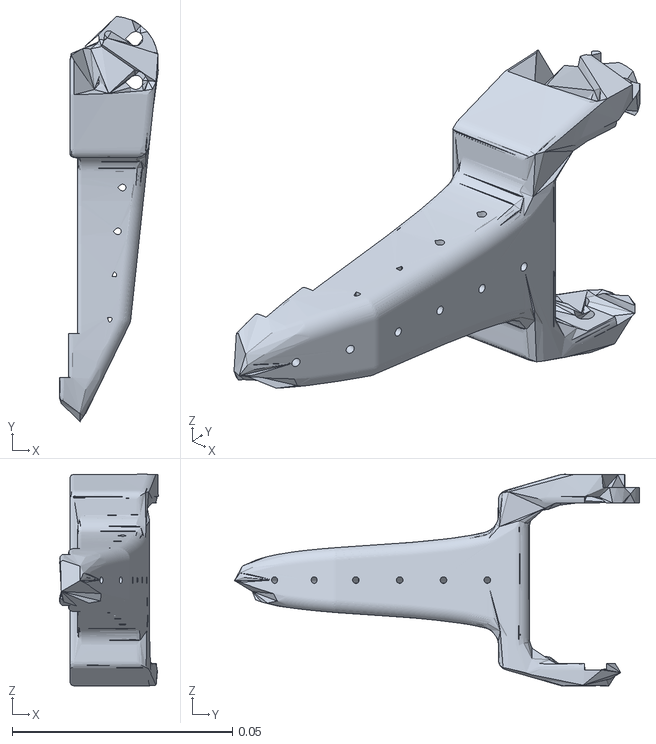
[picture p297: CAD file, 2026-10-20]
cad/arm/so101/assets_preview/moving_jaw_so101_v1.stl
0.0224 x 0.0919 x 0.048
