JacobSchantz/HelpingHands/cad/openscad/crow/export/handle.stl

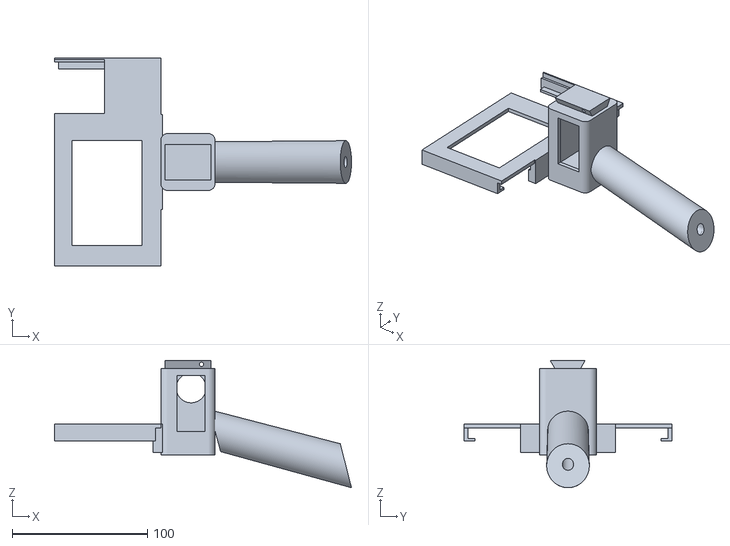
[picture p298: CAD file, 2026-09-30]
cad/openscad/crow/export/handle.stl
219.4 x 153.6 x 94.1
