JacobSchantz/HelpingHands/cad/openscad/demo_gripper/export/gen_01_right_root.stl

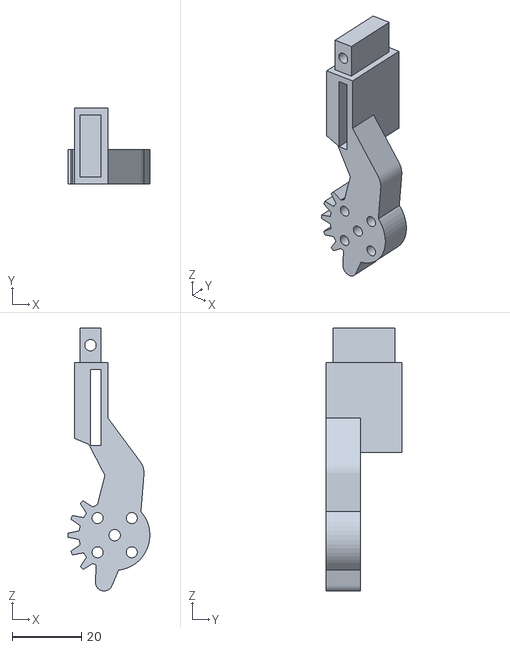
[picture p299: CAD file, 2026-10-16]
cad/openscad/demo_gripper/export/gen_01_right_root.stl
23.7 x 22.0 x 76.1
