JacobSchantz/HelpingHands/cad/openscad/hand_gripper/export/camera.stl

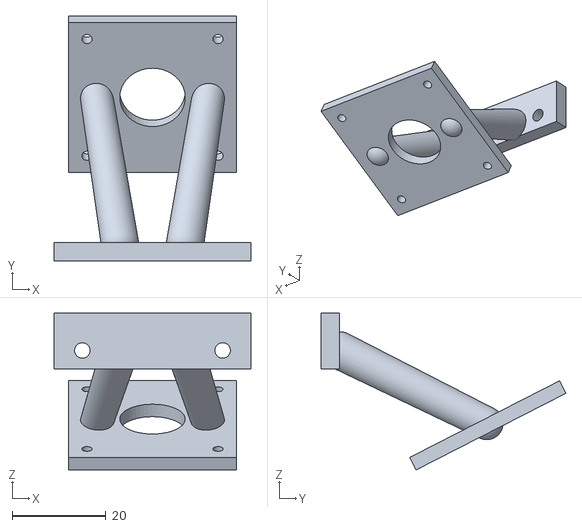
[picture p300: CAD file, 2026-10-14]
cad/openscad/hand_gripper/export/camera.stl
42.0 x 52.4 x 33.5
