JacobSchantz/HelpingHands/Two Finger Gripper/studies/voice-550038ca-four-post-cap/exports/parts/base.stl

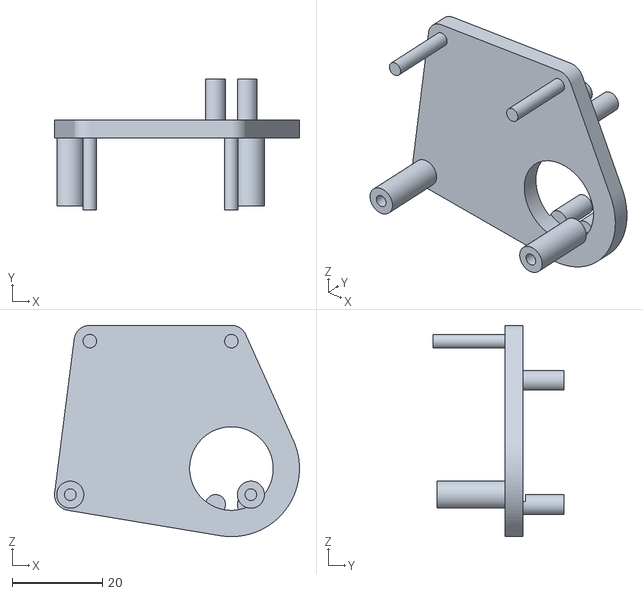
[picture p301: CAD file, 2026-10-23]
Two Finger Gripper/studies/voice-550038ca-four-post-cap/exports/parts/base.stl
54.3 x 29.0 x 46.8
