JacobSchantz/HelpingHands/Two Finger Gripper/versions/v317_generalist_micro_tweezers/exports/parts/left.stl

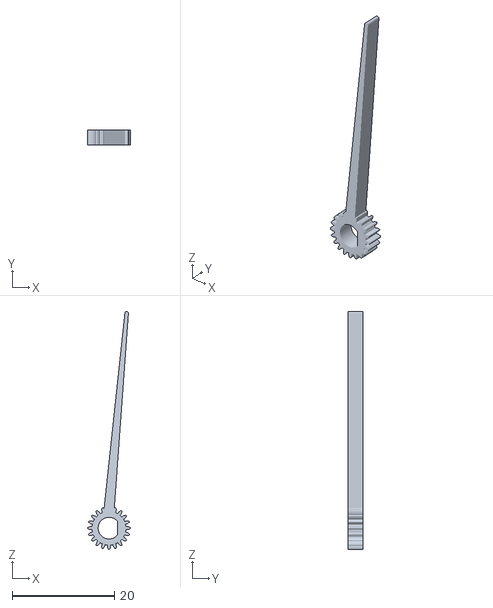
[picture p302: CAD file, 2026-10-23]
Two Finger Gripper/versions/v317_generalist_micro_tweezers/exports/parts/left.stl
8.36 x 3.00 x 46.5
