JacobSchantz/HelpingHands/Two Finger Gripper/versions/v318_generalist_tiny_v2/exports/reference/cable.stl

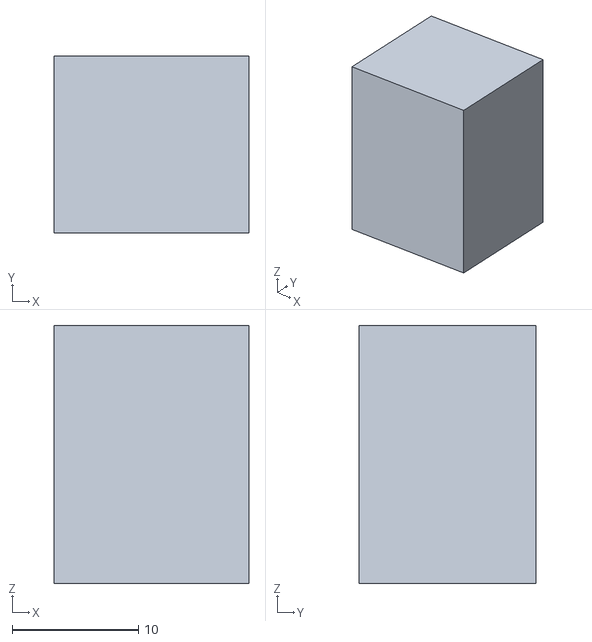
[picture p303: CAD file, 2026-10-23]
Two Finger Gripper/versions/v318_generalist_tiny_v2/exports/reference/cable.stl
15.4 x 14.0 x 20.4
