JacobSchantz/HelpingHands/Two Finger Gripper/versions/v324_generalist_contact_close/exports/parts/left.stl

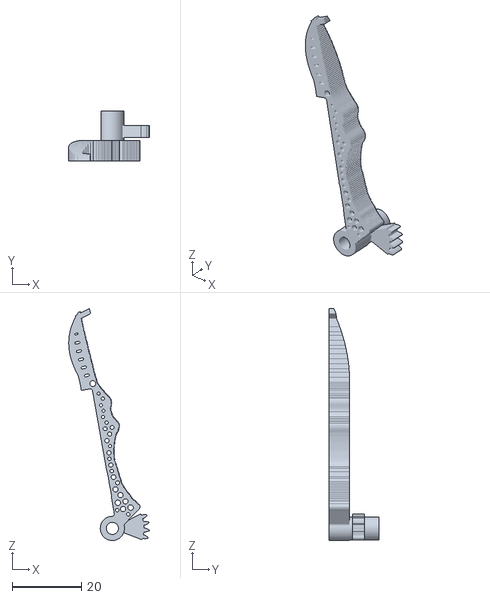
[picture p305: CAD file, 2026-10-23]
Two Finger Gripper/versions/v324_generalist_contact_close/exports/parts/left.stl
23.3 x 14.5 x 66.9
