JacobSchantz/HelpingHands/Two Finger Gripper/versions/v327_generalist_support_free/exports/parts/base.stl

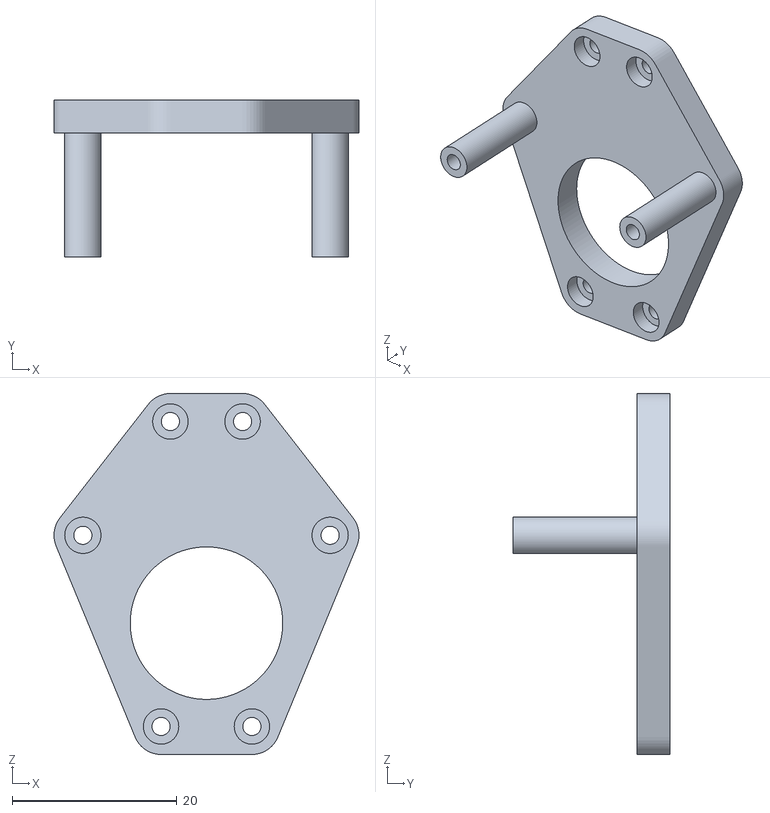
[picture p306: CAD file, 2026-10-24]
Two Finger Gripper/versions/v327_generalist_support_free/exports/parts/base.stl
37.0 x 19.0 x 43.8
