JacobSchantz/HelpingHands/Two Finger Gripper/versions/v328_generalist_five_piece/exports/parts/left.stl

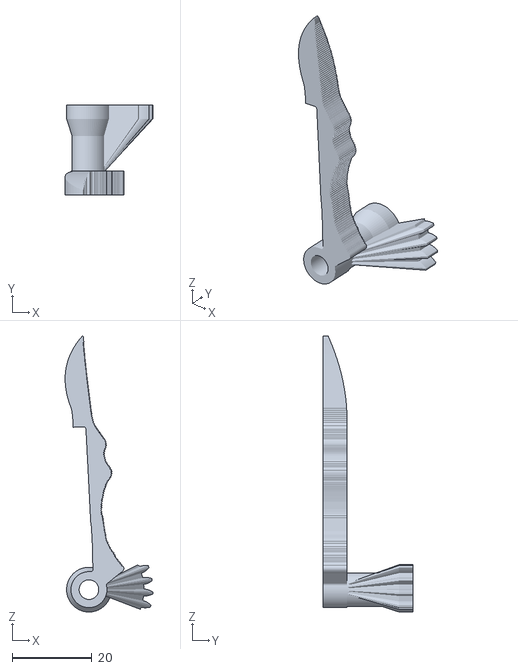
[picture p307: CAD file, 2026-10-24]
Two Finger Gripper/versions/v328_generalist_five_piece/exports/parts/left.stl
22.0 x 22.5 x 69.0
