JacobSchantz/HelpingHands/Two Finger Gripper/versions/v328_generalist_five_piece/exports/reference/center_tools.stl

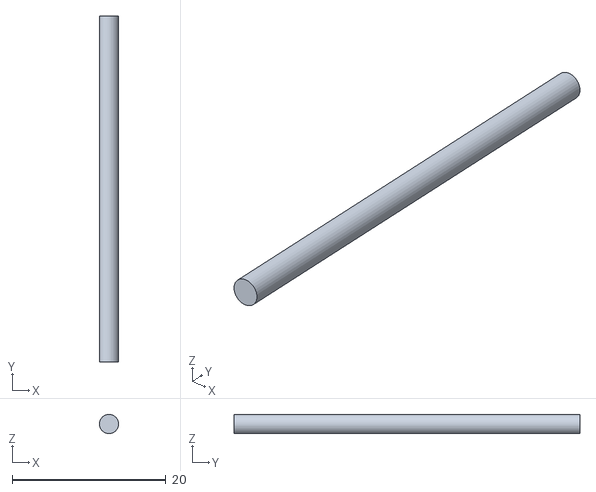
[picture p308: CAD file, 2026-10-24]
Two Finger Gripper/versions/v328_generalist_five_piece/exports/reference/center_tools.stl
2.50 x 45.0 x 2.50
