JacobSchantz/HelpingHands/cad/arm/rebot_b601_rs/meshes/shared/gripper_right.STL

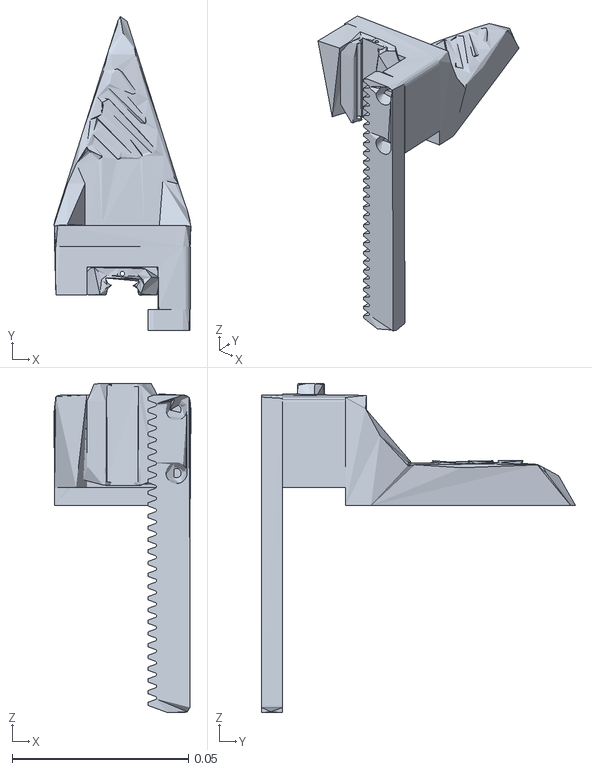
[picture p309: CAD file, 2026-10-20]
cad/arm/rebot_b601_rs/meshes/shared/gripper_right.STL
0.0388 x 0.089 x 0.0933
