JacobSchantz/HelpingHands/cad/arm/rebot_b601_rs/meshes/visual/motor_2_3.STL

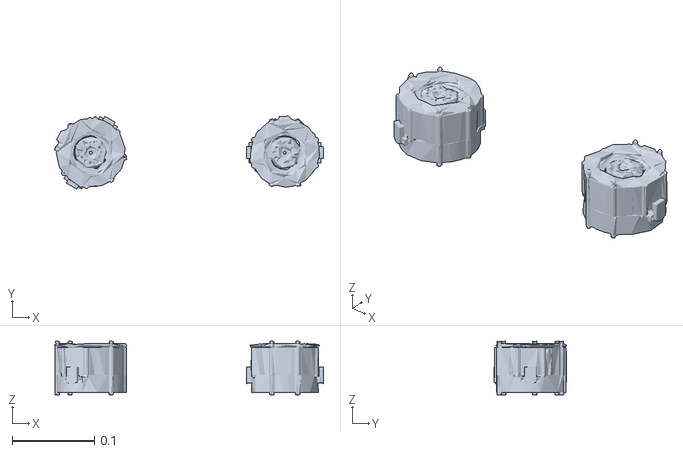
[picture p310: CAD file, 2026-10-20]
cad/arm/rebot_b601_rs/meshes/visual/motor_2_3.STL
0.327 x 0.0886 x 0.0653
