JacobSchantz/HelpingHands/cad/arm/rebot_b601_rs/meshes_preview/shared/link1.STL

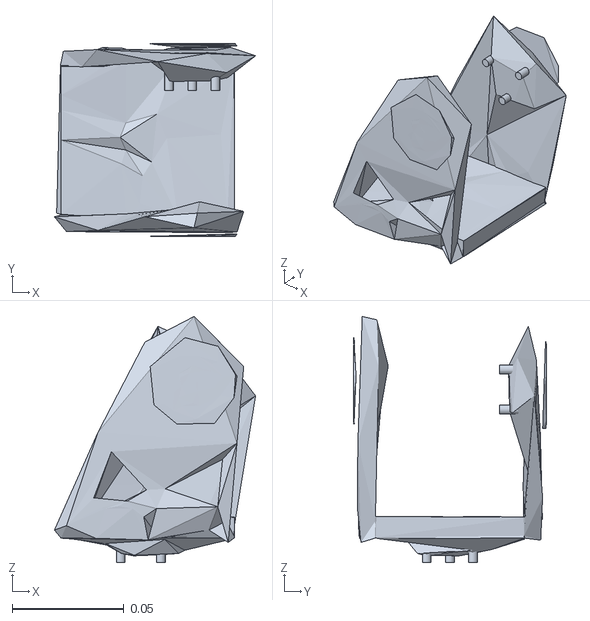
[picture p311: CAD file, 2026-10-20]
cad/arm/rebot_b601_rs/meshes_preview/shared/link1.STL
0.0901 x 0.0865 x 0.11
