JacobSchantz/HelpingHands/cad/arm/rebot_b601_rs/meshes_preview/visual/cnc2.STL

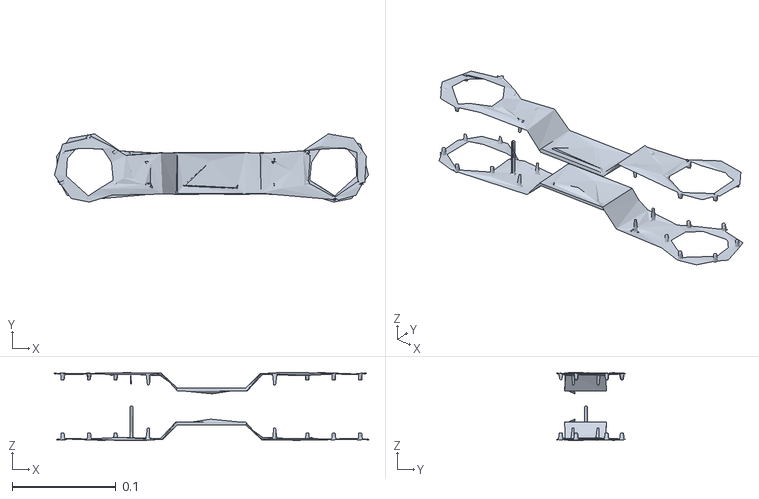
[picture p312: CAD file, 2026-10-20]
cad/arm/rebot_b601_rs/meshes_preview/visual/cnc2.STL
0.303 x 0.0658 x 0.0657
