JacobSchantz/HelpingHands/cad/openscad/crow/export/trigger.stl

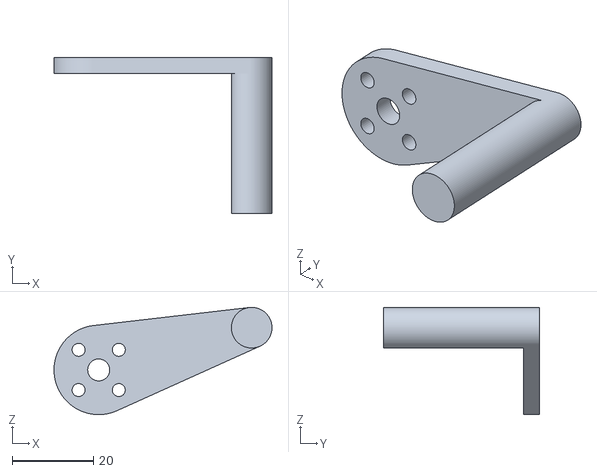
[picture p313: CAD file, 2026-09-30]
cad/openscad/crow/export/trigger.stl
53.6 x 38.5 x 26.4
