JacobSchantz/HelpingHands/cad/openscad/demo_gripper/export/gen_01_right_finger.stl

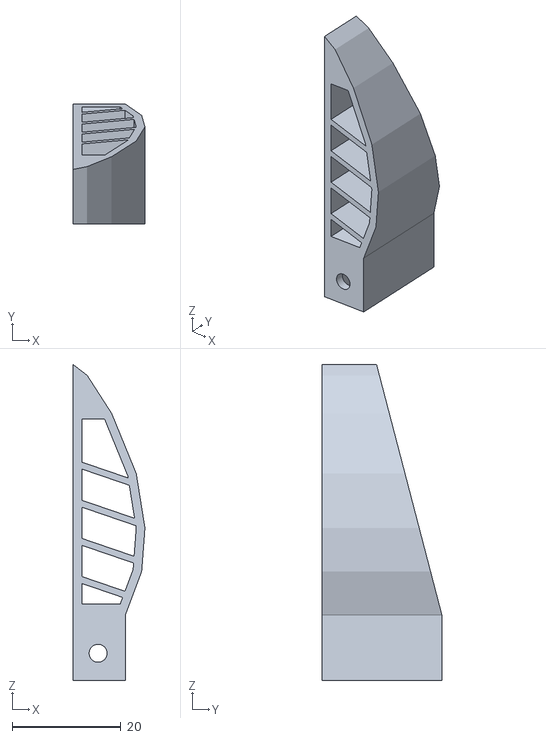
[picture p314: CAD file, 2026-10-16]
cad/openscad/demo_gripper/export/gen_01_right_finger.stl
13.2 x 22.0 x 58.0
