JacobSchantz/HelpingHands/cad/openscad/hand_gripper/export/jaw_thumb.stl

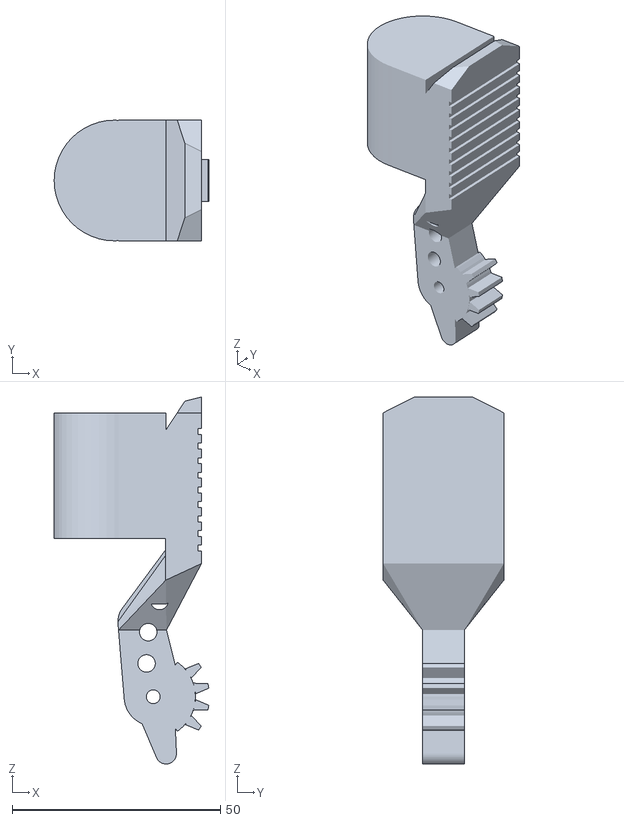
[picture p315: CAD file, 2026-10-14]
cad/openscad/hand_gripper/export/jaw_thumb.stl
37.2 x 29.0 x 88.2
