JacobSchantz/HelpingHands/Two Finger Gripper/versions/v320_generalist_overhead_drive/exports/parts/top_plate.stl

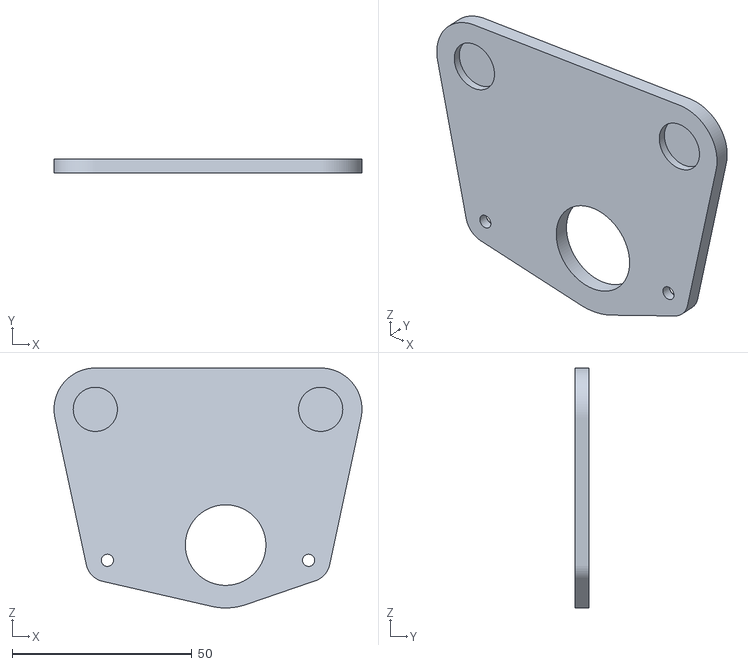
[picture p317: CAD file, 2026-10-23]
Two Finger Gripper/versions/v320_generalist_overhead_drive/exports/parts/top_plate.stl
85.7 x 4.00 x 66.8
