JacobSchantz/HelpingHands/Two Finger Gripper/versions/v321_generalist_compact_overhead/exports/reference/plate_tools.stl

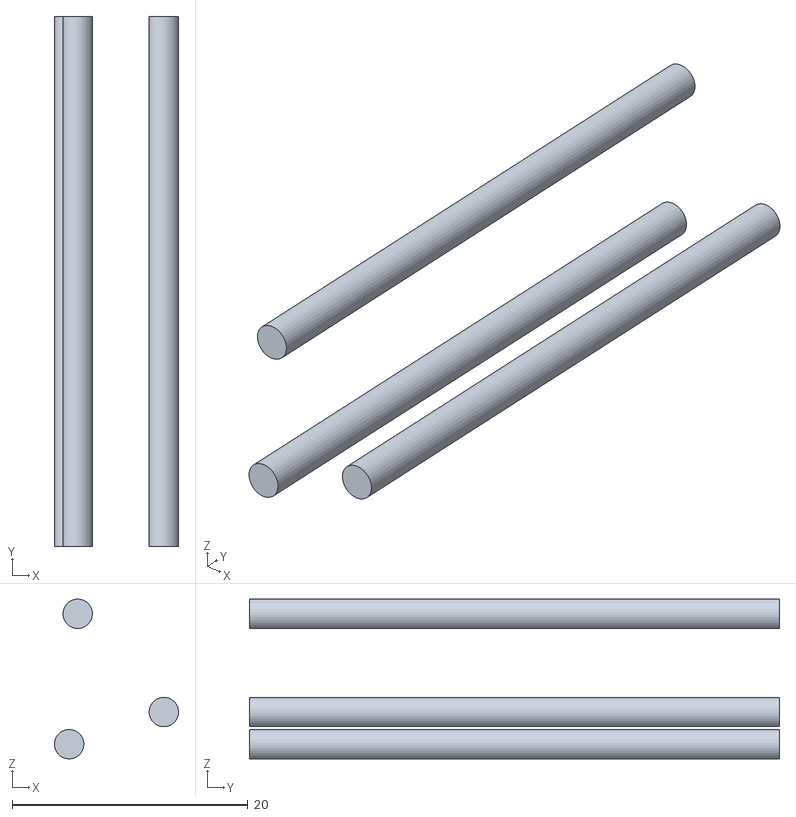
[picture p318: CAD file, 2026-10-23]
Two Finger Gripper/versions/v321_generalist_compact_overhead/exports/reference/plate_tools.stl
10.5 x 45.0 x 13.6
