JacobSchantz/HelpingHands/Two Finger Gripper/versions/v327_generalist_support_free/exports/parts/right.stl

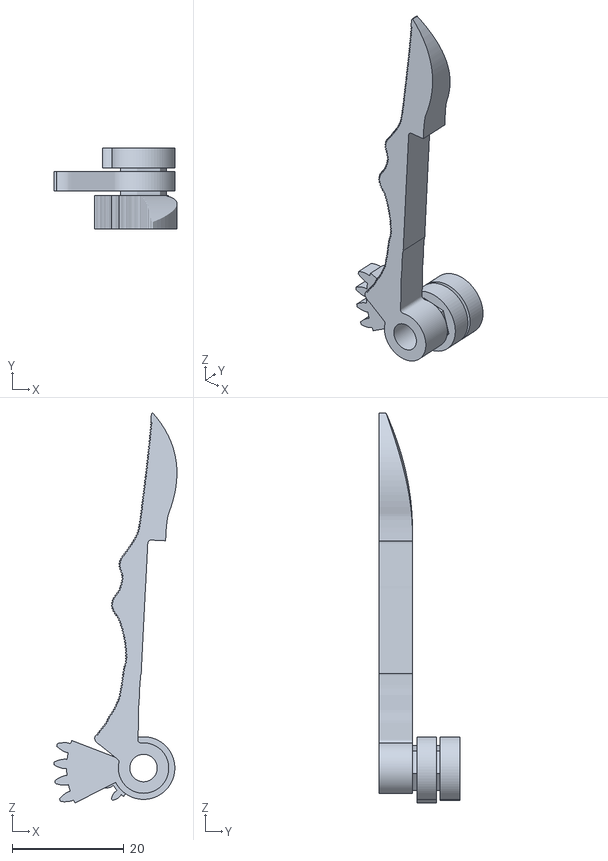
[picture p319: CAD file, 2026-10-24]
Two Finger Gripper/versions/v327_generalist_support_free/exports/parts/right.stl
22.0 x 14.5 x 69.7
