JacobSchantz/HelpingHands/Two Finger Gripper/versions/v328_generalist_five_piece/exports/parts/pinion.stl

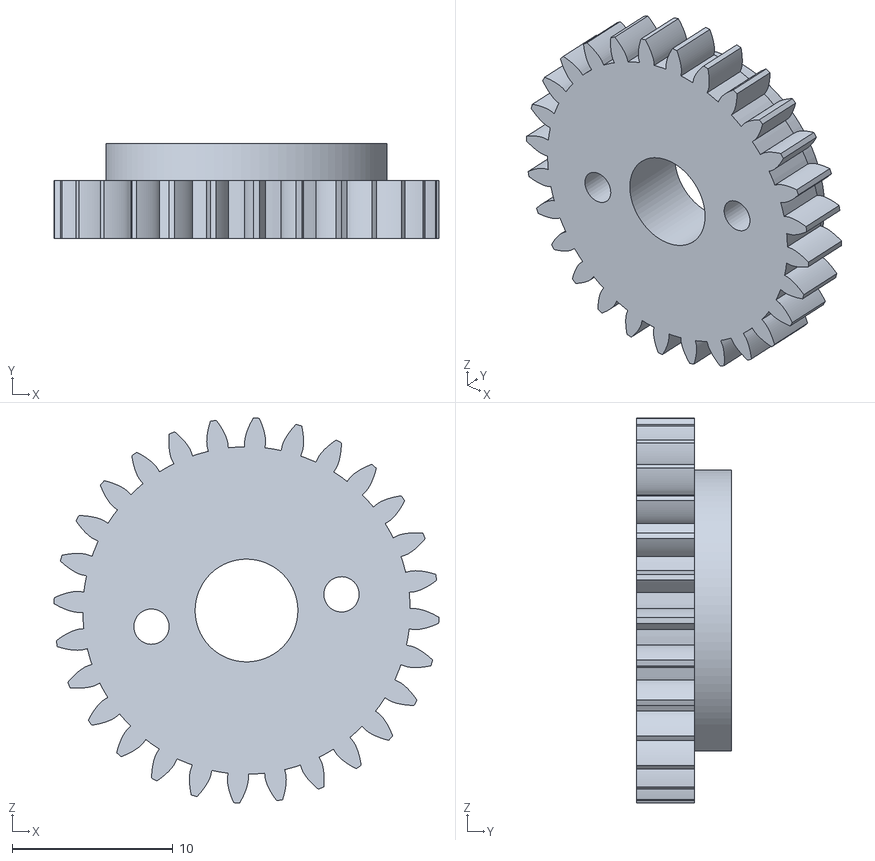
[picture p320: CAD file, 2026-10-24]
Two Finger Gripper/versions/v328_generalist_five_piece/exports/parts/pinion.stl
24.0 x 5.90 x 24.0
