JacobSchantz/HelpingHands/cad/arm/rebot_b601_rs/meshes/visual/cnc2.STL

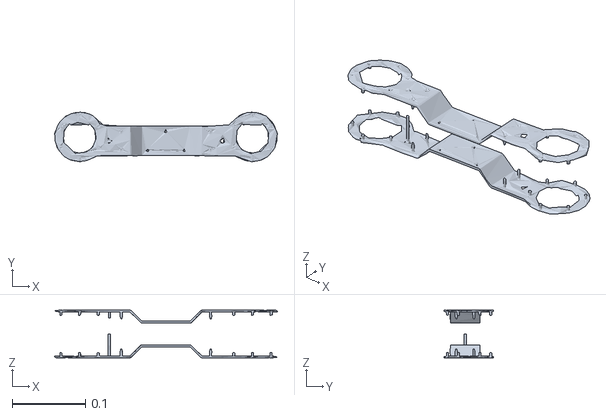
[picture p322: CAD file, 2026-10-20]
cad/arm/rebot_b601_rs/meshes/visual/cnc2.STL
0.304 x 0.0679 x 0.0655
