JacobSchantz/HelpingHands/cad/arm/rebot_b601_rs/meshes_preview/shared/gripper_end.STL

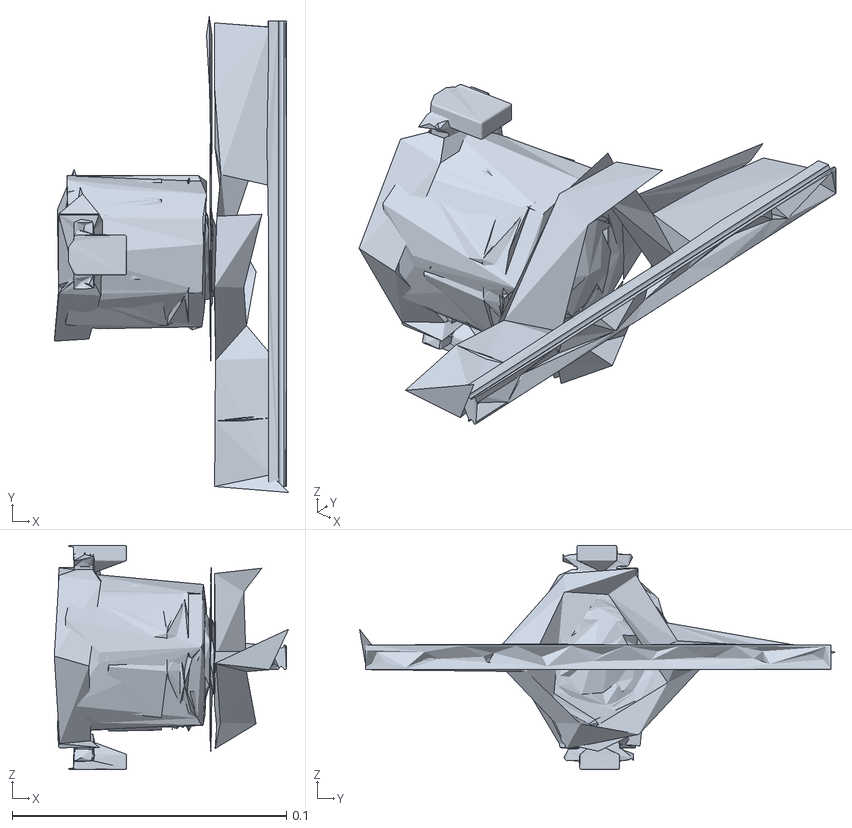
[picture p323: CAD file, 2026-10-20]
cad/arm/rebot_b601_rs/meshes_preview/shared/gripper_end.STL
0.0856 x 0.174 x 0.0818
