JacobSchantz/HelpingHands/cad/arm/rebot_b601_rs/meshes_preview/visual/pla_left.STL

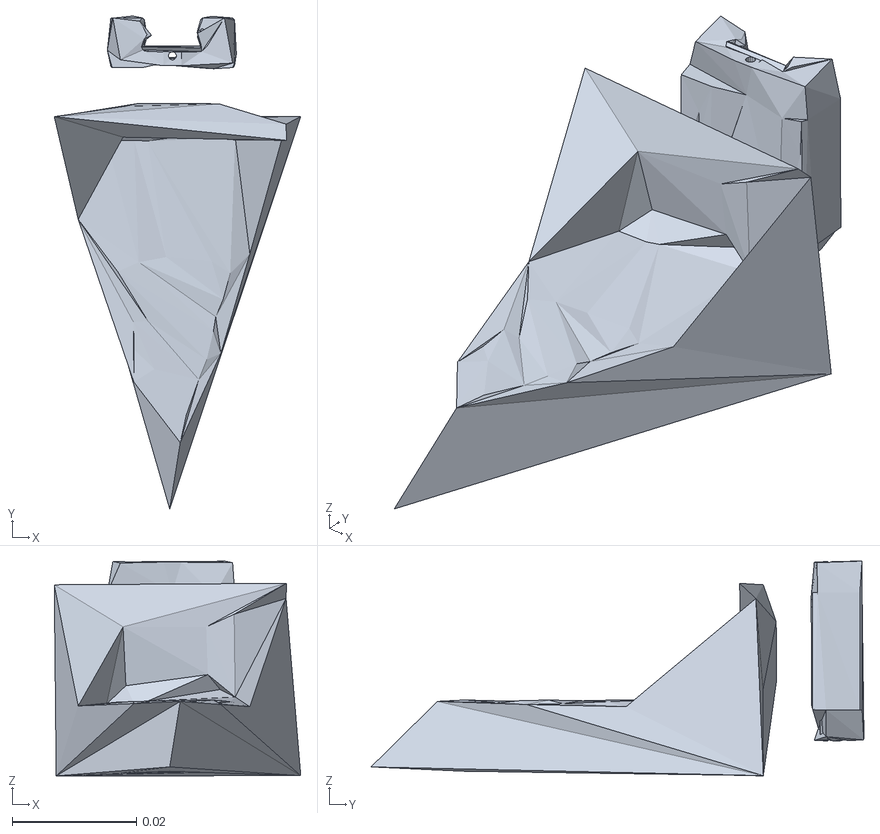
[picture p324: CAD file, 2026-10-20]
cad/arm/rebot_b601_rs/meshes_preview/visual/pla_left.STL
0.0397 x 0.0794 x 0.0346
