JacobSchantz/HelpingHands/cad/arm/so101/assets_preview/wrist_roll_pitch_so101_v2.stl

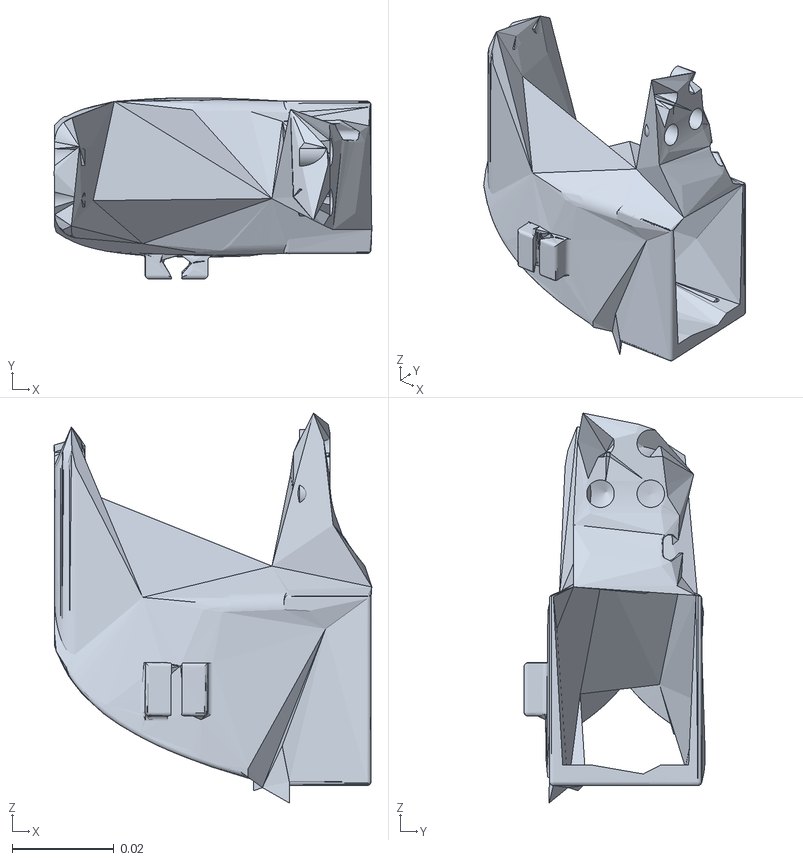
[picture p325: CAD file, 2026-10-20]
cad/arm/so101/assets_preview/wrist_roll_pitch_so101_v2.stl
0.0625 x 0.0357 x 0.0768
