JacobSchantz/HelpingHands/cad/openscad/demo_gripper/export/hub.stl

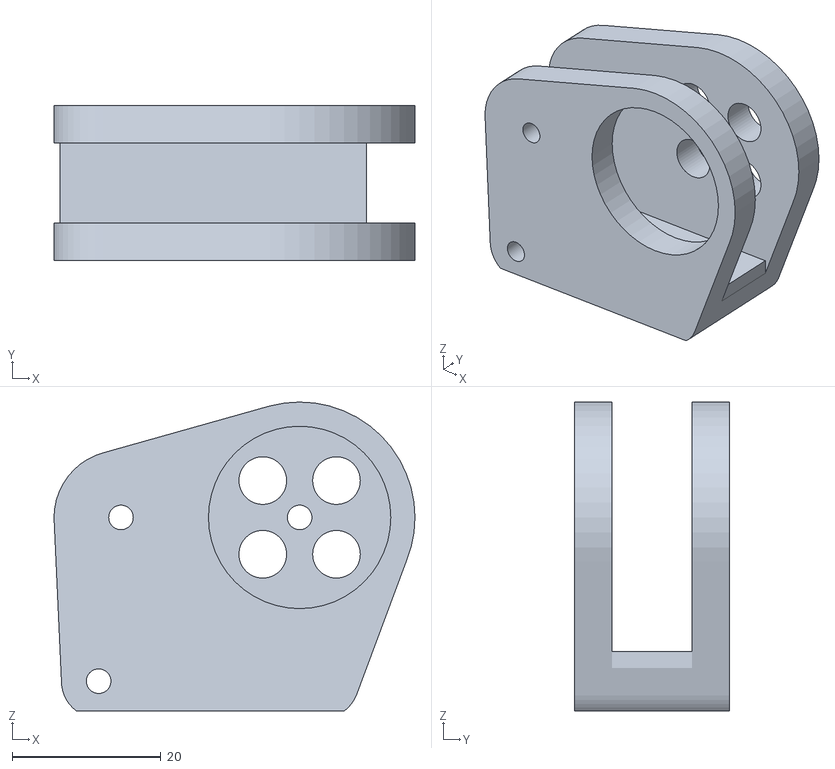
[picture p326: CAD file, 2026-10-16]
cad/openscad/demo_gripper/export/hub.stl
48.5 x 20.8 x 41.5
