JacobSchantz/HelpingHands/cad/openscad/hand_gripper/export/link_thumb.stl

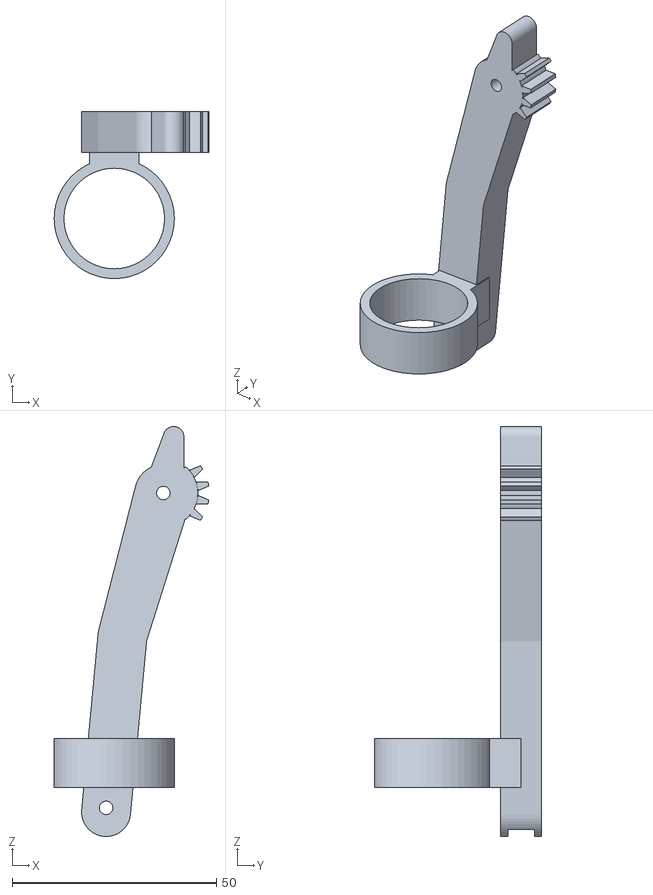
[picture p327: CAD file, 2026-10-14]
cad/openscad/hand_gripper/export/link_thumb.stl
37.8 x 40.9 x 100.3
