JacobSchantz/HelpingHands/Two Finger Gripper/versions/v328_generalist_five_piece/exports/parts/retaining_plate.stl

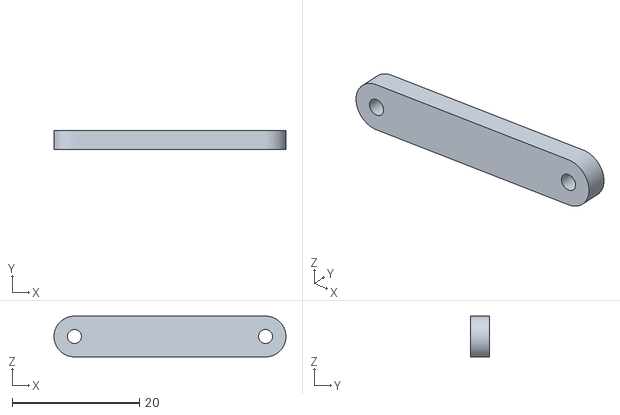
[picture p330: CAD file, 2026-10-24]
Two Finger Gripper/versions/v328_generalist_five_piece/exports/parts/retaining_plate.stl
36.4 x 3.00 x 6.40
