JacobSchantz/HelpingHands/cad/arm/rebot_b601_rs/meshes/shared/link4.STL

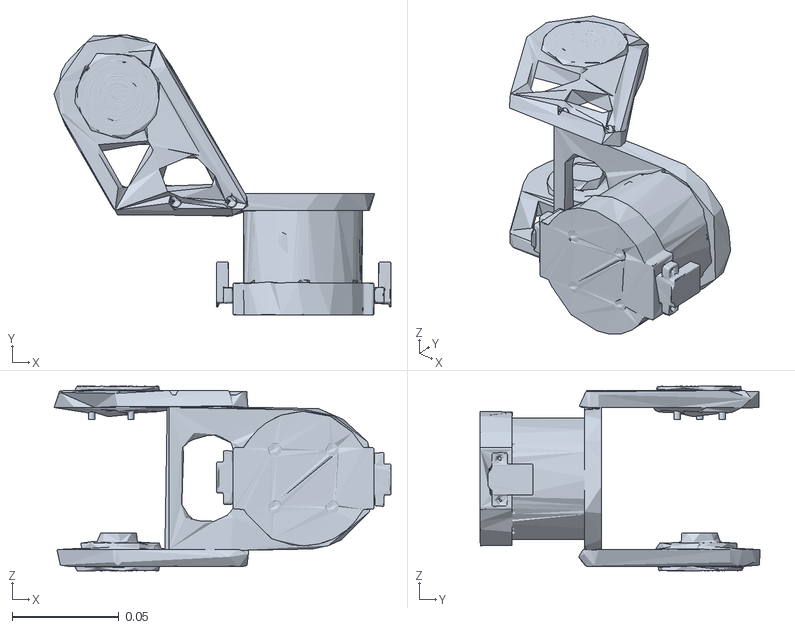
[picture p331: CAD file, 2026-10-20]
cad/arm/rebot_b601_rs/meshes/shared/link4.STL
0.158 x 0.131 x 0.0866
