JacobSchantz/HelpingHands/cad/arm/rebot_b601_rs/meshes/visual/pla_left.STL

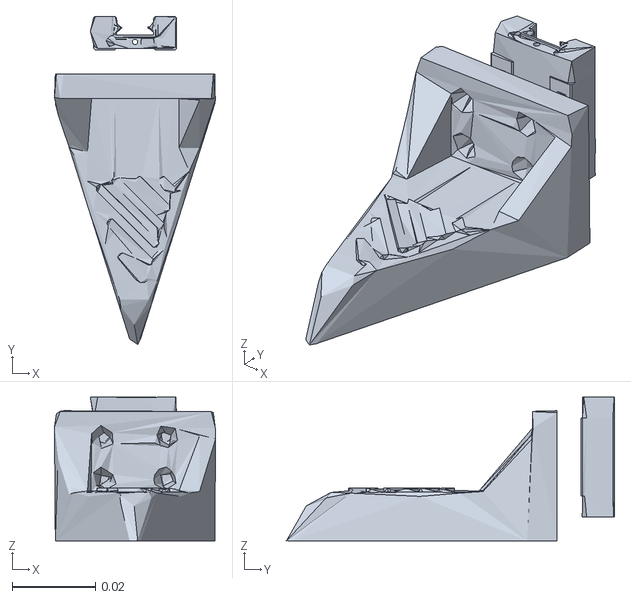
[picture p332: CAD file, 2026-10-20]
cad/arm/rebot_b601_rs/meshes/visual/pla_left.STL
0.0388 x 0.079 x 0.0347
