JacobSchantz/HelpingHands/cad/arm/rebot_b601_rs/meshes_preview/shared/link5.STL

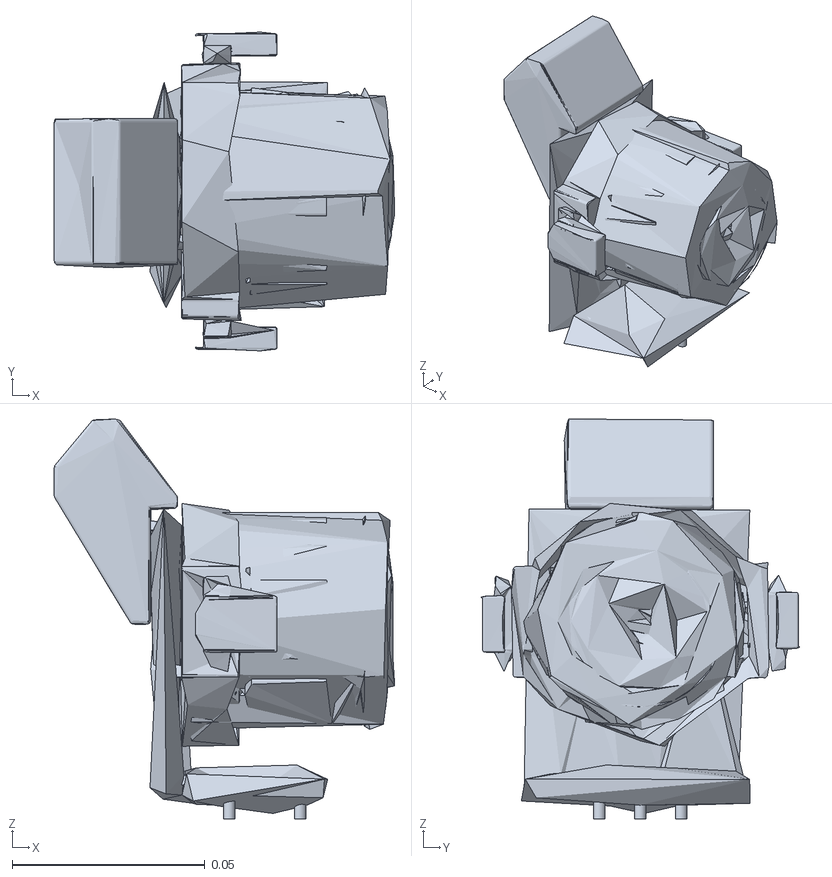
[picture p333: CAD file, 2026-10-20]
cad/arm/rebot_b601_rs/meshes_preview/shared/link5.STL
0.0883 x 0.0827 x 0.104
