JacobSchantz/HelpingHands/cad/arm/rebot_b601_rs/meshes_preview/visual/cnc7.STL

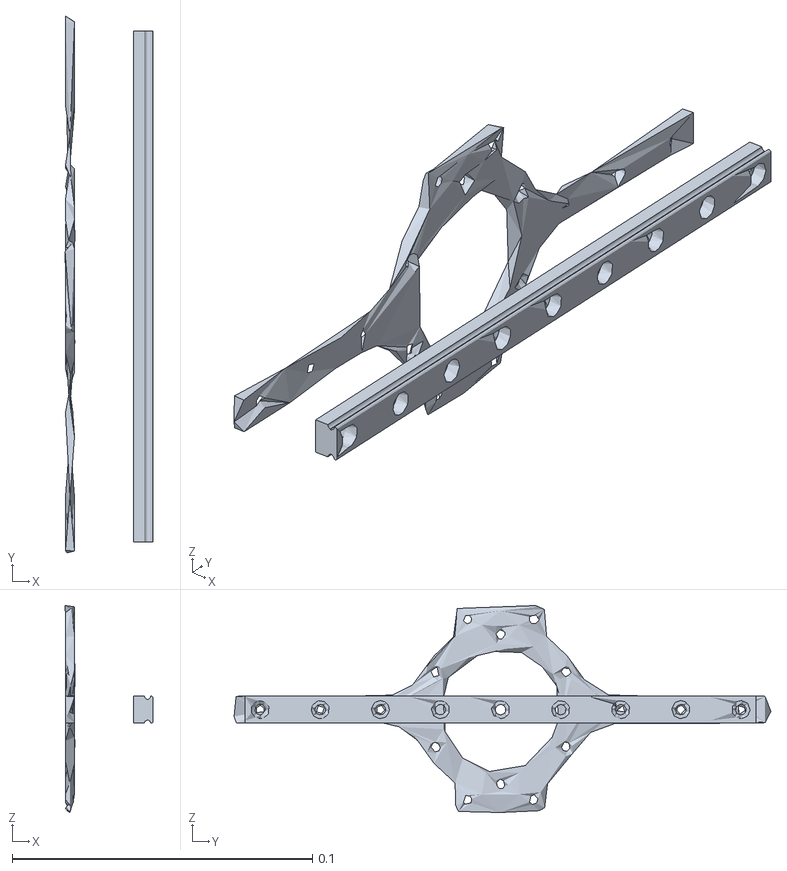
[picture p334: CAD file, 2026-10-20]
cad/arm/rebot_b601_rs/meshes_preview/visual/cnc7.STL
0.0292 x 0.179 x 0.0689
