JacobSchantz/HelpingHands/cad/arm/so101/assets_preview/motor_holder_so101_base_v1.stl

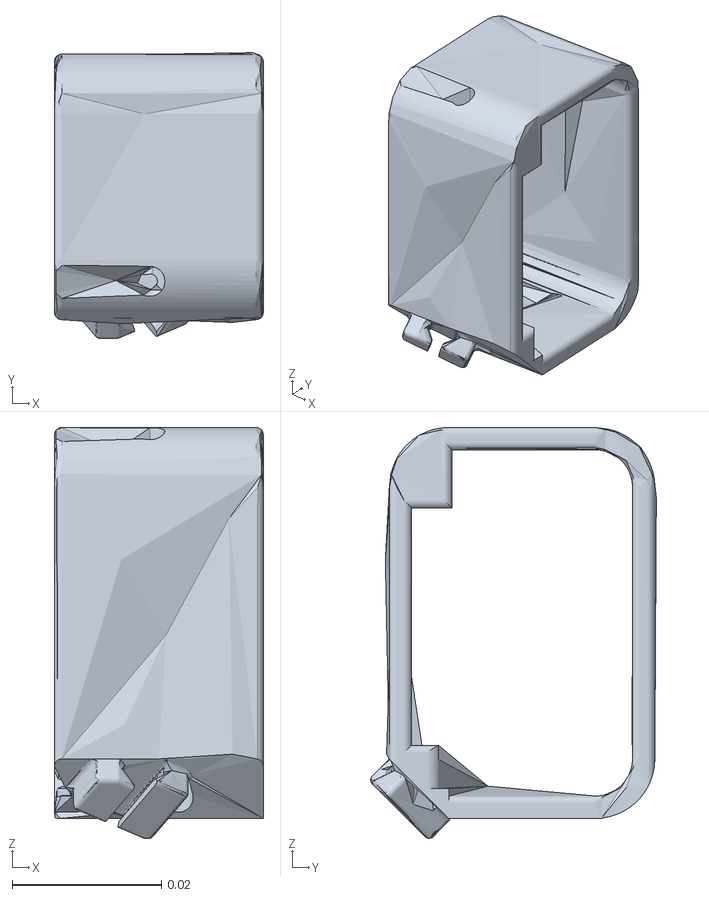
[picture p335: CAD file, 2026-10-20]
cad/arm/so101/assets_preview/motor_holder_so101_base_v1.stl
0.0281 x 0.0383 x 0.0551
