JacobSchantz/HelpingHands/cad/openscad/crow/export/puck.stl

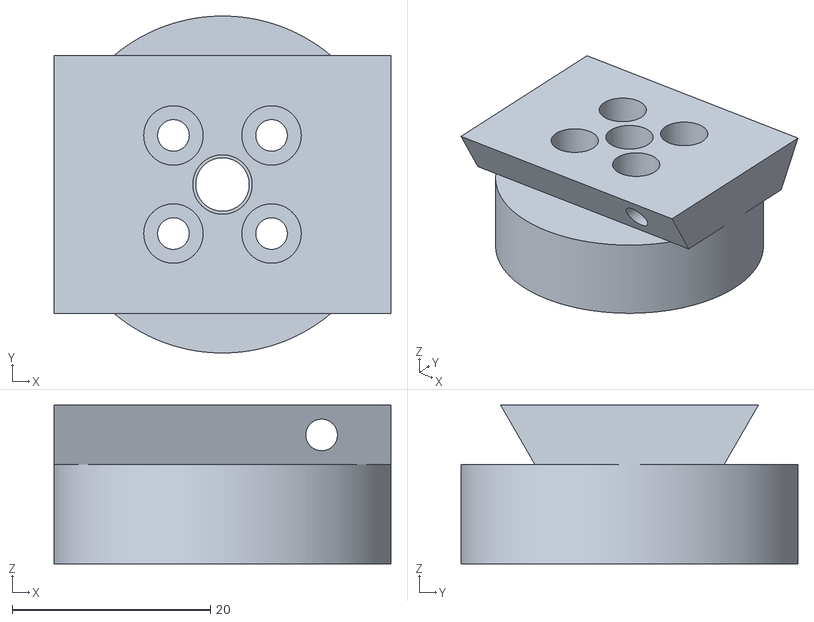
[picture p336: CAD file, 2026-09-30]
cad/openscad/crow/export/puck.stl
34.0 x 34.0 x 16.0
