JacobSchantz/HelpingHands/cad/openscad/demo_gripper/export/a_right.stl

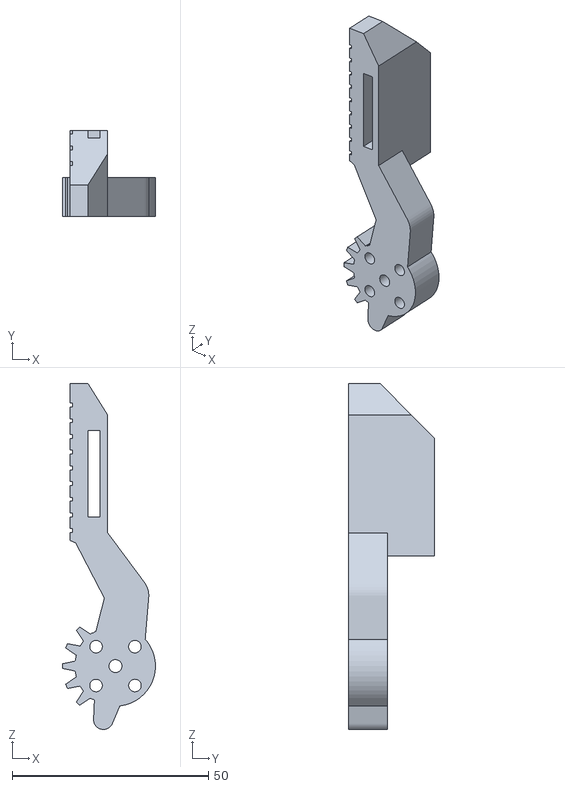
[picture p337: CAD file, 2026-10-16]
cad/openscad/demo_gripper/export/a_right.stl
23.7 x 22.0 x 88.2
