JacobSchantz/HelpingHands/cad/openscad/hand_gripper/export/spine.stl

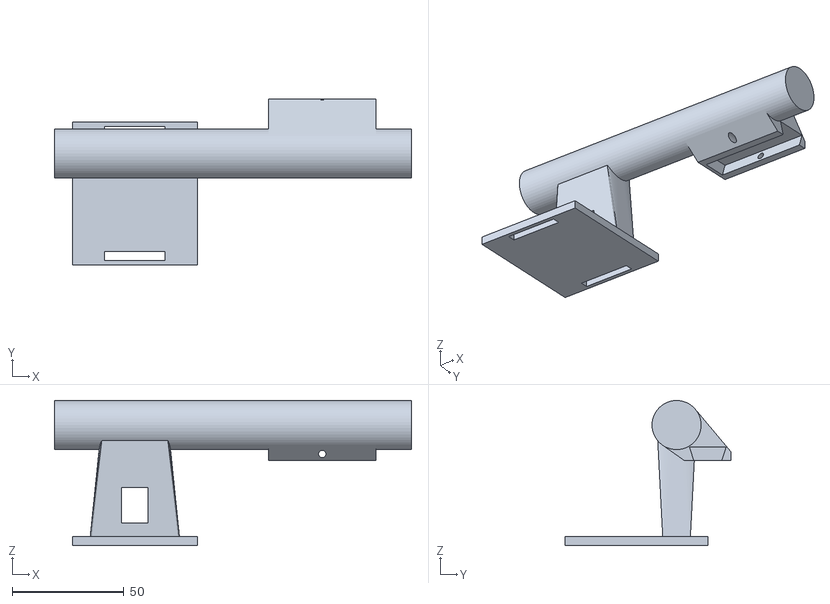
[picture p338: CAD file, 2026-10-14]
cad/openscad/hand_gripper/export/spine.stl
160.0 x 74.4 x 65.0
