JacobSchantz/HelpingHands/Two Finger Gripper/versions/v328_generalist_five_piece/exports/parts/right.stl

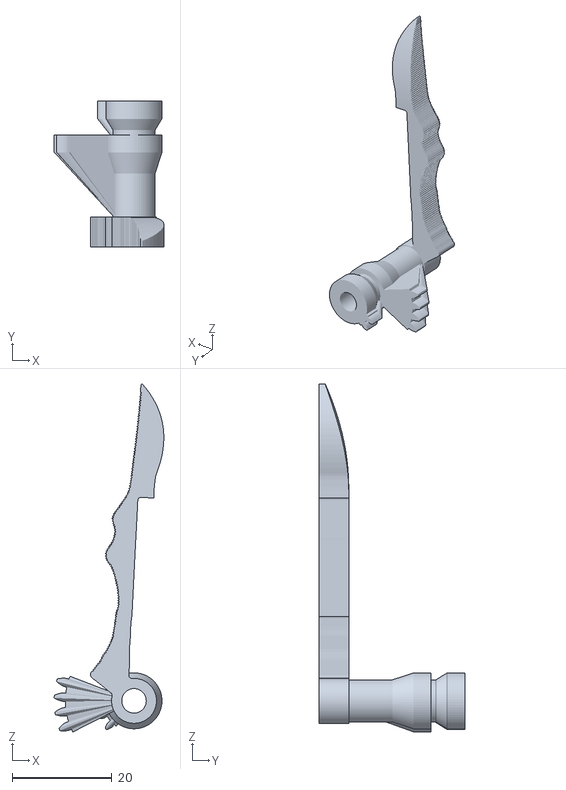
[picture p341: CAD file, 2026-10-24]
Two Finger Gripper/versions/v328_generalist_five_piece/exports/parts/right.stl
22.0 x 29.3 x 69.7
