JacobSchantz/HelpingHands/Two Finger Gripper/versions/v328_generalist_five_piece/exports/reference/plate_tools.stl

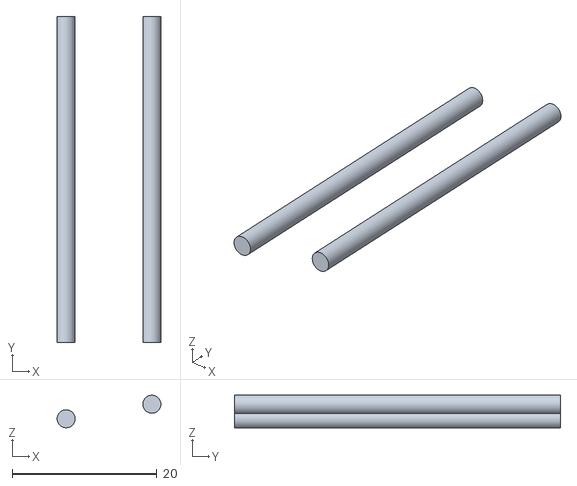
[picture p342: CAD file, 2026-10-24]
Two Finger Gripper/versions/v328_generalist_five_piece/exports/reference/plate_tools.stl
14.3 x 45.0 x 4.51
