JacobSchantz/HelpingHands/cad/arm/rebot_b601_rs/meshes/shared/gripper_end.STL

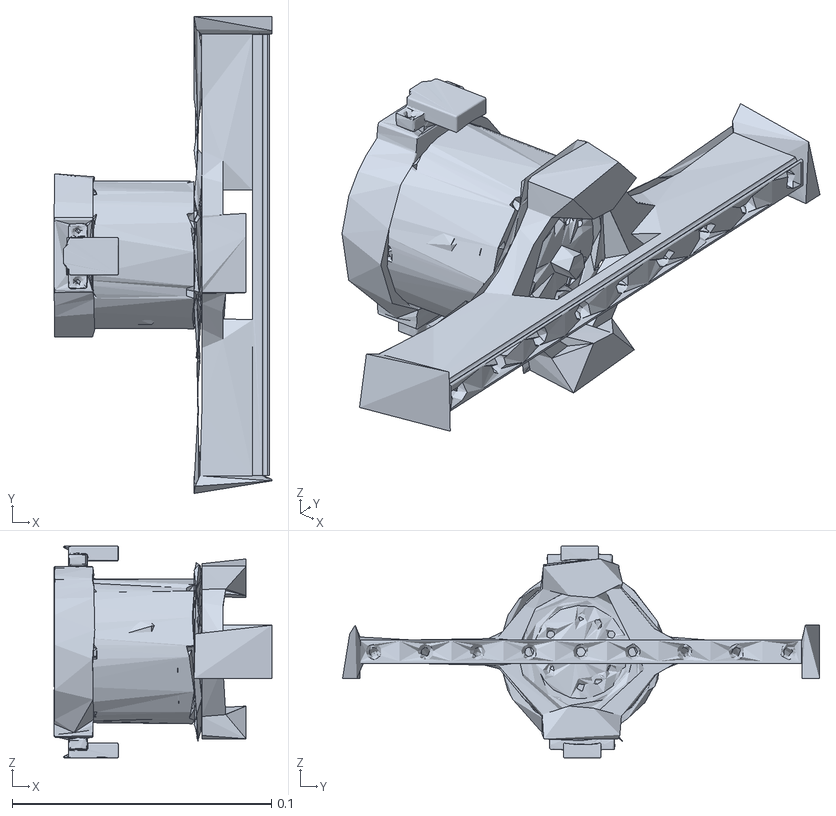
[picture p343: CAD file, 2026-10-20]
cad/arm/rebot_b601_rs/meshes/shared/gripper_end.STL
0.084 x 0.184 x 0.0818
