JacobSchantz/HelpingHands/cad/arm/rebot_b601_rs/meshes/visual/cnc3.STL

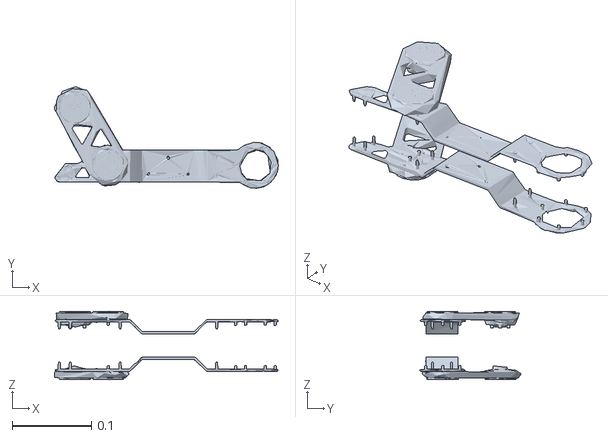
[picture p344: CAD file, 2026-10-20]
cad/arm/rebot_b601_rs/meshes/visual/cnc3.STL
0.283 x 0.129 x 0.0866
