JacobSchantz/HelpingHands/cad/arm/rebot_b601_rs/meshes_preview/shared/link3.STL

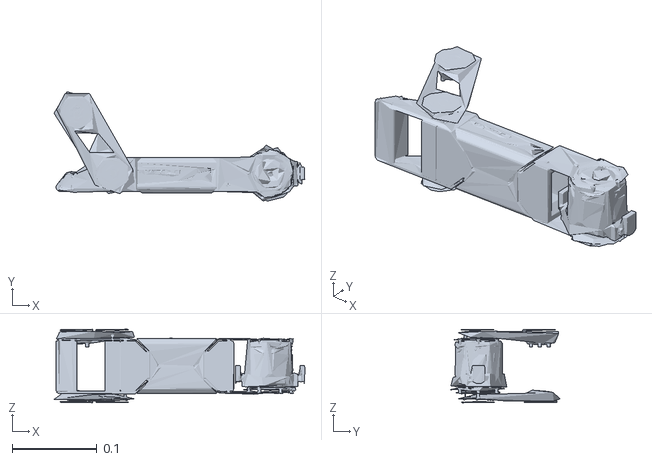
[picture p345: CAD file, 2026-10-20]
cad/arm/rebot_b601_rs/meshes_preview/shared/link3.STL
0.297 x 0.129 x 0.0865
