JacobSchantz/HelpingHands/cad/arm/rebot_b601_rs/meshes_preview/visual/pla3_black_without_seeed_badge.STL

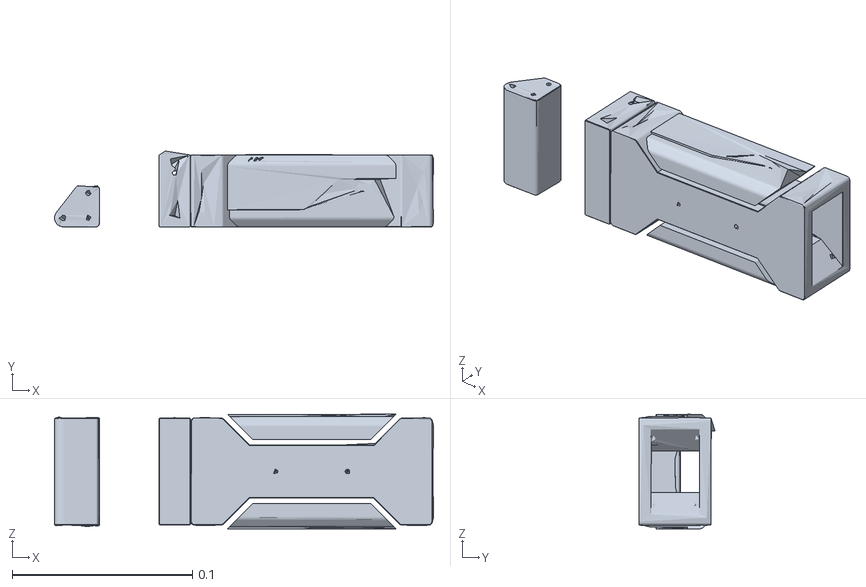
[picture p346: CAD file, 2026-10-20]
cad/arm/rebot_b601_rs/meshes_preview/visual/pla3_black_without_seeed_badge.STL
0.21 x 0.0421 x 0.0636
