JacobSchantz/HelpingHands/cad/arm/so101/assets_preview/motor_holder_so101_wrist_v1.stl

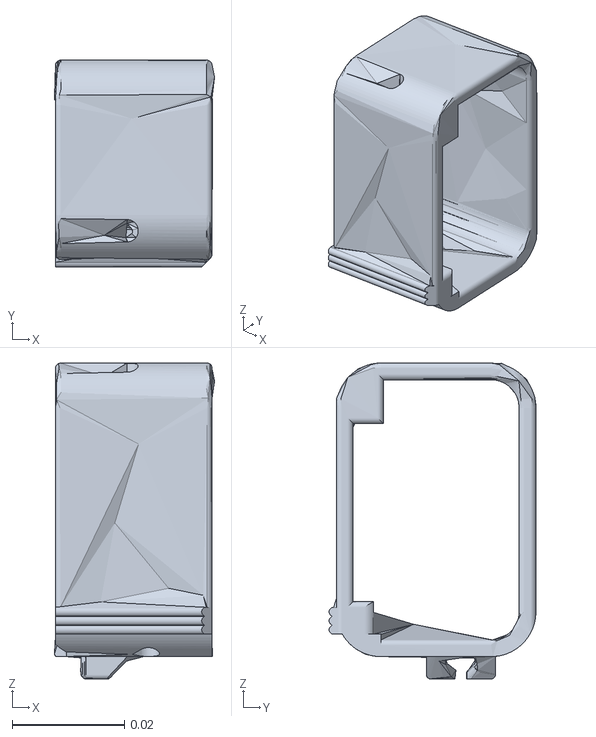
[picture p347: CAD file, 2026-10-20]
cad/arm/so101/assets_preview/motor_holder_so101_wrist_v1.stl
0.0286 x 0.0369 x 0.0564
