JacobSchantz/HelpingHands/cad/openscad/crow/export/camera_mount.stl

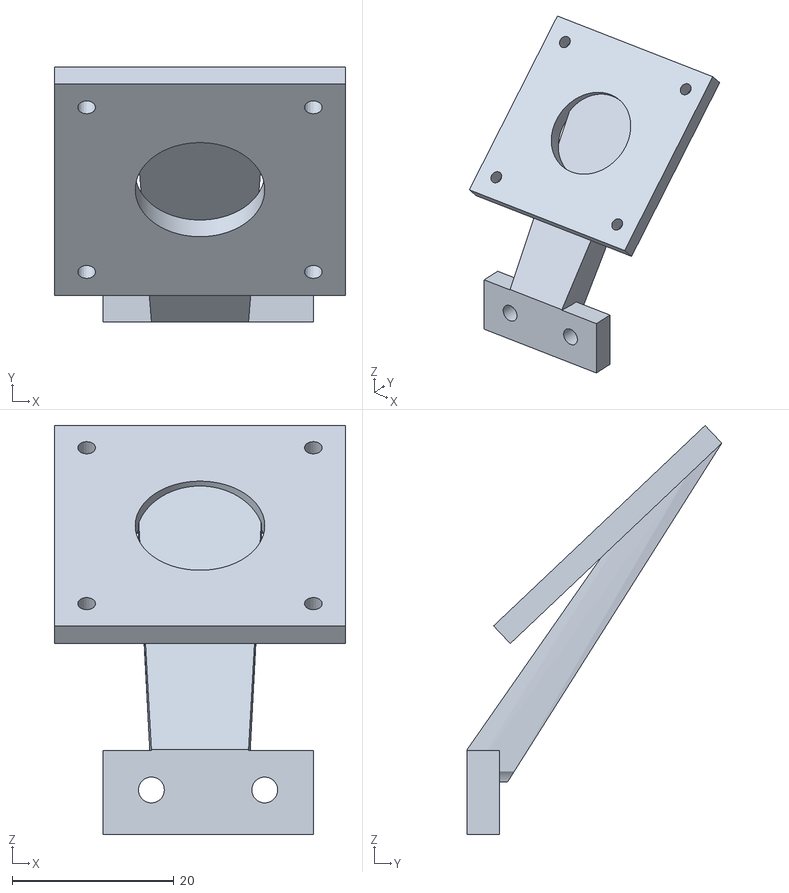
[picture p348: CAD file, 2026-09-30]
cad/openscad/crow/export/camera_mount.stl
36.0 x 31.5 x 50.5
