JacobSchantz/HelpingHands/cad/openscad/demo_gripper/export/b_left.stl

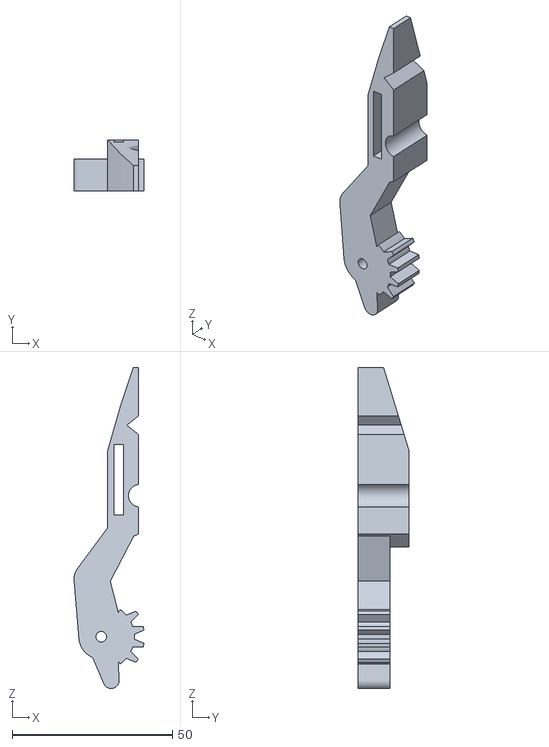
[picture p349: CAD file, 2026-10-16]
cad/openscad/demo_gripper/export/b_left.stl
21.9 x 16.0 x 100.2
