JacobSchantz/HelpingHands/cad/openscad/hand_gripper/export/tip_thumb.stl

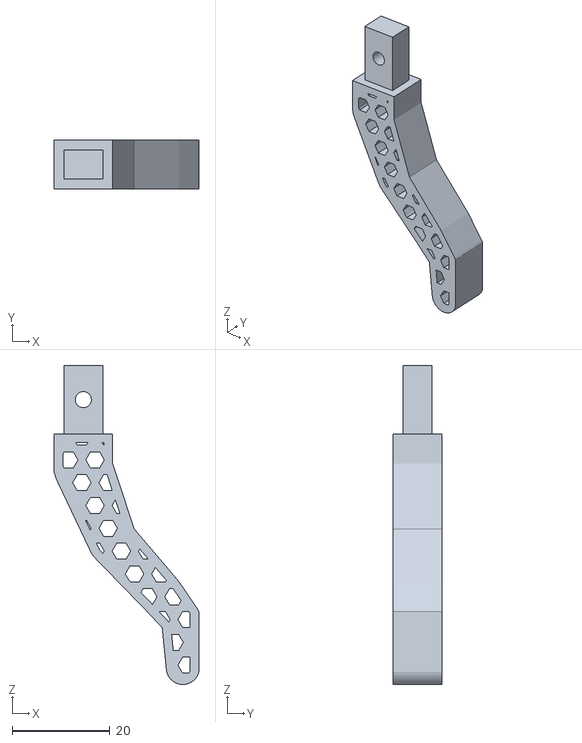
[picture p350: CAD file, 2026-10-14]
cad/openscad/hand_gripper/export/tip_thumb.stl
29.7 x 10.0 x 65.4
