JacobSchantz/HelpingHands/cad/arm/rebot_b601_rs/meshes/shared/link2.STL

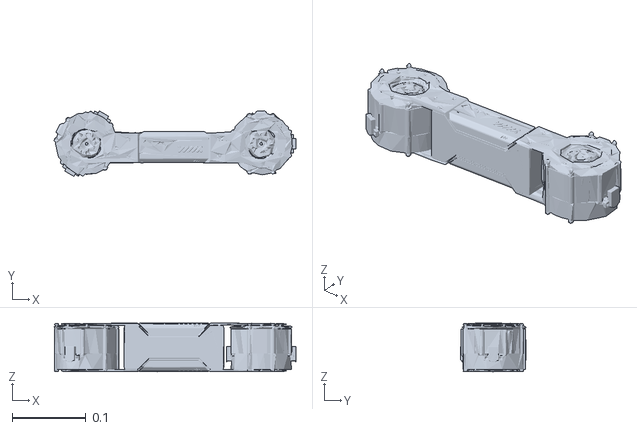
[picture p353: CAD file, 2026-10-20]
cad/arm/rebot_b601_rs/meshes/shared/link2.STL
0.327 x 0.0886 x 0.0657
