JacobSchantz/HelpingHands/Two Finger Gripper/studies/voice-550038ca-four-post-cap/params.scad

// GENERATED by params.py from params.json. Do not edit; change params.json and re-run params.py.
hls_body_length=46.0;       // Hls Body Length (mm): Manufacturer page 6; CAD body length.
hls_body_width=24.0;        // Hls Body Width (mm): Manufacturer page 6 and CAD.
hls_body_height=55.0;       // Hls Body Height (mm): Manufacturer page 6 and CAD; excludes spline.
hls_ear_top=44.0;           // Hls Ear Top (mm): Manufacturer ear upper surface from bottom; CAD agrees.
hls_ear_thickness=3.0;      // Hls Ear Thickness (mm): Manufacturer 22 minus 20.5; CAD agrees.
hls_near=11.42;             // Hls Near (mm): Manufacturer shaft axis to near body end; CAD agrees.
hls_mount_u0=-16.42;        // Hls Mount U0 (mm): Manufacturer shaft-to-near ear hole; CAD is -7.96.
hls_mount_u1=39.58;         // Hls Mount U1 (mm): Manufacturer shaft-to-far ear hole; CAD is 19.54.
hls_mount_span_w=14.0;      // Hls Mount Span W (mm): CAD hole centers across case; manufacturer drawing omits this dimension.
hls_mount_hole_d=5.0;       // Hls Mount Hole D (mm): Manufacturer and CAD ear clearance diameter, NOT a tapped case hole.
hls_mount_slot_travel=1.0;  // Hls Mount Slot Travel (mm): Design allowance: accommodates 0.25 mm CAD/drawing difference plus positioning margin.
hls_mount_clear_d=3.4;      // Hls Mount Clear D (mm): Designed 1.7 mm pilot for M2 self-tapping ear screws; pullout untested.
hls_mount_boss_d=8.8;       // Hls Mount Boss D (mm): Designed standoff OD; actual hardware is not scaled.
hls_plate_d=36.0;           // Hls Plate D (mm): Measured purchased aluminum disk STEP, solid 248.
hls_plate_h=9.0;            // Hls Plate H (mm): Measured stock plate total axial envelope.
hls_plate_above_ear=22.2;   // Hls Plate Above Ear (mm): Measured plate top -20.125 minus ear top -31.225.
hls_plate_face=4.0;         // Hls Plate Face (mm): Designed plate top above underside of base; retains original pinion seating elevation.
hls_plate_pcd=24.015238;    // Hls Plate Pcd (mm): STEP 8-hole circle, radius 6.0038095.
hls_plate_clear_d=4.4;      // Hls Plate Clear D (mm): Reuse spool clearance diameter for M2 plate screws.
hls_plate_head_d=8.4;       // Hls Plate Head D (mm): Designed conservative clearance for original approximately 4 mm M2 heads.
hls_plate_head_h=3.2;       // Hls Plate Head H (mm): Conservative M2 head envelope assumption; measure purchased heads.
hls_plate_head_recess=12.3; // Hls Plate Head Recess (mm): Designed recess below gear top; leaves plate screw grip.
hls_plate_screw_length=8.0; // Hls Plate Screw Length (mm): Reuse Aero Hand BOM M2x4, under head.
hls_center_access_d=12.8;   // Hls Center Access D (mm): Designed access to original M2.3 screw and approximately 5 mm head, retaining it unchanged.
hls_case_screw_length=12.0; // Hls Case Screw Length (mm): Use Aero Hand guide M2x6 self-tapping ear screws, heads below ears, 4.5 mm bite in printed standoffs.
hls_case_head_d=8.0;        // Hls Case Head D (mm): Conservative M2 screw head envelope assumption.
hls_case_head_h=4.0;        // Hls Case Head H (mm): Conservative M2 screw head envelope assumption.
hls_cable_w=16.0;           // Hls Cable W (mm): ASSUMED cable/service envelope across body, not manufacturer evidence.
hls_cable_len=36.0;         // Hls Cable Len (mm): ASSUMED free cable exit/bend corridor beyond far end; physical harness confirmation required.
hls_cable_h=20.0;           // Hls Cable H (mm): ASSUMED cable corridor height below ears.
hls_spline_d=9.9;           // Hls Spline D (mm): Manufacturer 25T spline nominal OD; stock aluminum disk supplies real mating spline.
hls_ref_x=17.999904;        // Hls Ref X (mm): Native pinned STEP output-axis X.
hls_ref_y=16.58256;         // Hls Ref Y (mm): Native pinned STEP output-axis Y.
hls_ref_ear_z=-62.44997512; // Hls Ref Ear Z (mm): Native STEP ear top Z.
hls_plate_angles=[-90, 45, 135];// Hls Plate Angles (deg): Three original Aero Hand spool attachment holes in native XY; angle transformation used by hls_holes.
hls_m2_shank_d=4.0;         // Hls M2 Shank D (mm): Nominal M2 bolt shank envelope.
hls_center_head_d=10.0;     // Hls Center Head D (mm): Measured stock spline-retaining screw maximum head diameter.
hls_center_head_h=4.12;     // Hls Center Head H (mm): Measured stock retaining head protrusion above plate top, rounded up.
hls_case_pilot_depth=9.6;   // Hls Case Pilot Depth (mm): Designed blind pilot for M2x6 self-tapping ear screws, 4.5 mm engagement, 0.3 mm tip allowance. Prototype pullout untested.
hls_body_deg=-90;           // Hls Body Deg (deg): Servo case points toward finger pivots below base; cable corridor fits underneath existing finger height.
hls_mount_cad_u0=-15.92;    // Hls Mount Cad U0 (mm): Measured CAD near mounting hole relative to output axis.
hls_mount_cad_u1=39.08;     // Hls Mount Cad U1 (mm): Measured CAD far mounting hole relative to output axis.
scale_factor=0.5;           // Scale Factor (x): Gripper 24 unchanged at 50%; this version changes only Base 18.
min_screw_rim=1;            // Minimum pinion screw rim (mm): Minimum solid wall outside the full-size 6.4 mm countersink and inside the pinion tooth root. Governs minimum scale.
actual_m3_head_d=6;         // Actual M3 Head D (mm): Conservative M3 countersunk head diameter used for clearance verification.
actual_m3_head_h=1.7;       // Actual M3 Head H (mm): Nominal M3 countersunk head height; candidate hardware must be measured before printing.
actual_m2_head_d=3.8;       // Actual M2 Head D (mm): M2 cap-head envelope, below the 4 mm source recess.
actual_m2_head_h=2;         // Actual M2 Head H (mm): M2 cap-head envelope height.
min_lattice_web=0.4;        // Min Lattice Web (mm): Adopted minimum ventral-plan ligament for fine resin prototype; not an FDM or strength rating.
min_gear_module=1;          // Min Gear Module (mm): Minimum involute module used in candidate selection.
min_base_rim=1.5;           // Min Base Rim (mm): Base material beyond the pinion addendum.
cap_pillar_x=20;            // Cap Pillar X (mm): Actual cap-post half-spacing; moved behind the larger stock-horn pinion.
pillar_motion_clear=0.25;   // Pillar Motion Clear (mm): Required separation of rear cap pillars from pinion teeth.
horn_screw_length=12;       // Horn Screw Length (mm): Candidate overall countersunk M3 length: CAD clears case, 2.5 mm horn engagement. Confirm purchased horn and screw head.
case_screw_length=6;        // Case Screw Length (mm): Candidate M2 length under head: 4 mm modeled case engagement, same unmeasured depth assumption as large source.
cap_screw_length=10;        // Cap Screw Length (mm): Candidate overall countersunk M3 length: 7 mm into pillar, 0.3 mm modeled pilot-bottom clearance.
actual_m3_shank_d=3;        // Actual M3 Shank D (mm): M3 unthreaded clearance probe diameter.
actual_m2_shank_d=2;        // Actual M2 Shank D (mm): M2 unthreaded clearance probe diameter.
beak_stretch=1.7;           // Beak length (x): How many times the photo's beak (black dot to point) is stretched along the finger. 1.70 makes dot to point a third of the finger (Gen 15).
outer_lean_deg=15;          // Outer edge lean at the dot (deg): The outer edge leaves the black dot this far outboard of the finger axis. 2.5: 15, 1.19's wide beak (2.4: 0).
outer_start_handle=0.5;     // Outer edge: fullness behind (x chord): Bezier handle at the dot end of the outer edge, as a fraction of dot-to-point. Longer keeps the beak full further out. 2.5: 0.50, 1.19's (2.4: 0.30).
outer_end_handle=0.25;      // Outer edge: fullness at the point (x chord): Bezier handle at the point end of the outer edge. Longer rounds in later, giving a blunter nose. 2.5: 0.25, 1.19's (2.4: 0.30).
outer_bow=0.2;              // Outer edge bow (x chord): How far the outer edge bows outboard of the straight dot-to-point line, as a fraction of its length. 2.5: 0.20, 1.19's (2.4: 0.04).
jaw_open_power=0.85;        // Jaw convergence (opening shape): Closed, each jaw edge sits H (d/D)^p off the centreline, d mm behind the point. Below 1 the gap opens fastest right at the point (sharper convergence angle); 1 is a straight triangle; above 1 the jaws run nearly parallel near the tip.
knob_swell=1.2;             // Inner bump-out height (mm): How far the two rounded swells on the inner edge, mid-shank, stand proud of the ramp.
knob1_halfwidth=6.0;        // Bump 1 half-width (near the head) (mm): Half-width along the edge of the first swell's cos^2 window. Wider is rounder.
knob2_halfwidth=5.6;        // Bump 2 half-width (near the dot) (mm): Half-width of the second swell, just behind the black dot. Its crest also sets where the closed jaw triangle starts.
knob_ramp_smooth=1.2;       // Bump ramp smoothing (mm): Gaussian smoothing of the inner-edge ramp under the swells, so its own bends put no corners at their feet.
outline_smooth=0.8;         // Outline smoothing (mm): Gaussian smoothing along the traced photo contour (Gen 9 / Gen 16 roundness).
dot_join_smooth=2.0;        // Smoothing at the dot joins (mm): Where the generated beak meets the traced shank, both edges are smoothed with this sigma.
dot_join_span=8.0;          // Dot join span (mm): Half-length of arc smoothed either side of each dot join.
hook_depth=1.0;             // Base hook depth (x): Scales the base J-hook's bowl and toe away from the line between its two ends (1 = Gen 9's hook). The handle's foot is trimmed to whatever notch this makes.
top_notch_u=54;             // Top hook position (mm): 2.6: u (along the straight outer edge from the rail origin) of the top hook's notch floor. The edge runs straight up to it, the base J-hook mirrored end for end curls round there, its notch open toward the base, and the handle spans floor to floor (base floor u -11.4), so this sets the handle's length. 54: where 1.20's edge started going out again (2.5: top_hook_mirror_u 8.5, floor 28.4).
top_step_back=0;            // Top step: back dips by (mm): 2.6: from the top hook's crest (6.6 mm out) the outer edge fills on to the beak's outer edge where it is back up to the crest's height less this. 0 = a level shoulder, one jump out (Jake: no double indent); larger meets the edge sooner, lower down the blade-root curve, and dips behind the crest.
slot_count=6;               // Beak slot count: How many slanted slots run up the beak (the photo shows six on the upper finger).
groove_pitch=1.0;           // Groove pitch (mm): Spacing of the inner-edge grooves. Off-pitch values can land a groove wall on the tip-zone cut; the render reports it.
groove_width=0.5;           // Groove width (mm): Width of each groove across its station.
groove_depth=0.4;           // Groove depth (mm): Depth of each groove, measured in from the finished edge. 0 = no grooves.
groove_stop=3.4;            // Grooves stop short of the point (mm): Arc length from the point with no grooves.
groove_min_width=1.8;       // Grooves stop where the beak is narrower than (mm): Below this width across the beak a groove would leave a pinhole; the row stops there.
plate=12;                   // Finger thickness (mm): The finger's thickness along Y (the 12 mm side), centred on the hand plane.
tip_thick=2.4;              // Thickness at the point (taper) (mm): At or above the finger thickness there is no taper (2.3). Below it, the dorsal (+Y) face slopes down from the black dot to this at the point and the ventral face stays flat (1.18's print-flat taper; 1.18 used 2.4). 2.5: 2.4, 1.18's flat-bottom taper (2.4: 12, none).
taper_power=2;              // Taper curve: Thickness drops as f^power from the taper start to the point: 1 is a straight wedge, 2 Gen 16's parabola (full near the dot, steep at the point).
taper_start=0;              // Taper start past the dot (mm): Where along the finger the taper begins, relative to the black dot (negative = toward the base).
tip_r=0.3;                  // Point rounding (mm): Plan-view radius of the point. The closed fingers touch here.
tip_zone=6.25;              // Point rounding zone (mm): tip_r applies within this many mm of the point; elsewhere edge_round. Keep it off the groove pitch (at 6 a groove wall sat on the cut: non-manifold).
edge_round=0.5;             // Convex corner rounding (mm): Radius on every convex corner of the plan outline (photo blur to smooth edges).
fillet_r=1.2;               // Concave fillet (mm): Radius in every concave corner of the plan outline (the shoulder).
min_hole=1.8;               // Smallest honeycomb hole (mm): Blurred small holes are read no smaller than this.
hole_scale=1.0;             // Honeycomb hole size (x): Multiplies every traced honeycomb hole's diameter.
dot_scale=1.0;              // Black dot size (x): Multiplies the black dot's traced 3.4 mm diameter.
slot_len=3.0;               // Beak slot length (mm): Length of each slanted beak slot.
slot_width=1.35;            // Beak slot width (mm): Width of each beak slot (round ends).
last_slot_scale=0.7;        // Last slot size (x): The slot nearest the point is this fraction of the others.
slot_angle_deg=120;         // Slot slant (photo) (deg): Slot direction in the photo's image degrees (a forward slash, ~35 deg off the row).
groove_wall=0.6;            // Wall between grooves and holes (mm): Least wall kept between a groove and any hole, so no groove opens into one.
tip_gap=0;                  // Closed gap at the points (mm): Closed, the points are this far apart (0 = touching; negative = preload/overlap).
fit=0.4;                    // Fit clearance (per side) (mm): Clearance per side between handle and finger: the plate against the outer edge and each foot in its hook's notch.
slide_t=3.5;                // Plate thickness (mm): The black handle plate's thickness (outboard of the finger).
handle_over=0;              // Handle past each finger face (mm): Handle 7 / Base 4: the plate stands this far past the finger on each face (dorsal and ventral), so it is plate + 2x this tall across the finger: 0 = the finger's 12 mm (Base 3: 1.5, 15 mm).
span_over=1.0;              // Plate run past each notch floor (mm): 2.5: the plate spans the finger's outer edge from the base hook's notch floor to the top hook's, plus this at each end; the finger outline grown by fit then trims both ends into feet that fill the two notches. Its length follows the hooks (top_hook_mirror_u).
slide_w0=0.45;              // Plate stand-off from the finger (mm): The plate's inboard face sits this far outboard of the rail line; the finger's outer edge reaches +0.17 at most.
plate_corner_r=1.5;         // Plate corner radius (mm): Base 7: rounding on the plate's two ends, in plan (seen from the dorsal side), so every wall stays vertical as it prints. Under half slide_t. (Base 4: 3, rounded edge-on, which overhung at the bed.)
strap_width=20;             // Strap (webbing) width (mm): Nominal loop webbing width (not measured; straps are not modelled).
strap_thick=1.5;            // Strap thickness (mm): Nominal webbing thickness; documented only (the slot width below sets the opening).
strap_slot_clearance=1.0;   // Slot length over strap width (mm): The strap tunnel is the strap width plus this long (along the finger).
strap_slot_width=2.5;       // Strap slot width (mm): 3.3: the tunnel's gap (outboard of the plate) that the webbing runs through, across the finger from one face to the other. 2.5 (3.2: a 3.5 mm slot through the plate either side of the finger).
strap_slots=2;              // Strap-loop slots: Base 8: how many strap-loop slots each handle-gear has, side by side along the handle plate, each a tunnel right through the part (y) under the strap boss, so it prints as a straight hole with no bridge. One loop per slot wraps the boss and the digit lying on it. 1 = Base 7's single tunnel.
strap_rib=2.5;              // Rib between slots (mm): Base 8: the solid rib of boss between neighbouring strap-loop slots, along the finger. The slots and ribs together are centred on the plate.
slots_shift=3;              // Slots shift toward the top hook (mm): Base 8: moves the strap-loop slots (and their boss) this far along the plate toward the top hook from centred. At 3 the lower slot's ventral mouth clears the base plate at every swing with 20 mm webbing (centred, the base sits in it); check_geometry.py checks it.
slot_wall=1.5;              // Tunnel wall (mm): 3.3: the strap boss's outer wall over the tunnel (the digit lies on it) and its end walls, along the finger.
slot_corner_r=1;            // Slot corner radius (mm): Rounding on the tunnel's and the boss's corners (less than half the tunnel gap).
strap_clear=3;              // Strap keep-out round the slots (mm): 3.2/3.3: nothing but the handle itself may come within this of either tunnel mouth (the webbing leaves the tunnel there, past each face of the plate), at any swing. check_geometry.py checks it.
tail_gap=0.4;               // Tail gap off the finger (mm): 3.3: the handle's tail is a band that follows the finger's outline this far off it: up the outer edge, over the base hook's prong, round the hook and under the finger. Base 4: inside the gear hub the finger's pocket is cut fit off it, so tail and hub are one solid.
tail_top_u=-4;              // Tail top (along the edge) (mm): 3.3: the band starts on the plate this far along the outer edge (rail u; the base hook's prong tip is at -9.2), so it covers the prong.
tail_reach=6;               // Tail reach under the finger (mm): 3.3: the band runs on under the finger's base until it is this far inboard of the outer edge line (rail w). Its end is the key the gear's cradle drives. Base 4: it fuses into the gear hub (no key).
hub_r=9;                    // Gear hub radius (mm): Base 4: each side gear's hub disc round its pivot. The handle's tail runs into it and the finger's base sits in a pocket cut fit off the finger, on the web (3.3: a separate cradle with a key notch). Base 20/Gripper 25: reduced direct-contact pivot; no handle interface.
loop_r=7;                   // Finger loop radius (mm): Base 15 / Gripper 22: the ring round the pivot post that replaces Gripper 21's base J-hook, concentric with the handle-gear's hub and sitting in its pocket on the web; its bore is base_clear off the post, like the web's. Base 20/Gripper 25: reduced direct-contact pivot; no handle interface.
hub_top=9;                  // Hub top (mm): The hub is cut off this far above the pivot (finger-frame z). Base 7: 14 (= hub_r), a whole disc, so the web is a full ring round the pivot post's bore and the post bears all the way round (Base 4: 0 cut the hub at the pivot, which left half the bore open under the finger). Base 20/Gripper 25: reduced direct-contact pivot; no handle interface.
web_t=3;                    // Gear web (mm): The floor of each handle-gear under the finger (it sits fit above it); the finger drops in from the dorsal side and rests on it, so it is also the stop. Base 7: it is the print's bed face, and the handle plate, strap boss, tail, hub and teeth all run down to it, so the whole handle-gear is one flat-bottomed extrusion (handle plate+fit+web_t = 15.2 mm tall).
post_d=6;                   // Pivot post (mm): Base 7: the post that stands up out of the base at each pivot; its handle-gear turns on it through a bore in its web. Base 15: it runs on up through the finger's loop into a socket in the top plate (Base 7-14: it stopped fit under the finger). Base 20/Gripper 25: reduced direct-contact pivot; no handle interface.
screw_clear_d=6.8;          // M3 clearance hole (mm): Every M3 through-hole in a printed part (the motor flange and front ring screws).
stack_gap=0.6;              // Gap between stacked parts (mm): Running clearance between each gear (and the pinion) and the base plate.
pivot_spacing=62.7;         // Pivot spacing (finger bases apart) (mm): Base 12: the distance between the two fingers' pivots, the driving dimension (Base 11 derived it from the traced outline: 54.5). Each finger is toed in about its pivot just far enough that the closed points still meet on the centreline, so a wider spacing gives a sharper converging angle and more gap at the base. The side gears' pitch radius is half of it, so the gears, pinion and base all follow. 62.7 = Base 11 + 15%.
gear_teeth=30;              // Teeth (full circle): Teeth on the full gear circle. The pitch radius is fixed to the pivot half-spacing (pivot_spacing/2), so this sets the module: 34 = module 1.60.
gear_pressure_deg=20;       // Pressure angle (deg): Involute pressure angle.
gear_backlash=0.4;          // Backlash (mm): Tooth thickness taken off at the pitch circle, so the printed pair runs free.
gear_extra=0.5;             // Extra teeth past the swing (teeth): 3.3: each gear carries teeth only where its mates meet it over the 0-30 deg swing, plus this many tooth pitches at each end. The left one must stay clear of the pinion.
pinion_teeth=24;            // Pinion teeth: Base 12: 16 (Base 11: 34). The pinion on the STS3215's horn drives the right handle-gear; 16 against the side gears' 34 is 2.1:1, so the servo turns 64 deg for 30 deg of finger swing (more grip torque, finer encoder reading). 16 is the fewest that keeps the horn's countersunk M3 heads 1 mm inside the tooth roots.
pinion_mesh_deg=90;         // Pinion position round the right gear (deg): Base 12: where the pinion meets the right handle-gear, measured down from the pivots' line at the right pivot (Base 11: on the centreline, 60 deg at 34 teeth). Under ~53 deg the pinion reaches into the left gear's teeth; higher means a shorter base.
gear_bolt_phase_deg=45;     // Gear-to-flange bolt angle (deg): STS3215 CAD stock horn four-hole phase at neutral, corrected from the large source RS00-era 30 degrees. Servo zero/assembly phase must follow this mounting orientation.
gear_bolt_head_d=12.8;      // Pinion screw countersink (mm): Base 7: the pinion's 3 screws are M3 countersunk (DIN 7991, 6 mm head, 90 deg). Each hole opens this wide at the pinion's top face, which is its bed face, and narrows at 45 deg to the M3 clearance hole, so the head seats on a cone that prints without support (Base 4: a flat-floored counterbore, a 1 mm ledge hanging in the air printed this way up).
gear_bolt_head_h=0.6;       // Pinion screw recess (mm): Shallow 0.3 mm pinion screw head recess; countersink remains 6.4 mm diameter for real M3 heads. Removes the large source unnecessary 5 mm deep access wells.
base_t=8.0;                 // Base plate thickness (mm): The black plate under both gears and the pinion; the motor bolts under it.
base_r=30.170000000000005;  // Base radius round the motor (mm): Base 12: 17.5 (Base 11: 29). The plate is the hull of a disc this big round the pinion's axis, one round each pivot post and the two pillars. Just past the 16-tooth pinion's tip circle (16.6).
bush_r=7;                   // Base radius round each post (mm): The base's disc round each pivot post. Base 20/Gripper 25: reduced direct-contact pivot; no handle interface.
base_clear=0.5;             // Post clearance (per side) (mm): Between each pivot post and its bore in the handle-gear, and the pinion spigot and its hole in the plate.
motor_screw_head_d=12.8;    // Base screw countersink (mm): Base 7: the base's 3 motor screws are the same M3 countersunk; the hole opens this wide at the plate's top and narrows at 45 deg (one screw type for the whole gripper).
motor_screw_head_h=0.6;     // Base screw recess (mm): How far the heads' tops sit under the plate's top face (the pinion turns over them). At 0.3 an M3x10 countersunk screw engages the front ring 4.3 mm.
motor_sts=1;                // Motor: 0 RS00, 1 STS3215: Base 14 (as Base 12) is the Feetech STS3215 (the SO-101 servo) only: its horn takes the pinion, its case screws to the base, and the base's wrist tab takes the reBot wrist mount. 0 (RobStride RS00, Base 10/11) is not carried: its 50 mm screw ring does not fit the compact base.
motor_d=57;                 // Body diameter (mm): RS00 (the B601-RS gripper motor): 57 mm. Source: RobStride RS00 drawing (Seeed 100083284) and RS00.step. 14 N m peak, 5 N m rated, 315 rpm no-load at 48 V, CAN.
motor_len=51;               // Body length (mm): 51 +-1 mm, front face to back (drawing); the output boss adds motor_boss_h.
motor_boss_d=35;            // Output boss diameter (mm): The turning output boss on the front face. The pinion's spigot sits on it.
motor_boss_h=1;             // Output boss height (mm): How far the output boss stands proud of the front face (drawing: 1).
motor_out_pcd=27;           // Output flange bolt circle (mm): 6 x M3, 5 deep, on 27 +-0.1 (drawing). 3.3: the pinion bolts here.
motor_out_holes=6;          // Output flange bolts: Number of M3 holes on the output flange.
motor_out_depth=5;          // Output thread depth (mm): Thread depth of those holes.
motor_out_screws=3;         // Pinion bolts used: Base 4: how many of the output flange's motor_out_holes the pinion is bolted through, evenly spaced (3 = every other hole, 120 deg apart; Base 3: all 6). Must divide motor_out_holes. 3 x M3 at 13.5 mm carry the RS00's 14 N m peak with margin (~350 N shear each).
motor_front_pcd=50;         // Front ring bolt circle (mm): 6 x M3 on 50 +-0.1 on the fixed front ring (drawing). The base plate bolts here.
motor_front_holes=6;        // Front ring bolts: Number of M3 holes on the front ring.
motor_front_phase_deg=30;   // Front ring bolt angle (deg): Angle of the first front-ring hole from +x (drawing: 30 deg off the vertical centreline).
motor_front_depth=5;        // Front thread depth (mm): Thread depth on the front ring (the drawing does not give it for this ring; 5 assumed like the output).
motor_front_screws=3;       // Base-to-motor bolts used: Base 4: how many of the front ring's motor_front_holes hold the base plate on, evenly spaced (3 = every other hole; Base 3: all 6). The two dowels still locate it. Must divide motor_front_holes.
motor_dowel_d=3;            // Dowel hole diameter (mm): 2 x 3 (+0.02/+0.04), 5 deep, on the front ring circle (drawing).
motor_dowel_depth=5;        // Dowel hole depth (mm): Depth of the two dowel holes.
motor_dowel_phase_deg=15;   // Dowel angle (deg): Angle of the first dowel from +x (drawing: 15 deg); the second is assumed opposite it.
motor_back_pcd=38;          // Back face bolt circle (mm): 4 x M3, 4 deep, on 38 +-0.1 on the back face (drawing). 3.2: the wrist mount (the base plate has no wrist tab).
motor_back_holes=4;         // Back face bolts: Number of holes on the back face.
motor_back_depth=4;         // Back thread depth (mm): Thread depth on the back face.
motor_back_phase_deg=45;    // Back face bolt angle (deg): Angle of the first back-face hole (drawing: 45).
motor_conn_deg=0;           // Connector direction (deg): Base 10: the RS00's two cable connectors (CAN + 48 V in, and out for the daisy chain) stand out of its body side by side-opposite at its back end. Measured from Seeed's motor_7 mesh. This is their direction from +x in the plan (0: across, +-x). The base takes 3 of the front ring's 6 screws, so the motor can be clocked in 60 deg steps; set this to where they really point. The wrist bracket must clear them.
motor_conn_r=41.5;          // Connector reach (mm): Base 10: how far the connectors reach from the motor axis (Seeed motor_7 mesh: 41.5).
motor_conn_w=26;            // Connector width (mm): Base 10: the connectors' width across (Seeed mesh: 25.8).
motor_conn_len=13;          // Connector length (mm): Base 10: how far the connectors run along the body from its back face (Seeed mesh: ~13).
sts_body_deg=180;           // Servo body direction (deg): Real servo body runs left under the gearbox; avoids its full-size label hump cutting the right pivot support.
sts_near=20.4;              // Axis to the near end (mm): From the output axis to the body's near end (the output end). STS3215 from The Robot Studio's SO-ARM100 CAD (STEP/SO100/STS3215_03a.step, Apache-2.0), measured with OCCT.
sts_len=90.8;               // Body length (mm): The case's long side. STS3215 from The Robot Studio's SO-ARM100 CAD (STEP/SO100/STS3215_03a.step, Apache-2.0), measured with OCCT.
sts_w=49.6;                 // Body width (mm): The case across. STS3215 from The Robot Studio's SO-ARM100 CAD (STEP/SO100/STS3215_03a.step, Apache-2.0), measured with OCCT.
sts_depth=63.6;             // Body depth (mm): From the mounting face (the two rails the case screws are in) to the back face. STS3215 from The Robot Studio's SO-ARM100 CAD (STEP/SO100/STS3215_03a.step, Apache-2.0), measured with OCCT.
sts_face_drop=3.0;          // Output face below the rails (mm): The output end of the case's front face sits this far below the rails, so the base bears only on the rails. STS3215 from The Robot Studio's SO-ARM100 CAD (STEP/SO100/STS3215_03a.step, Apache-2.0), measured with OCCT.
sts_rail_u=11.4;            // Rails start (mm): Where the rails begin, from the output axis toward the far end. STS3215 from The Robot Studio's SO-ARM100 CAD (STEP/SO100/STS3215_03a.step, Apache-2.0), measured with OCCT.
sts_hump_u=17.8;            // Hump start (mm): The raised middle of the front face (the label hump) begins here from the axis. STS3215 from The Robot Studio's SO-ARM100 CAD (STEP/SO100/STS3215_03a.step, Apache-2.0), measured with OCCT.
sts_hump_w=28.0;            // Hump width (mm): The hump's width across the case (the rails are either side of it). STS3215 from The Robot Studio's SO-ARM100 CAD (STEP/SO100/STS3215_03a.step, Apache-2.0), measured with OCCT.
sts_hump_h=2.2;             // Hump height (mm): How far the hump stands above the rails. The base has a window over it, cut straight through, so it prints with no bridge. STS3215 from The Robot Studio's SO-ARM100 CAD (STEP/SO100/STS3215_03a.step, Apache-2.0), measured with OCCT.
sts_boss_d=18.0;            // Output boss (mm): The output spline boss under the horn. STS3215 from The Robot Studio's SO-ARM100 CAD (STEP/SO100/STS3215_03a.step, Apache-2.0), measured with OCCT.
sts_horn_d=40.0;            // Horn diameter (mm): The stock round horn on the output (top horn, the one with the M3 centre screw). STS3215 from The Robot Studio's SO-ARM100 CAD (STEP/SO100/STS3215_03a.step, Apache-2.0), measured with OCCT.
sts_horn_y0=0.6;            // Horn underside (mm): The horn's underside above the rails. STS3215 from The Robot Studio's SO-ARM100 CAD (STEP/SO100/STS3215_03a.step, Apache-2.0), measured with OCCT.
sts_horn_top=5.6;           // Horn top (mm): The horn's top face above the rails: the pinion's spigot sits on it. STS3215 from The Robot Studio's SO-ARM100 CAD (STEP/SO100/STS3215_03a.step, Apache-2.0), measured with OCCT.
sts_horn_pcd=28.0;          // Horn screw circle (mm): The horn's 4 holes (2.5 mm, M3 cut into the horn) on this circle. SO-101 assembly: 4 M3x6 into the horn. STS3215 from The Robot Studio's SO-ARM100 CAD (STEP/SO100/STS3215_03a.step, Apache-2.0), measured with OCCT.
sts_horn_holes=4;           // Horn holes: The horn's screw holes; the pinion uses all of them. STS3215 from The Robot Studio's SO-ARM100 CAD (STEP/SO100/STS3215_03a.step, Apache-2.0), measured with OCCT.
sts_horn_screw_head_d=12.0; // Horn centre screw head (mm): The horn's centre M3 screw (SO-101: M3x6) stands proud of the horn; the pinion's spigot has a recess this wide for its head.
sts_horn_screw_head_h=3.0;  // Horn centre screw head height (mm): How far the centre screw's head stands above the horn (the STEP: 1.5). The recess is 0.3 deeper.
sts_screw_u0=16.6;          // Near case screws (mm): The front face's two near M2 holes, from the axis toward the far end. SO-101 assembly: M2x6 into the case. STS3215 from The Robot Studio's SO-ARM100 CAD (STEP/SO100/STS3215_03a.step, Apache-2.0), measured with OCCT.
sts_screw_u1=58.0;          // Far case screws (mm): The two far M2 holes, from the axis. STS3215 from The Robot Studio's SO-ARM100 CAD (STEP/SO100/STS3215_03a.step, Apache-2.0), measured with OCCT.
sts_screw_w=41.0;           // Case screw spacing (mm): Across the case between each pair of M2 holes. STS3215 from The Robot Studio's SO-ARM100 CAD (STEP/SO100/STS3215_03a.step, Apache-2.0), measured with OCCT.
sts_screw_d=4.6;            // M2 clearance (mm): The base's clearance holes for the 4 M2 case screws.
sts_screw_head_d=8.0;       // M2 head recess (mm): The recess round each M2 head in the base's top face (M2 pan head 3.8): the heads sit below the handle-gears.
sts_screw_head_h=4.0;       // M2 head recess depth (mm): The recess depth; the screw is M2x8 (base_t - this + 4 mm into the case).
sts_idler_d=40.0;           // Idler horn diameter (mm): The free horn on the back face (no screw; SO-101 fits both horns). STS3215 from The Robot Studio's SO-ARM100 CAD (STEP/SO100/STS3215_03a.step, Apache-2.0), measured with OCCT.
sts_idler_h=4.2;            // Idler horn height (mm): How far the idler horn stands off the back face (with its boss, 2.4). STS3215 from The Robot Studio's SO-ARM100 CAD (STEP/SO100/STS3215_03a.step, Apache-2.0), measured with OCCT.
sts_conn_u0=33.0;           // Connectors from (mm): The two 3-pin bus connectors on the back face run from here (from the axis toward the far end)... STS3215 from The Robot Studio's SO-ARM100 CAD (STEP/SO100/STS3215_03a.step, Apache-2.0), measured with OCCT.
sts_conn_u1=59.8;           // Connectors to (mm): ... to here. STS3215 from The Robot Studio's SO-ARM100 CAD (STEP/SO100/STS3215_03a.step, Apache-2.0), measured with OCCT.
sts_conn_w=36.8;            // Connector block width (mm): The connector block across the case. STS3215 from The Robot Studio's SO-ARM100 CAD (STEP/SO100/STS3215_03a.step, Apache-2.0), measured with OCCT.
sts_conn_h=3.6;             // Connector block height (mm): How far the block stands off the back face (its pins 1.7 more). STS3215 from The Robot Studio's SO-ARM100 CAD (STEP/SO100/STS3215_03a.step, Apache-2.0), measured with OCCT.
sts_plug_len=28.0;          // Cable plug keep-out (mm): Room behind the connectors for the plugs and the bend of the bus cable (checked clear of every part): the cable leaves the back of the servo, away from the base, to the bus adapter.
top_t=6.0;                  // Top plate thickness (mm): Base 9: the flat plate over the handle-gears, fingers and pinion. Base 15: a plain cap on the base's four posts (sockets over the pivot posts, M3 down into the pillars). Prints top face down.
top_bush_r=6.5;             // Top plate radius round each pivot (mm): Base 21 reduced support footprint; actual axle capture and M3 clearance checked in geometry_checks.json.
top_gap=0.6;                // Gap under the top plate (mm): Base 9: running clearance between the top plate and the handle-gears, fingers and pinion under it. It is all that keeps them from lifting: they are captured top and bottom.
pillar_d=12.0;              // Top plate pillar (mm): Base 21 reduced support footprint; actual axle capture and M3 clearance checked in geometry_checks.json.
pillar_rim=1;               // Plate rim round a pillar (mm): Base 21 reduced support footprint; actual axle capture and M3 clearance checked in geometry_checks.json.
pillar_x=40.0;              // Pillars across (mm): Base 12: the two pillars the top plate stands on sit this far either side of the centreline, at the base's lower corners (Base 11 had a third pillar on a tab between the fingers; gone, to keep the gripping area clear).
pillar_z=-68.0;             // Pillars down (mm): Base 12: the pillars' height along the fingers from the pivots' line (negative: below it), clear of the handle-gears' teeth at every swing and of the pinion.
cap_socket=2;               // Cap socket depth (mm): Base 15: how deep each pivot post's tip runs up into a blind socket in the top plate's underside. The sockets hold the axles' top ends and locate the cap on the base.
cap_fit=0.3;                // Cap socket fit (mm): Base 15: each post socket over its post, each side, and how far short of the socket's floor the post's tip stops.
pillar_floor=2;             // Pillar screw floor (mm): Base 15: the pilot down each pillar stops this far above the base's top face (blind).
pillar_pilot_d=5.2;         // Pillar screw pilot (mm): Base 15: the hole down each pillar the cap's M3 cuts its own thread in (blind, pillar_floor over the base).
top_access_clear=1;         // Pinion screw access clearance (mm): Base 9: the top plate's hole over the pinion clears its 3 flange screw heads by this much, so the pinion comes off with the plate on.
hub_d=35.6;                 // Hub diameter (mm): Base 10: the wrist hub, a disc bolted to the B601-RS J6 output (an RS00, the same flange as our motor: motor_out_pcd). Seeed's aluminium "Gripper Connector A" (2-M6-ROTOR.step) is 35.6; this printed one is its twin, so either fits every tool plate.
hub_t=6;                    // Hub thickness (mm): Base 10: Connector A is 6 thick. It sits on J6's 1 mm output boss (its arm face is the boss top, link6 z 0 in Seeed's URDF).
hub_bore_d=14;              // Hub centre bore (mm): Base 10: the centre hole (Connector A: 14).
hub_screws=6;               // Hub screws to J6: Base 10: how many of the J6 output's motor_out_holes the hub is bolted through (Connector A: 4; the printed hub takes all 6). Must divide motor_out_holes.
hub_screw_phase_deg=0;      // Hub screw angle (deg): Base 10: the first J6 screw's angle from +x. J6 turns anyway, so only the hub's own features care.
hub_cbore_d=6;              // Hub screw counterbore (mm): Base 10: M3 socket heads sit in these, from the hub's tool face (Connector A: 6.0).
hub_cbore_h=3;              // Hub counterbore depth (mm): Base 10: depth of those counterbores; the rest is the screw grip (M3 x 6: 3 grip + 3 into J6's 5 deep holes).
hub_relief_d=4;             // Hub relief holes (mm): Base 10: 3 holes on 24.46 that clear the RS00 output's 3 x 3 mm features (Connector A: 4.0). 0 = none.
hub_relief_pcd=24.46;       // Hub relief circle (mm): Base 10: the RS00 drawing's 24.46 circle.
hub_scallop_d=7.06;         // Hub scallops (mm): Base 10: 4 notches round the hub's edge on the tool screws' circle (motor_back_pcd, 45 deg) clear those screws' heads, which stand in the tool plate's bore (Connector A: 7.06).
radial_n=3;                 // Radial screws: Base 10: how a tool locks onto the hub: M3 screws in from the tool plate's side into the hub's rim, as Seeed's stock gripper does (Connector B to A: 3 at 120 deg). Loosen 3 screws, lift the tool off, slide the next one on.
radial_phase_deg=30;        // Radial screw angle (deg): Base 10: the first radial screw's angle from +x (Connector A: 30, 150, 270). Kept 45 deg off the tool screws, and the Aero plate's cable channel sits between two of them.
radial_pilot_d=2.5;         // Radial pilot (hub) (mm): Base 10: the printed hub's radial holes; the M3 cuts its own thread (Connector A is tapped M3).
radial_pilot_len=6;         // Radial pilot depth (mm): Base 10: how deep they run in from the hub's rim.
tool_d=5.0;                 // Driver shaft envelope (mm): Straight 2.5 mm shaft probe for small screw drivers; handle outside assembly, not an L-key swing proof.
tool_t=9.5;                 // Tool plate thickness (mm): Base 10: Connector B: 9.5, of which tool_floor is the floor and the rest the socket the hub drops into.
tool_floor=3;               // Tool plate floor (mm): Base 10: the floor between the socket and the tool (Connector B: 3). The hub's tool face seats on it.
tool_bore_d=36;             // Socket bore (mm): Base 10: the socket for the hub (Connector B: 36.0, so the 35.6 hub has 0.2 a side).
tool_center_d=26.2;         // Tool plate centre hole (mm): Base 10: the floor's centre hole (Connector B: 26.2).
tool_screw_pcd=38;          // Tool screw circle (mm): Base 10: 4 x M3 on 38 at 45 deg, through the floor into the tool. The RS00's back face has exactly this (motor_back_pcd), and so does the Aero Hand's wrist pad (4 M3 inserts on a 26.9 square, measured from its CAD): one tool plate fits both.
tool_screw_phase_deg=45;    // Tool screw angle (deg): Base 10: the first tool screw's angle (Connector B: 45).
tool_head_d=6.2;            // Tool screw head pocket (mm): Base 10: the 4 tool screws' heads stand on the floor in pockets half in the socket wall (Connector B: 6.2, 3.5 high); the hub's scallops clear them. Printed, each pocket runs on up to the socket's mouth, so nothing hangs over it.
radial_h=3;                 // Radial screw height (mm): Base 10: the radial screws' axis above the floor top: the hub's mid-thickness (Connector B: 3).
radial_clear_d=3.5;         // Radial clearance hole (mm): Base 10: the radial screws' clearance in the tool plate (Connector B: 3.5).
radial_head_d=5.8;          // Radial screw head counterbore (mm): Base 10: counterbore for the radial screws' heads, from the rim in to radial_seat_r (Connector B: 5.8).
radial_seat_r=21.9;         // Radial head seat (mm): Base 10: the heads seat this far from the axis (Connector B: spot faces at 21.9), so M3 x 8 reaches 4 mm into the hub.
mount_axis_y=0;             // J6 axis offset (dorsal) (mm): Base 10: where the arm's roll axis (J6) runs, along the fingers (Z), dorsal of the finger mid-plane. 0: through the fingers' mid-plane and between the fingers, as the stock gripper's fingers are, so rolling the wrist turns the fingers about their own centre line. -30 puts it nearer the motor (the centre of mass) and shortens the bracket.
mount_gap=1;                // Gap under the gripper (mm): Base 10: clearance between the bracket's foot and the gripper's lowest part (Base 14: the base's wrist tab).
foot_t=8;                   // Foot thickness (mm): Base 10: the bracket's foot, the flat plate across the J6 axis that the tool plate screws to. It carries the gripper ~70 mm out from the leg (mount_axis_y 0), so it is thick: 8.
foot_pilot_d=2.5;           // Foot pilot holes (mm): Base 10: the 4 tool screws come up through the tool plate's floor into these (self-tapped, right through the foot: M3 x 10 = 3 floor + 7).
leg_t=5;                    // Leg thickness (mm): Base 10: the bracket's leg, a plate up the motor's back face, bolted to its 4 M3 (motor_back_pcd); M3 x 8 = 5 + 3 of the 4 mm thread. Base 14: the leg lies flat under the base's wrist tab instead; M3 x 10 = 5 through the leg + 5 into the 6 mm tab.
leg_boss_r=6;               // Leg rim round each screw (mm): Base 10: the leg is the hull of a disc this big round each leg screw and the foot. Base 14: the base's wrist tab is the same discs.
gusset_t=5;                 // Gusset thickness (mm): Base 10: two ribs between leg and foot, on the leg's outer side at its edges.
gusset_len=10;              // Gusset size (mm): Base 10: each gusset's legs (a 45 deg triangle, so it prints without support). Base 14: 10 (Base 10: 15), so the gussets stay under the servo's near end.
wrist_screw_x=13;           // Wrist tab screws across (mm): Base 14: the two M3 that clamp the bracket's leg under the base's wrist tab sit this far either side of the centreline. The STS3215's back face has no screw ring (Base 10's leg bolted to the RS00's), so the base takes the arm's load, not the servo case.
wrist_screw_z=-56;          // Wrist tab screws height (mm): Base 14: their height along the fingers from the pivots' line (negative: below it). -56 puts the tab (leg_boss_r round each) 2 mm under the servo's near end and just under the base's disc round the pinion, so the leg lies flat under the base beside the servo, never on it.
wrist_pilot_d=5.0;          // Wrist tab pilot hole (mm): Base 14: the tab's holes, straight through the base (vertical as it prints); the M3 cut their own thread.
gusset_x=5;                 // Gussets across (mm): Base 14: the two gussets sit this far either side of the centreline, inboard of the leg screws so their heads and the hex key stay clear (Base 10 put them at the leg's edges).
tie_x=5;                    // Cable tie x (mm): Base 10: the motor cable is zip-tied to the foot here, then drops past the tool plate to J6, as the stock gripper's does. Base 14: 5 (Base 10: 30), under the STS3215's bus connectors.
tie_dy=7;                   // Cable tie y (from the motor back) (mm): Base 10: the tie point's y, measured in from the motor's back face (Base 14: the STS3215's back face).
tie_gap=9;                  // Tie slot spacing (mm): Base 10: the two zip-tie slots straddle the cable this far apart (centre to centre).
tie_w=4.5;                  // Tie slot length (mm): Base 10: each slot's long side (a 3.6 mm zip tie).
tie_slot_t=2;               // Tie slot width (mm): Base 10: each slot's short side.
aero_spacer=8;              // Aero plate spacer (mm): Base 10: the Aero Hand's tool plate is a tool plate plus this much more below the floor, so the hand's USB and 6 V leads leave its wrist pad's 15 mm centre hole sideways in a channel instead of being pinched by the 3 mm floor. M3 x 14: 3 floor + 8 spacer + 3 into the hand's inserts.
aero_channel_w=10;          // Cable channel width (mm): Base 10: the channel in the plate's hand face, from the centre to the rim.
aero_channel_h=3;           // Cable channel depth (mm): Base 10: its straight walls' height; the roof above them peaks at 45 deg (aero_channel_w/2 higher), so it prints open side down without support. Walls + roof must stay inside the spacer and floor.
aero_channel_deg=90;        // Cable channel direction (deg): Base 10: from +x; kept between two radial screws and clear of the four tool screws.
arm_roll_deg=0;             // Wrist roll shown (deg): Base 10: the reBot Arm's J6 roll in the preview (arm_pose.py, at export; not live).
aero_view_x=230;            // Aero Hand shown at x (mm): Base 10: in the preview the Aero Hand and its plate stand beside the arm, as the other tool on the rack.
mm_per_px=0.2;              // mm_per_px (mm/px): Photo scale: ~110 mm pivot to tip. No measured scale.
px_pivot=[337, 395];        // px_pivot (px): Frame origin in the two-hands photo.
axis_deg=36.5;              // axis_deg (deg): Bisector of the two closed fingers in the photo (27 and 46 deg).
contact_back=-0.017;        // contact_back (mm): Base 12: -0.017. How far the smoothed point sits outboard of the traced one; sets the toe-in (gripper.scad toe) so closed the points meet with no overlap. Toed in, the solid meets 0.6 mm behind the traced point, where the rounding sits 0.019 mm further out than at the point; -0.017 leaves ~0.002 mm per side, inside the 0.01 mm push of the contact checks. (2.5-Base 11: 0.0005, which set the pivot spacing.)
rail_p=[[-5.06, 12.79], [-9.54, 36.26]];// rail_p (mm): Two outer-edge points of the traced outline where the edge is straight within 0.3 mm (the handle's rail).
round_back=1.5;             // round_back (mm): How far tip_r rounds the triangle point back from the trace (trace_photo.py ROUND_BACK).
max_angle=30;               // max_angle (deg): Each finger's largest swing about its pivot.
drive_gap=1.6;              // Gear to finger clearance (mm): Axial air gap between the 6 mm Gripper 24 band and the inverted overhead gear teeth. Adds to overall depth; CAD motion only, physical hand clearance unverified.
key_r=6.6;                  // Hex boss radius (mm): Circumradius of short integral finger-to-gear hex boss; 3 mm post with 0.25 mm radial bore clearance, minimum hex wall about 1.1 mm.
key_fit=0.3;                // Hex radial allowance (mm): Radial socket offset; resin fit requires physical calibration.
key_depth=5.0;              // Hex engagement (mm): Boss engagement inside the overhead gear, captured axially by base and cap.
key_end_gap=0.4;            // Hex tip clearance (mm): Boss tip clearance in gear socket; cap limits axial travel.
tool_len=90.0;              // Driver access length (mm): Axial shaft access outside stack; assemble servo and purchased plate first.
case_tool_tilt=10;          // Near ear driver tilt (deg): Near ear screws need 10 degree PH0 shaft tilt away from motor output-end overhang. Straight driver is blocked; physical screw-drive engagement at this angle unverified.
contact_edge_w=0.0;         // Direct outside edge (mm): Trim the retired strap-hook protrusions back to the original straight outside rail, for direct thumb/index contact.
contact_trim_u0=-24.0;      // Hook trim start (mm): Extent along original rail including lower hook.
contact_trim_u1=68.0;       // Hook trim end (mm): Extent along original rail including upper hook; distal working blade preserved.
compact_cap=1;              // Four-post cap: Hull only the two pivot sockets and two fastening pillars; remove inherited pinion disc and access opening.
cap_rear_z=-68.0;           // Rear cap support position (mm): Rear pillar Z coordinate; closer to pivots without entering pinion motion. Revalidate full stroke after tuning.
