JacobSchantz/HelpingHands/Two Finger Gripper/versions/v007_generalist_fingers/gripper.scad

/* GENERALIST GRIPPER — GENERATION 7 / the two yellow fingers only, mm.
   Jake: "delete everything else, just keep the yellow grippers ... get the yellow part to
   look as close as possible to Generalist's yellow part." No body, mount, camera, straps,
   carriers, gears or drive. The outline is a pixel trace of the lower finger of the
   left-hand device in cad/reference/generalist_gripper_gen6_two_hands.png, found by colour
   (trace_photo.py -> trace_px.scad) and mapped to mm below. Every hole goes through.
   Axes: X across (right finger +X), Z along the fingers (tips +Z), +Y = dorsal. */
$fn=32;
part="assembly"; // assembly | left | right | collision | none | viewer_left | viewer_right
angle=15;        // each finger's swing about its pivot; 0 = closed (the photo pose)
max_angle=30;

// ---------- photo -> mm ----------
include <trace_px.scad>   // outline_px, holes_px, dot_px, slots_px, tip_px: generated by trace_photo.py
mm_per_px=0.2;            // ~110 mm pivot-to-tip; no measured scale, see README
px_pivot=[337,395];       // frame origin only: the photo shows the lip solid, so no bore is cut (the joint is under the carrier)
axis_deg=36.5;            // bisector of the two closed fingers in the photo (27 and 46 deg)
plate=13;                 // finger thickness along Y, centred on the hand plane: the side and robot photos
                          // show the blade about as thick as it is wide
tip_thick=4;              // from the black dot the blade wedges down to this at the point
tip_gap=1.0;              // closed tip-to-tip gap

// finger frame (right finger): pivot at origin, inner (gripping) side is -X
function px(q)=let(d=[q[0],q[1]]-px_pivot) mm_per_px*[-(d[0]*sin(axis_deg)-d[1]*cos(axis_deg)), d[0]*cos(axis_deg)+d[1]*sin(axis_deg)];
function pxs(l)=[for(q=l) px(q)];

tip=px(tip_px);
dot_z=px(dot_px)[1];      // the wedge starts at the black dot (side + robot photos)
pivot=-min([for(p=pxs(outline_px)) p[0]])+tip_gap/2;  // half the pivot spacing: closed jaws sit tip_gap apart
min_hole=1.8;             // blurred small holes are read no smaller than this
min_slot=1.2;             // ...and an oval no narrower than this
jaw_px=[[753.2,539.0],[834.0,575.5]];  // the inner (gripping) edge of the blade, on outline_px
ridge=[1.6,0.8,0.6];      // jaw ridges: pitch, groove width, groove depth (mm). The side photo shows the
                          // gripping faces ribbed across their width, so the grooves run through the full thickness
slot=[2.7,1.6];           // blade slot length x width, fat ovals; the last one is ~70% (photo)
function frame_deg(img_deg)=90-(img_deg-axis_deg);   // a direction in the photo -> angle in the finger frame

module profile() {offset(r=0.4) offset(delta=-0.8) offset(r=0.4) polygon(pxs(outline_px));}  // photo blur -> smooth edges
module holes2d() {
    for(h=holes_px) translate(px(h))
        if(h[2]/h[3]>1.5) rotate(frame_deg(h[4])) scale([max(min_hole,h[2]*mm_per_px),max(min_slot,h[3]*mm_per_px)]) circle(d=1);
        else circle(d=max(min_hole,(h[2]+h[3])/2*mm_per_px));
    translate(px(dot_px)) circle(d=dot_px[2]*mm_per_px);
    for(i=[0:len(slots_px)-1]) translate(px(slots_px[i])) rotate(frame_deg(120))   // slanted like a forward slash in the photo, ~35 deg off the row
        scale(i==len(slots_px)-1?0.7:1) hull() for(s=[-1,1]) translate([s*(slot[0]-slot[1])/2,0]) circle(d=slot[1],$fn=16);
}
module ridges2d() {       // grooves notched into the jaw edge, square to it
    a=jaw_px[0]; b=jaw_px[1]; L=norm(b-a)*mm_per_px; n=floor(L/ridge[0]);
    u=(b-a)/norm(b-a); v=[-u[1],u[0]];                         // v points into the finger (down in the photo)
    for(i=[1:n-1]) let(c=a+u*(i*ridge[0]/mm_per_px), w=ridge[1]/2/mm_per_px, d=ridge[2]/mm_per_px)
        polygon(pxs([c-u*w-v*3, c+u*w-v*3, c+u*w+v*d, c-u*w+v*d]));
}
module side_taper() {     // Y-Z wedge: full plate to the dot, then thinning to the tip
    rotate([90,0,90]) linear_extrude(200,center=true)
        polygon([[-plate/2-1,-50],[plate/2+1,-50],[plate/2,dot_z],[tip_thick/2,tip[1]+2],
                 [-tip_thick/2,tip[1]+2],[-plate/2,dot_z]]);
}
module xz(h) {rotate([-90,0,0]) mirror([0,1,0]) linear_extrude(h,center=true) children();}
module finger() {
    difference() {
        intersection() {xz(plate) profile(); side_taper();}
        xz(plate+2) holes2d();          // every hole goes all the way through (Jake)
        xz(plate+2) ridges2d();
    }
}
module placed(s=1,a=angle) {
    translate([s*pivot,0,0]) rotate([0,s*a,0]) if(s<0) mirror([1,0,0]) children(); else children();
}
module piece(q,a=angle) {
    if(q=="left") placed(-1,a) finger();
    if(q=="right") placed(1,a) finger();
}
module clash(a=angle) {intersection(){piece("left",a);piece("right",a);}}
assert(angle>=0&&angle<=max_angle,"Angle outside intended motion");
if(part=="assembly") color("#efb83b") {piece("left");piece("right");}
if(part=="right") color("#efb83b") finger();
if(part=="left") color("#efb83b") mirror([1,0,0]) finger();
if(part=="collision") clash();
for(q=["left","right"]) if(part==str("viewer_",q)) piece(q);
