JacobSchantz/HelpingHands/Two Finger Gripper/versions/v009_generalist_fingers_sonnet/trace_px.scad

// GENERATED by trace_photo.py from cad/reference/generalist_gripper_gen6_two_hands.png. Do not edit;
// change the hand patches in trace_photo.py and re-run.
outline_px=[
    [392.3, 408.3], [375.6, 399.3], [362.3, 392.9], [358.2, 391.4], [356.1, 391.2], [354.1, 391.4],
    [352.0, 392.1], [350.2, 393.3], [348.8, 394.9], [347.9, 396.8], [347.4, 398.9], [347.2, 401.0],
    [347.3, 403.2], [347.7, 405.2], [349.1, 409.2], [351.0, 413.0], [351.3, 415.3], [350.6, 417.3],
    [349.1, 418.8], [347.2, 419.8], [345.1, 420.2], [343.0, 420.0], [341.0, 419.3], [339.1, 418.3],
    [335.6, 415.9], [332.5, 413.1], [329.8, 409.9], [328.6, 408.2], [326.5, 404.5], [325.1, 400.6],
    [324.4, 396.4], [324.4, 394.2], [324.8, 392.1], [325.7, 390.2], [327.1, 388.7], [339.5, 378.7],
    [348.8, 369.7], [351.1, 368.0], [353.7, 366.7], [354.0, 366.0], [405.0, 339.0], [405.9, 338.7],
    [407.4, 337.6], [410.0, 336.1], [412.6, 335.1], [415.3, 334.5], [417.9, 334.5], [419.6, 334.9],
    [421.8, 336.2], [423.5, 338.3], [426.7, 344.2], [430.8, 351.0], [435.3, 359.9], [437.8, 364.1],
    [439.7, 366.4], [443.9, 370.6], [445.8, 372.7], [447.4, 375.1], [450.0, 380.2], [451.7, 382.6],
    [459.3, 391.6], [466.7, 399.8], [469.6, 402.5], [471.9, 404.3], [474.4, 405.9], [480.2, 409.2],
    [487.3, 414.4], [514.6, 430.6], [517.0, 432.4], [522.2, 436.9], [524.6, 438.6], [528.9, 440.9],
    [535.3, 443.7], [552.3, 449.5], [556.1, 450.5], [566.8, 452.8], [577.6, 454.7], [589.5, 456.1],
    [596.5, 456.5], [609.4, 456.4], [622.2, 454.6], [624.5, 454.7], [626.5, 455.0], [628.5, 455.7],
    [630.3, 456.5], [633.5, 459.0], [634.9, 460.4], [637.3, 463.8], [638.3, 465.6], [639.9, 469.3],
    [641.1, 473.2], [643.6, 483.2], [645.1, 487.0], [646.1, 488.7], [647.4, 490.3], [648.8, 491.8],
    [652.0, 494.3], [655.7, 496.3], [659.6, 497.9], [663.6, 499.0], [665.6, 499.3], [669.6, 499.5],
    [671.6, 499.4], [677.7, 498.4], [681.7, 498.0], [683.8, 498.0], [685.9, 498.3], [687.8, 498.9],
    [689.6, 499.9], [691.1, 501.2], [692.4, 502.8], [695.9, 507.9], [701.1, 516.7], [703.6, 519.9],
    [706.5, 522.7], [711.4, 526.5], [716.8, 529.4], [728.3, 533.5], [732.0, 535.2], [733.7, 536.3],
    [737.8, 537.0], [743.8, 538.7], [749.4, 540.9], [754.9, 543.5], [762.0, 547.5], [782.8, 560.4],
    [861.5, 607.5], [853.4, 608.2], [843.2, 608.7], [831.0, 609.0], [820.9, 609.0], [812.7, 608.7],
    [806.6, 608.2], [800.6, 607.6], [792.5, 606.4], [780.5, 604.1], [770.6, 601.7], [760.9, 598.6],
    [737.9, 590.4], [726.4, 586.5], [716.6, 583.8], [706.6, 581.7], [701.5, 578.1], [686.1, 567.9],
    [681.2, 564.2], [676.5, 560.1], [672.2, 555.6], [669.8, 552.3], [667.7, 548.8], [661.7, 537.9],
    [658.2, 532.8], [656.8, 531.3], [653.8, 528.5], [650.5, 526.1], [646.9, 524.0], [643.1, 522.1],
    [639.2, 520.5], [628.7, 516.8], [595.9, 502.2], [565.6, 489.4], [552.0, 483.2], [534.0, 474.4],
    [510.2, 464.1], [474.8, 445.6], [470.3, 443.4], [460.3, 439.1], [435.5, 426.4], [430.9, 424.4],
    [418.7, 419.9], [411.4, 416.7], [403.5, 412.7]];
holes_px=[  // [x, y, major, minor, angle] in photo px / image degrees
    [376.4, 380.6, 18.0, 18.0, 0.0], [388.3, 362.2, 17.5, 17.5, 0.0], [391.2, 395.8, 10.0, 10.0, 0.0], [399.6, 380.0, 14.9, 14.9, 0.0], [410.6, 360.3, 18.0, 18.0, 0.0], [411.9, 399.4, 18.0, 18.0, 0.0],
    [422.8, 379.5, 18.0, 18.0, 0.0], [435.1, 398.6, 18.0, 18.0, 0.0], [446.8, 417.3, 18.0, 18.0, 0.0], [467.6, 415.9, 15.0, 15.0, 0.0], [480.4, 431.6, 14.7, 14.7, 0.0], [495.8, 441.4, 14.3, 14.3, 0.0],
    [511.7, 448.4, 14.0, 14.0, 0.0], [527.7, 457.1, 13.6, 13.6, 0.0], [544.3, 463.1, 13.2, 13.2, 0.0], [563.8, 465.2, 12.7, 12.7, 0.0], [576.4, 478.4, 12.4, 12.4, 0.0], [597.0, 475.7, 11.9, 11.9, 0.0],
    [608.2, 492.5, 11.7, 11.7, 0.0], [617.2, 474.3, 11.5, 11.5, 0.0], [626.4, 493.3, 11.3, 11.3, 0.0], [639.3, 507.4, 10.9, 10.9, 0.0], [657.0, 511.0, 10.5, 10.5, 0.0], [670.3, 522.4, 10.2, 10.2, 0.0],
    [690.2, 522.5, 9.7, 9.7, 0.0], [700.6, 537.7, 9.5, 9.5, 0.0]];
dot_px=[724.2, 561.9, 17.0];
slots_px=[
    [749.5, 554.0], [762.6, 560.5], [775.7, 567.0], [788.8, 573.5], [801.9, 580.0], [815.0, 586.5]];
tip_px=[861.5, 607.5];
jaw_path_px=[
    [733.7, 536.3], [736.9, 536.8], [740.0, 537.5], [743.0, 538.4], [745.9, 539.4], [748.8, 540.6],
    [751.6, 541.8], [754.4, 543.2], [757.2, 544.7], [759.9, 546.2], [762.6, 547.8], [765.2, 549.4],
    [767.9, 551.1], [770.5, 552.8], [773.2, 554.4], [775.8, 556.1], [778.5, 557.8], [781.1, 559.4],
    [783.8, 561.0], [786.5, 562.6], [789.2, 564.2], [791.9, 565.8], [794.6, 567.4], [797.2, 569.0],
    [799.9, 570.6], [802.6, 572.1], [805.3, 573.7], [808.0, 575.4], [810.6, 577.0], [813.3, 578.6],
    [816.0, 580.2], [818.7, 581.8], [821.3, 583.4], [824.0, 585.0], [826.7, 586.6], [829.4, 588.2],
    [832.0, 589.8], [834.7, 591.4], [837.4, 593.0], [840.1, 594.6], [842.8, 596.3], [845.4, 597.9],
    [848.1, 599.5], [850.8, 601.1], [853.5, 602.7], [856.1, 604.3], [858.8, 605.9], [861.5, 607.5]];  // the inner edge as drawn, for the ridges
