JacobSchantz/HelpingHands/Two Finger Gripper/versions/v011b_generalist_fingers_astra/trace_px.scad

// GENERATED by trace_photo.py from cad/reference/generalist_gripper_gen6_two_hands.png. Do not edit;
// change the hand patches in trace_photo.py and re-run.
outline_px=[
    [415.0, 333.8], [423.0, 335.6], [437.9, 365.0], [447.7, 374.0], [449.7, 381.0], [467.0, 400.5],
    [516.0, 430.9], [524.0, 439.0], [553.0, 450.1], [580.0, 455.3], [612.0, 456.5], [619.0, 454.2],
    [634.3, 458.0], [637.3, 461.0], [639.9, 479.0], [644.2, 485.0], [642.3, 490.0], [645.0, 493.1],
    [653.0, 497.3], [669.0, 500.4], [675.0, 499.9], [679.0, 495.8], [689.0, 497.6], [694.0, 506.4],
    [714.1, 519.0], [712.7, 527.0], [716.0, 531.1], [733.2, 537.0], [738.6, 538.7], [743.9, 540.5],
    [749.2, 542.5], [754.4, 544.5], [759.6, 546.7], [764.8, 549.1], [769.9, 551.5], [774.9, 554.1],
    [780.0, 556.8], [784.9, 559.6], [789.9, 562.5], [794.7, 565.6], [799.6, 568.7], [804.4, 572.0],
    [809.2, 575.4], [813.9, 578.9], [818.6, 582.5], [823.2, 586.2], [827.8, 590.1], [832.4, 594.0],
    [836.9, 598.0], [841.5, 601.8], [846.0, 606.0], [839.3, 608.0], [832.6, 610.0], [825.9, 612.0],
    [819.1, 614.0], [812.4, 616.0], [806.4, 616.1], [800.7, 615.4], [794.9, 614.7], [789.3, 613.8],
    [783.6, 612.9], [778.0, 611.8], [772.5, 610.6], [767.0, 609.2], [761.5, 607.7], [756.1, 606.0],
    [750.8, 604.2], [745.6, 602.1], [740.4, 599.8], [735.3, 597.3], [730.3, 594.6], [725.4, 591.6],
    [720.6, 588.4], [715.9, 584.9], [690.0, 571.1], [676.0, 569.5], [668.0, 565.0], [664.0, 558.0],
    [665.5, 552.0], [663.3, 535.0], [651.0, 526.0], [510.0, 464.2], [436.0, 426.3], [394.0, 409.2],
    [359.0, 390.0], [353.6, 391.0], [347.9, 400.0], [348.1, 404.0], [352.9, 410.0], [352.0, 415.0],
    [349.0, 417.3], [345.0, 416.5], [327.0, 400.2], [323.7, 395.0], [325.0, 390.6], [354.0, 365.9],
    [405.0, 338.7]];
holes_px=[  // [x, y, major, minor, angle] in photo px / image degrees
    [375.8, 380.7, 16.0, 13.7, 58.9], [387.0, 360.0, 10.0, 10.0, 0.0], [391.2, 395.8, 10.0, 10.0, 0.0], [399.1, 380.2, 15.9, 14.4, 58.7], [408.8, 360.5, 17.4, 14.6, 46.8], [412.4, 399.7, 17.0, 13.8, 61.9],
    [422.2, 379.6, 16.2, 13.8, 58.1], [435.7, 398.5, 16.4, 14.0, 65.9], [447.7, 416.5, 15.7, 13.9, 96.4], [467.6, 415.9, 13.8, 9.2, 53.4], [480.4, 431.6, 14.7, 12.5, 105.7], [495.8, 441.4, 13.3, 6.8, 125.1],
    [511.7, 448.4, 13.5, 11.3, -140.7], [527.7, 457.1, 12.9, 7.5, 124.0], [544.3, 463.1, 13.0, 12.1, 89.0], [563.8, 465.2, 9.2, 7.6, 161.8], [576.4, 478.4, 13.5, 11.5, 136.7], [597.0, 475.7, 12.5, 11.2, 103.9],
    [608.2, 492.5, 11.5, 11.3, -145.8], [617.2, 474.3, 12.4, 9.3, 97.8], [626.4, 493.3, 10.0, 10.0, 0.0], [639.3, 507.4, 10.3, 7.7, -166.3], [657.0, 511.0, 8.0, 8.0, 0.0], [670.3, 522.4, 9.4, 7.8, 150.3],
    [690.2, 522.5, 10.8, 8.5, 102.3], [700.6, 537.7, 6.9, 5.9, 121.2]];
dot_px=[724.2, 561.9, 17.0];
slots_px=[
    [747.9, 557.7], [761.0, 564.2], [774.1, 570.7], [787.2, 577.2], [800.3, 583.7], [813.4, 590.2]];
tip_px=[846.0, 606.0];
ridges_px=[  // inner-edge groove stations, outward normal [x, y, nx, ny] px
    [715.8, 530.9, 0.6, -0.8], [720.5, 532.6, 0.3, -0.9], [725.2, 534.3, 0.3, -0.9], [730.0, 535.9, 0.3, -0.9], [734.7, 537.4, 0.3, -1.0], [739.5, 539.0, 0.3, -0.9],
    [744.2, 540.6, 0.3, -0.9], [748.9, 542.3, 0.4, -0.9], [753.5, 544.2, 0.4, -0.9], [758.1, 546.1, 0.4, -0.9], [762.7, 548.1, 0.4, -0.9], [767.2, 550.2, 0.4, -0.9],
    [771.7, 552.4, 0.5, -0.9], [776.2, 554.7, 0.5, -0.9], [780.6, 557.1, 0.5, -0.9], [784.9, 559.6, 0.5, -0.9], [789.2, 562.1, 0.5, -0.9], [793.5, 564.8, 0.5, -0.8],
    [797.7, 567.5, 0.5, -0.8], [801.8, 570.3, 0.6, -0.8], [805.9, 573.1, 0.6, -0.8], [810.0, 576.0, 0.6, -0.8], [814.0, 579.0, 0.6, -0.8], [818.0, 582.1, 0.6, -0.8],
    [821.9, 585.2, 0.6, -0.8], [825.7, 588.3, 0.6, -0.8], [829.6, 591.6, 0.6, -0.8], [833.4, 594.8, 0.7, -0.8], [837.1, 598.1, 0.6, -0.8]];
