JacobSchantz/HelpingHands/Two Finger Gripper/versions/v015_generalist_long_jaw/trace_px.scad

// GENERATED by trace_photo.py from cad/reference/generalist_gripper_gen6_two_hands.png. Do not edit;
// change the hand patches in trace_photo.py and re-run.
outline_px=[
    [415.00, 333.82], [423.00, 335.63], [437.88, 365.00], [447.73, 374.00], [449.66, 381.00], [467.00, 400.47],
    [516.00, 430.90], [524.00, 438.95], [553.00, 450.09], [580.00, 455.34], [612.00, 456.49], [619.00, 454.16],
    [634.28, 458.00], [637.27, 461.00], [639.92, 479.00], [644.18, 485.00], [642.31, 490.00], [645.00, 493.12],
    [653.00, 497.30], [669.00, 500.45], [675.00, 499.91], [679.00, 495.84], [689.00, 497.63], [694.00, 506.38],
    [714.07, 519.00], [712.72, 527.00], [716.00, 531.12], [726.52, 551.07], [731.27, 552.17], [735.97, 553.34],
    [740.62, 554.58], [745.23, 555.89], [749.79, 557.27], [754.32, 558.71], [758.80, 560.22], [763.24, 561.79],
    [767.65, 563.43], [772.01, 565.12], [776.34, 566.87], [780.64, 568.68], [784.90, 570.55], [789.13, 572.46],
    [793.32, 574.44], [797.48, 576.46], [801.62, 578.53], [805.72, 580.65], [809.80, 582.81], [813.86, 585.02],
    [817.88, 587.27], [821.89, 589.56], [825.87, 591.89], [829.83, 594.26], [833.77, 596.67], [837.69, 599.11],
    [841.59, 601.58], [845.47, 604.09], [849.34, 606.63], [853.18, 609.20], [857.00, 611.82], [860.79, 614.48],
    [864.56, 617.18], [868.31, 619.92], [872.05, 622.67], [875.79, 625.44], [879.54, 628.20], [883.29, 630.97],
    [887.04, 633.74], [890.80, 636.51], [894.57, 639.26], [898.36, 642.00], [902.18, 644.70], [906.05, 647.34],
    [909.86, 649.82], [913.80, 652.31], [917.70, 655.20], [912.66, 655.07], [908.17, 653.85], [903.54, 652.86],
    [898.74, 652.22], [893.93, 651.60], [889.11, 650.98], [884.29, 650.36], [879.47, 649.72], [874.67, 649.06],
    [869.87, 648.37], [865.09, 647.65], [860.33, 646.89], [855.60, 646.09], [850.89, 645.24], [846.21, 644.33],
    [841.56, 643.37], [836.94, 642.35], [832.37, 641.26], [827.83, 640.10], [823.34, 638.86], [818.90, 637.55],
    [814.49, 636.16], [810.11, 634.73], [805.76, 633.24], [801.43, 631.71], [797.13, 630.12], [792.85, 628.48],
    [788.60, 626.78], [784.38, 625.03], [780.19, 623.23], [776.02, 621.37], [771.88, 619.45], [767.77, 617.48],
    [763.69, 615.45], [759.63, 613.37], [755.60, 611.23], [751.61, 609.03], [747.64, 606.78], [743.70, 604.46],
    [739.79, 602.09], [735.91, 599.66], [732.06, 597.17], [728.23, 594.62], [724.44, 592.01], [720.68, 589.34],
    [716.95, 586.61], [713.25, 583.82], [690.00, 571.10], [676.00, 569.50], [668.00, 565.00], [664.00, 558.00],
    [665.50, 552.00], [663.30, 535.00], [651.00, 525.97], [510.00, 464.24], [436.00, 426.32], [394.00, 409.25],
    [359.00, 390.03], [353.59, 391.00], [347.92, 400.00], [348.05, 404.00], [352.88, 410.00], [352.00, 414.98],
    [349.00, 417.28], [345.00, 416.45], [327.00, 400.21], [323.72, 395.00], [325.00, 390.59], [354.00, 365.92],
    [405.00, 338.68]];
holes_px=[  // [x, y, major, minor, angle] in photo px / image degrees
    [375.77, 380.68, 15.96, 13.75, 58.93], [387.00, 360.00, 10.00, 10.00, 0.00], [391.18, 395.76, 10.00, 10.00, 0.00], [399.09, 380.20, 15.94, 14.42, 58.70], [408.85, 360.52, 17.38, 14.63, 46.80], [412.45, 399.68, 17.02, 13.79, 61.95],
    [422.25, 379.61, 16.16, 13.80, 58.12], [435.72, 398.49, 16.43, 13.96, 65.85], [447.74, 416.54, 15.67, 13.88, 96.35], [467.57, 415.86, 13.80, 9.23, 53.39], [480.41, 431.62, 14.71, 12.45, 105.67], [495.79, 441.36, 13.33, 6.83, 125.05],
    [511.66, 448.40, 13.45, 11.29, -140.67], [527.69, 457.09, 12.91, 7.49, 124.02], [544.31, 463.11, 12.98, 12.09, 88.99], [563.85, 465.15, 9.17, 7.57, 161.81], [576.39, 478.41, 13.52, 11.47, 136.75], [597.01, 475.72, 12.55, 11.16, 103.87],
    [608.19, 492.52, 11.54, 11.34, -145.84], [617.20, 474.26, 12.37, 9.34, 97.80], [626.42, 493.27, 10.00, 10.00, 0.00], [639.32, 507.40, 10.27, 7.67, -166.34], [657.00, 511.00, 8.00, 8.00, 0.00], [670.32, 522.44, 9.41, 7.83, 150.28],
    [690.20, 522.48, 10.82, 8.50, 102.26], [700.61, 537.74, 6.85, 5.90, 121.17]];
dot_px=[724.2, 561.9, 17.0];
slots_px=[
    [751.46, 572.36], [774.85, 581.90], [797.73, 592.13], [820.18, 602.93], [842.23, 614.28], [863.77, 626.32]];
tip_px=[917.7, 655.2];
ridges_px=[  // inner-edge groove stations, outward normal [x, y, nx, ny] px
    [425.26, 340.09, 0.89, -0.45], [427.52, 344.55, 0.89, -0.45], [429.78, 349.01, 0.89, -0.45], [432.04, 353.47, 0.89, -0.45], [434.30, 357.93, 0.89, -0.45], [436.56, 362.39, 0.89, -0.45],
    [439.41, 366.40, 0.67, -0.74], [443.10, 369.77, 0.67, -0.74], [446.79, 373.14, 0.74, -0.67], [450.64, 382.10, 0.78, -0.62], [453.96, 385.83, 0.75, -0.66], [457.29, 389.57, 0.75, -0.66],
    [460.61, 393.30, 0.75, -0.66], [463.94, 397.03, 0.75, -0.66], [467.34, 400.68, 0.62, -0.78], [471.59, 403.32, 0.53, -0.85], [475.83, 405.96, 0.53, -0.85], [480.08, 408.60, 0.53, -0.85],
    [484.33, 411.23, 0.53, -0.85], [488.58, 413.87, 0.53, -0.85], [492.82, 416.51, 0.53, -0.85], [497.07, 419.15, 0.53, -0.85], [501.32, 421.78, 0.53, -0.85], [505.57, 424.42, 0.53, -0.85],
    [509.81, 427.06, 0.53, -0.85], [514.06, 429.70, 0.53, -0.85], [517.92, 432.83, 0.71, -0.70], [521.44, 436.38, 0.71, -0.70], [525.28, 439.44, 0.42, -0.91], [529.95, 441.23, 0.36, -0.93],
    [534.61, 443.03, 0.36, -0.93], [539.28, 444.82, 0.36, -0.93], [543.95, 446.61, 0.36, -0.93], [548.62, 448.40, 0.36, -0.93], [553.30, 450.14, 0.26, -0.96], [558.21, 451.10, 0.19, -0.98],
    [563.12, 452.05, 0.19, -0.98], [568.02, 453.01, 0.19, -0.98], [572.93, 453.96, 0.19, -0.98], [577.84, 454.92, 0.19, -0.98], [582.80, 455.44, 0.04, -1.00], [587.79, 455.62, 0.04, -1.00],
    [592.79, 455.80, 0.04, -1.00], [597.79, 455.98, 0.04, -1.00], [602.78, 456.16, 0.04, -1.00], [607.78, 456.34, 0.04, -1.00], [612.74, 456.24, -0.21, -0.98], [617.48, 454.66, -0.26, -0.96],
    [627.15, 456.21, 0.24, -0.97], [632.00, 457.43, 0.24, -0.97], [637.77, 464.37, 0.99, -0.15], [638.50, 469.32, 0.99, -0.15], [639.22, 474.26, 0.99, -0.15], [640.04, 479.17, 0.92, -0.40],
    [642.94, 483.25, 0.82, -0.58], [643.95, 491.91, 0.73, -0.68], [648.01, 494.70, 0.46, -0.89], [652.44, 497.01, 0.37, -0.93], [657.29, 498.14, 0.19, -0.98], [662.20, 499.11, 0.19, -0.98],
    [667.10, 500.07, 0.19, -0.98], [672.05, 500.17, -0.09, -1.00], [676.43, 498.45, -0.71, -0.70], [685.24, 496.95, 0.18, -0.98], [692.06, 502.99, 0.87, -0.50], [694.93, 506.97, 0.62, -0.78],
    [699.16, 509.63, 0.53, -0.85], [703.39, 512.29, 0.53, -0.85], [707.62, 514.95, 0.53, -0.85], [711.86, 517.61, 0.53, -0.85], [712.84, 526.28, 1.00, -0.09], [715.38, 530.34, 0.81, -0.59],
    [717.87, 534.66, 0.88, -0.47], [720.20, 539.09, 0.88, -0.47], [722.53, 543.51, 0.88, -0.47], [724.87, 547.93, 0.88, -0.47], [727.94, 551.40, 0.33, -0.94], [732.80, 552.55, 0.24, -0.97],
    [737.65, 553.79, 0.26, -0.97], [742.47, 555.10, 0.27, -0.96], [747.27, 556.50, 0.29, -0.96], [752.04, 557.98, 0.30, -0.95], [756.80, 559.54, 0.32, -0.95], [761.52, 561.18, 0.33, -0.94],
    [766.22, 562.89, 0.35, -0.94], [770.89, 564.68, 0.36, -0.93], [775.53, 566.54, 0.38, -0.93], [780.14, 568.47, 0.39, -0.92], [784.72, 570.47, 0.41, -0.91], [789.28, 572.54, 0.42, -0.91],
    [793.80, 574.67, 0.43, -0.90], [798.29, 576.86, 0.44, -0.90], [802.76, 579.11, 0.46, -0.89], [807.19, 581.42, 0.47, -0.88], [811.60, 583.79, 0.48, -0.88], [815.97, 586.20, 0.49, -0.87],
    [820.32, 588.67, 0.50, -0.87], [824.65, 591.18, 0.51, -0.86], [828.95, 593.73, 0.52, -0.86], [833.22, 596.33, 0.52, -0.85], [837.46, 598.97, 0.53, -0.85], [841.69, 601.65, 0.54, -0.84],
    [845.89, 604.36, 0.55, -0.84], [850.06, 607.11, 0.55, -0.83], [854.21, 609.91, 0.56, -0.83], [858.32, 612.75, 0.57, -0.82], [862.40, 615.64, 0.58, -0.81], [866.45, 618.57, 0.59, -0.81],
    [870.49, 621.52, 0.59, -0.81], [874.51, 624.49, 0.59, -0.80], [878.53, 627.46, 0.59, -0.80], [882.55, 630.43, 0.59, -0.80], [886.58, 633.40, 0.59, -0.80], [890.60, 636.36, 0.59, -0.81],
    [894.64, 639.32, 0.59, -0.81], [898.70, 642.24, 0.58, -0.81]];
