JacobSchantz/HelpingHands/Two Finger Gripper/versions/v016_generalist_rounded_point/trace_px.scad

// GENERATED by trace_photo.py from cad/reference/generalist_gripper_gen6_two_hands.png. Do not edit;
// change the hand patches in trace_photo.py and re-run.
outline_px=[
    [415.26, 334.46], [417.89, 334.48], [419.57, 334.91], [421.09, 335.70], [422.97, 337.53], [423.96, 339.08],
    [426.67, 344.23], [430.80, 350.96], [435.26, 359.87], [437.83, 364.10], [439.69, 366.38], [443.88, 370.57],
    [445.81, 372.75], [447.37, 375.14], [449.99, 380.24], [451.65, 382.61], [459.99, 392.40], [467.39, 400.46],
    [471.93, 404.29], [474.37, 405.89], [480.20, 409.21], [487.29, 414.43], [514.63, 430.64], [516.99, 432.39],
    [522.20, 436.89], [524.59, 438.58], [528.93, 440.87], [535.29, 443.68], [552.26, 449.49], [556.09, 450.50],
    [566.83, 452.76], [577.63, 454.75], [582.56, 455.39], [592.48, 456.32], [605.46, 456.48], [606.04, 455.11],
    [613.62, 453.61], [619.19, 453.25], [622.53, 453.50], [624.72, 453.89], [627.97, 454.88], [630.06, 455.83],
    [632.05, 457.00], [633.89, 458.37], [637.11, 461.57], [639.76, 465.17], [645.29, 474.32], [648.41, 478.34],
    [654.36, 483.79], [660.79, 488.65], [664.28, 490.67], [666.16, 491.43], [669.11, 492.24], [673.20, 492.83],
    [681.53, 493.44], [686.72, 494.46], [689.76, 495.62], [691.71, 496.65], [695.32, 499.33], [697.69, 501.79],
    [700.37, 505.44], [706.19, 515.73], [711.79, 524.14], [718.51, 535.41], [721.81, 540.48], [724.25, 543.68],
    [726.94, 546.64], [729.82, 549.37], [732.14, 551.20], [734.65, 552.77], [736.49, 553.60], [745.23, 555.89],
    [754.32, 558.71], [763.24, 561.79], [772.01, 565.12], [780.63, 568.69], [789.11, 572.49], [797.44, 576.51],
    [805.62, 580.79], [813.57, 585.40], [825.03, 593.02], [873.46, 628.60], [888.69, 639.35], [896.64, 644.32],
    [900.79, 646.58], [905.08, 648.66], [913.80, 652.31], [917.70, 655.20], [913.20, 657.18], [910.92, 657.86],
    [907.45, 658.56], [901.56, 658.97], [895.56, 658.67], [875.77, 655.90], [855.86, 654.31], [841.41, 652.43],
    [836.73, 651.58], [827.59, 649.51], [818.76, 646.94], [814.45, 645.47], [801.89, 640.43], [781.34, 631.04],
    [769.13, 624.94], [757.21, 618.21], [745.65, 610.75], [734.47, 602.54], [723.66, 593.57], [716.68, 587.15],
    [713.30, 583.80], [711.26, 583.39], [708.36, 582.46], [705.60, 581.21], [702.97, 579.70], [683.01, 565.51],
    [677.45, 561.02], [673.14, 556.66], [670.04, 552.64], [667.38, 548.32], [661.43, 537.54], [657.92, 532.56],
    [655.87, 530.34], [653.60, 528.33], [651.13, 526.51], [647.62, 524.36], [643.90, 522.48], [640.08, 520.84],
    [628.66, 516.81], [595.86, 502.17], [568.28, 490.59], [551.98, 483.18], [534.03, 474.36], [511.10, 464.52],
    [474.85, 445.58], [470.34, 443.44], [460.28, 439.07], [436.36, 426.78], [431.79, 424.79], [418.73, 419.87],
    [411.44, 416.67], [403.45, 412.67], [392.30, 408.30], [375.32, 399.15], [362.47, 392.96], [359.55, 391.81],
    [357.57, 391.30], [354.56, 391.26], [352.56, 391.84], [350.74, 392.87], [349.26, 394.29], [348.21, 396.03],
    [347.56, 397.99], [347.23, 400.06], [347.18, 402.15], [347.38, 404.20], [348.23, 407.12], [350.58, 411.64],
    [351.10, 413.62], [351.01, 415.73], [350.71, 416.74], [349.60, 418.44], [348.80, 419.09], [346.88, 419.93],
    [344.78, 420.20], [342.75, 419.94], [340.81, 419.26], [338.98, 418.29], [334.83, 415.30], [331.92, 412.47],
    [329.34, 409.31], [327.18, 405.85], [325.54, 402.14], [324.57, 398.18], [324.37, 395.06], [324.84, 392.00],
    [325.70, 390.19], [326.32, 389.39], [338.75, 379.37], [342.41, 375.99], [348.04, 370.36], [351.13, 367.99],
    [352.83, 367.08], [354.64, 366.41], [405.11, 339.33], [406.62, 338.11], [409.10, 336.58], [412.60, 335.08]];
holes_px=[  // [x, y, major, minor, angle] in photo px / image degrees
    [375.77, 380.68, 15.96, 13.75, 58.93], [388.50, 361.50, 10.00, 10.00, 0.00], [391.18, 395.76, 10.00, 10.00, 0.00], [399.09, 380.20, 15.94, 14.42, 58.70], [408.85, 360.52, 17.38, 14.63, 46.80], [412.45, 399.68, 17.02, 13.79, 61.95],
    [422.25, 379.61, 16.16, 13.80, 58.12], [435.72, 398.49, 16.43, 13.96, 65.85], [447.74, 416.54, 15.67, 13.88, 96.35], [467.57, 415.86, 13.80, 9.23, 53.39], [480.41, 431.62, 14.71, 12.45, 105.67], [495.79, 441.36, 13.33, 6.83, 125.05],
    [511.66, 448.40, 13.45, 11.29, -140.67], [527.69, 457.09, 12.91, 7.49, 124.02], [544.31, 463.11, 12.98, 12.09, 88.99], [563.85, 465.15, 9.17, 7.57, 161.81], [576.39, 478.41, 13.52, 11.47, 136.75], [597.01, 475.72, 12.55, 11.16, 103.87],
    [608.19, 492.52, 11.54, 11.34, -145.84], [617.20, 474.26, 12.37, 9.34, 97.80], [626.42, 493.27, 10.00, 10.00, 0.00], [639.32, 507.40, 10.27, 7.67, -166.34], [657.00, 511.00, 8.00, 8.00, 0.00], [670.32, 522.44, 9.41, 7.83, 150.28],
    [690.20, 522.48, 10.82, 8.50, 102.26], [700.61, 537.74, 6.85, 5.90, 121.17]];
dot_px=[724.2, 561.9, 17.0];
slots_px=[
    [751.21, 572.71], [774.61, 582.23], [797.49, 592.46], [819.31, 604.11], [840.37, 616.80], [861.52, 629.36]];
tip_px=[917.7, 655.2];
ridges_px=[  // inner-edge groove stations, outward normal [x, y, nx, ny] px
    [425.43, 341.88, 0.89, -0.47], [427.89, 346.22, 0.85, -0.52], [430.51, 350.49, 0.87, -0.50], [432.79, 354.93, 0.89, -0.45], [435.02, 359.41, 0.88, -0.47], [437.58, 363.70, 0.83, -0.56],
    [440.81, 367.50, 0.71, -0.70], [444.32, 371.06, 0.74, -0.68], [447.31, 375.05, 0.86, -0.51], [449.61, 379.50, 0.87, -0.49], [452.47, 383.58, 0.77, -0.64], [455.72, 387.38, 0.76, -0.65],
    [458.96, 391.19, 0.76, -0.65], [462.29, 394.91, 0.74, -0.68], [465.68, 398.59, 0.74, -0.68], [469.27, 402.05, 0.64, -0.76], [473.21, 405.13, 0.55, -0.83], [477.50, 407.68, 0.49, -0.87],
    [481.73, 410.34, 0.59, -0.81], [485.76, 413.30, 0.59, -0.81], [489.95, 416.01, 0.51, -0.86], [494.25, 418.56, 0.51, -0.86], [498.56, 421.11, 0.51, -0.86], [502.86, 423.66, 0.51, -0.86],
    [507.16, 426.21, 0.51, -0.86], [511.46, 428.76, 0.51, -0.86], [515.68, 431.42, 0.59, -0.81], [519.54, 434.59, 0.65, -0.76], [523.41, 437.75, 0.57, -0.82], [527.74, 440.24, 0.46, -0.89],
    [532.27, 442.35, 0.40, -0.91], [536.90, 444.23, 0.33, -0.94], [541.63, 445.85, 0.32, -0.95], [546.36, 447.47, 0.32, -0.95], [551.09, 449.09, 0.31, -0.95], [555.90, 450.45, 0.23, -0.97],
    [560.79, 451.49, 0.21, -0.98], [565.68, 452.52, 0.20, -0.98], [570.59, 453.45, 0.18, -0.98], [575.51, 454.36, 0.18, -0.98], [580.45, 455.12, 0.13, -0.99], [585.42, 455.66, 0.09, -1.00],
    [590.40, 456.13, 0.09, -1.00], [595.39, 456.36, 0.01, -1.00], [600.39, 456.42, 0.01, -1.00], [605.39, 456.48, -0.42, -0.91], [609.41, 454.44, -0.19, -0.98], [614.33, 453.57, -0.11, -0.99],
    [619.32, 453.26, 0.01, -1.00], [624.28, 453.81, 0.22, -0.98], [629.02, 455.36, 0.41, -0.91], [633.29, 457.92, 0.62, -0.78], [636.91, 461.37, 0.75, -0.66], [639.89, 465.38, 0.83, -0.55],
    [642.47, 469.66, 0.86, -0.52], [645.06, 473.94, 0.83, -0.56], [648.08, 477.92, 0.75, -0.66], [651.70, 481.36, 0.68, -0.74], [655.47, 484.63, 0.61, -0.79], [659.46, 487.65, 0.59, -0.80],
    [663.68, 490.33, 0.46, -0.89], [668.36, 492.03, 0.23, -0.97], [673.28, 492.84, 0.11, -0.99], [678.27, 493.20, 0.07, -1.00], [683.23, 493.78, 0.19, -0.98], [688.07, 494.98, 0.34, -0.94],
    [692.50, 497.24, 0.56, -0.83], [696.35, 500.41, 0.71, -0.71], [699.51, 504.27, 0.82, -0.58], [702.11, 508.53, 0.87, -0.49], [704.57, 512.88, 0.87, -0.49], [707.14, 517.17, 0.83, -0.55],
    [709.92, 521.33, 0.83, -0.55], [712.62, 525.53, 0.86, -0.52], [715.18, 529.83, 0.86, -0.51], [717.74, 534.12, 0.86, -0.52], [720.42, 538.34, 0.84, -0.55], [723.30, 542.43, 0.79, -0.61],
    [726.55, 546.22, 0.72, -0.69], [730.18, 549.65, 0.65, -0.76], [734.26, 552.52, 0.49, -0.87], [738.93, 554.24, 0.25, -0.97], [743.77, 555.51, 0.26, -0.97], [748.56, 556.92, 0.30, -0.96],
    [753.34, 558.41, 0.30, -0.95], [758.07, 560.01, 0.33, -0.95], [762.80, 561.64, 0.34, -0.94], [767.48, 563.40, 0.35, -0.93], [772.15, 565.18, 0.37, -0.93], [776.77, 567.09, 0.38, -0.92],
    [781.38, 569.03, 0.40, -0.92], [785.95, 571.07, 0.41, -0.91], [790.49, 573.15, 0.43, -0.90], [794.99, 575.33, 0.44, -0.90], [799.46, 577.57, 0.46, -0.89], [803.89, 579.89, 0.46, -0.89],
    [808.26, 582.32, 0.50, -0.87], [812.59, 584.83, 0.51, -0.86], [816.79, 587.54, 0.55, -0.83], [820.95, 590.30, 0.55, -0.83], [825.11, 593.08, 0.57, -0.82], [829.14, 596.04, 0.59, -0.81],
    [833.17, 599.00, 0.59, -0.81], [837.20, 601.96, 0.59, -0.81], [841.23, 604.92, 0.59, -0.81], [845.26, 607.88, 0.59, -0.81], [849.29, 610.84, 0.59, -0.81], [853.32, 613.80, 0.59, -0.81],
    [857.35, 616.76, 0.59, -0.81], [861.38, 619.72, 0.59, -0.81], [865.41, 622.68, 0.59, -0.81], [869.43, 625.64, 0.59, -0.81], [873.46, 628.60, 0.58, -0.81], [877.55, 631.48, 0.58, -0.82],
    [881.63, 634.37, 0.58, -0.82], [885.72, 637.25, 0.58, -0.82], [889.85, 640.07, 0.54, -0.84], [894.09, 642.72, 0.53, -0.85], [898.39, 645.27, 0.48, -0.88]];
