JacobSchantz/HelpingHands/Two Finger Gripper/versions/v011b_generalist_fingers_astra/rounds/r1_full_width_grooves/trace_px.scad

// GENERATED by trace_photo.py from cad/reference/generalist_gripper_gen6_two_hands.png. Do not edit;
// change the hand patches in trace_photo.py and re-run.
outline_px=[
    [415.0, 333.8], [423.0, 335.6], [437.9, 365.0], [447.7, 374.0], [449.7, 381.0], [467.0, 400.5],
    [516.0, 430.9], [524.0, 439.0], [553.0, 450.1], [580.0, 455.3], [612.0, 456.5], [619.0, 454.2],
    [634.3, 458.0], [637.3, 461.0], [639.9, 479.0], [644.2, 485.0], [642.3, 490.0], [645.0, 493.1],
    [653.0, 497.3], [669.0, 500.4], [675.0, 499.9], [679.0, 495.8], [689.0, 497.6], [694.0, 506.4],
    [714.1, 519.0], [712.7, 527.0], [716.0, 531.1], [733.2, 537.0], [738.6, 538.8], [743.8, 540.7],
    [749.1, 542.8], [754.3, 545.0], [759.4, 547.3], [764.5, 549.8], [769.6, 552.4], [774.6, 555.1],
    [779.6, 557.9], [784.5, 560.8], [789.4, 563.8], [794.3, 566.9], [799.1, 570.2], [803.9, 573.5],
    [808.6, 576.9], [813.3, 580.5], [818.0, 584.0], [822.7, 587.7], [827.3, 591.4], [832.0, 595.1],
    [836.6, 598.9], [841.3, 602.6], [846.0, 606.0], [840.2, 605.4], [834.3, 605.4], [828.2, 605.6],
    [822.1, 605.9], [816.0, 606.2], [809.9, 606.6], [803.8, 606.9], [797.7, 607.0], [791.7, 607.1],
    [785.7, 607.0], [779.8, 606.7], [774.0, 606.3], [768.3, 605.6], [762.6, 604.8], [757.0, 603.7],
    [751.5, 602.3], [746.1, 600.7], [740.8, 598.8], [735.6, 596.7], [730.5, 594.2], [725.5, 591.4],
    [720.6, 588.3], [715.9, 584.9], [690.0, 571.1], [676.0, 569.5], [668.0, 565.0], [664.0, 558.0],
    [665.5, 552.0], [663.3, 535.0], [651.0, 526.0], [510.0, 464.2], [436.0, 426.3], [394.0, 409.2],
    [359.0, 390.0], [353.6, 391.0], [347.9, 400.0], [348.1, 404.0], [352.9, 410.0], [352.0, 415.0],
    [349.0, 417.3], [345.0, 416.5], [327.0, 400.2], [323.7, 395.0], [325.0, 390.6], [354.0, 365.9],
    [405.0, 338.7]];
holes_px=[  // [x, y, major, minor, angle] in photo px / image degrees
    [375.8, 380.7, 16.0, 13.7, 58.9], [387.0, 360.0, 10.0, 10.0, 0.0], [391.2, 395.8, 10.0, 10.0, 0.0], [399.1, 380.2, 15.9, 14.4, 58.7], [408.8, 360.5, 17.4, 14.6, 46.8], [412.4, 399.7, 17.0, 13.8, 61.9],
    [422.2, 379.6, 16.2, 13.8, 58.1], [435.7, 398.5, 16.4, 14.0, 65.9], [447.7, 416.5, 15.7, 13.9, 96.4], [467.6, 415.9, 13.8, 9.2, 53.4], [480.4, 431.6, 14.7, 12.5, 105.7], [495.8, 441.4, 13.3, 6.8, 125.1],
    [511.7, 448.4, 13.5, 11.3, -140.7], [527.7, 457.1, 12.9, 7.5, 124.0], [544.3, 463.1, 13.0, 12.1, 89.0], [563.8, 465.2, 9.2, 7.6, 161.8], [576.4, 478.4, 13.5, 11.5, 136.7], [597.0, 475.7, 12.5, 11.2, 103.9],
    [608.2, 492.5, 11.5, 11.3, -145.8], [617.2, 474.3, 12.4, 9.3, 97.8], [626.4, 493.3, 10.0, 10.0, 0.0], [639.3, 507.4, 10.3, 7.7, -166.3], [657.0, 511.0, 8.0, 8.0, 0.0], [670.3, 522.4, 9.4, 7.8, 150.3],
    [690.2, 522.5, 10.8, 8.5, 102.3], [700.6, 537.7, 6.9, 5.9, 121.2]];
dot_px=[724.2, 561.9, 17.0];
slots_px=[
    [747.9, 557.7], [761.0, 564.2], [774.1, 570.7], [787.2, 577.2], [800.3, 583.7], [813.4, 590.2]];
tip_px=[846.0, 606.0];
ridges_px=[  // inner-edge groove stations, outward normal [x, y, nx, ny] px
    [441.6, 368.4, 0.7, -0.7], [445.3, 371.7, 0.7, -0.7], [448.2, 375.6, 0.9, -0.4], [449.5, 380.4, 0.9, -0.4], [452.6, 384.3, 0.7, -0.7], [455.9, 388.0, 0.7, -0.7],
    [459.2, 391.8, 0.7, -0.7], [462.6, 395.5, 0.7, -0.7], [465.9, 399.2, 0.7, -0.7], [469.8, 402.2, 0.5, -0.8], [474.1, 404.9, 0.5, -0.8], [478.3, 407.5, 0.5, -0.8],
    [482.6, 410.1, 0.5, -0.8], [486.8, 412.8, 0.5, -0.8], [491.1, 415.4, 0.5, -0.8], [495.3, 418.1, 0.5, -0.8], [499.6, 420.7, 0.5, -0.8], [503.8, 423.3, 0.5, -0.8],
    [508.1, 426.0, 0.5, -0.8], [512.3, 428.6, 0.5, -0.8], [516.5, 431.4, 0.6, -0.8], [520.0, 434.9, 0.7, -0.7], [523.5, 438.5, 0.6, -0.8], [528.0, 440.5, 0.4, -0.9],
    [532.7, 442.3, 0.4, -0.9], [537.3, 444.1, 0.4, -0.9], [542.0, 445.9, 0.4, -0.9], [546.7, 447.7, 0.4, -0.9], [551.4, 449.5, 0.3, -0.9], [556.2, 450.7, 0.2, -1.0],
    [561.1, 451.7, 0.2, -1.0], [566.0, 452.6, 0.2, -1.0], [570.9, 453.6, 0.2, -1.0], [575.8, 454.5, 0.2, -1.0], [580.7, 455.4, 0.1, -1.0], [585.7, 455.5, 0.0, -1.0],
    [590.7, 455.7, 0.0, -1.0], [595.7, 455.9, 0.0, -1.0], [600.7, 456.1, 0.0, -1.0], [605.7, 456.3, 0.0, -1.0], [610.7, 456.4, -0.0, -1.0], [615.5, 455.3, -0.3, -0.9],
    [620.3, 454.5, 0.1, -1.0], [625.1, 455.7, 0.2, -1.0], [630.0, 456.9, 0.2, -1.0], [638.2, 467.3, 1.0, -0.1], [638.9, 472.2, 1.0, -0.1], [639.7, 477.2, 1.0, -0.2],
    [641.7, 481.6, 0.8, -0.6], [643.9, 485.7, 1.0, 0.0], [650.6, 496.0, 0.5, -0.9], [655.3, 497.7, 0.2, -1.0], [660.2, 498.7, 0.2, -1.0], [665.1, 499.7, 0.2, -1.0],
    [670.0, 500.4, -0.0, -1.0], [675.0, 499.9, -0.4, -0.9], [678.5, 496.4, -0.4, -0.9], [691.0, 501.2, 0.9, -0.5], [693.5, 505.5, 0.8, -0.6], [697.4, 508.5, 0.5, -0.8],
    [701.6, 511.2, 0.5, -0.8], [705.9, 513.8, 0.5, -0.8], [713.2, 524.2, 1.0, 0.2], [717.8, 531.7, 0.4, -0.9], [722.6, 533.4, 0.3, -0.9], [727.3, 535.0, 0.3, -0.9],
    [732.0, 536.6, 0.3, -0.9], [736.8, 538.2, 0.3, -0.9], [741.5, 539.9, 0.3, -0.9], [746.1, 541.6, 0.4, -0.9], [750.8, 543.5, 0.4, -0.9], [755.4, 545.5, 0.4, -0.9],
    [759.9, 547.6, 0.4, -0.9], [764.4, 549.7, 0.4, -0.9], [768.9, 552.0, 0.5, -0.9], [773.3, 554.4, 0.5, -0.9], [777.7, 556.8, 0.5, -0.9], [782.0, 559.3, 0.5, -0.9],
    [786.3, 561.9, 0.5, -0.9], [790.5, 564.5, 0.5, -0.8], [794.7, 567.3, 0.6, -0.8], [798.9, 570.0, 0.6, -0.8], [803.0, 572.9, 0.6, -0.8], [807.0, 575.8, 0.6, -0.8],
    [811.1, 578.8, 0.6, -0.8], [815.1, 581.8, 0.6, -0.8], [819.0, 584.8, 0.6, -0.8], [823.0, 587.9, 0.6, -0.8], [826.9, 591.0, 0.6, -0.8], [830.8, 594.2, 0.6, -0.8]];
