JacobSchantz/HelpingHands/ORCA CC-BY Prototype/inspect_index.scad

// ORCA Hand by ORCA Dexterity, Inc. — CC BY 4.0. See upstream/LICENSE.
// Original single index component; NOT an assembled finger.
// Select component using the OpenSCAD Customizer. No geometry modifications.
part = "I-PP"; // [I-PP, I-IP, I-AP-L, I-AP-R]
import(str("upstream/orca_v2/base/01_Fingers/", part, ".stl"));
