JacobSchantz/HelpingHands/cad/openscad/glove_hand/print/gen_05/README.md

# Incomplete experiment — do not print

Preserved after Jake changed direction to an actual Aero finger reference/scaling study. These provisional meshes are not print-ready and are stale relative to the final experimental source. See [the experiment note](../../compare/gen_05.md). No completed validation or physical testing is claimed.
