JacobSchantz/HelpingHands/cad/build123d/FIDELITY.md

# Fidelity — parametric model vs. reference STEP

Generated by `fidelity_check.py`. Everything is measured against
the committed reference B-rep, in the same kernel, so these are
real geometric differences and not renderings compared by eye.

## Moving jaw

| | reference | model | Δ |
|---|---|---|---|
| volume | 20691 mm³ | 20197 mm³ | -2.4% |
| X extent | -12.30 … 10.00 | -12.30 … 10.15 | -0.00 / +0.15 |
| Y extent | -82.00 … 10.00 | -81.80 … 10.00 | +0.20 / +0.00 |
| Z extent | -24.00 … 24.00 | -24.00 … 24.00 | +0.00 / -0.00 |

### Cross-sections along Y

| y | ref area | model area | Δ area | Δ extent |
|---|---|---|---|---|
| -5 | 112 | 99 | -11.6% | 0.01 mm |
| -12 | 229 | 182 | -20.5% | 0.27 mm |
| -18 | 762 | 762 | -0.1% | 0.05 mm |
| -20 | 732 | 731 | -0.1% | 0.09 mm |
| -24 | 338 | 352 | +3.9% | 0.00 mm |
| -30 | 295 | 298 | +1.0% | 0.00 mm |
| -36 | 260 | 263 | +1.1% | 0.00 mm |
| -44 | 211 | 223 | +5.7% | 0.00 mm |
| -56 | 184 | 185 | +0.4% | 0.01 mm |
| -64 | 158 | 161 | +2.2% | 0.01 mm |
| -70 | 104 | 104 | -0.7% | 0.02 mm |
| -76 | 74 | 75 | +1.0% | 0.05 mm |
| -80 | 34 | 35 | +3.5% | 0.02 mm |

Worst silhouette error at any station: **0.27 mm**.

### Holes

- reference has 41 bores, the model has 47
- **24 matched** (same Ø, same axis, within 1.5 mm)
- worst matched-hole position error: 1.23 mm (Ø1.5)
- **17 in the reference with no counterpart**: Ø5.4 at (3.9, 2.6, 22.5), Ø5.4 at (-3.7, 3.5, 22.5), Ø5.4 at (-3.7, 3.5, -23.2), Ø5.4 at (3.9, 2.6, -23.2), Ø6.0 at (-0.2, 2.6, 18.8), Ø6.0 at (-0.2, -2.6, 18.8), Ø6.0 at (-0.2, -2.6, -20.1), Ø6.0 at (-0.2, 2.6, -20.1), Ø1.5 at (-7.8, -67.0, 0.0), Ø20.0 at (-1.2, -8.7, 16.8) …
- 23 in the model with no counterpart (fillet faces and split bores land here)

## Wrist-roll follower

| | reference | model | Δ |
|---|---|---|---|
| volume | 56620 mm³ | 58285 mm³ | +2.9% |
| X extent | -35.20 … 30.00 | -35.22 … 30.00 | -0.02 / +0.00 |
| Y extent | -24.22 … 27.78 | -24.22 … 27.78 | -0.00 / -0.00 |
| Z extent | -0.05 … 105.38 | 0.00 … 105.38 | +0.05 / -0.00 |

### Cross-sections along Z

| z | ref area | model area | Δ area | Δ extent |
|---|---|---|---|---|
| 3 | 421 | 397 | -5.7% | 9.45 mm |
| 8 | 2678 | 2552 | -4.7% | 0.16 mm |
| 13 | 1046 | 1020 | -2.5% | 0.01 mm |
| 18 | 993 | 1018 | +2.5% | 0.17 mm |
| 24 | 698 | 853 | +22.2% | 0.34 mm |
| 30 | 919 | 920 | +0.1% | 0.38 mm |
| 36 | 849 | 838 | -1.3% | 1.82 mm |
| 42 | 544 | 549 | +0.9% | 0.00 mm |
| 55 | 343 | 350 | +2.2% | 0.00 mm |
| 65 | 239 | 247 | +3.1% | 0.00 mm |
| 75 | 187 | 195 | +4.0% | 0.00 mm |
| 85 | 116 | 124 | +6.5% | 0.00 mm |
| 95 | 72 | 79 | +10.3% | 0.00 mm |
| 103 | 36 | 38 | +4.9% | 0.01 mm |

Worst silhouette error at any station: **9.45 mm**.

### Holes

- reference has 38 bores, the model has 30
- **24 matched** (same Ø, same axis, within 1.5 mm)
- worst matched-hole position error: 0.54 mm (Ø4.0)
- **14 in the reference with no counterpart**: Ø1.5 at (-25.1, 0.0, 39.1), Ø1.5 at (-24.4, 0.0, 45.4), Ø1.5 at (-21.8, 0.0, 55.1), Ø1.5 at (-20.1, 0.0, 65.1), Ø1.5 at (-17.5, 0.0, 74.8), Ø1.5 at (-15.8, 0.0, 84.9), Ø1.5 at (-13.6, 0.0, 94.8), Ø1.5 at (-12.4, -0.0, 90.4), Ø10.0 at (-25.1, 0.1, 24.3), Ø20.0 at (1.3, -8.9, 0.4) …
- 6 in the model with no counterpart (fillet faces and split bores land here)
