JacobSchantz/HelpingHands/open_claw_setup.txt

# SSH into Raspberry Pi

## Find the Pi on your network
# 1. Check ARP table for Raspberry Pi MAC prefix (dc:a6:32)
arp -a | grep -v incomplete

# 2. Ping potential Pi IPs found above
ping -c 3 <ip-address>

## Butter
ssh yacsclaw@192.168.0.28

## Olive
ssh olive@192.168.0.205

## Peaches:
ssh peaches@192.168.0.227

## youtiao
ssh olive@192.168.0.188

# peanut
ssh peanut@192.168.0.242

# Install OpenClaw
curl -fsSL https://openclaw.ai/install.sh | bash

# Add npm to PATH (Pi)
export PATH="$HOME/.npm-global/bin:$PATH"

# Add npm to PATH (Mac)
export PATH="/opt/homebrew/bin:$PATH"

# Start gateway
openclaw gateway
     
# Add Telegram bot (example: youtiao bot)
openclaw channels add --channel telegram --account youtiao --token 8383255667:AAF54N1pgyQZ_fUnUmDWearM7c4qP-gXEfg

# Pair with Telegram
openclaw pairing list telegram
openclaw pairing approve telegram <CODE>

useful commands:
free -h
ps aux --sort=-%mem | head -10
