JacobSchantz/HelpingHands/plans/rental_operations.md

# Rental Operations Handbook

Status: WORKING DOC. Shareable with Caleb and anyone helping with turnovers.
Every fact below is either confirmed by Jake or marked unknown. Do not guess
house details; fill a blank only from a confirmed source.

This repo is public. Never write access codes, Wi-Fi or lockbox passwords,
guest or owner names, booking records, or the street address here. Keep those
in the booking platform or a private note on the phone (Plans › Add on this
device stays on that device and is never committed).

## The units

| Unit | Layout | Notes | Source |
|---|---|---|---|
| Unit A | Two bedrooms, one bath | Small kitchen and bathroom, lots of glass | Jake (pebble voice-9b6c3a3b) |
| Unit B | One bedroom, one bath | Small kitchen and bathroom, lots of glass | Jake (pebble voice-9b6c3a3b) |

Unknown: unit names Jake actually uses, whether the units are adjacent, bed
sizes and counts, sofa beds, floor types, and whether each unit has a
dishwasher, washer and dryer.

## Turnover sequence

Start long-running machines first, work from high surfaces to low surfaces,
and finish with floors.

1. Inspect for damage and unusually dirty areas. Photograph damage before touching it. Strip beds, collect towels and start laundry. Start the dishwasher where available.
2. Collect trash, leftover food, dishes and misplaced items in one pass. Carry a cleaning caddy and waste bag to reduce trips.
3. Apply bathroom cleaners that need time to work, following their labels. Complete nearby tasks during the waiting time.
4. Dust bedrooms and living areas from high to low. Make beds after nearby dusting, with clean hands and fresh linens.
5. Clean glass in a dedicated pass. Clean frames first, then panes, then lower edges. Use glass-safe cleaner, clean microfiber cloths and a squeegee for large panes; check from an angle for streaks.
6. Finish the kitchen, then the bathroom. Work through kitchen appliances and counters and finish with the sink. In the bathroom, finish the shower, mirror and sink before the toilet. Keep bathroom and kitchen cloths separate.
7. Restock towels, toilet paper, soap, coffee and bin liners; arrange pillows and other guest supplies.
8. Vacuum, then mop toward the exit.

If the rentals are adjacent, start machines in both, then finish one unit at a
time. With two cleaners, divide by zones: kitchens and bathrooms versus
bedrooms, living areas and glass. Adapt to actual laundry capacity and
checkout deadlines.

## Before you leave: verification

Walk the unit once as a guest would, door to bedroom, and check each item.

- Beds made tight with fresh linens, pillows arranged, no hair on pillowcases.
- No crumbs on counters, table, floor edges or inside the microwave.
- Glass and mirrors streak-free when viewed from an angle.
- Shower, sink and toilet clean, including the toilet base and behind it.
- No odors; trash and recycling empty with fresh liners.
- Towels, toilet paper, soap, coffee and bin liners stocked.
- Dishes clean and put away; dishwasher and fridge empty of guest food.
- Lights, thermostat and windows set the way the next guest should find them.
- Damage or missing items reported to Jake with a photo.

## Surfaces and cleaning methods

Glass: glass-safe cleaner, clean microfiber, squeegee on large panes, frames
before panes. Disinfecting: clean first, then keep the surface wet for the
product label's contact time. See the CDC facility cleaning and disinfection
guidance at cdc.gov/hygiene/about/when-and-how-to-clean-and-disinfect-a-facility.html.
Work high to low so cleaned areas are not re-soiled.

Unknown: countertop material, floor types, shower type (glass door or
curtain), and which cleaning products are kept on site.

## Linens and consumables

Restock list, confirmed: towels, toilet paper, soap, coffee, bin liners.

| Item | Par per unit | Where stored | Reorder when |
|---|---|---|---|
| Bed linen sets | unknown | unknown | unknown |
| Bath towels | unknown | unknown | unknown |
| Toilet paper | unknown | unknown | unknown |
| Hand and body soap | unknown | unknown | unknown |
| Coffee | unknown | unknown | unknown |
| Bin liners | unknown | unknown | unknown |

## Laundry and trash

Unknown: whether laundry is done on site or sent out, machine capacity and
cycle time, where clean linens are staged, trash and recycling bin location,
and pickup days.

## Appliances and manuals

Unknown: appliance makes and models in each unit. When filling this in, add
the model number and a link to the manufacturer's manual, not a copy of it.

## Maintenance

No open maintenance items recorded. Log recurring checks here once confirmed,
for example smoke detector batteries, filter changes and dryer lint.

## Open questions for Jake

Units: What do you call the two units, are they next to each other, and what
beds does each have?

Equipment: Which units have a dishwasher, washer and dryer, and are machines
shared?

Supplies: Where are linens and supplies stored, and how many sets of linens
and towels does each unit keep?

Schedule: What are checkout and check-in times, and when is trash pickup?

Access for Caleb: Caleb can already read this, because the repo is public.
Should he get write access too? If so, what is his GitHub username?
