JacobSchantz/HelpingHands/cad/build123d/render/fixed_jaw_front.png

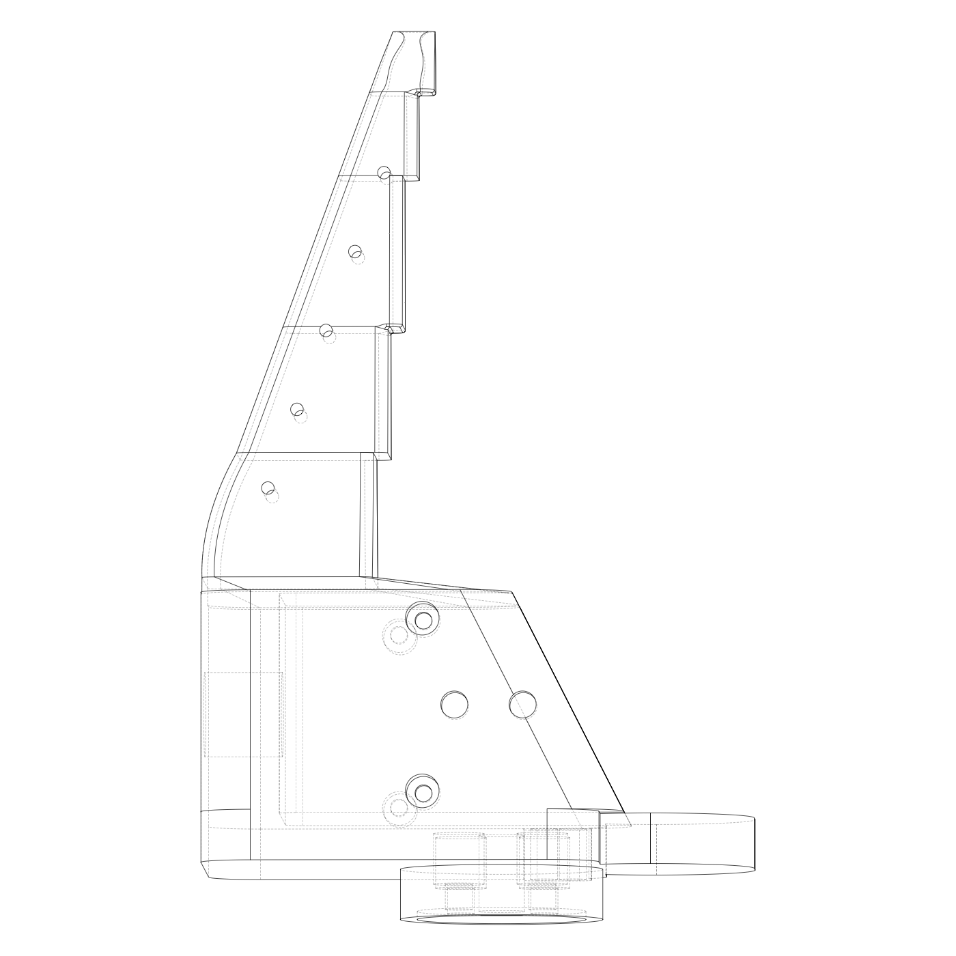
cad/build123d/render/fixed_jaw_front.png
