JacobSchantz/HelpingHands/cad/build123d/render/fixed_jaw_side.png

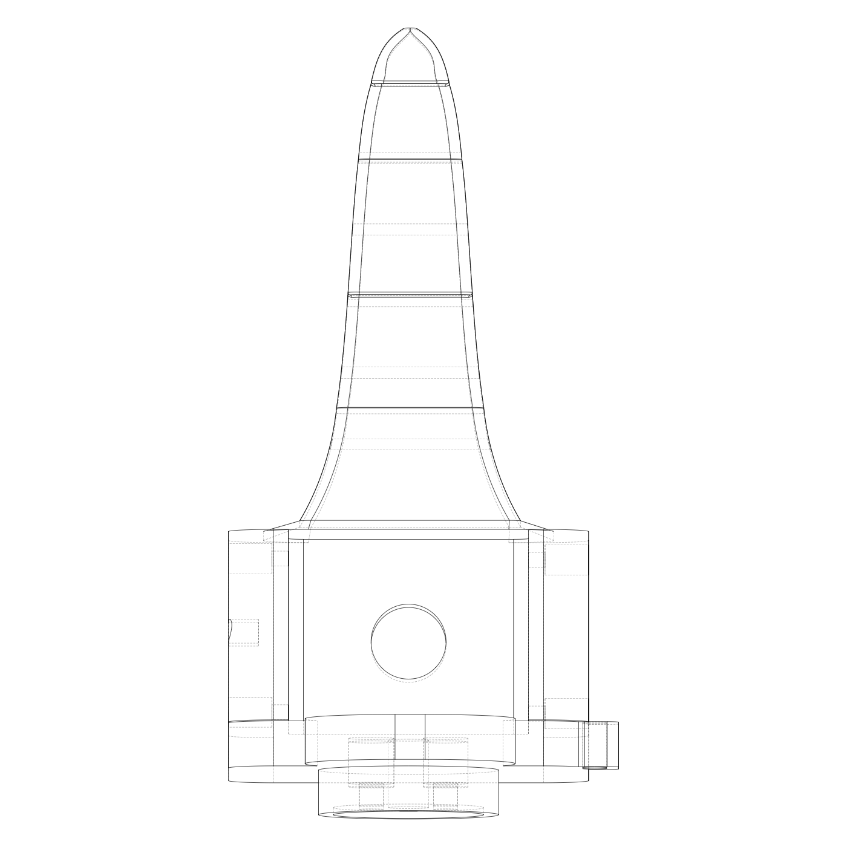
cad/build123d/render/fixed_jaw_side.png
