JacobSchantz/HelpingHands/cad/build123d/render/gripper_closed_iso.png

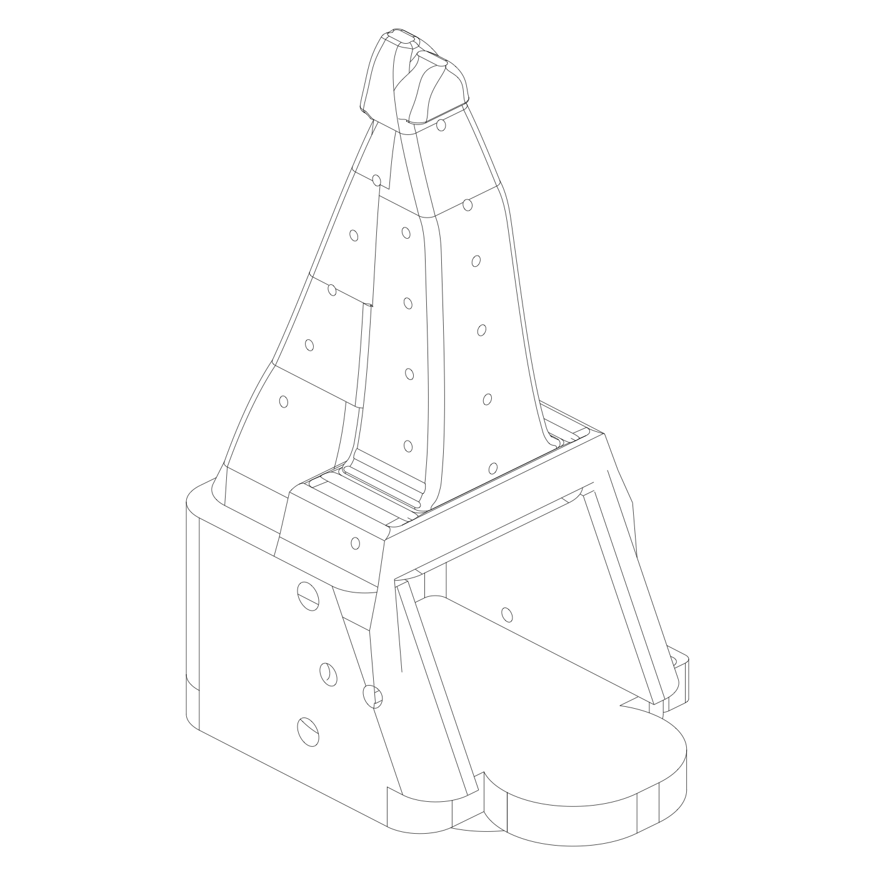
cad/build123d/render/gripper_closed_iso.png
