JacobSchantz/HelpingHands/cad/build123d/render/gripper_closed_side.png

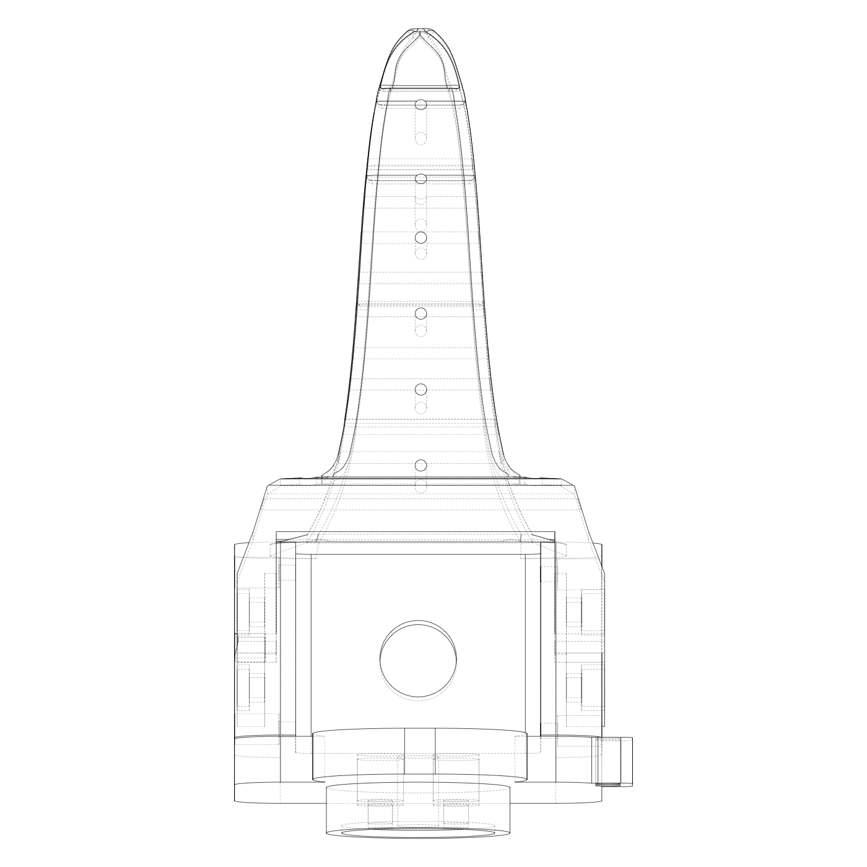
cad/build123d/render/gripper_closed_side.png
