JacobSchantz/HelpingHands/cad/build123d/render/gripper_open_iso.png

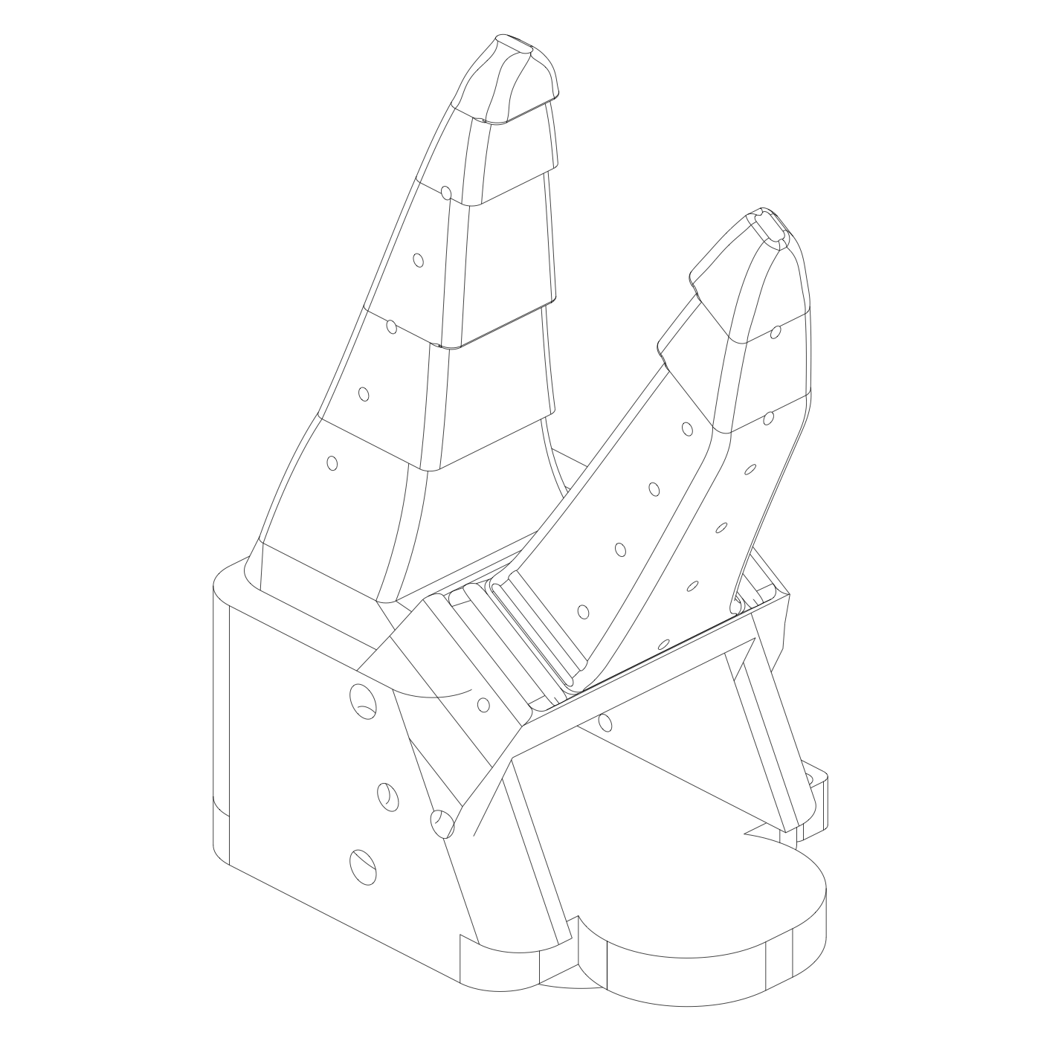
cad/build123d/render/gripper_open_iso.png
