JacobSchantz/HelpingHands/cad/build123d/render/moving_jaw_front.png

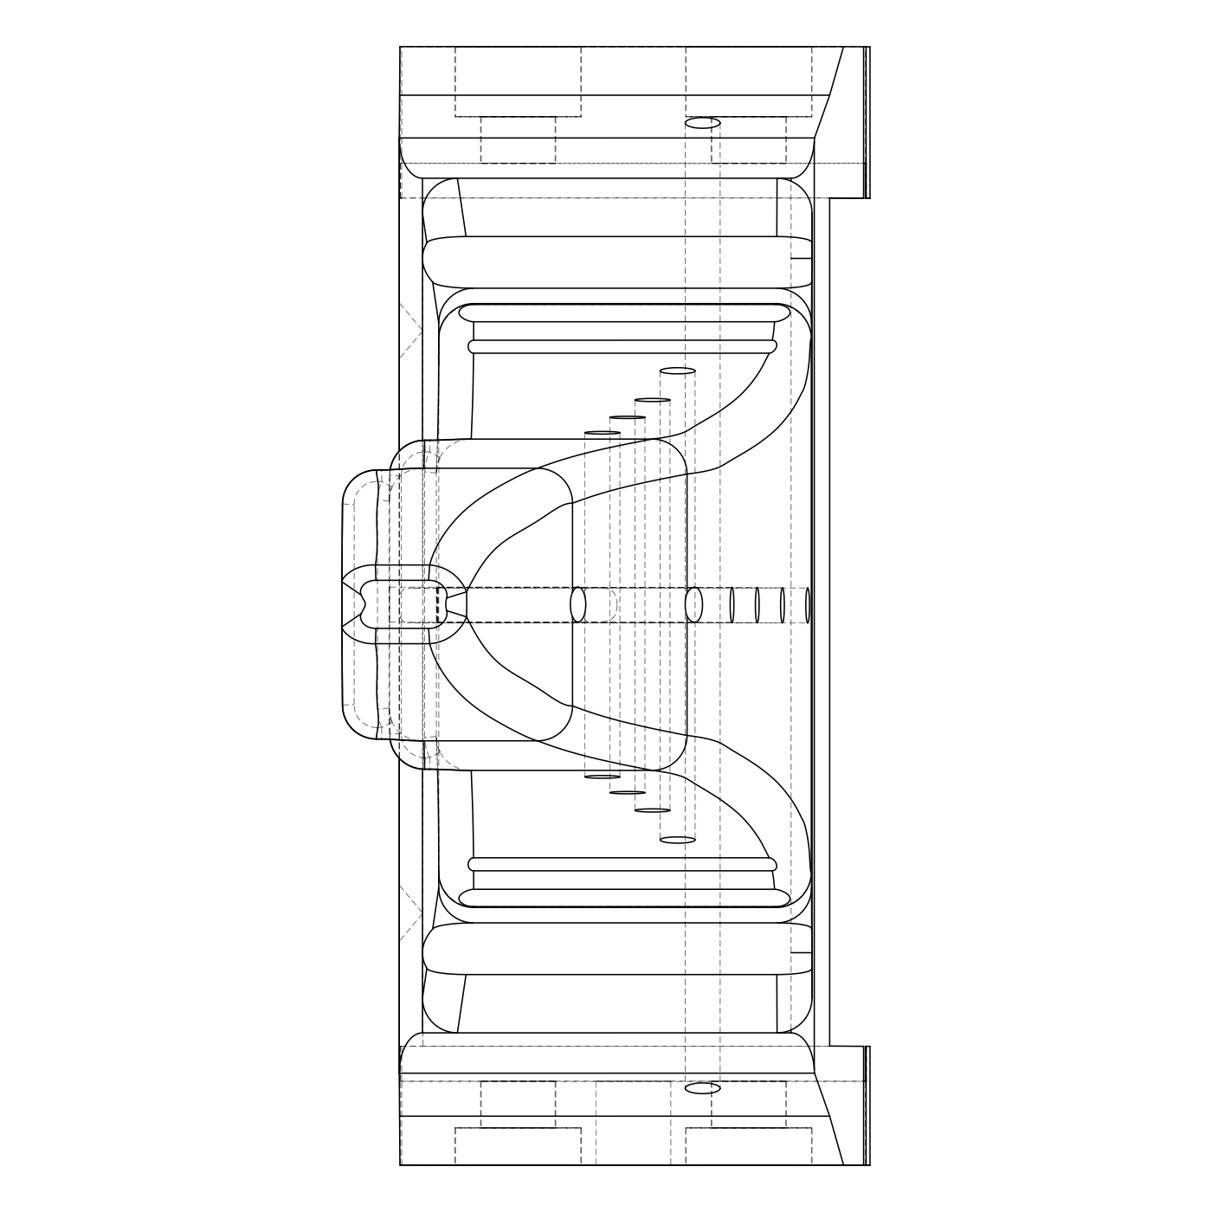
cad/build123d/render/moving_jaw_front.png
