JacobSchantz/HelpingHands/cad/build123d/render/moving_jaw_side.png

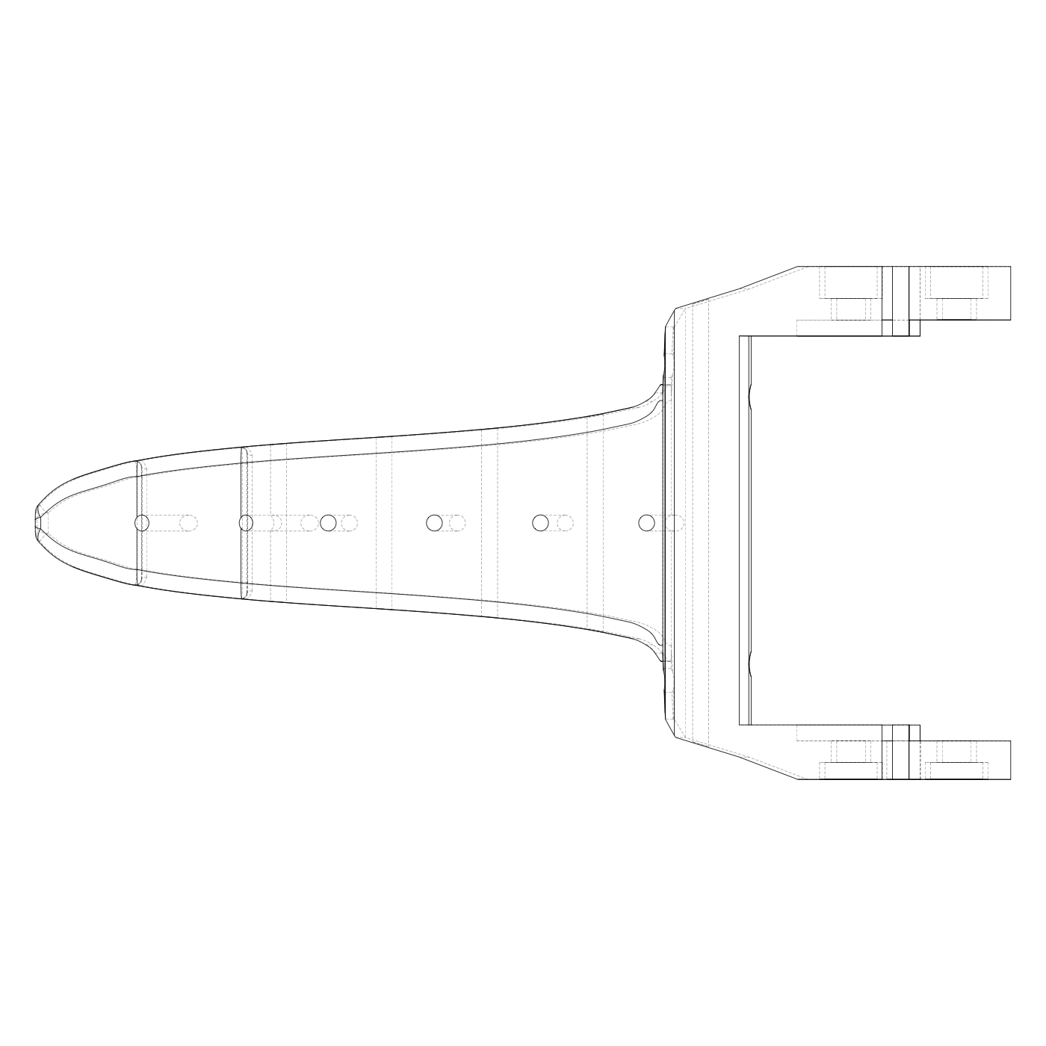
cad/build123d/render/moving_jaw_side.png
