JacobSchantz/HelpingHands/cad/openscad/demo_gripper/render/assembled.png

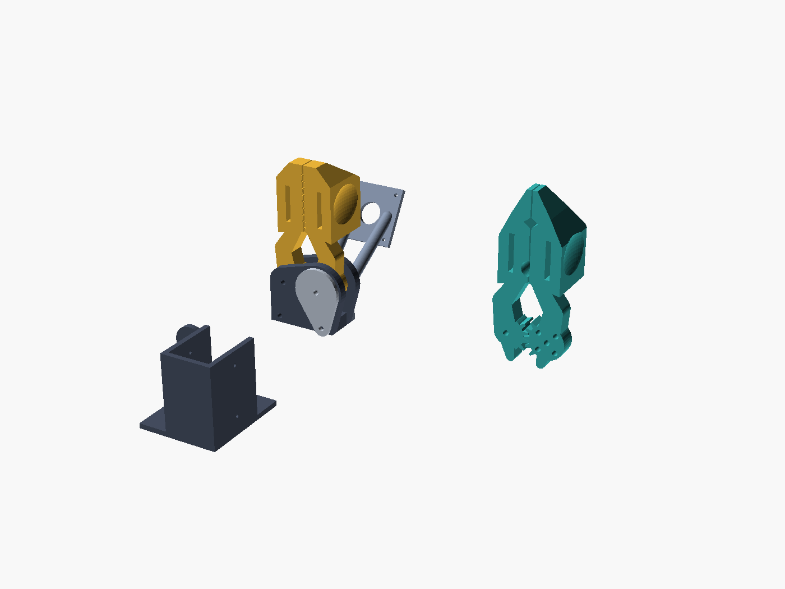
cad/openscad/demo_gripper/render/assembled.png
