JacobSchantz/HelpingHands/cad/openscad/demo_gripper/render/gen_00_assembled.png

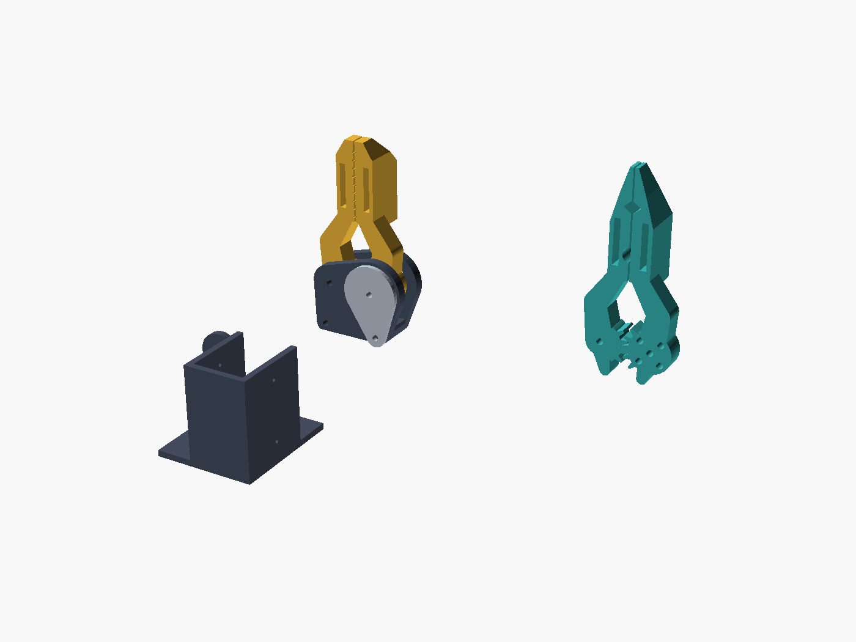
cad/openscad/demo_gripper/render/gen_00_assembled.png
