JacobSchantz/HelpingHands/pebbles/agent/voice-6d8b9fd8/app_assembled.png

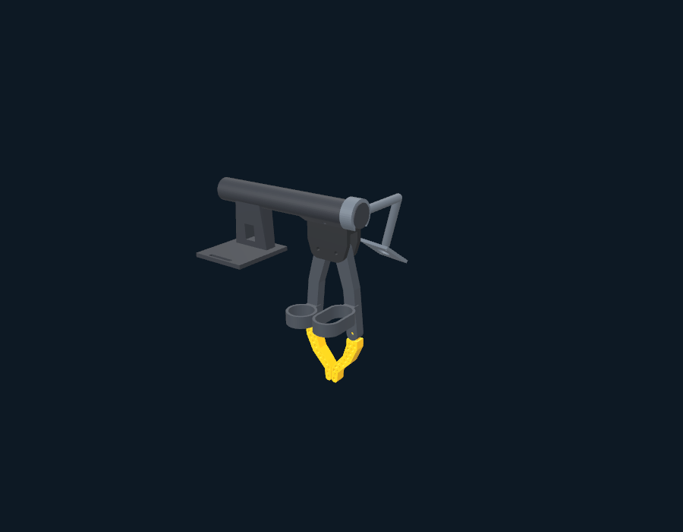
pebbles/agent/voice-6d8b9fd8/app_assembled.png
