JacobSchantz/HelpingHands/Two Finger Gripper/versions/v011b_generalist_fingers_astra/rounds/r3_printable_point/top.png

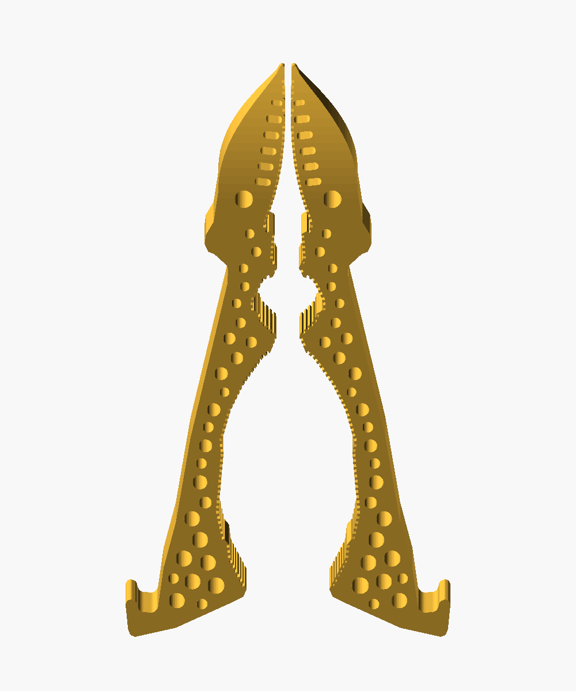
Two Finger Gripper/versions/v011b_generalist_fingers_astra/rounds/r3_printable_point/top.png
