JacobSchantz/HelpingHands/Two Finger Gripper/versions/v206_generalist_single_step/previews/compare_v205.png

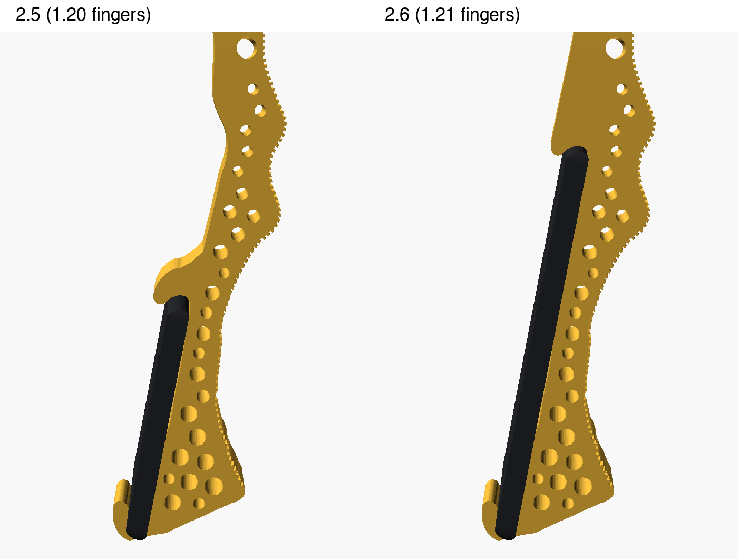
Two Finger Gripper/versions/v206_generalist_single_step/previews/compare_v205.png
