JacobSchantz/HelpingHands/Two Finger Gripper/versions/v206_generalist_single_step/previews/slides.png

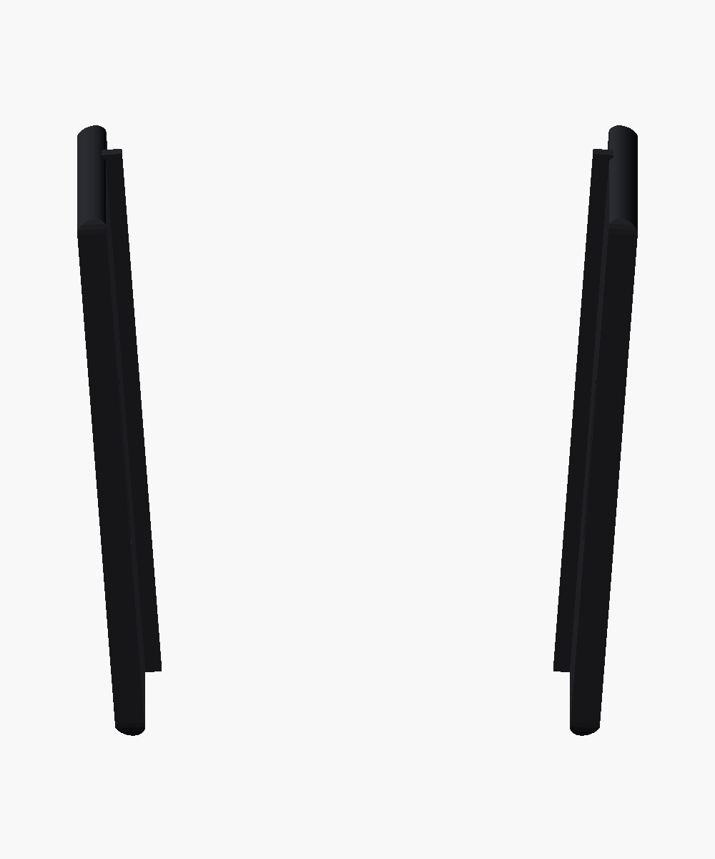
Two Finger Gripper/versions/v206_generalist_single_step/previews/slides.png
