JacobSchantz/HelpingHands/Two Finger Gripper/versions/v307_generalist_printable/previews/open.png

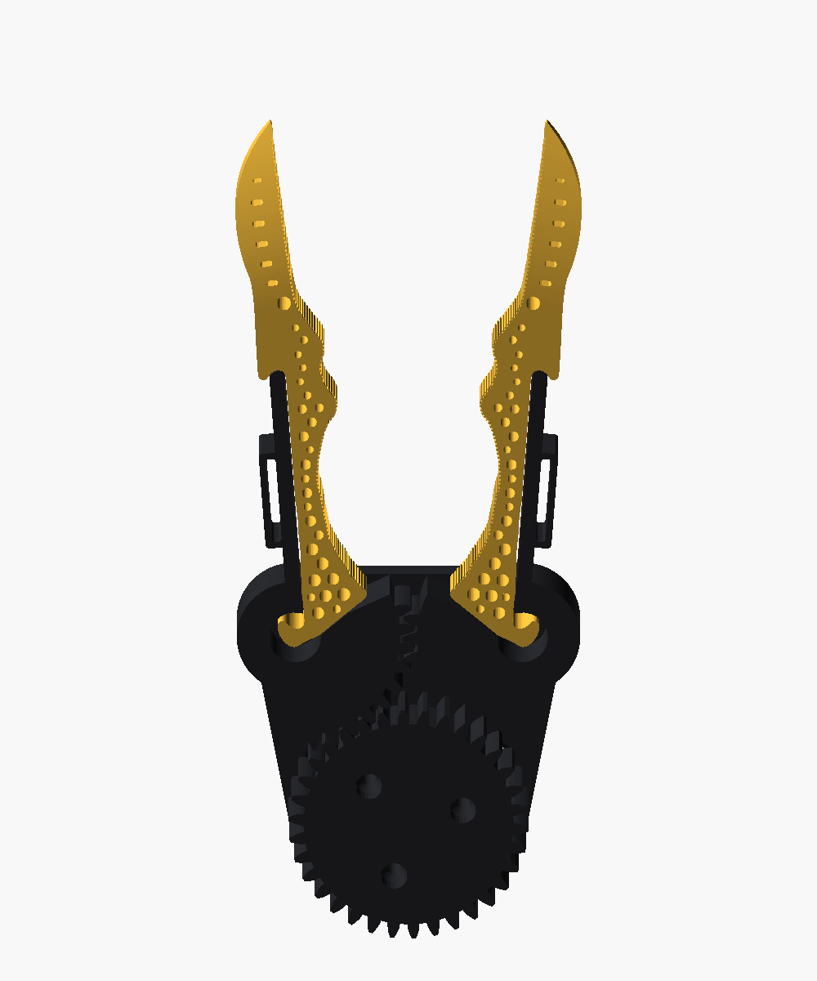
Two Finger Gripper/versions/v307_generalist_printable/previews/open.png
