JacobSchantz/HelpingHands/Two Finger Gripper/versions/v327_generalist_support_free/previews/print_plate.png

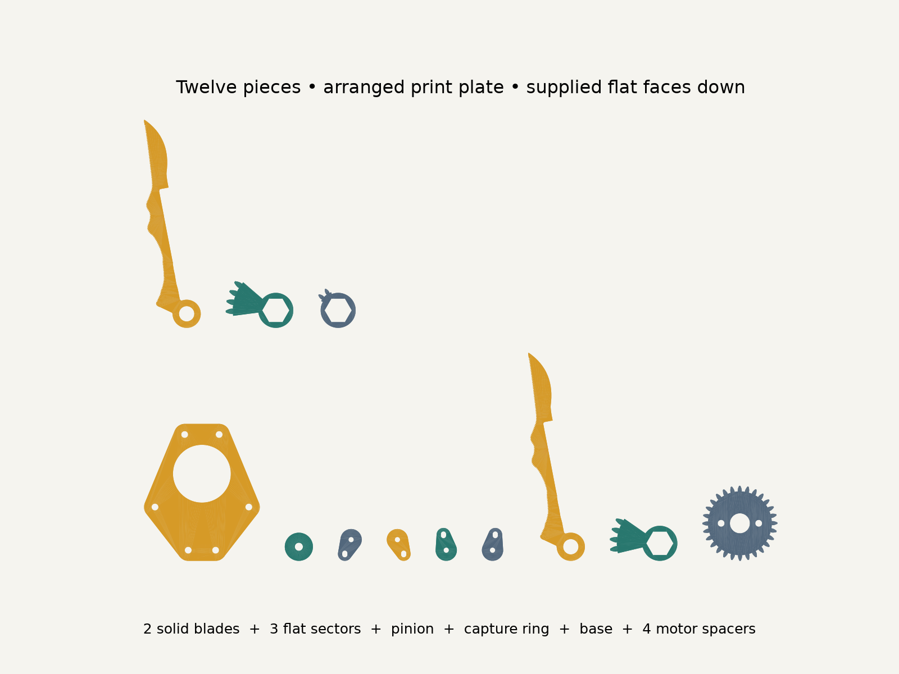
Two Finger Gripper/versions/v327_generalist_support_free/previews/print_plate.png
