JacobSchantz/HelpingHands/cad/validation/voice-550038ca-support-free/README.md

# Support-free manufacturing review — voice-550038ca

Current CAD and print artifacts: `Two Finger Gripper/versions/v327_generalist_support_free/`.

All 29 regression checks pass. Manufacturing mesh sections at0.1mm and actual installed PrusaSlicer2.9.4 paths pass, supports OFF, zero support/bridge/overhang paths. Twelve printed pieces,33 total physical parts. Source-based servo/plate and new screw-stack checks,121 motion poses ×190 body pairs, driver access, key/wall constraints, original-tip closure and axial retention pass. No physical print, fit, strength, fatigue or motor actuation evidence.

Whole-hand screening intentionally remains a separate FAIL: actual Base26/Gripper30, generic right hands181.1/193.3mm,13 poses each. Saved JSON contains measured misses and skin containment; it is not Jake's anatomy or ergonomic acceptance. Do not present manufacturing success as hand-fit approval. Browser page: `http://127.0.0.1:8768/support_free_acceptance.html`, with Copy fit report. No shared hand solver changes.

Base25/Gripper29 remains historical and is not support-free print-ready. Surgical-reference item voice-ef49247b was already in human/; it was not modified. Later design work should build on Base26/Gripper30 and preserve the manufacturing tests.
