JacobSchantz/HelpingHands/cad/build123d/MEASUREMENTS.md

# Reference measurements — SO-101 gripper

Generated by `measure_reference.py` from the two committed STEP files.
Every number below was read off **analytic B-rep surfaces** (exact radii,
exact plane normals), never off a tessellation. Re-run the script to
re-derive any dimension in `params.py`.

## Moving jaw

`Moving_Jaw_SO101.step`

- bounding box: x -12.30..10.00, y -82.00..10.00, z -24.00..24.00 mm
- volume: 20691 mm³
- faces: 189 (26 of them B-spline)
- toroidal fillet radii present: R1.0 ×6

### Holes and bores

| Ø | axis | axis passes through | through-material | area mm² |
|---|---|---|---|---|
| 20.00 | (0.0, 0.0, -1.0) | (0.0, 0.0, -17.4) | x -6.69..4.36, y -10.00..-7.43, z -18.90..-17.40 | 17.8 |
| 20.00 | (0.0, -0.0, 1.0) | (0.0, 0.0, 16.0) | x -6.69..4.36, y -10.00..-7.43, z 16.00..17.50 | 17.8 |
| 8.40 | (-1.0, 0.0, 0.0) | (-0.29, -26.2, -14.9) | x -7.30..5.03, y -25.19..-22.00, z -14.90..-10.83 | 67.6 |
| 8.40 | (-1.0, 0.0, 0.0) | (-0.29, -26.2, 14.9) | x -7.30..5.03, y -25.19..-22.00, z 10.83..14.90 | 67.6 |
| 8.40 | (-1.0, 0.0, 0.0) | (0.0, -10.8, -13.2) | x -9.20..5.89, y -15.00..-10.80, z -17.40..-13.20 | 94.3 |
| 8.40 | (-1.0, 0.0, 0.0) | (0.0, -10.8, 11.8) | x -9.20..5.89, y -15.00..-10.80, z 11.80..16.00 | 94.3 |
| 5.40 | (0.0, 0.0, 1.0) | (-4.95, -4.95, -15.75) | x -6.84..-2.25, y -7.65..-2.25, z 21.00..24.00 | 38.0 |
| 5.40 | (0.0, 0.0, -1.0) | (-4.95, -4.95, 14.35) | x -6.84..-2.25, y -7.65..-2.25, z -24.00..-22.40 | 20.3 |
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
| (0.0, 1.0, 0.0) | -20.718, -15.954, 7.091, 15.782, 15.954 |
| (1.0, 0.0, 0.004) | 5.086, 7.186, 11.992, 12.292 |
| (0.5, -0.0, 0.866) | 15.788, 19.838, 21.388, 25.438 |
| (0.5, 0.0, -0.866) | -26.388, -22.338, -20.788, -16.738 |
