JacobSchantz/HelpingHands/cad/glove_hand/refs/measurements.md

# Jake left-hand caliper measurements (mm), 2026-10-17

- thumb base knuckle width (MCP, where the thumb joins the hand): 30
