JacobSchantz/HelpingHands/cad/validation/voice-550038ca-small-drive/closure.png

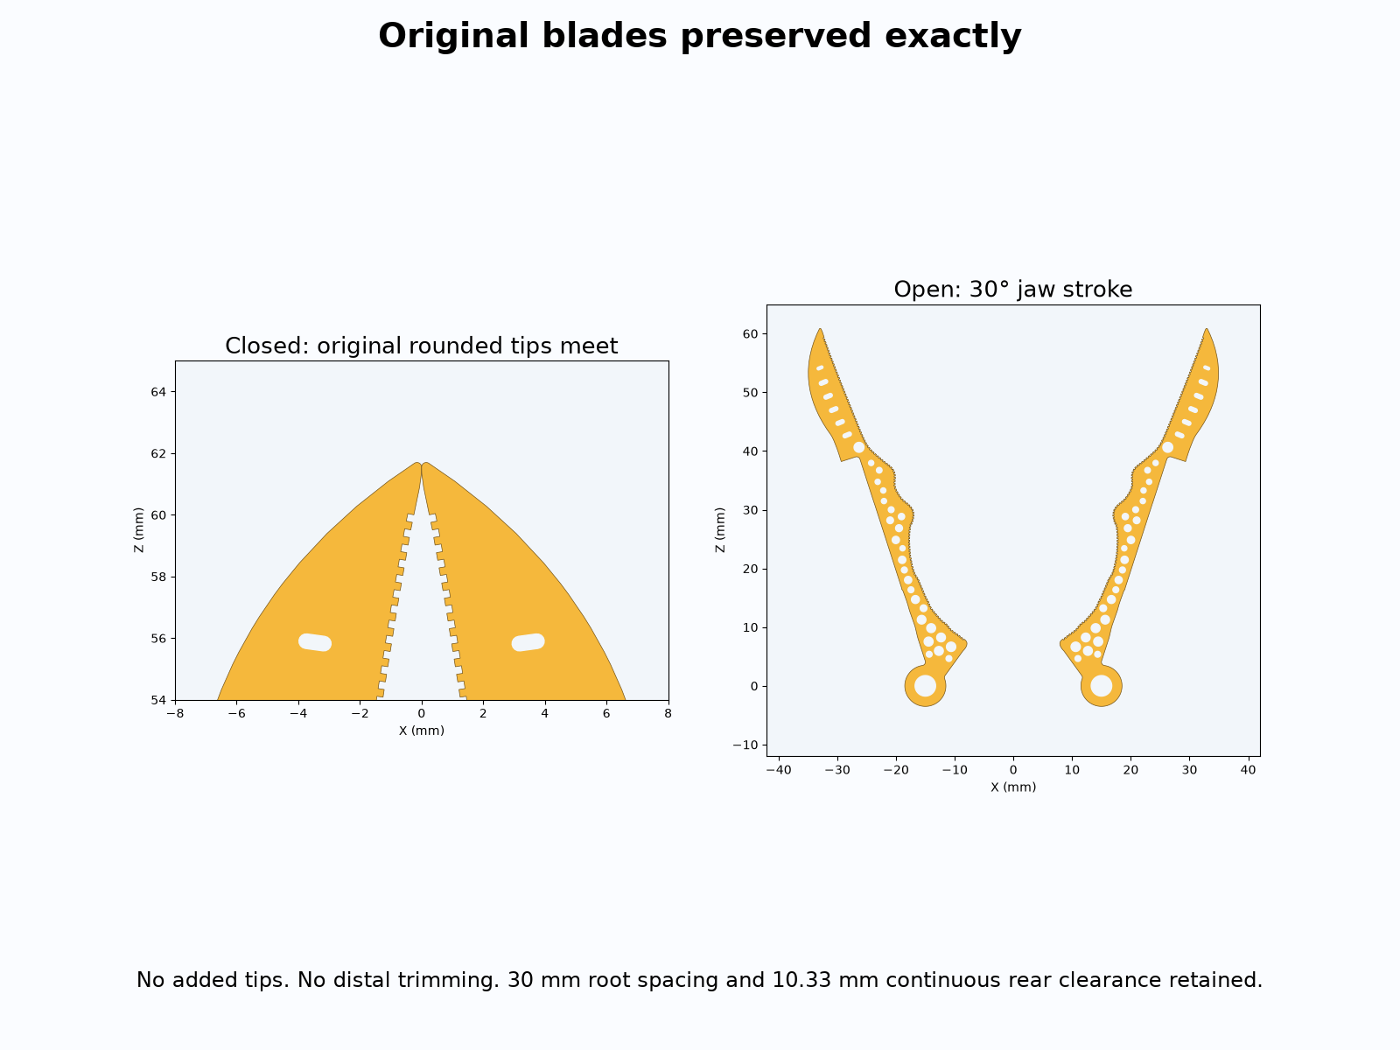
cad/validation/voice-550038ca-small-drive/closure.png
