JacobSchantz/HelpingHands/pebbles/agent/voice-3211a12d/tune_from_mix.png

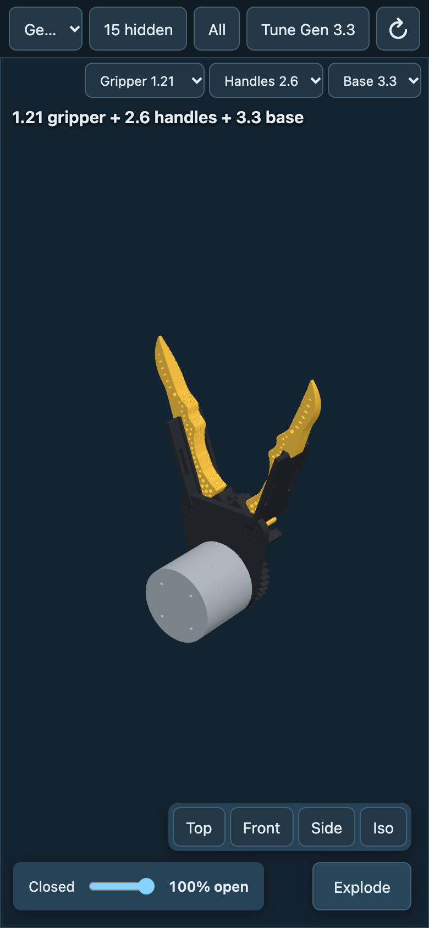
pebbles/agent/voice-3211a12d/tune_from_mix.png
