JacobSchantz/HelpingHands/pebbles/agent/voice-3211a12d/tune_phone.png

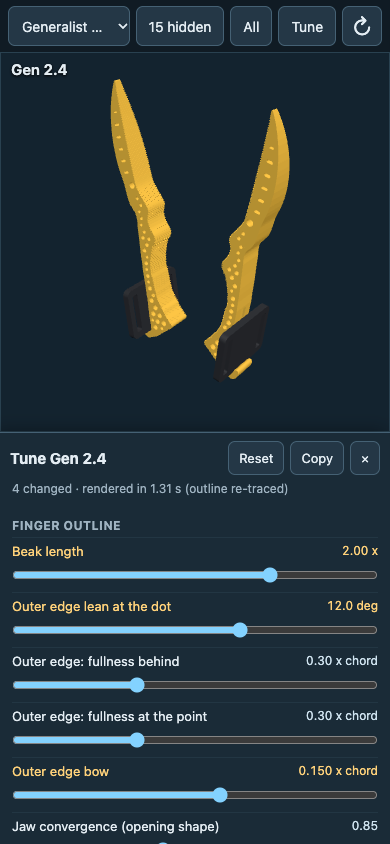
pebbles/agent/voice-3211a12d/tune_phone.png
