JacobSchantz/HelpingHands/pebbles/human/voice-3211a12d/tune_panel.png

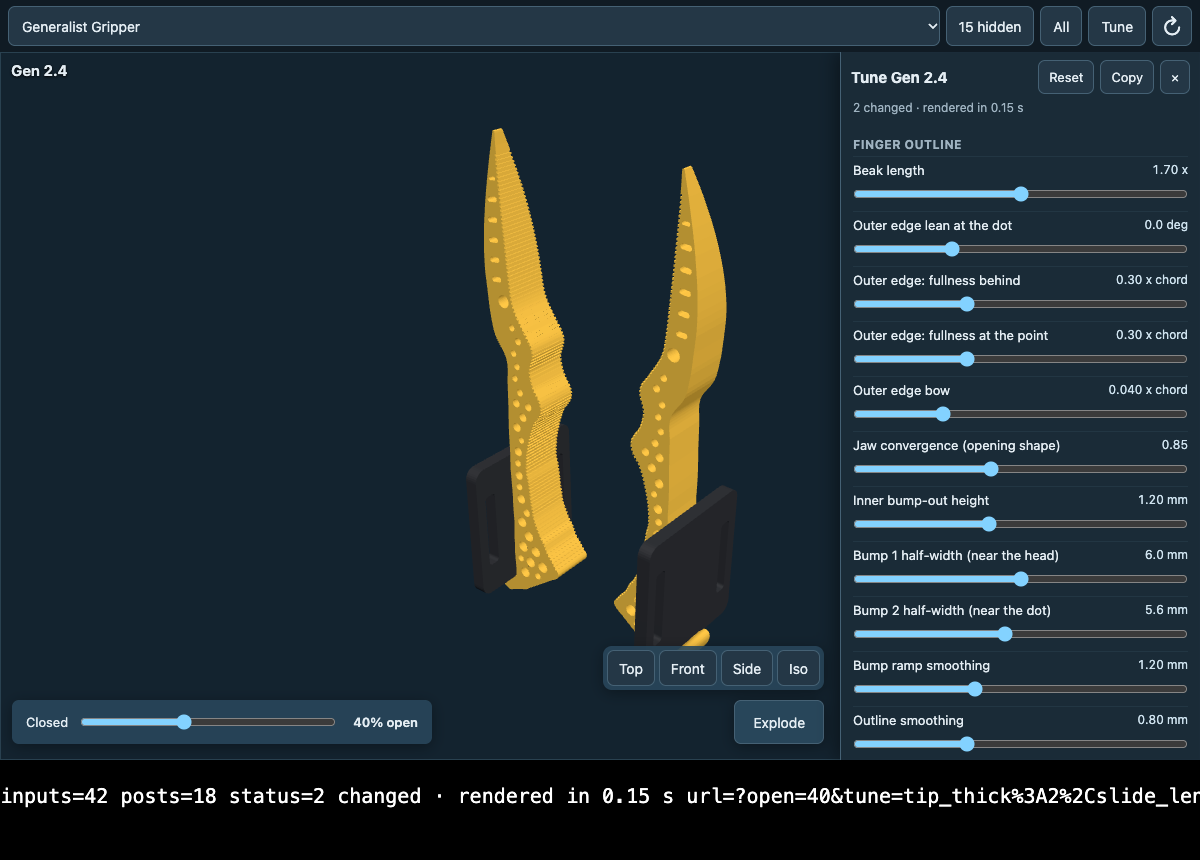
pebbles/human/voice-3211a12d/tune_panel.png
