JacobSchantz/HelpingHands/pebbles/human/voice-563b984c/replay-after-fix-sheet.jpg

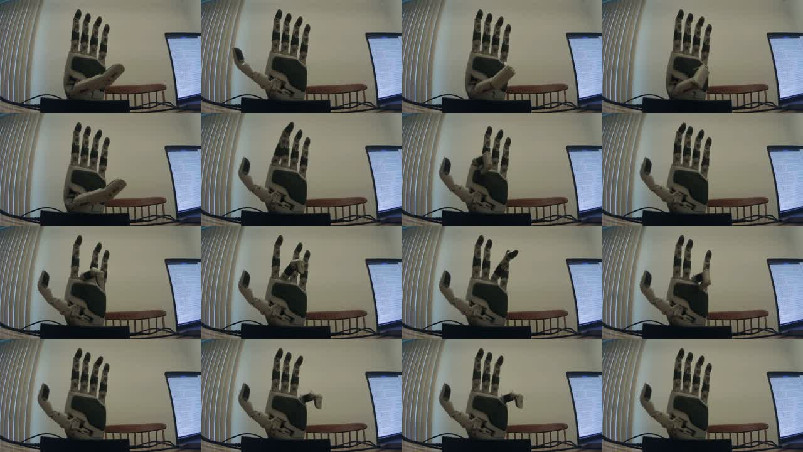
pebbles/human/voice-563b984c/replay-after-fix-sheet.jpg
