JacobSchantz/HelpingHands/Two Finger Gripper/versions/v007_generalist_fingers/rounds/r3_review_fixes/zoom_photo_blade.png

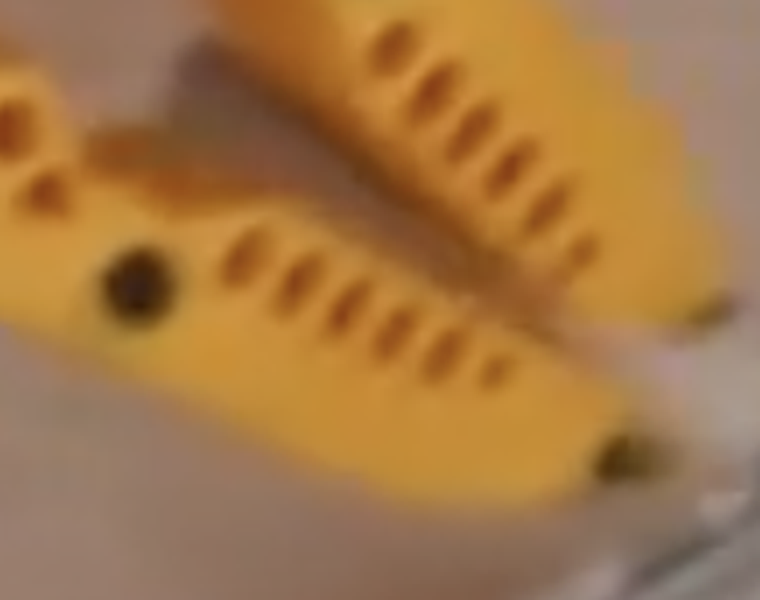
Two Finger Gripper/versions/v007_generalist_fingers/rounds/r3_review_fixes/zoom_photo_blade.png
