JacobSchantz/HelpingHands/Two Finger Gripper/versions/v327_generalist_support_free/slicing/fdm_screen.ini

# Explicit generic FDM screening profile; saved Bambu profile is X1 Carbon / 0.4 / eSUN PLA+.
# PrusaSlicer produces portable toolpath evidence; not a ready-to-run Bambu machine job.
layer_height = 0.1
first_layer_height = 0.2
nozzle_diameter = 0.4
filament_diameter = 1.75
filament_type = PLA
bed_shape = 0x0,256x0,256x256,0x256
max_print_height = 256
printer_technology = FFF
gcode_flavor = marlin
use_relative_e_distances = 1
layer_gcode = G92 E0
temperature = 210
first_layer_temperature = 210
bed_temperature = 60
first_layer_bed_temperature = 60
perimeters = 4
top_solid_layers = 5
bottom_solid_layers = 5
fill_density = 100%
fill_pattern = rectilinear
perimeter_generator = arachne
extrusion_width = 0.45
first_layer_extrusion_width = 0.45
bridge_flow_ratio = 0.9
support_material = 0
support_material_auto = 0
support_material_enforce_layers = 0
raft_layers = 0
brim_width = 0
skirts = 0
fan_always_on = 1
min_fan_speed = 100
max_fan_speed = 100
bridge_fan_speed = 100
disable_fan_first_layers = 1
perimeter_speed = 30
external_perimeter_speed = 20
infill_speed = 40
solid_infill_speed = 30
bridge_speed = 20
first_layer_speed = 20
start_gcode = G28\nG92 E0
end_gcode = M104 S0\nM140 S0
