JacobSchantz/HelpingHands/Two Finger Gripper/versions/v326_generalist_small_drive/params.py

#!/usr/bin/env python3
"""Version 2.4's parameters: params.json is the one source. values() reads it (plus overrides, clamped to each slider's
range); write_scad() writes params.scad, which gripper.scad includes. Run it to regenerate params.scad after editing
params.json; export_models.py does that too."""
from pathlib import Path
import json, math, sys
HERE=Path(__file__).resolve().parent


def specs():
    return [p for g in json.loads((HERE/'params.json').read_text())['groups'] for p in g['params']]


def values(overrides=None):
    """name -> value. Overrides must name a slider param (not calibration) and be a finite number; they are clamped to
    [min, max] and snapped to whole numbers where the step is."""
    out={p['name']:p['value'] for p in specs()};by={p['name']:p for p in specs()}
    for k,v in (overrides or {}).items():
        p=by.get(k)
        if p is None or p['stage']=='calibration':raise ValueError(f'not a tunable parameter: {k}')
        if isinstance(v,bool) or not isinstance(v,(int,float)) or not math.isfinite(v):raise ValueError(f'{k} must be a number')
        if k=='scale_factor' and not p['min']<=v<=p['max']:raise ValueError('Scale is outside the verified miniature range 0.500–1.000')
        v=min(max(v,p['min']),p['max'])
        out[k]=int(round(v)) if float(p['step']).is_integer() and float(p['value']).is_integer() else float(v)
    return out


def outline_changed(overrides):
    """True when an override moves the plan outline, so trace_photo.py must run again."""
    stage={p['name']:p['stage'] for p in specs()};base=values()
    return any(stage[k]=='outline' and v!=base[k] for k,v in values(overrides).items())


# Every linear servo dimension and minimum real hardware clearance remains actual-size.
HARDWARE = {p['name'] for p in specs() if p['name'].startswith('sts_') and p['unit']=='mm'} | {
 'spigot_d','screw_clear_d','gear_bolt_head_d','gear_bolt_head_h',
 'motor_screw_head_d','motor_screw_head_h','pillar_pilot_d','wrist_pilot_d',
 'base_clear','cap_fit','fit','stack_gap','top_gap','base_t','top_t','pillar_d','gear_backlash'}

def write_scad(path=HERE/'params.scad',vals=None):
    vals=vals or values();doc={p['name']:p for p in specs()}
    lines=['// GENERATED by params.py from params.json. Do not edit; change params.json and re-run params.py.']
    for k,v in vals.items():
        p=doc[k]
        if k in {'closure_tip_trim','closure_pad_z0','closure_pad_z1','closure_pad_join_x','closure_pad_join_back','body_closure_gap','center_capture_t','center_clear_d','mesh_split','mesh_layer_gap','rear_gap_budget','gear_join_r','drive_gap','key_r','key_fit','key_depth','key_end_gap','tool_d','tool_len','contact_edge_w','contact_trim_u0','contact_trim_u1','pivot_bore','retainer_gap','washer_d','washer_bore','washer_t','pivot_screw_d','pivot_screw_len','pivot_head_d','pivot_head_h','pivot_socket_af','pivot_nut_af','pivot_nut_h','pivot_nut_bore','nut_tool_d'} or k in HARDWARE or (k.startswith('hls_') and p['unit']=='mm'):v=v/vals['scale_factor']
        if k=='base_r':v=(vals['hls_plate_d']/2+vals['base_clear']+vals['drive_base_rim'])/vals['scale_factor']
        if k=='pillar_x':v=vals['cap_pillar_x']/vals['scale_factor']
        if k=='pillar_z':v=-(vals['pivot_spacing']/2+vals['pivot_spacing']/vals['gear_teeth']*(vals['pinion_teeth']+1))-(vals['pillar_d']/2+vals['pillar_motion_clear'])/vals['scale_factor']
        unit=f' ({p["unit"]})' if p['unit'] else ''
        lines.append(f'{k}={json.dumps(v)};'.ljust(28)+f'// {p.get("label",k)}{unit}: {p["doc"]}')
    Path(path).write_text('\n'.join(lines)+'\n')


if __name__=='__main__':
    write_scad();print(f'wrote params.scad ({len(specs())} parameters)')
    sys.exit(0)
