JacobSchantz/HelpingHands/(commit log)

2026-02-18 Add custom.toml for Raspberry Pi configuration
2026-03-02 updated open claw
2026-03-05 updated open claw setup
2026-03-31 Add teleop.sh and calibration files at correct paths for lerobot
    - teleop.sh: one-command teleop script using leader_left/follower_right calibration
    - lerobot_calibration/follower_right.json, leader_left.json: copied to top-level so lerobot finds them (it looks for calibration_dir/<id>.json)
    - lerobot_calibration/so_follower, so_leader: symlinks to original teleoperators/ and robots/ subdirs
    - calibration_backup/: removed stale backup files
2026-03-31 Remove stale calibration_backup files
2026-04-25 Add teleop jitter warning: always use native Terminal
    Running lerobot-teleoperate through any wrapper/shell pipe causes
    significant jitter (16-88ms loop times vs steady 16ms). Documented
    the problem and the fix: launch directly in Terminal.app.
2026-04-25 🦖 Add T-Rex roar sound effect for teleop startup
    Plays a real T-Rex roar when teleop starts and when arms connect.
    Replaces the wimpy system beep.
2026-04-25 🚜 Add backhoe dig sound for teleop startup
    - backhoe_dig.wav: hydraulic press + dirt scrape, no beeps
    - Kept trex_roar.mp3 and lobster_click.wav in repo for future use
    - Sound plays once at startup, no second sound after connect
2026-04-25 Add training pipeline documentation
    Covers the full flow: record demos → train ACT/Diffusion policy → evaluate/deploy.
    Includes recording params, hardware requirements, decision points, and quick start.
2026-04-25 🏗️ Clean up project structure
    - sounds/ — all sound effects in one place (lobster_click, backhoe_dig, trex_roar, lullaby)
    - plans/ — future plans and long docs (training_pipeline.md)
    - robot_config.md — consolidated single config for both arms
    - teleop.sh — uses relative paths, no hardcoded dirs
    - Removed: Miniforge installers, .DS_Store, redundant notes files
    - Plans folder ready for roadmap
2026-04-25 Add teleop notes as comments in teleop.sh
    - Pulled upstream changes (calibration cleanup, iBackpack plan, renamed notes)
    - Moved jitter warning from teleop_notes.txt into teleop.sh header as comments
    - Agent can now read the script and know to use native Terminal.app
    - Removed separate teleop_notes.txt (content preserved in teleop.sh)
2026-04-25 Add simulated training pipeline plan
    Record real teleop → augment with noise/timing variations → train.
    No human video stuff yet — just robot arm data.
2026-04-25 Add paper manipulator plan
    5 levels of difficulty: pick/place → fold → crumple → page turn → envelope stuff.
    Deformable object manipulation — cheap to test, hard to solve.
2026-04-25 Add slow homing on teleop crash
    - home_arm.sh: connects to follower arm and slowly moves to home position
    - teleop.sh: if teleop exits non-zero, runs home_arm.sh at 10°/sec
    - Prevents arm from just going limp on crash
2026-04-25 Update home_arm.sh with real resting positions
    Read current arm position: shoulder_pan=-6.5, shoulder_lift=-103.9,
    elbow_flex=94.6, wrist_flex=67.7, wrist_roll=0.3, gripper=0.5
    Uses proper SOFollower API with calibration.
2026-04-25 Fix home_arm.sh: use .pos key format for send_action
    send_action expects {'shoulder_pan.pos': value} not {'shoulder_pan': value}.
    Tested successfully — arm homes smoothly over ~8s at 20°/sec.
2026-04-25 Use servo internal acceleration for smooth homing
    Instead of manually interpolating position steps (which causes jitter),
    set low acceleration on the servos and write goal positions directly.
    The servo firmware handles smooth motion internally.
2026-04-25 Comment out auto-home on crash — run home_arm.sh manually if needed
2026-04-25 Fix home_arm.sh: enable torque before sending goal positions
2026-04-25 Add sync_arm.sh — slowly match follower to leader then go limp
    Solves the violent snap when starting teleop: the follower tries to
    match the leader at full speed. Now run sync_arm.sh first, follower
    slowly moves to leader's position, then disables torque. Start teleop
    from there with no jarring movement.
2026-04-25 Fix sync_arm.sh: use SOLeaderTeleopConfig + get_action()
    Leader is a teleoperator not a robot. Uses get_action() not get_observation().
    Tested working — follower slowly matches leader then goes limp.
2026-04-25 Switch home_arm.sh to servo acceleration (same as sync_arm)
    Both scripts now use servo internal acceleration for smooth motion
    instead of manual 50ms interpolation which caused jitter.
2026-04-25 Run sync_arm.sh before teleop — no more violent snap on start
2026-04-25 Fix sync_arm.sh: keep torque enabled after sync
    Disabling torque caused arm to drift, then teleop snaps it back
    violently. Now sync leaves arm at leader position with torque on.
2026-04-25 Disable torque on both arms after teleop stops
2026-04-25 Fix sync_arm.sh: wait until arm actually reaches target before exiting
    Tighter tolerance (0.5°), requires 3 consecutive settled reads,
    prints progress. Teleop won't start until arm is truly in position.
2026-04-25 Integrate sync into teleop.sh — no more violent snap
    Sync is now part of teleop startup:
    1. Read leader position
    2. Connect follower with low acceleration (override lerobot's 254)
    3. Move follower slowly to match leader
    4. Wait until synced (within 0.5°)
    5. Disconnect, then start teleop (accel resets to 254 = fast, but arms already match)
    6. Disable torque on exit
2026-04-26 Add home_both.sh — homes leader + follower to safe positions
2026-04-26 Remove sync from teleop — go straight to teleop
    Sync is available separately via sync_arm.sh if needed.
2026-09-02 Tool Caddy concept: Mac Mini brain + battery + SO-101 arm on a tool cart, with Blender render
2026-09-02 Save the editable tool-caddy Blender scene
    [tool-caddy.blend]
2026-09-13 plans: capture the gripper-vs-training-data question
    Records today's thinking on the unverified "GPT moment for robotics" claim
    around Generalist Robotics, and the open tension between the pincher being
    the insight vs. being the cheapest body for a data/training bet. Ties it to
    the SO-101 gripper already in this repo and to the Tool Caddy hand-off.
    Claude-Session: https://claude.ai/code/session_017A9gSunnM1SwPDKCEdDHAN
2026-09-13 plans: rewrite gripper_bet around Jake's thesis
    The open tension is resolved by his own answer: the breakthrough is humans
    driving the hardware, not the end effector; proprioception at the point of
    contact is the hard part; and his departure is that hardware capability is
    undervalued — the bet is a human hand whose glove is identical to it and
    fully 3D printable. Final requirement is cut off mid-note and flagged.
    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
2026-09-13 plans: add the Hand 1.0 / Hand 2.0 roadmap
    Names the two stages so later docs can refer to them directly: Hand 1.0 is
    SO-101-like and conventional, the foundation that gets the teleop-and-record
    loop working end to end; Hand 2.0 is the identical-to-the-glove, fully
    3D-printed human hand. 1.0 existing is what makes 2.0's identity constraint
    testable against a real baseline.
    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
2026-09-13 plans: design Hand 1.0 — arm-mounted/handheld paper gripper
    On-paper design for the Hand 1.0 end effector: one gripper body with a camera,
    usable bolted to the SO-101 wrist or held in the hand, first tuned for picking
    flat sheets. Covers the flush-sheet pick problem (drag-to-buckle primary,
    push-to-edge fallback), parallel-jaw linkage, asymmetric pad friction for
    single-sheet separation, compliance-based force limiting, camera placement,
    umbilical and trigger, and what must be bought rather than printed.
    Records that the repo pins the servo interface but no mounting geometry, so it
    lists what must be measured off the arm instead of inventing dimensions. Flags
    wrist_roll's full 0-4095 turn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
2026-09-13 plans: record the CAD toolchain decision for Hand 1.0
    OpenSCAD as the source of truth for printable parts (text in git, parametric
    against measurements that don't exist yet, agent-authorable); Blender for
    visualization only. Notes the real caveat — mesh output, no fillets, no STEP —
    with build123d as the escape hatch, plus cad/ layout and STLs as artifacts.
    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
2026-09-13 Keep SO-101 reference STEP files; ignore CAD venvs
    Downloaded while evaluating CAD toolchains. STEP carries exact analytic
    geometry, so these are the dimensional source of truth for the gripper
    work rather than the tessellated meshes.
    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
    [Moving_Jaw_SO101.step, Wrist_Roll_Follower_SO101.step]
2026-09-13 feat: add pebbles for SO-101 gripper CAD bake-off (OpenSCAD, build123d, Blender)
    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
2026-09-13 docs: add why-we-are-doing-this goal section to CAD bake-off pebbles
    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
2026-09-13 cad: rebuild the SO-101 gripper parametrically in OpenSCAD (bake-off 1 of 3)
    Recreates the fixed jaw (Wrist_Roll_Follower) and the moving jaw as editable
    parametric source, measured off the reference STEP files at
    cad/build123d/reference/ rather than eyeballed from a mesh.
    - params.scad holds every dimension as a named variable, each tagged [STEP],
    [DERIVED] or [GUESS] so a future edit knows what it is standing on, plus
    assert()s on the relationships an edit must not break.
    - tools/measure_step.py reads planes and cylinders straight out of an AP214
    STEP file with nothing but the standard library -- OpenSCAD cannot import
    STEP, so measuring it was the expensive half of the job (see N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
    [assembly.stl, common.scad, fixed_jaw.scad, fixed_jaw.stl, gripper.scad, moving_jaw.scad, moving_jaw.stl, params.scad]
2026-09-13 cad/blender: parametric SO-101 gripper, generated headlessly from a bpy script
    Third entry in the CAD bake-off. so101_gripper.py is the source: a ~60-entry
    parameter block plus loft/boolean code that regenerates both jaws, the
    assembly, the renders, the STLs and the .blend on every run. Nothing is
    hand-modelled and nothing in out/ should be hand-edited.
    Dimensions come from the reference STEP files, read two ways: measure_step.py
    (dependency-free ISO-10303-21 parser) and measure_step_ocp.py (OCCT, used only
    as a measuring instrument). Both bounding boxes match the reference to ~0.1 mm.
    cad/build123d/reference/ is opened read-only and is unmodified.
    MEASUREMENTS.md maps every parameter to t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
    [fixed_jaw.stl, moving_jaw.stl, so101_gripper.blend, so101_gripper_assembly.stl]
2026-09-14 Release stale claims on the two CAD pebbles
    Both locks carried heartbeats ~1099 minutes stale against a 20-minute
    threshold, left behind when their workers were killed last night. Vigil's
    liveness test is pid-based, so the locks would have blocked dispatch
    indefinitely.
    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
2026-09-14 chore: give voice-394acdc8 to human (agent → human)
2026-09-14 chore: give voice-c23ee2e9 to human (agent → human)
2026-09-14 CAD bake-off 2/3: SO-101 gripper in build123d
    Parametric reconstruction of the moving jaw and the wrist-roll follower
    (gripper body / fixed jaw), built from measurements taken off the reference
    STEP files as analytic B-rep rather than off a mesh.
    - measure_reference.py interrogates the reference surfaces (exact cylinder
    radii, exact plane normals) and writes MEASUREMENTS.md; every [STEP]-tagged
    number in params.py comes from it
    - moving_jaw.py / fixed_jaw.py build both parts by lofting through the
    measured cross-section stations, with real B-rep fillets
    - gripper.py assembles them, exports STEP + STL, and draws SVG/PNG views
    - fidelity_check.py scores the model against the reference i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
    [fixed_jaw.step, fixed_jaw.stl, moving_jaw.step, moving_jaw.stl, so101_gripper_closed.step, so101_gripper_closed.stl]
2026-09-14 chore: give voice-d09b2ee3 to human (agent → human)
2026-09-17 Add an in-app 3D viewer for the gripper bake-off exports
    SceneKit can't read STL and Model I/O's STL path is inconsistent across OS
    versions, so binary and ASCII STL are parsed directly into an SCNGeometry;
    OBJ/PLY/USD go through Model I/O. STEP can't be tessellated without a CAD
    kernel, so those files are catalogued from their ISO-10303-21 header instead
    of shipped.
    Scripts/stage_cad_models.py copies cad/'s meshes plus a manifest into the app
    bundle as a build phase, so a rebuilt gripper ships without anyone moving
    files. Adds a macOS target sharing the same sources.
2026-09-17 chore: give voice-8b1fb04b to human (agent → human)
2026-09-17 Add plans to the app and read them aloud, hands-free
    Every markdown plan under plans/ is staged into the bundle by
    Scripts/stage_plans.py, parsed into speakable steps, and read out by
    AVSpeechSynthesizer. Opening a plan starts narrating and auto-advances to
    the end, so a plan can be consumed without looking at the screen.
    Eyes-free control has three twins for every button: full-screen gestures,
    AirPods / lock-screen transport (MPRemoteCommandCenter + background audio),
    and opt-in spoken commands via SFSpeechRecognizer.
2026-09-17 chore: give voice-bd3175b0 to human (agent → human)
2026-09-17 Add LeHome bring-up plan and simulation bootstrap
    Research pass on IliaLarchenko/lehome_solution (LeHome Challenge 2026,
    1st sim / 2nd real-world) to answer what it takes to reproduce bimanual
    garment folding on our SO-101 rig.
    plans/lehome_pillowcase.md — concrete answers on inference hardware
    (>8GB VRAM floor per openpi, 16GB realistic; Jetson moot because the
    policy server is remote over WebSocket), the strict inference minimum
    of 2 followers + 3 cameras, and the 20 Hz / 250 ms-per-inference control
    contract. Gap analysis with live GPU rental prices and a costed
    workstation BOM. Flags two things the brief did not anticipate: no Mac
    can run any of this (Isaac Sim has no macOS build; pyp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
2026-09-17 chore: give voice-40a92819 to human (agent → human)
2026-09-18 Exclude Info plists from sources so iOS installs succeed
    The macOS target's INFOPLIST_FILE lives under the shared HelpingHands
    source folder, so the iOS target copied it in as a resource. The device
    installer reads it, finds unexpanded $(PRODUCT_BUNDLE_IDENTIFIER) and no
    CFBundleExecutable, and rejects the whole app — every iPhone drop since
    has built fine and failed at install.
    Fix was already written in the working tree; committing it.
2026-09-18 Exclude Info plists via per-source excludes, not options
    `excludedSourceFileNames` under `options:` is not a key XcodeGen honours,
    so the previous fix was a no-op and Info-macOS.plist kept shipping inside
    the iOS .app. The device installer read it, found unexpanded
    $(PRODUCT_BUNDLE_IDENTIFIER) and no CFBundleExecutable, and rejected the
    app — every drop built fine and failed at install.
    Verified: build 85 now installs and launches on the iPhone.
2026-09-18 Send all three CAD bake-off pebbles back: motor mount is wrong
    All three failed human verification. The moving gripper is fine in every
    variant; the fixed gripper's motor mount is wrong in every variant.
    OpenSCAD is the priority route — investigate OpenSCAD MCP tooling rather
    than abandoning it. Must match the current gripper exactly.
2026-09-19 feat: a voice loop for the gripper model
    Say 'design, make the jaw longer' and the model redraws in about 270ms,
    of which 2ms is deciding what you meant. A resident process tails the
    notes file, a deterministic grammar rewrites a number in params.scad —
    or a warm model answers with one SET line when the grammar refuses —
    and OpenSCAD re-renders two cameras into an open browser tab.
    OpenSCAD over the bake-off's other two, re-measured rather than taken on
    trust: Build123d costs 2.6s to import OCCT and 4.3-4.8s per part even
    resident, which is nine seconds before a pixel. Blender's derived
    constants go wrong on exactly the edit this loop makes.
    The grammar's most important behaviour is re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
2026-09-20 feat: add pebble for the Caledonian crow gripper
2026-09-20 docs: MolmoAct2 findings — what a VLA changes for Helping Hands
    Checks the "no dataset" claim against the paper (SO-100/101 zero-shot OOD is
    56.7%, and the checkpoint is fine-tuned on community data, so "no dataset"
    means no dataset for OUR task), and against this repo: no cameras anywhere,
    no NVIDIA GPU, and an SO-101 joint-convention correction that drives the arm
    backwards if you use the raw allenai checkpoint.
    Recommendation is cameras first, rented GPU box second, one lerobot-rollout
    command third, decide about record_actions.sh only after there's a number.
2026-09-20 chore: give voice-4858e8fa to human (agent → human)
2026-09-20 cad: a New Caledonian crow beak as an SO-101 jaw pair
    New jaws in cad/openscad/crow/ shaped after the bill of Corvus
    moneduloides: straight culmen, upturned lower mandible, deep compressed
    base. Both mandibles are built to one shared tomial curve, so the beak
    closes along a 43 mm line instead of touching at the tip, and a 90 deg V
    at z=78 chucks a rod the way the bird holds a stick.
    Every interface is the SO-101's own, included from params.scad and the
    stock parts: wrist_roll horn pocket, servo cradle, cable bore, fork,
    horn bolt pattern, jaw pivot. Only the blades are new.
    fixed_jaw.scad and moving_jaw.scad gain fj_body_solid/fj_body_cuts and
    mj_fork/mj_fork_cuts so the crow blades can ha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
    [assembly.stl, assembly_open.stl, crow_beak.scad, crow_common.scad, crow_lower.scad, crow_params.scad, crow_upper.scad, fixed_jaw.scad]
2026-09-20 chore: give voice-15d564c5 to human (agent → human)
2026-09-20 plan: decide the crow gripper is hook-led at the root, and point cadloop at the beak
    The brief asked what a hook-led end effector means for the SO-101's wrist mount
    and payload before any geometry is cut. plans/crow_gripper.md is that decision.
    The premise needed a correction first: the New Caledonian crow's bill is not
    hooked — it is conspicuously straighter than other corvids. The hooks are on the
    tools it makes. So "hook-led" has to mean load carried by shape rather than by
    pinch force, which is a mechanical property, not a silhouette.
    What the wrist actually allows, measured from params.scad: one flange, one
    actuator, one gripper.pos channel. The stock gripper is already 1 DoF, so
    "f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
2026-09-20 chore: give voice-805d4970 to human (agent → human)
2026-09-29 Replace scissors pebble with handheld gripper research
2026-09-30 File autonomous wall-outlet charging robot milestone
2026-09-30 Promote handheld robot gripper research for Vigil
2026-09-30 docs: plan switch to a world action model (FLUX 3 Action)
2026-09-30 chore: give voice-1421c8a0 to human (agent → human)
2026-09-30 Resume crow gripper design for human demonstrations and SO-101
2026-09-30 plans: research open handheld gripper systems and plan an SO-101 handheld pilot (voice-b4fbc4ee)
2026-09-30 chore: give voice-b4fbc4ee to human (agent → human)
2026-09-30 design: crow cartridge docks on the SO-101 wrist or a handle; cut the throat
    One cartridge (upper body + ID 6 + lower mandible + wrist camera) slides onto a
    dovetail carried by both a wrist puck (stock horn pattern) and a pistol-grip
    handle with a leader-servo trigger and phone cradle. The hook is a U throat
    behind the tomial line, closed by the lower mandible as a gate, so the
    closed-form interference proof holds unchanged. Adds a framing check, wrist
    budget script, and plans/crow_gripper.md sections 9-13 (capture plan reusing
    voice-b4fbc4ee, test ladder G0-G5; only G0 run).
    [assembly.stl, assembly_open.stl, camera_mount.stl, crow_beak.scad, crow_camera.scad, crow_common.scad, crow_dock.scad, crow_handle.scad]
2026-09-30 plans: outlet hop milestone — plan, fault-injecting sim + acceptance tests, power continuity logger (voice-f43bda60)
2026-09-30 chore: give voice-f43bda60 to human (agent → human)
2026-09-30 Prepare bounded MolmoAct2 cloud trial and binocular head camera plan
2026-09-30 Select sub-$100 Waveshare stereo camera for robot head
2026-10-12 docs: plan shared stereo camera glasses for robot and BuyAHabit (voice-d3e2cdc1)
2026-10-12 chore: give voice-d3e2cdc1 to human (agent → human)
2026-10-12 chore: give voice-9b6c3a3b to human (agent → human)
2026-10-14 cad: wearable hand gripper — finger-sleeve jaw, thumb-cup jaw, band return, camera wedge (voice-6d8b9fd8)
2026-10-14 cad: commit the hand gripper's printable STLs (voice-6d8b9fd8)
2026-10-14 chore: give voice-6d8b9fd8 to human (agent → human)
2026-10-14 feat: open Helping Hands straight to the newest design (voice-965bab93)
    The app launches into a design viewer: the newest folder of exports under
    cad/ (by last commit) loads in a 3D viewport with its renders below. Swipe
    or use the list for older designs; the old home is now Workshop.
    stage_cad_models.py discovers designs itself instead of a hardcoded list,
    so hand_gripper and crow now ship too.
2026-10-14 chore: give voice-965bab93 to human (agent → human)
2026-10-14 cad: hand gripper redone after Generalist's human gripper — 7 separate pieces, one exploded 3D view in the app (voice-6d8b9fd8)
    Spine bar + hub + gear-synced finger/thumb links with digit loops + TPU
    lattice tips + camera clip. Each STL is exported in its assembled position
    and parts.json carries label/colour/explode offset; the design viewer draws
    every piece in one SceneKit scene with an Explode/Assemble toggle.
2026-10-14 feat(hand_gripper): Generalist-style two-jaw gripper with fingertip sleeves on the jaws, camera bracket, SO-101 mount (voice-6d8b9fd8)
2026-10-14 feat(crow): hold the beak by hand — thumb dimple, strap loops, printed pivot plug; drop handle/trigger/phone; per-piece STLs + parts.json explode view (voice-805d4970)
2026-10-14 pebble: voice-427220cb combine Generalist + crow grippers (codex/gpt-6-astra, promoted)
2026-10-14 Add unified demo gripper with four interchangeable jaws
2026-10-14 Reply with unified gripper renders and validation
2026-10-14 chore: give voice-427220cb to human (agent → human)
2026-10-16 feat(demo_gripper): slim jaws and hub, remove gripper camera, record mirror-a-human vision principle (voice-a9595f6b)
2026-10-16 chore: give voice-a9595f6b to human (agent → human)
2026-10-16 feat(demo_gripper): gen_01 fin-ray TPU fingers, numbered generations, app lineup with labels (voice-a9595f6b)
2026-10-16 chore: give voice-b797bcf2 to human (agent → human)
2026-10-16 plan: agent-led robot research loop, scoreboard first (voice-8e72ea27)
2026-10-16 chore: give voice-8e72ea27 to human (agent → human)
2026-10-16 chore: give voice-feeaa556 to human (agent → human)
2026-10-16 Vendor Aero Hand Open firmware/SDK and add board bring-up tools
    Upstream chestnut-robotics/aero-hand-open @ 7bb2f23 (firmware/ + sdk/), plus a
    read-only PlatformIO bus diagnostic, probe scripts, and a README with the
    2026-10-16 flash/test log.
2026-10-16 aero_hand: bring-up round 2, servo answers, all joints good
2026-10-16 aero_hand: all seven servo IDs set
2026-10-16 aero_hand bus_diag: always list every servo ID on the bus
2026-10-16 guide3d: Aero Hand step 32 in 3D from the official URDF parts, cable animated
2026-10-17 aero_hand: save assembly guide viewer, animations and diagrams from the build session
2026-10-17 aero_hand: build-guide gallery in Helping Hands with assembly PDF button
    Workshop gets an Aero Hand build guide card: a WKWebView gallery of every
    build-session animation/diagram by guide page, a swipeable page viewer for
    all 50 pages, and an Open assembly PDF button. Scripts/stage_aero_guide.py
    bundles the guide folder (pages shrunk to 1600px) as AeroGuide/, served over
    an aeroguide:// scheme so the 3D pages can load their meshes. Track the
    guide's STL meshes (repo ignores *.stl) and point guide_server.py at its
    own folder.
2026-10-17 chore: give voice-35ae8ced to human (agent → human)
2026-10-17 aero_hand: left-hand homing script (plays the first-move song)
2026-10-17 aero_hand: start the song before homing
2026-10-17 aero_hand: performance tolerates brief USB write stalls
2026-10-17 aero_hand: pose.py moves the hand straight to a named pose (peace, rock on, shaka…)
2026-10-17 chore: give voice-64190a2f to human (agent → human)
2026-10-17 aero_hand: webcam teleop — the hand copies your hand live (MediaPipe, no ROS)
2026-10-17 chore: give voice-9172d40a to human (agent → human)
2026-10-17 aero_hand: love pose — fingers in a line, thumb fully in
2026-10-17 chore: give voice-bf54e709 to human (agent → human)
2026-10-17 aero_hand: every script caps servos at 50% speed by default (AERO_SPEED_PCT to override)
2026-10-17 aero_hand: Helping Hands Mac app gets an Aero Hand window — every command a button, plus helpinghands://aero URLs and app.sh
2026-10-17 chore: give voice-7fc650e9 to human (agent → human)
2026-10-17 feat(aero): rock-paper-scissors on camera, random throw committed first (voice-71df05d2)
2026-10-17 chore: give voice-71df05d2 to human (agent → human)
2026-10-17 feat(aero): Aero Hand window readable from four feet — big type and buttons, fills the screen, Stop pinned (voice-7fc650e9)
2026-10-17 Aero Hand: Performance is two big buttons, Test and Dance
2026-10-17 aero_hand: dance choreography comes from the song (moves picked per bar from loudness, kicks, hats, brightness; fingers follow their bands)
2026-10-17 aero_hand: grip --tight for tools (full torque, thumb wrapped)
2026-10-17 aero_hand: relax command (zero torque on all servos)
2026-10-17 aero_hand: bus_diag reads every servo's EEPROM limits (all report maxTemp 80 C)
2026-10-17 aero_hand: note holding-current baseline
2026-10-17 chore: give voice-aeeaba2f to human (agent → human)
2026-10-17 Aero Hand: low-power pose holding + holding-power benchmark (voice-b66b39a9)
    Hold where each servo settled and step its torque limit down to 1.5x the lowest
    that holds; next move re-engages at 700. Fist hold 12124 -> 3068 mA, peace
    8877 -> 2212, can grip 5938 -> 1798; ring/pinky no longer heat up.
2026-10-17 chore: give voice-b66b39a9 to human (agent → human)
2026-10-17 plans: Aero Hand glove teaching (transparent torque mode)
2026-10-17 aero_hand: transparent-mode bench test (index and middle follow both ways at torque 50)
2026-10-17 aero_hand: test and dance play only from the 没有歌词 (no lyrics) playlist
2026-10-17 aero_hand: teach.py record/replay (transparent mode at 100 Hz) + Record and Replay last buttons (voice-563b984c)
2026-10-17 chore: give voice-563b984c to human (agent → human)
2026-10-17 feat(aero): center the Aero Hand tab on teaching — big Record, recordings list (play/rename/delete), other commands in one menu
2026-10-17 chore: give voice-b3454864 to human (agent → human)
2026-10-17 feat(cad): glove hand step 1, photo->outline extractor + TPU fit tray (voice-0c526dc0)
2026-10-17 chore: give voice-0c526dc0 to human (agent → human)
2026-10-17 glove_hand: outline from Jake's tape-measure photo, perspective-corrected (voice-0c526dc0)
    --tape mode: fits a pitched pinhole camera to the tape's mm-tick spacing,
    segments skin by colour, re-projects onto the bench plane, cuts the wrist
    perpendicular to the forearm. hand_outline.scad is now Jake's left hand.
2026-10-17 feat(cad): web concept vs OpenSCAD STL compare — render_compare, design.sh, live Designs tab + workbench (voice-8fe317cd)
2026-10-17 chore: give voice-8fe317cd to human (agent → human)
2026-10-17 feat(aero): replay motion (key poses) by default + replay full, smoothing/deadband/25 Hz fixes the shake, auto-labelled takes, rename by voice (voice-563b984c)
2026-10-17 glove_hand: left hand, fingers together, top-down with tape
2026-10-17 glove_hand: jake_hand.scad 3D hand model + gen_01 fit-test surround (voice-0c526dc0)
    Hand model (measurements only) and glove (fit params + pose) are independent:
    gen_01 uses <jake_hand.scad> and cuts jake_hand(grow=clearance). Fingers-together
    photo traced (--skin rg, --out added to outline_from_photo.py); fit_check.py
    overlays the model on it (85%). Thicknesses are guesses until the side photo.
2026-10-17 aero_hand: speed limit retries while the board is busy homing
2026-10-17 aero_hand: camera contact sheet of a replay-motion run
2026-10-17 glove_hand gen_02: tendon exoskeleton robot hand, designed from scratch (voice-55a7493e)
    Saddles pinned coaxial with Jake's PIP/DIP, one cord loop per digit below
    the joint axes, web posts carry the cords under the MCP, seven-servo
    forearm deck in the Aero Hand order. REFERENCES.md records ideas studied
    (no geometry copied). jake_hand.scad gains a read-only jake(key) accessor.
2026-10-17 chore: give voice-55a7493e to human (agent → human)
2026-10-17 glove_hand gen_03: single index finger mechanism, interactive JS model, interference checker (voice-55a7493e)
2026-10-17 glove hand gen_04: printable index finger (clevis hinges, MCP stop, drum lock), checks, print package (voice-55a7493e)
2026-10-18 Show hand recording and camera history on each take
2026-10-18 feat(gripper): Gen 6 — gears and servo moved above the hand, Generalist honeycomb fingers (voice-650be16a)
2026-10-18 chore: give voice-650be16a to human (agent → human)
2026-10-18 feat(designs): hide/show gallery generations by voice — design_visibility.py (voice-ea551cd1)
2026-10-18 chore: give voice-ea551cd1 to human (agent → human)
2026-10-18 Add Generalist gripper reference photo for Gen 6
2026-10-18 Add Generalist gripper side reference photo for Gen 6
2026-10-18 Add Generalist gripper closed-jaw reference photo for Gen 6
2026-10-18 Add Generalist gripper cup-grasp reference photo for Gen 6
2026-10-18 Add Generalist robot-mounted gripper reference photo for Gen 6
2026-10-18 feat(gripper): Gen 6 fingers match Generalist target — crescent, scalloped edge, small perforations (voice-650be16a)
2026-10-18 Add Generalist gripper top-down reference photo for Gen 6
2026-10-18 Add Generalist gripper camera close-up reference photo for Gen 6
2026-10-18 Add Generalist two-handed gripper reference photo for Gen 6
2026-10-18 feat(gripper): Gen 6 fingers as Generalist hooks — knee hump, serrated jaw, tip-only closure, black strap carriers (voice-650be16a)
2026-10-18 feat(gallery): open/close slider hinges + closure check for every gripper gen (voice-b7ae5fc0)
    poses.js holds each generation's jaw hinges (pivot, exported angle, range),
    read by the mobile gallery's Closed/Open slider and by
    Scripts/check_gripper_closure.py, which swings the published meshes shut and
    measures the inner-face gap along the finger.
2026-10-18 chore: give voice-b7ae5fc0 to human (agent → human)
2026-10-18 feat(gripper): Gen 7 = the two Generalist yellow fingers only, traced from the two-hands photo (voice-5e5e0497)
2026-10-18 chore: give voice-5e5e0497 to human (agent → human)
2026-10-18 feat(gripper): Gen 8 = Pollen's Grabette assembled from its URDF, with exploded view (voice-933444c1)
2026-10-18 chore: give voice-933444c1 to human (agent → human)
2026-10-18 plans(handheld): 2026-only sweep — build on Grabette (Apache-2.0), compare YUBI/UMI-3D/HiFi-UMI/PolyUMI (voice-e93cef1f)
2026-10-18 chore: give voice-e93cef1f to human (agent → human)
2026-10-18 feat(gripper): Gen 8 adds Pollen's Gripette beside Grabette, drive parts highlighted (voice-933444c1)
2026-10-18 feat(gripper): Gen 7 fingers traced by colour, through-holes, wedge blade; 3 build-review rounds + photo compare page (voice-5e5e0497)
2026-10-18 feat(gripper): Gen 7 jaw ridges on the inner gripping edge; fix gallery publish failure (voice-5e5e0497)
    A quoted "/" in a gripper.scad comment made publish_designs.py treat it as a
    mesh directory and walk the whole filesystem, so Gen 7 failed to export.
2026-10-18 docs(gripper): Gen 7 ridge count is 10
2026-10-18 chore(gripper): Gen 7 jaw ridge close-up render
2026-10-18 feat(gripper): Gen 9 yellow fingers built by Sonnet 5.5, needle tip, fine ridges; 3 build-review rounds (voice-31ca3e68)
2026-10-18 chore: give voice-31ca3e68 to human (agent → human)
2026-10-18 feat(gripper): Gen 10 yellow fingers built by Opus 5.5 — centred needle point, beak taper, face-only ridges; 3 build-review rounds (voice-b15ea7bb)
2026-10-18 chore: give voice-b15ea7bb to human (agent → human)
2026-10-18 fix(gallery): open/close hinges for Gens 9-10, correct Gen 7 pivot, test that poses.js matches every gripper (voice-b7ae5fc0)
2026-10-19 feat(gripper): Gen 11 yellow fingers built by Opus 5.5 — full-width shallow grooves along the whole jaw face, skinnier printable needle tip; 3 build-review rounds (voice-6663a540)
2026-10-19 chore: give voice-6663a540 to human (agent → human)
2026-10-19 feat(gripper): Gen 11 r4 — grooves on the jaw only, Gen 10's fuller beak back (voice-6663a540)
2026-10-19 feat(gripper): Gen 11b — Astra pass on Gen 11: chisel beak in plan, gallery pose (voice-72fa2b1a)
2026-10-19 chore: give voice-72fa2b1a to human (agent → human)
2026-10-19 chore: give voice-80e52a21 to human (agent → human)
2026-10-19 feat(gripper): Gen 12 — tweezer version of the Generalist fingers: slender tines, flat tips that meet, grooves near the tip only (voice-438af2a9)
2026-10-19 chore: give voice-438af2a9 to human (agent → human)
2026-10-19 feat(gripper): Gen 13 — designed closed from the closed photo: points touch only at the tip, jaw backs off along the photo's measured gap, serration the whole inner edge (voice-decf86cd)
2026-10-19 chore: give voice-decf86cd to human (agent → human)
2026-10-19 feat(gripper): Gen 14 — refinement of Gen 13: only the points touch (8° V behind the point, gap levels off at 0.35 mm then follows the photo), sharper 0.3 mm point, dark 2.5 mm tip pad from the photo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
2026-10-19 feat(gripper): Gen 14 files — v014_generalist_tip_contact (voice-fe67959c)
2026-10-19 chore: give voice-fe67959c to human (agent → human)
2026-10-19 feat(gripper): Gen 15 — printable handheld: Gen 14 fingers (2.0 mm tip, 0.8 mm walls, M3 carrier holes, pad merged) + thumb/index carriers, pivot plate, hand frame, Insta360 X4/X5 camera mount, strap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
2026-10-19 chore: give voice-492e118c to human (agent → human)
2026-10-19 feat(gripper): Gen 16 — simple handheld: Gen 15 fingers fused to flat thumb/index side pads (one strap slot each) + one pivot plate with Insta360 X4/X5 cradle; 3 printed parts, no wrist attachment; B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
2026-10-19 chore: give voice-258bb62c to human (agent → human)
2026-10-19 Add design publishing scripts, workbench updates, and gripper/ORCA/glove CAD work
2026-10-19 feat: Gen 15 long-jaw gripper replaces old printable Gen 15 (voice-8673a6b6)
    Delete v015_generalist_printable; new v015_generalist_long_jaw is Gen 14 with
    the beak past the black dot 1.7x longer (dot->point = 1/3 of the finger).
    Gallery id + poses updated; v016 untouched apart from a README note.
2026-10-19 chore: give voice-8673a6b6 to human (agent → human)
2026-10-19 feat(gripper): Gen 16 rounded point (Gen 15 + Gen 9); old Gen 16 renumbered Gen 17 (voice-1fc7e062)
    New Gen 16: Gen 15's length and point-only contact, inner-edge knobs rounded to 1 mm
    swells, Gen 9's smoothed outline, J-hook, blade-root S-curve and 0.5 mm eased point, no
    dark tip pad. Three.js concept + render_compare sheet; designs.py discovers version
    folders with web/concept.js.
2026-10-19 chore: give voice-1fc7e062 to human (agent → human)
2026-10-19 docs: README with end-state architecture — agent harness over world action model (voice-105178b9)
2026-10-19 chore: give voice-105178b9 to human (agent → human)
2026-10-19 chore: give voice-50a87f8c to human (agent → human)
2026-10-19 chore: give voice-c7c6c5dc to human (agent → human)
2026-10-19 docs: mark Generalist closed photo as the key finger reference image
2026-10-19 feat(gripper): Gen 16 r2 rounder knobs, 30 deg V, thick rounded tip (voice-1fc7e062)
2026-10-19 feat(gripper): Gen 16 r3 triangle closure, straight outer edge, smooth dot joins (voice-1fc7e062)
2026-10-19 fix(gallery): serve declared gripper parts despite mtime order, dedupe version-folder ids (voice-caae8e01)
2026-10-19 chore: give voice-caae8e01 to human (agent → human)
2026-10-19 Add AGENTS.md: gripper changes always make a new generation
2026-10-19 AGENTS.md: 1.x gripper-only / 2.x gripper-plus-handles versioning
2026-10-19 feat(gripper): Gen 17 strap slide — full-thickness fingers + black dovetail strap slides (voice-cfdf2d31)
    Replaces the old Gen 17 (v017_generalist_simple). Gen 16's fingers at a constant
    12 mm thickness to the point, a yellow dovetail lug on each finger's outer edge, and a
    black flat strap slide with two loop slots. Each part its own module and STL; web
    concept + render_compare sheet.
2026-10-19 chore: give voice-cfdf2d31 to human (agent → human)
2026-10-19 feat(gripper): version 2.1 strap loops — 1.17 fingers + black strap slides (voice-4c63021e)
    New v201_generalist_strap_loops (2.1 = gripper plus handles): 1.17's full-thickness
    fingers, a dovetail lug per finger and a black flat strap slide with two loop slots.
    Each part its own module + STL; exports, checks and render_compare regenerated.
2026-10-19 chore: give voice-4c63021e to human (agent → human)
2026-10-19 feat(gallery): mix-and-match gripper × handles tile, opens on 2.1 (voice-bbe0e945)
2026-10-19 chore: give voice-bbe0e945 to human (agent → human)
2026-10-19 feat(gripper): version 2.2 flush loops — strap slide plates turned 90° flush to the finger's outer side (voice-f7f729ac)
    New v202_generalist_flush_loops: 2.1 with each black strap slide's plate standing
    against the lug's outer face, parallel to the finger's outer edge, instead of running
    33 mm outboard. Fingers, lug and dovetail unchanged; all checks pass. Registered in
    publish_designs.py, poses.js and VERSIONS.txt.
2026-10-19 chore: give voice-f7f729ac to human (agent → human)
2026-10-19 feat(gripper): version 1.18 flat-bottom taper — fingers taper to 2.4 mm at the point from the dorsal face only, ventral face flat for printing (voice-07e1e6a1)
    New v018_generalist_flat_taper: 1.17's fingers with Gen 16 r2's dot-to-point parabola
    applied to one face only (flat_taper), gripper only (no lug or strap slide). All checks
    pass, incl. a new flat-bottom + taper check. Registered in publish_designs.py, poses.js
    and VERSIONS.txt.
2026-10-19 chore: give voice-07e1e6a1 to human (agent → human)
2026-10-19 feat(gripper): version 2.3 tongue pocket — 2.2's handles with no lug; a long narrow tongue slides down into a keyhole pocket in each finger's outer edge, foot behind the base hook (voice-1557d48f)
2026-10-19 chore: give voice-1557d48f to human (agent → human)
2026-10-19 feat(gripper): version 1.19 wide beak — 1.18 with the outer edge past the black dot leaning 15° out and bowed, 11.4 mm wide halfway to the point (was 5.9), same point and contact (voice-13bdab11)
2026-10-19 chore: give voice-13bdab11 to human (agent → human)
2026-10-19 feat(gripper): version 2.4 parametric — every gripper and handle dimension a named, documented parameter in one params.json (byte-identical to 2.3 at its values), plus a Tune panel in the live previe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
2026-10-19 chore: give voice-3211a12d to human (agent → human)
2026-10-19 feat(gripper): 1.20 double hook — top hook mirrors the base J-hook, handle blank held between them (voice-483f28b9)
2026-10-19 chore: give voice-483f28b9 to human (agent → human)
2026-10-19 feat(gripper): 2.5 spanning handle — 2.4 params on 1.20 double-hook fingers; each handle spans base to top hook (41.8 mm), slides in across the finger, stop strip (voice-56f9d73f)
2026-10-19 chore: give voice-56f9d73f to human (agent → human)
2026-10-19 feat: gripper 1.21 + handles 2.6, single top step and longer handle (voice-72840084)
2026-10-19 chore: give voice-72840084 to human (agent → human)
2026-10-19 File pebble voice-5b59d3bf: gripper 3.x base/drive assembly; add 3.x line to AGENTS.md
2026-10-19 Record B601-RS motor map: gripper is RobStride RS00
2026-10-19 feat: gripper 3.1, base and drive with RobStride RS00 motor mount (voice-5b59d3bf)
    First 3.x version: 2.6's fingers and handles plus an arm under each handle,
    a shared hex-boss handle-base interface, two meshing involute gear sectors,
    a base plate and the RS00 motor underneath. 52 new params, ten part STLs.
2026-10-19 chore: give voice-5b59d3bf to human (agent → human)
2026-10-19 Live preview mix-and-match: fingers from later designs (1.21) and a 3.x Base picker (voice-bbe0e945)
2026-10-19 feat: gripper 3.2, simplified drive: gear+cup drivers, strap slots kept clear, smaller handle (voice-e3cd53d6)
2026-10-19 chore: give voice-e3cd53d6 to human (agent → human)
2026-10-19 feat: gripper 3.3, in-plane drive: 15 mm handle with strap tunnel, tail wrapped round the base hook into a keyed gear cradle, side gears in the finger plane, centred RS00 pinion (voice-3b311f32)
2026-10-19 chore: give voice-3b311f32 to human (agent → human)
2026-10-19 AGENTS.md: per-part version names (Gripper N / Handle N / Base N) with old-to-new mapping
2026-10-19 Live preview: animate Explode/Assemble (parts fly apart/together, camera glides) (voice-3147fea8)
2026-10-19 chore: give voice-3147fea8 to human (agent → human)
2026-10-19 Live preview + catalog: Gripper N / Handle N / Base N names replace 1.x/2.x/3.x and Gen N (voice-bed52066)
2026-10-19 chore: give voice-bed52066 to human (agent → human)
2026-10-19 feat: Handle 7, handle cut to the finger's 12 mm height with a strap tunnel (voice-448df859)
2026-10-19 chore: give voice-448df859 to human (agent → human)
2026-10-19 feat: Base 4, handle and side gear one print, 3+3 motor bolts: 13 pieces (Base 3: 21) (voice-b7260e73)
2026-10-19 chore: give voice-b7260e73 to human (agent → human)
2026-10-19 feat: Base 5 single-gear drive (voice-01ab1486)
    One pinion on the RS00 between two opposed racks; each rack is one print
    with its handle; fingers slide (parallel gripper). 12 pieces (Base 4: 13).
    Gallery slides in poses.js, mix follows a sliding Base, pose test covers slides.
2026-10-19 chore: give voice-01ab1486 to human (agent → human)
2026-10-20 chore: give voice-0973c464 to human (agent → human)
2026-10-20 Live preview: one-tap Open/Close toggle that swings the fingers smoothly, replacing the openness slider (voice-3147fea8)
2026-10-20 feat: Base 7, Base 4 made printable without supports (voice-fef42307)
    Every printed part is a flat-bottomed extrusion: handle-gear outline full height from the web's
    underside, pivot posts on the base instead of axles, full hub disc, countersunk M3 on 45 deg cones.
    exports/print lie on the bed in print orientation; check_geometry.py fails any face past 45 deg.
2026-10-20 chore: give voice-fef42307 to human (agent → human)
2026-10-20 feat: Base 8 handle-gear with two strap-loop slots, no separate Handle (voice-1f4d3de1)
2026-10-20 chore: give voice-1f4d3de1 to human (agent → human)
2026-10-20 pebble voice-3cd78d20: expand scope (arm CAD import + quick-change mount for gripper and Aero Hand)
2026-10-20 feat: Base 9 top plate: C rings hold each handle-gear's axle top end, pillars on the base (voice-d96cd30d)
2026-10-20 chore: give voice-d96cd30d to human (agent → human)
2026-10-20 feat: Base 10 on the reBot Arm B601-RS: J6 hub + tool plates (Seeed's Connector A/B interface), L bracket for the gripper, Aero Hand plate, arm CAD from Seeed's URDF in the preview (voice-3cd78d20)
2026-10-20 chore: commit the vendored reBot Arm B601-RS meshes (Seeed's source CAD, exempt from the *.stl export rule) (voice-3cd78d20)
2026-10-20 chore: give voice-3cd78d20 to human (agent → human)
2026-10-20 feat: Base 11, motor choice: motor_sts 0 = RS00 (Base 10 exactly), 1 = Feetech STS3215 (SO-101 servo) on its horn and case rails; record_grip.py logs the back-driven servo for data collection (voice-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
2026-10-20 chore: give voice-e82254ec to human (agent → human)
2026-10-20 chore: give voice-2a989d97 to human (agent → human)
2026-10-20 feat: Base 12, compact drive: pivot_spacing drives the pivots (62.7 mm, fingers toed in so the points meet), no centre pillar, 16-tooth pinion off the centreline, STS3215 flush under the base (voice-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
2026-10-20 chore: give voice-98af07a6 to human (agent → human)
2026-10-20 feat: Base 13, the whole left Aero Hand beside the arm: palm + thumb + 4 fingers posed from its URDF (third_party/aero_hand/hand_pose.py), each a separate part, three pose sliders (voice-c0e340c7)
2026-10-20 chore: give voice-c0e340c7 to human (agent → human)
2026-10-20 docs: per-part versions (Arm, Mount, Aero Hand join Gripper/Handle/Base); assemblies are selections, not versions
2026-10-20 feat: per-part pickers for Arm, Mount, Aero Hand with lineage and interface flags (voice-a5d65841)
2026-10-20 chore: give voice-a5d65841 to human (agent → human)
2026-10-20 feat: Aero Hand as its own end effector on the Mount; v313 is Aero Hand 1's assembly, not Base 13 (voice-a5d65841)
2026-10-20 chore: give voice-2308ade1 to human (agent → human)
2026-10-20 feat: Aero Hand is its own design family in the live preview, with an Arm + Mount + Aero Hand mix; v313 is its assembly, not Base 13 (voice-a87f8d20)
2026-10-20 chore: give voice-a87f8d20 to human (agent → human)
2026-10-20 feat: Base 14, Base 12 on the reBot Arm through Mount 1: a wrist tab on the base below the STS3215 and a new wrist bracket clamped under it, Mount 1's tool plate on its foot (voice-4ac7222b)
2026-10-20 chore: give voice-4ac7222b to human (agent → human)
2026-10-20 feat: Arm 2 (SO-101, The Robot Studio CAD) and Mount 2, a hub on its wrist-roll horn that takes Mount 1's tool plate, so Base 14 rides on either arm; preview picks and flags arms per mount (voice-790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
2026-10-20 chore: give voice-790aa455 to human (agent → human)
2026-10-20 feat: live preview landing is the parts list beside the 3D view, Aero Hand out of the Generalist options (voice-1a2680b8)
    The Generalist assembly lists Gripper, Handle, Base, Mount, Arm, each row at its version with a selector; model.js builds the
    assembly without DOM or three.js and follows (Mount to the arm, Handle to the fingers) or flags the parts a change affects.
    The header, Hide dialog, view presets, in-tile pickers and the photo tile are gone. Scripts/test_gallery.py checks the rows
    under Node and renders the landing in headless Chrome through serve_designs.py.
2026-10-20 chore: give voice-1a2680b8 to human (agent → human)
2026-10-20 feat(preview): remove Only buttons and follow-note checkmarks (voice-b1dacbad)
2026-10-20 chore: give voice-b1dacbad to human (agent → human)
2026-10-20 chore: give voice-c68a1812 to human (agent → human)
2026-10-21 feat(preview): toggleable average human hand with bendable fingers (voice-bf770cd7)
    WebXR Input Profiles generic hand (MIT), scaled to the ANSUR II mean hand length,
    beside or over the gripper, per-finger bend sliders, Open/Close, and Follow the gripper.
2026-10-21 chore: give voice-bf770cd7 to human (agent → human)
2026-10-21 feat(preview): human hand "Holding the gripper" pose, solved onto the handles (voice-bf770cd7)
2026-10-21 feat: Base 15, all four posts on the base and the top plate a plain cap (post sockets, 2 M3 into the pillars, no C rings); Gripper 22, a loop round the pivot post in place of the base J-hook so the p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
2026-10-21 chore: give voice-453c20d7 to human (agent → human)
2026-10-21 docs(plans): YUBI vs UMI-family grippers — most data and smallest (voice-7b719c5b)
2026-10-21 chore: give voice-7b719c5b to human (agent → human)
2026-10-22 docs(voice-7b719c5b): add Aug–Oct 2026 UMI-family releases (YUBI full 17.8k h, TacUMI, Daimon, Tencent)
2026-10-22 docs(voice-fc9b0f77): plan for a gripper-bootstrapped two-armed cooking robot
2026-10-22 chore: give voice-fc9b0f77 to human (agent → human)
2026-10-22 plan: cooking robot materials — print by default (voice-fc9b0f77)
2026-10-22 chore: park voice-fc9b0f77 in queue (agent → queue) — Jake still adding to the plan
2026-10-22 chore: keep voice-fc9b0f77 parked in queue — Jake still adding to the plan
2026-10-22 chore: move voice-fc9b0f77 to agent (queue → agent) — Jake's call
2026-10-22 chore: give voice-ef1a0591 to human (agent → human)
2026-10-23 feat: add servo-width miniature geared tweezer prototype
2026-10-23 chore: give voice-dd73161d to human (agent → human)
2026-10-23 Request faithful scaled large-gripper Tiny V2
2026-10-23 feat: add compact Tiny V2 with real servo mounting and resized gears
2026-10-23 chore: give voice-44e6c4d2 to human (agent → human)
2026-10-23 chore: give voice-d01680be to human (agent → human)
2026-10-23 Add Base 19 overhead geared drive for SO-101
2026-10-23 Reply on voice-550038ca with CAD comparison and validation
2026-10-23 chore: give voice-550038ca to human (agent → human)
2026-10-23 Add fixed-wrist thumb/index fit screening and attachment proposal
2026-10-23 chore: give voice-3f6ae8e1 to human (agent → human)
2026-10-23 feat: add compact overhead direct-tweezer Base 20 and Gripper 25
2026-10-23 fix: study direct outer-finger human contact
2026-10-23 Complete voice-550038ca review attachments
2026-10-23 Screen complete posed hand skin and animate unused digits through gripper stroke
2026-10-23 docs: research rare-earth-free QDD actuators and manufacturing
2026-10-23 chore: give voice-401a89c5 to human (agent → human)
2026-10-23 design: center Base 22 drive and integrate Gripper 26 sectors
2026-10-23 design: close Gripper 27 tips and verify Base 23 servo attachment
2026-10-23 chore: reply on voice-550038ca closure and servo feedback
2026-10-23 Restore original gripper tips with wider pivots in Base 24 and Gripper 28
2026-10-23 feat: shrink overhead gear train with independent upper sectors
2026-10-23 chore: reply with smaller drive CAD and verification evidence
2026-10-23 Add sourced surgical micro-gripper gallery and separate fine-motion proposal
2026-10-23 chore: give voice-ef49247b to human (agent → human)
2026-10-23 Compare HLS and SO-101 motor interfaces with measured exploded views
2026-10-24 Create Base 26 and Gripper 30 for support-free FDM
2026-10-24 Reply with support-free FDM design and print plate on voice-550038ca
2026-10-24 Simplify overhead gripper to five support-free printed pieces
2026-10-24 Reply on voice-550038ca with five-piece CAD and print evidence
